toasterllc/MDCCode/Other/img-1600.jpg

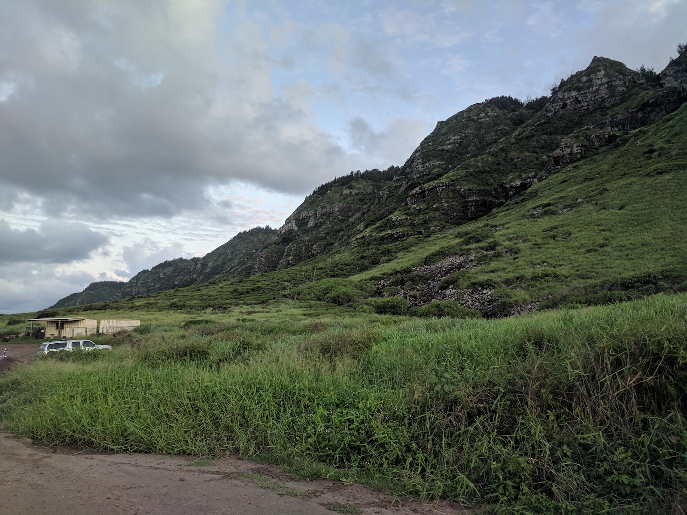
Other/img-1600.jpg
