toasterllc/MDCCode/Other/SDCardResearch/SDCard-LVSInitialization.png

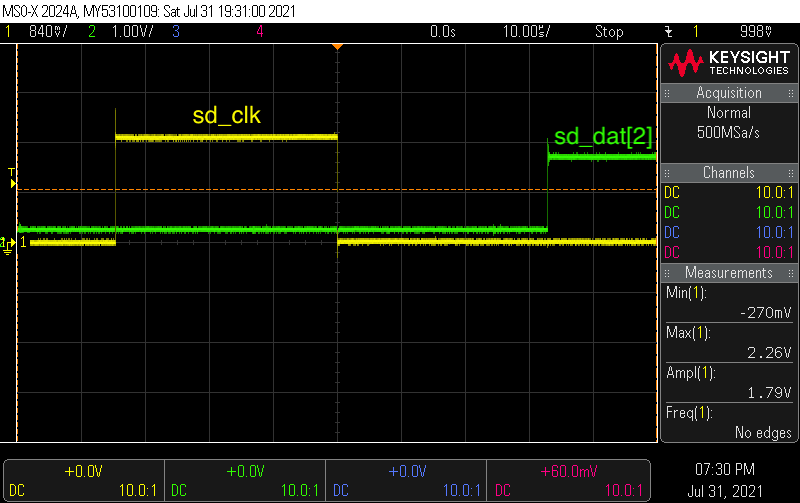
Other/SDCardResearch/SDCard-LVSInitialization.png
