toasterllc/MDCCode/Tools/MDCStudio/Resources/ImageGrid-ImagePlaceholder.png

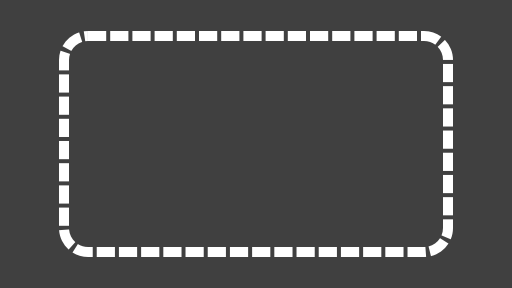
Tools/MDCStudio/Resources/ImageGrid-ImagePlaceholder.png
