toasterllc/MDCCode/Tools/MDCStudio/Resources/ShadowUnselected.png

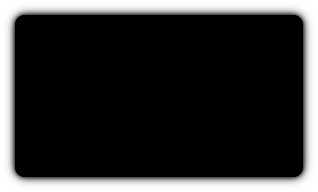
Tools/MDCStudio/Resources/ShadowUnselected.png
