toasterllc/MDCCode/(list of files, cad)

Other CAD files:
Enclosure/Enclosure.f3d
