toasterllc/MDCCode/Tools/Python/numpy/core/tests/data/umath-validation-set-arccos.csv

dtype | input | output | ulperrortol
np.float32 | 0xbddd7f50 | 0x3fd6eec2 | 3
np.float32 | 0xbe32a20c | 0x3fdf8182 | 3
np.float32 | 0xbf607c09 | 0x4028f84f | 3
np.float32 | 0x3f25d906 | 0x3f5db544 | 3
np.float32 | 0x3f01cec8 | 0x3f84febf | 3
np.float32 | 0x3f1d5c6e | 0x3f68a735 | 3
np.float32 | 0xbf0cab89 | 0x4009c36d | 3
np.float32 | 0xbf176b40 | 0x400d0941 | 3
np.float32 | 0x3f3248b2 | 0x3f4ce6d4 | 3
np.float32 | 0x3f390b48 | 0x3f434e0d | 3
np.float32 | 0xbe261698 | 0x3fddea43 | 3
np.float32 | 0x3f0e1154 | 0x3f7b848b | 3
np.float32 | 0xbf379a3c | 0x4017b764 | 3
np.float32 | 0xbeda6f2c | 0x4000bd62 | 3
np.float32 | 0xbf6a0c3f | 0x402e5d5a | 3
np.float32 | 0x3ef1d700 | 0x3f8a17b7 | 3
np.float32 | 0xbf6f4f65 | 0x4031d30d | 3
np.float32 | 0x3f2c9eee | 0x3f54adfd | 3
np.float32 | 0x3f3cfb18 | 0x3f3d8a1e | 3
np.float32 | 0x3ba80800 | 0x3fc867d2 | 3
np.float32 | 0x3e723b08 | 0x3faa7e4d | 3
np.float32 | 0xbf65820f | 0x402bb054 | 3
np.float32 | 0xbee64e7a | 0x40026410 | 3
np.float32 | 0x3cb15140 | 0x3fc64a87 | 3
np.float32 | 0x3f193660 | 0x3f6ddf2a | 3
np.float32 | 0xbf0e5b52 | 0x400a44f7 | 3
np.float32 | 0x3ed55f14 | 0x3f920a4b | 3
np.float32 | 0x3dd11a80 | 0x3fbbf85c | 3
np.float32 | 0xbf4f5c4b | 0x4020f4f9 | 3
np.float32 | 0x3f787532 | 0x3e792e87 | 3
np.float32 | 0x3f40e6ac | 0x3f37a74f | 3
np.float32 | 0x3f1c1318 | 0x3f6a47b6 | 3
np.float32 | 0xbe3c48d8 | 0x3fe0bb70 | 3
np.float32 | 0xbe94d4bc | 0x3feed08e | 3
np.float32 | 0xbe5c3688 | 0x3fe4ce26 | 3
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
np.float64 | 0x3fcea8a1b93d5140 | 0x3ff543456c0d28c7 | 2
np.float64 | 0xfff0000000000000 | 0x7ff8000000000000 | 2
np.float64 | 0xbfd9d5da72b3abb4 | 0x3fffc8013113f968 | 2
np.float64 | 0xbfe1fdfcea63fbfa | 0x400157def2e4808d | 2
np.float64 | 0xbfc0022e0720045c | 0x3ffb239963e7cbf2 | 2
