toasterllc/MDCCode/Tools/Python/numpy/core/tests/data/umath-validation-set-arccosh.csv

dtype | input | output | ulperrortol
np.float32 | 0x3f83203f | 0x3e61d9d6 | 2
np.float32 | 0x3f98dea1 | 0x3f1d1af6 | 2
np.float32 | 0x7fa00000 | 0x7fe00000 | 2
np.float32 | 0x7eba99af | 0x42b0d032 | 2
np.float32 | 0x3fc95a13 | 0x3f833650 | 2
np.float32 | 0x3fce9a45 | 0x3f8771e1 | 2
np.float32 | 0x3fc1bd96 | 0x3f797811 | 2
np.float32 | 0x7eba2391 | 0x42b0ceed | 2
np.float32 | 0x7d4e8f15 | 0x42acdb8c | 2
np.float32 | 0x3feca42e | 0x3f9cc88e | 2
np.float32 | 0x7e2b314e | 0x42af412e | 2
np.float32 | 0x7f7fffff | 0x42b2d4fc | 2
np.float32 | 0x3f803687 | 0x3d6c4380 | 2
np.float32 | 0x3fa0edbd | 0x3f33e706 | 2
np.float32 | 0x3faa8074 | 0x3f4b3d3c | 2
np.float32 | 0x3fa0c49e | 0x3f337af3 | 2
np.float32 | 0x3f8c9ec4 | 0x3ee18812 | 2
np.float32 | 0x7efef78e | 0x42b17006 | 2
np.float32 | 0x3fc75720 | 0x3f818aa4 | 2
np.float32 | 0x7f52d4c8 | 0x42b27198 | 2
np.float32 | 0x3f88f21e | 0x3ebe52b0 | 2
np.float32 | 0x3ff7a042 | 0x3fa3a07a | 2
np.float32 | 0x7f52115c | 0x42b26fbd | 2
np.float32 | 0x3fc6bf6f | 0x3f810b42 | 2
np.float32 | 0x3fd105d0 | 0x3f895649 | 2
np.float32 | 0x3fee7c2a | 0x3f9df66e | 2
np.float32 | 0x7f0ff9a5 | 0x42b1ae4f | 2
np.float32 | 0x7e81f075 | 0x42b016e7 | 2
np.float32 | 0x3fa57d65 | 0x3f3f70c6 | 2
np.float32 | 0x80800000 | 0xffc00000 | 2
np.float32 | 0x7da239f5 | 0x42adc2bf | 2
np.float32 | 0x3f9e432c | 0x3f2cbd80 | 2
np.float32 | 0x3ff2839b | 0x3fa07ee4 | 2
np.float32 | 0x3fec8aef | 0x3f9cb850 | 2
np.float32 | 0x7d325893 | 0x42ac905b | 2
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
np.float64 | 0x3ff2b1335c056267 | 0x3fe25000846b75a2 | 2
np.float64 | 0x7fe0cb8bd8e19717 | 0x40862ea65237d496 | 2
np.float64 | 0x3fff4b1b7b9e9637 | 0x3ff4a83fb08e7b24 | 2
np.float64 | 0x7fe7526140aea4c2 | 0x40863146ae86069c | 2
np.float64 | 0x7fbfcfb7c23f9f6f | 0x4086231fc246ede5 | 2
