toasterllc/MDCCode/Tools/Python/numpy/core/tests/data/umath-validation-set-arcsin.csv

dtype | input | output | ulperrortol
np.float32 | 0xbe7d3a7c | 0xbe7fe217 | 4
np.float32 | 0x3dc102f0 | 0x3dc14c60 | 4
np.float32 | 0xbe119c28 | 0xbe121aef | 4
np.float32 | 0xbe51cd68 | 0xbe534c75 | 4
np.float32 | 0x3c04a300 | 0x3c04a35f | 4
np.float32 | 0xbf4f0b62 | 0xbf712a69 | 4
np.float32 | 0x3ef61a5c | 0x3f005cf6 | 4
np.float32 | 0xbf13024c | 0xbf1c97df | 4
np.float32 | 0x3e93b580 | 0x3e95d6b5 | 4
np.float32 | 0x3e44e7b8 | 0x3e4623a5 | 4
np.float32 | 0xbe35df20 | 0xbe36d773 | 4
np.float32 | 0x3eecd2c0 | 0x3ef633cf | 4
np.float32 | 0x3f2772ba | 0x3f36862a | 4
np.float32 | 0x3e211ea8 | 0x3e21cac5 | 4
np.float32 | 0x3e3b3d90 | 0x3e3c4cc6 | 4
np.float32 | 0x3f37c962 | 0x3f4d018c | 4
np.float32 | 0x3e92ad88 | 0x3e94c31a | 4
np.float32 | 0x3f356ffc | 0x3f49a766 | 4
np.float32 | 0x3f487ba2 | 0x3f665254 | 4
np.float32 | 0x3f061c46 | 0x3f0d27ae | 4
np.float32 | 0xbee340a2 | 0xbeeb7722 | 4
np.float32 | 0xbe85aede | 0xbe874026 | 4
np.float32 | 0x3f34cf9a | 0x3f48c474 | 4
np.float32 | 0x3e29a690 | 0x3e2a6fbd | 4
np.float32 | 0xbeb29428 | 0xbeb669d1 | 4
np.float32 | 0xbe606d40 | 0xbe624370 | 4
np.float32 | 0x3dae6860 | 0x3dae9e85 | 4
np.float32 | 0xbf04872b | 0xbf0b4d25 | 4
np.float32 | 0x3f2080e2 | 0x3f2d7ab0 | 4
np.float32 | 0xbec77dcc | 0xbecceb27 | 4
np.float32 | 0x3e0dda10 | 0x3e0e4f38 | 4
np.float32 | 0xbefaf970 | 0xbf03262c | 4
np.float32 | 0x3f576a0c | 0x3f7ffee6 | 4
np.float32 | 0x3f222382 | 0x3f2f95d6 | 4
np.float32 | 0x7fc00000 | 0x7fc00000 | 4
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
np.float64 | 0x3fd0821b38a10438 | 0x3fd0b26e3e0b9185 | 3
np.float64 | 0x0 | 0x0 | 3
np.float64 | 0x3feb7f70edf6fee2 | 0x3ff08ae81854bf20 | 3
np.float64 | 0x3fe6e075716dc0ea | 0x3fe97cc5254be6ff | 3
np.float64 | 0x3fea13b682f4276e | 0x3fee7b6f18073b5b | 3
