toasterllc/MDCCode/Tools/Python/numpy/core/tests/data/umath-validation-set-arcsinh.csv

dtype | input | output | ulperrortol
np.float32 | 0xbf24142a | 0xbf1a85ef | 2
np.float32 | 0x3e71cf91 | 0x3e6f9e37 | 2
np.float32 | 0xe52a7 | 0xe52a7 | 2
np.float32 | 0x3ef1e074 | 0x3ee9add9 | 2
np.float32 | 0x806160ac | 0x806160ac | 2
np.float32 | 0x7e2d59a2 | 0x42af4798 | 2
np.float32 | 0xbf32cac9 | 0xbf26bf96 | 2
np.float32 | 0x3f081701 | 0x3f026142 | 2
np.float32 | 0x3f23cc88 | 0x3f1a499c | 2
np.float32 | 0xbf090d94 | 0xbf033ad0 | 2
np.float32 | 0x803af2fc | 0x803af2fc | 2
np.float32 | 0x807eb17e | 0x807eb17e | 2
np.float32 | 0x5c0d8e | 0x5c0d8e | 2
np.float32 | 0x3f7b79d2 | 0x3f5e6b1d | 2
np.float32 | 0x806feeae | 0x806feeae | 2
np.float32 | 0x3e4b423a | 0x3e49f274 | 2
np.float32 | 0x3f49e5ac | 0x3f394a41 | 2
np.float32 | 0x3f18cd4e | 0x3f10ef35 | 2
np.float32 | 0xbed75734 | 0xbed17322 | 2
np.float32 | 0x7f591151 | 0x42b28085 | 2
np.float32 | 0xfefe9da6 | 0xc2b16f51 | 2
np.float32 | 0xfeac90fc | 0xc2b0a82a | 2
np.float32 | 0x805c198e | 0x805c198e | 2
np.float32 | 0x7f66d6df | 0x42b2a004 | 2
np.float32 | 0x505438 | 0x505438 | 2
np.float32 | 0xbf39a209 | 0xbf2c5255 | 2
np.float32 | 0x7fa00000 | 0x7fe00000 | 2
np.float32 | 0xc84cb | 0xc84cb | 2
np.float32 | 0x7f07d6f5 | 0x42b19088 | 2
np.float32 | 0x79d7e4 | 0x79d7e4 | 2
np.float32 | 0xff32f6a0 | 0xc2b21db1 | 2
np.float32 | 0x7c005c05 | 0x42a9222e | 2
np.float32 | 0x3ec449aa | 0x3ebfc5ae | 2
np.float32 | 0x800ec323 | 0x800ec323 | 2
np.float32 | 0xff1c904c | 0xc2b1d93a | 2
np.float32 | 0x7f4eca52 | 0x42b267b0 | 2
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
np.float64 | 0x7fe13d2895e27a50 | 0x40862edbbc411899 | 2
np.float64 | 0x3fd54c4280aa9884 | 0x3fd4ec55a946c5d7 | 2
np.float64 | 0xffd75b8e01aeb71c | 0xc0862bbe42d76e5e | 2
np.float64 | 0x7f1d5376fe3ab | 0x7f1d5376fe3ab | 2
np.float64 | 0x3fe6ec6c902dd8d9 | 0x3fe55004f35192bd | 2
np.float64 | 0x5634504aac68b | 0x5634504aac68b | 2
np.float64 | 0x3feedb0d83bdb61b | 0x3feb633467467ce6 | 2
np.float64 | 0x3fddb1c0dcbb6380 | 0x3fdcb87a02daf1fa | 2
np.float64 | 0xbfa832da443065b0 | 0xbfa8308c70257209 | 2
np.float64 | 0x87a9836b0f531 | 0x87a9836b0f531 | 2
