toasterllc/MDCCode/Tools/Python/numpy/core/tests/data/umath-validation-set-arctan.csv

dtype | input | output | ulperrortol
np.float32 | 0x3f338252 | 0x3f1c8d9c | 3
np.float32 | 0x7e569df2 | 0x3fc90fdb | 3
np.float32 | 0xbf347e25 | 0xbf1d361f | 3
np.float32 | 0xbf0a654e | 0xbefdbfd2 | 3
np.float32 | 0x8070968e | 0x8070968e | 3
np.float32 | 0x803cfb27 | 0x803cfb27 | 3
np.float32 | 0x8024362e | 0x8024362e | 3
np.float32 | 0xfd55dca0 | 0xbfc90fdb | 3
np.float32 | 0x592b82 | 0x592b82 | 3
np.float32 | 0x802eb8e1 | 0x802eb8e1 | 3
np.float32 | 0xbc5fef40 | 0xbc5febae | 3
np.float32 | 0x3f1f6ce8 | 0x3f0e967c | 3
np.float32 | 0x20bedc | 0x20bedc | 3
np.float32 | 0xbf058860 | 0xbef629c7 | 3
np.float32 | 0x311504 | 0x311504 | 3
np.float32 | 0xbd23f560 | 0xbd23defa | 3
np.float32 | 0x800ff4e8 | 0x800ff4e8 | 3
np.float32 | 0x355009 | 0x355009 | 3
np.float32 | 0x3f7be42e | 0x3f46fdb3 | 3
np.float32 | 0xbf225f7c | 0xbf10b364 | 3
np.float32 | 0x8074fa9e | 0x8074fa9e | 3
np.float32 | 0xbea4b418 | 0xbe9f59ce | 3
np.float32 | 0xbe909c14 | 0xbe8cf045 | 3
np.float32 | 0x80026bee | 0x80026bee | 3
np.float32 | 0x3d789c20 | 0x3d784e25 | 3
np.float32 | 0x7f56a4ba | 0x3fc90fdb | 3
np.float32 | 0xbf70d141 | 0xbf413db7 | 3
np.float32 | 0xbf2c4886 | 0xbf17a505 | 3
np.float32 | 0x7e2993bf | 0x3fc90fdb | 3
np.float32 | 0xbe2c8a30 | 0xbe2aef28 | 3
np.float32 | 0x803f82d9 | 0x803f82d9 | 3
np.float32 | 0x3f062fbc | 0x3ef730a1 | 3
np.float32 | 0x3f349ee0 | 0x3f1d4bfa | 3
np.float32 | 0x3eccfb69 | 0x3ec2f9e8 | 3
np.float32 | 0x7e8a85dd | 0x3fc90fdb | 3
np.float32 | 0x25331 | 0x25331 | 3
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
np.float32 | 0xfee36132 | 0xbfc90fdb | 3
np.float32 | 0x619ae6 | 0x619ae6 | 3
np.float32 | 0xfde5d670 | 0xbfc90fdb | 3
np.float32 | 0xff079ac5 | 0xbfc90fdb | 3
np.float32 | 0x3e974fbd | 0x3e931fae | 3
np.float32 | 0x8020ae6b | 0x8020ae6b | 3
np.float32 | 0x6b5af1 | 0x6b5af1 | 3
np.float32 | 0xbeb57cd6 | 0xbeae69a3 | 3
np.float32 | 0x806e7eb2 | 0x806e7eb2 | 3
np.float32 | 0x7e666edb | 0x3fc90fdb | 3
np.float32 | 0xbf458c18 | 0xbf283ff0 | 3
np.float32 | 0x3e50518e | 0x3e4d8399 | 3
np.float32 | 0x3e9ce224 | 0x3e983b98 | 3
np.float32 | 0x3e6bc067 | 0x3e67b6c6 | 3
np.float32 | 0x13783d | 0x13783d | 3
np.float32 | 0xff3d518c | 0xbfc90fdb | 3
np.float32 | 0xfeba5968 | 0xbfc90fdb | 3
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
