toasterllc/MDCCode/Tools/ScrollViewTest/ScrollViewTest/ImageView-Shadow@2x.png

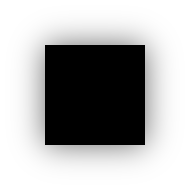
Tools/ScrollViewTest/ScrollViewTest/ImageView-Shadow@2x.png
