toasterllc/MDCCode/Sim/PowerMuxRails-LogicTest/Schematic.asc

C3: cap; 10µ
C4: cap; 10µ
C6: cap; 10µ
C8: cap; 10µ
R3: res; 1m
R4: res; 100
R10: res; 1m
R11: res; 1m
U1: SN74AHC1G32
U3: SN74LVC1G386
V_VDD_BAT: voltage; {VDD_BAT}; Cpar=1f
V_VDD_USB: voltage; PULSE(0 {VDD_USB} 100u 100u 100u 5000u)
V_VDDB_EN_: voltage; {VDDB_EN_}
Named nets: 0, VDD_USB, VDD_BAT, VDDB_EN_, NOBAT
.tran 0 10m
*.options plotwinsize=0 numdgt=15
.param VDD_BAT = 3
.param VDD_USB = 3
*.step param VDD_USB .1 5 .25
.param VDDB_EN_ = 0
