toasterllc/MDCCode/Sim/PowerMuxRails-New6/Schematic.asc

C1: cap; 10µ
C2: cap; 10µ
C3: cap; 10µ
C4: cap; 10µ
C5: cap; 10µ
C6: cap; 10µ
C7: cap; 10µ
D1: schottky; MBR0520L
Q1: pmos; FDS6375
Q2: pmos; FDS6375
Q3: pmos; FDS6375
Q10: pmos; FDS6375
R1: res; 100
R2: res; 1k
R3: res; 1m
R4: res; 10Meg
R5: res; 100k
R6: res; 1m
R7: res; 100k
R8: res; 1k
R10: res; 1m
R11: res; 1m
R19: res; 100
V_VDD_AUX: voltage; 2.5
V_VDD_BAT: voltage; 3; Cpar=1f
V_VDD_USB: voltage; 5
V_VDDB_EN_: voltage; 3
Named nets: 0, VDD_USB, VDD_1V8, VDD_BAT, VDD_SRC_USB, VDDB, VDDA, VDDB_EN_
.tran 0 10n 0 1p
*.param VDD_BAT = -3
*.param VDD_USB = 5
*.step param VDD_USB 2 3 .1
*.options plotwinsize=0 numdgt=15
Reverse polarity protection and
reverse current protection
VDD driver
VDD driver
TPS22916CN model is apparently incorrect when VIN < ~0.5
In this case, a large current can flow from VOUT -> VIN.
