toasterllc/MDCCode/PCB/MotionDetectorCamera.brd

## EAGLE design PCB/MotionDetectorCamera.brd (2022-09-28, last stored version)

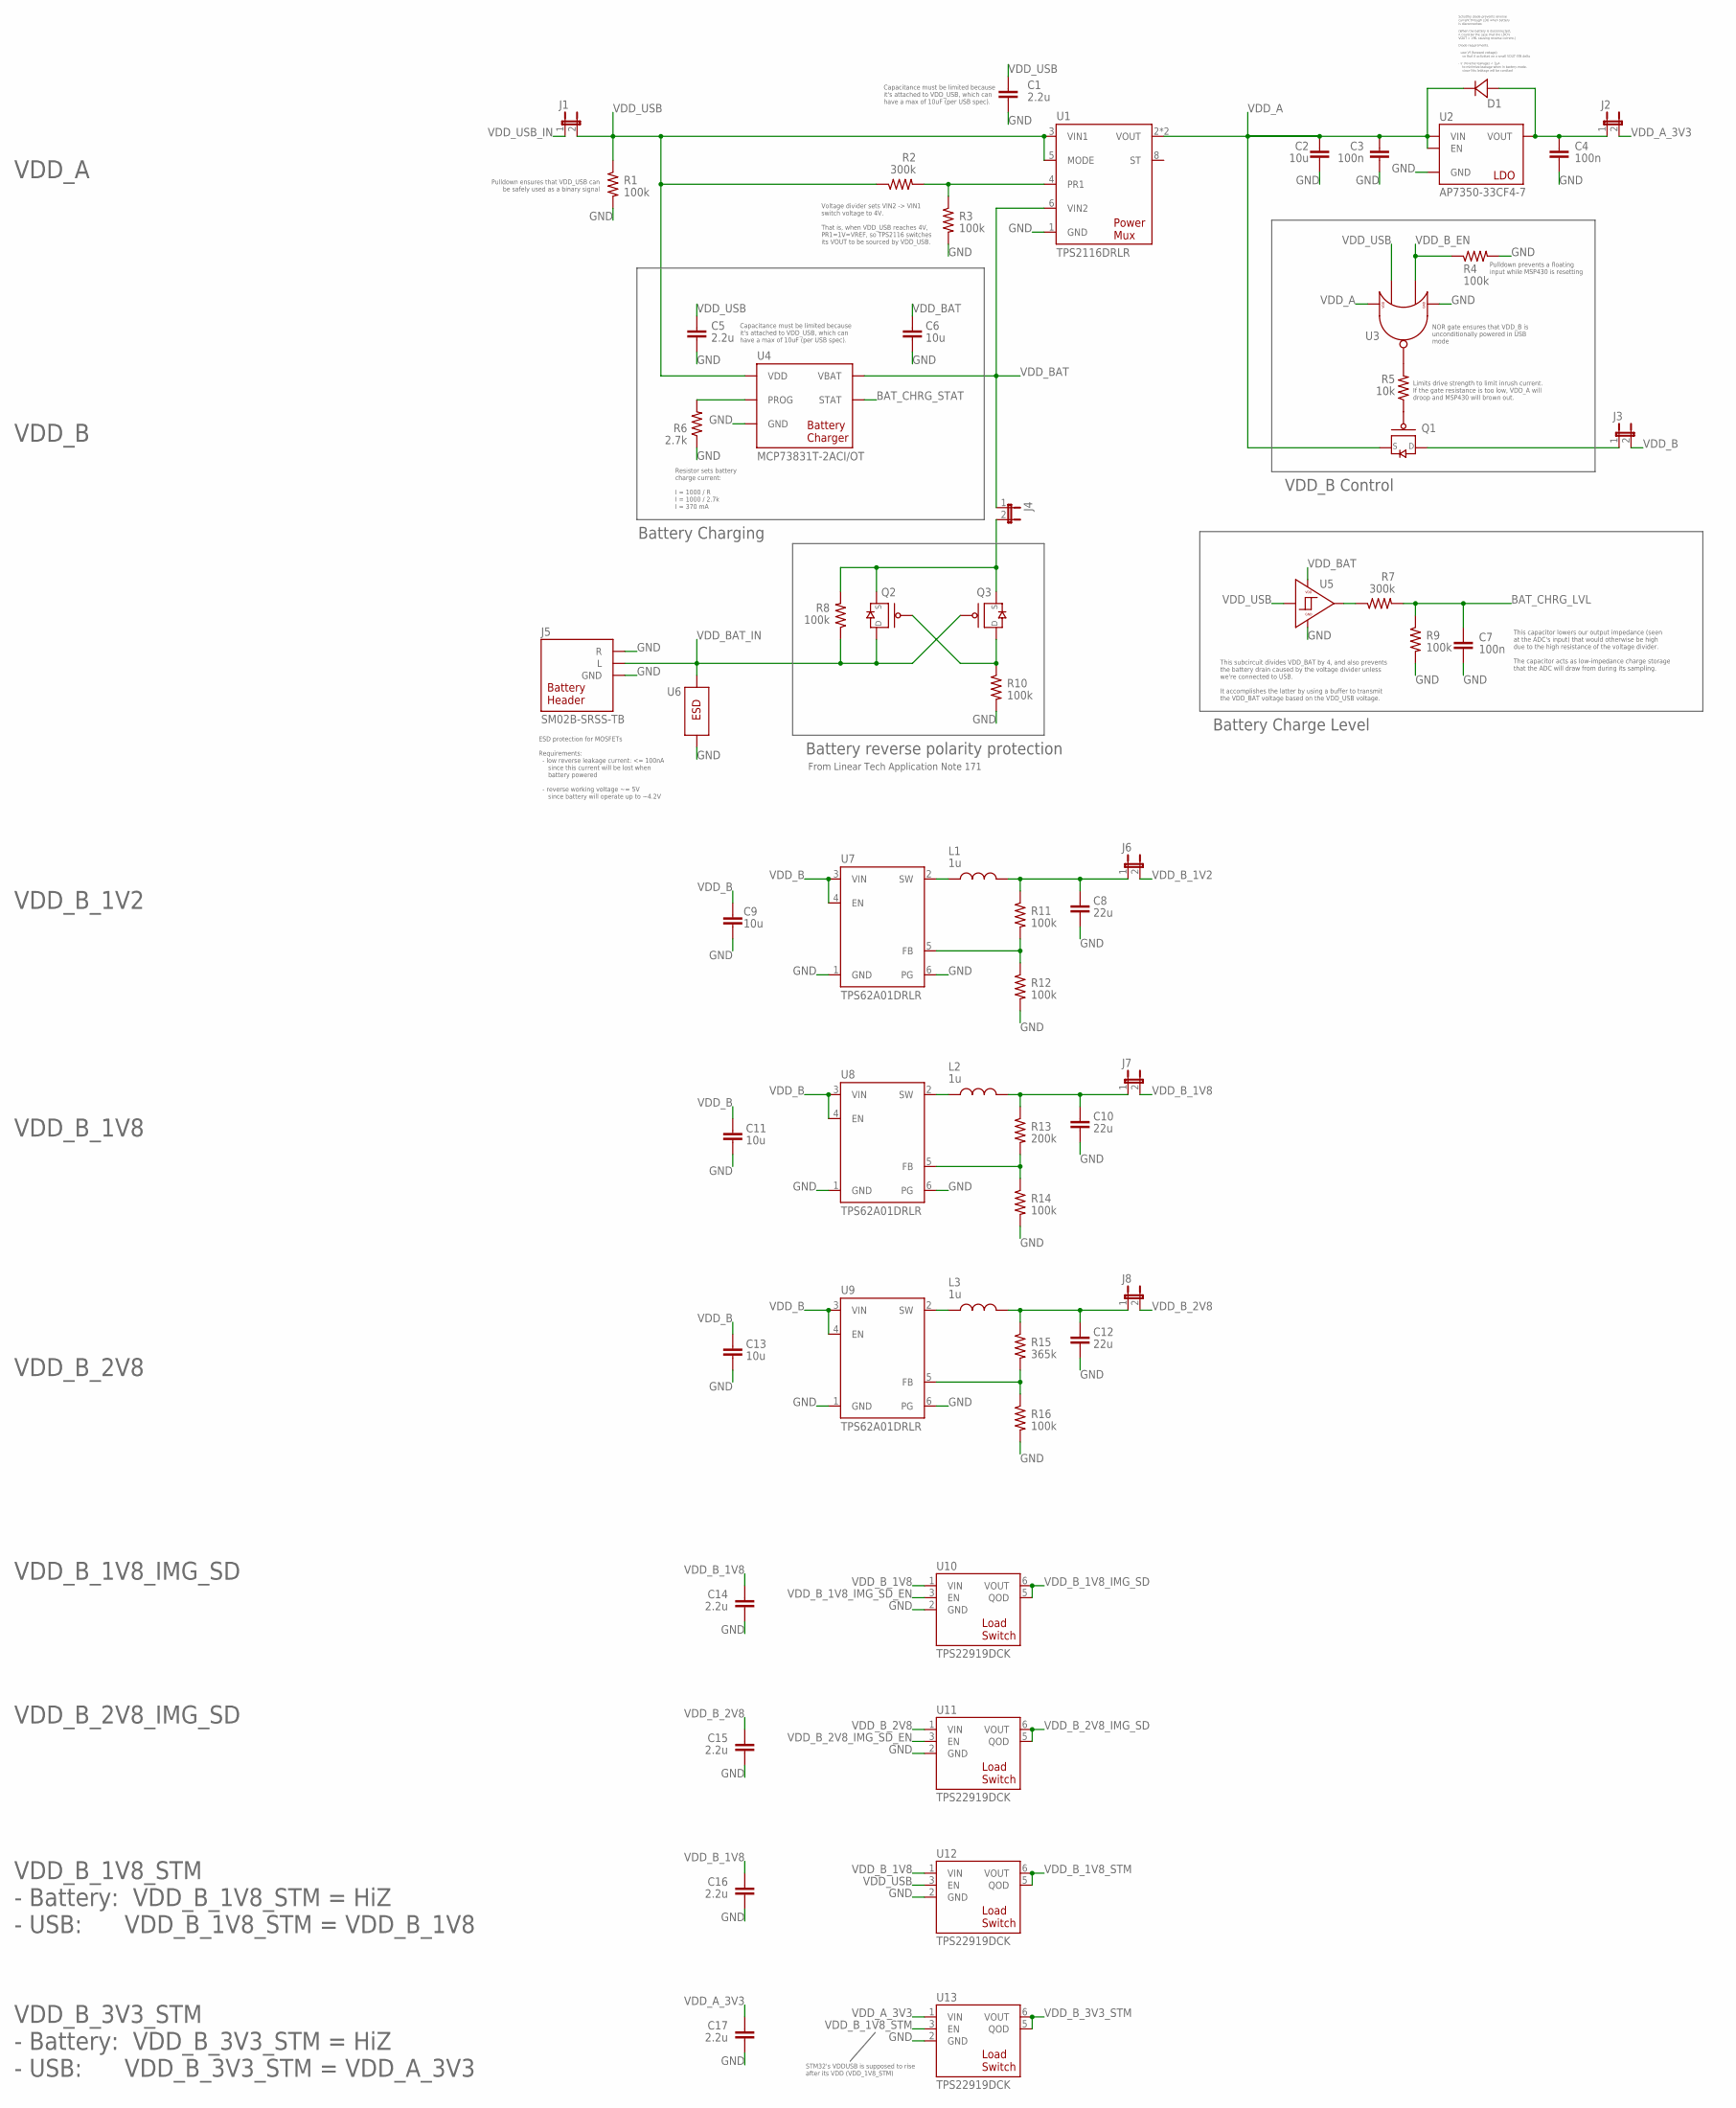
[picture p10: schematic MotionDetectorCamera.sch, sheet 1, VDD]

Parts:
C1, C5, C14, C15, C16, C17: 2.2u; 0402
C2, C6, C9, C11, C13: 10u; 0805
C3, C4, C7: 100n; 0402
C8, C10, C12: 22u; 0805
D1: ROHM-RB168MM-40; ROHM-SOD-123FL
J1, J2, J3, J4, J6, J7, J8: JUMPER-SOLDER
J5: JST-SM02B-SRSS-TB
L1, L2, L3: 1u; 0806
Q1, Q2, Q3: PMOS-NEXPERIA-SOT1220; NEXPERIA-SOT1220
R1, R3, R4, R8, R9, R10, R11, R12, R14, R16: 100k; 0402
R2, R7: 300k; 0402
R5: 10k; 0402
R6: 2.7k; 0402
R13: 200k; 0402
R15: 365k; 0402
U1: TI-TPS2116; TI-TPS2116DRLR
U2: DIODESINC-AP7350
U3: NEXPERIA-74LVC1G98-NOR; NEXPERIA-SOT363
U4: MICROCHIP-MCP7383X; MICROCHIP-MIC550X-SOT23-5
U5: NEXPERIA-74LVC1G98-BUFFER; NEXPERIA-SOT363
U6: EATON-STN101
U7, U8, U9: TI-TPS62A01; TI-TPS62A01DRLR
U10, U11, U12, U13: TI-TPS22919DCK

Connections:
BAT_CHRG_LVL: C7.1, R7.2, R9.1; also elsewhere on the board
BAT_CHRG_STAT: U4.1 (STAT); also elsewhere on the board
GND: C1.2, C2.2, C3.2, C4.2, C5.2, C6.2, C7.2, C8.2, C9.2, C10.2, C11.2, C12.2, C13.2, C14.2, C15.2, C16.2, C17.2, J5.GND1 (GND), J5.GND2 (GND), J5.R, R1.2, R3.2, R4.2, R6.1, R9.2, R10.2, R12.2, R14.2, R16.2, U1.1 (GND), U2.2 (GND), U3.2 (GND), U4.2 (GND), U5.2 (GND), U5.3 (GND), U6.2, U7.1 (GND), U7.6 (PG), U8.1 (GND), U8.6 (PG), U9.1 (GND), U9.6 (PG), U10.2 (GND), U11.2 (GND), U12.2 (GND), U13.2 (GND); also elsewhere on the board
unnamed: J4.2, Q2.4 (S), Q2.8 (S), Q3.4 (S), Q3.8 (S), R8.2
unnamed: C4.1, D1.1 (A), J2.1, U2.3 (VOUT)
unnamed: R7.1, U5.4 (OUT)
unnamed: Q1.3 (G), R5.1
unnamed: R5.2, U3.4 (OUT)
unnamed: C12.1, J8.1, L3.2, R15.1
unnamed: L2.1, U8.2 (SW)
unnamed: R13.2, R14.1, U8.5 (FB)
unnamed: C10.1, J7.1, L2.2, R13.1
unnamed: R6.2, U4.5 (PROG)
unnamed: L3.1, U9.2 (SW)
unnamed: L1.1, U7.2 (SW)
unnamed: Q2.3 (G), Q3.1 (D), Q3.2 (D), Q3.5 (D), Q3.6 (D), Q3.7 (D), R10.1
unnamed: R15.2, R16.1, U9.5 (FB)
unnamed: R11.2, R12.1, U7.5 (FB)
unnamed: C8.1, J6.1, L1.2, R11.1
unnamed: R2.2, R3.1, U1.4 (PR1)
unnamed: J3.1, Q1.1 (D), Q1.2 (D), Q1.5 (D), Q1.6 (D), Q1.7 (D)
VDD_A: C2.1, C3.1, D1.2 (C), Q1.4 (S), Q1.8 (S), U1.2 (VOUT), U1.7 (VOUT), U2.1 (EN), U2.4 (VIN), U3.3 (VDD), U3.5 (VDD)
VDD_A_3V3: C17.1, J2.2, U13.1 (VIN); also elsewhere on the board
VDD_B: C9.1, C11.1, C13.1, J3.2, U7.3 (VIN), U7.4 (EN), U8.3 (VIN), U8.4 (EN), U9.3 (VIN), U9.4 (EN)
VDD_BAT: C6.1, J4.1, U1.6 (VIN2), U4.3 (VBAT), U5.1 (VDD), U5.5 (VDD)
VDD_BAT_IN: J5.L, Q2.1 (D), Q2.2 (D), Q2.5 (D), Q2.6 (D), Q2.7 (D), Q3.3 (G), R8.1, U6.1
VDD_B_1V2: J6.2; also elsewhere on the board
VDD_B_1V8: C14.1, C16.1, J7.2, U10.1 (VIN), U12.1 (VIN); also elsewhere on the board
VDD_B_1V8_IMG_SD: U10.5 (QOD), U10.6 (VOUT); also elsewhere on the board
VDD_B_1V8_IMG_SD_EN: U10.3 (EN); also elsewhere on the board
VDD_B_1V8_STM: U12.5 (QOD), U12.6 (VOUT), U13.3 (EN); also elsewhere on the board
VDD_B_2V8: C15.1, J8.2, U11.1 (VIN); also elsewhere on the board
VDD_B_2V8_IMG_SD: U11.5 (QOD), U11.6 (VOUT); also elsewhere on the board
VDD_B_2V8_IMG_SD_EN: U11.3 (EN); also elsewhere on the board
VDD_B_3V3_STM: U13.5 (QOD), U13.6 (VOUT); also elsewhere on the board
VDD_B_EN: R4.1, U3.6 (IN2); also elsewhere on the board
VDD_USB: C1.1, C5.1, J1.2, R1.1, R2.1, U1.3 (VIN1), U1.5 (MODE), U3.1 (IN1), U4.4 (VDD), U5.6 (IN), U12.3 (EN)
VDD_USB_IN: J1.1; also elsewhere on the board

Notes on the sheet:
VDD_B_1V8_STM - Battery: VDD_B_1V8_STM = HiZ - USB: VDD_B_1V8_STM = VDD_B_1V8
VDD_A
VDD_B
VDD_B_1V2
VDD_B_1V8
VDD_B_2V8
VDD_B_1V8_IMG_SD
VDD_B_2V8_IMG_SD
VDD_B_3V3_STM - Battery: VDD_B_3V3_STM = HiZ - USB: VDD_B_3V3_STM = VDD_A_3V3
STM32's VDDUSB is supposed to rise after its VDD (VDD_1V8_STM)
NOR gate ensures that VDD_B is unconditionally powered in USB mode
VDD_B Control
Limits drive strength to limit inrush current. If the gate resistance is too low, VDD_A will droop and MSP430 will brown out.
From Linear Tech Application Note 171
Battery reverse polarity protection
Resistor sets battery charge current: I = 1000 / R I = 1000 / 2.7k I = 370 mA
Pulldown ensures that VDD_USB can be safely used as a binary signal
Schottky diode prevents reverse current through LDO when battery is disconnected. (When the battery is disconnected, it could be the case that the LDO's VOUT > VIN, causing reverse current.) Diode requirements: - Low Vf (forward voltage) so that it activates on a small VOUT-VIN delta - Ir (reverse 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
Voltage divider sets VIN2 -> VIN1 switch voltage to 4V. That is, when VDD_USB reaches 4V, PR1=1V=VREF, so TPS2116 switches its VOUT to be sourced by VDD_USB.
Capacitance must be limited because it's attached to VDD_USB, which can have a max of 10uF (per USB spec).
Battery Charge Level
Battery Charging
This subcircuit divides VDD_BAT by 4, and also prevents the battery drain caused by the voltage divider unless we're connected to USB. It accomplishes the latter by using a buffer to transmit the VDD_BAT voltage based on the VDD_USB voltage.
ESD protection for MOSFETs Requirements: - low reverse leakage current: <= 100nA since this current will be lost when battery powered - reverse working voltage ~= 5V since battery will operate up to ~4.2V
This capacitor lowers our output impedance (seen at the ADC's input) that would otherwise be high due to the high resistance of the voltage divider. The capacitor acts as low-impedance charge storage that the ADC will draw from during its sampling.
Pulldown prevents a floating input while MSP430 is resetting

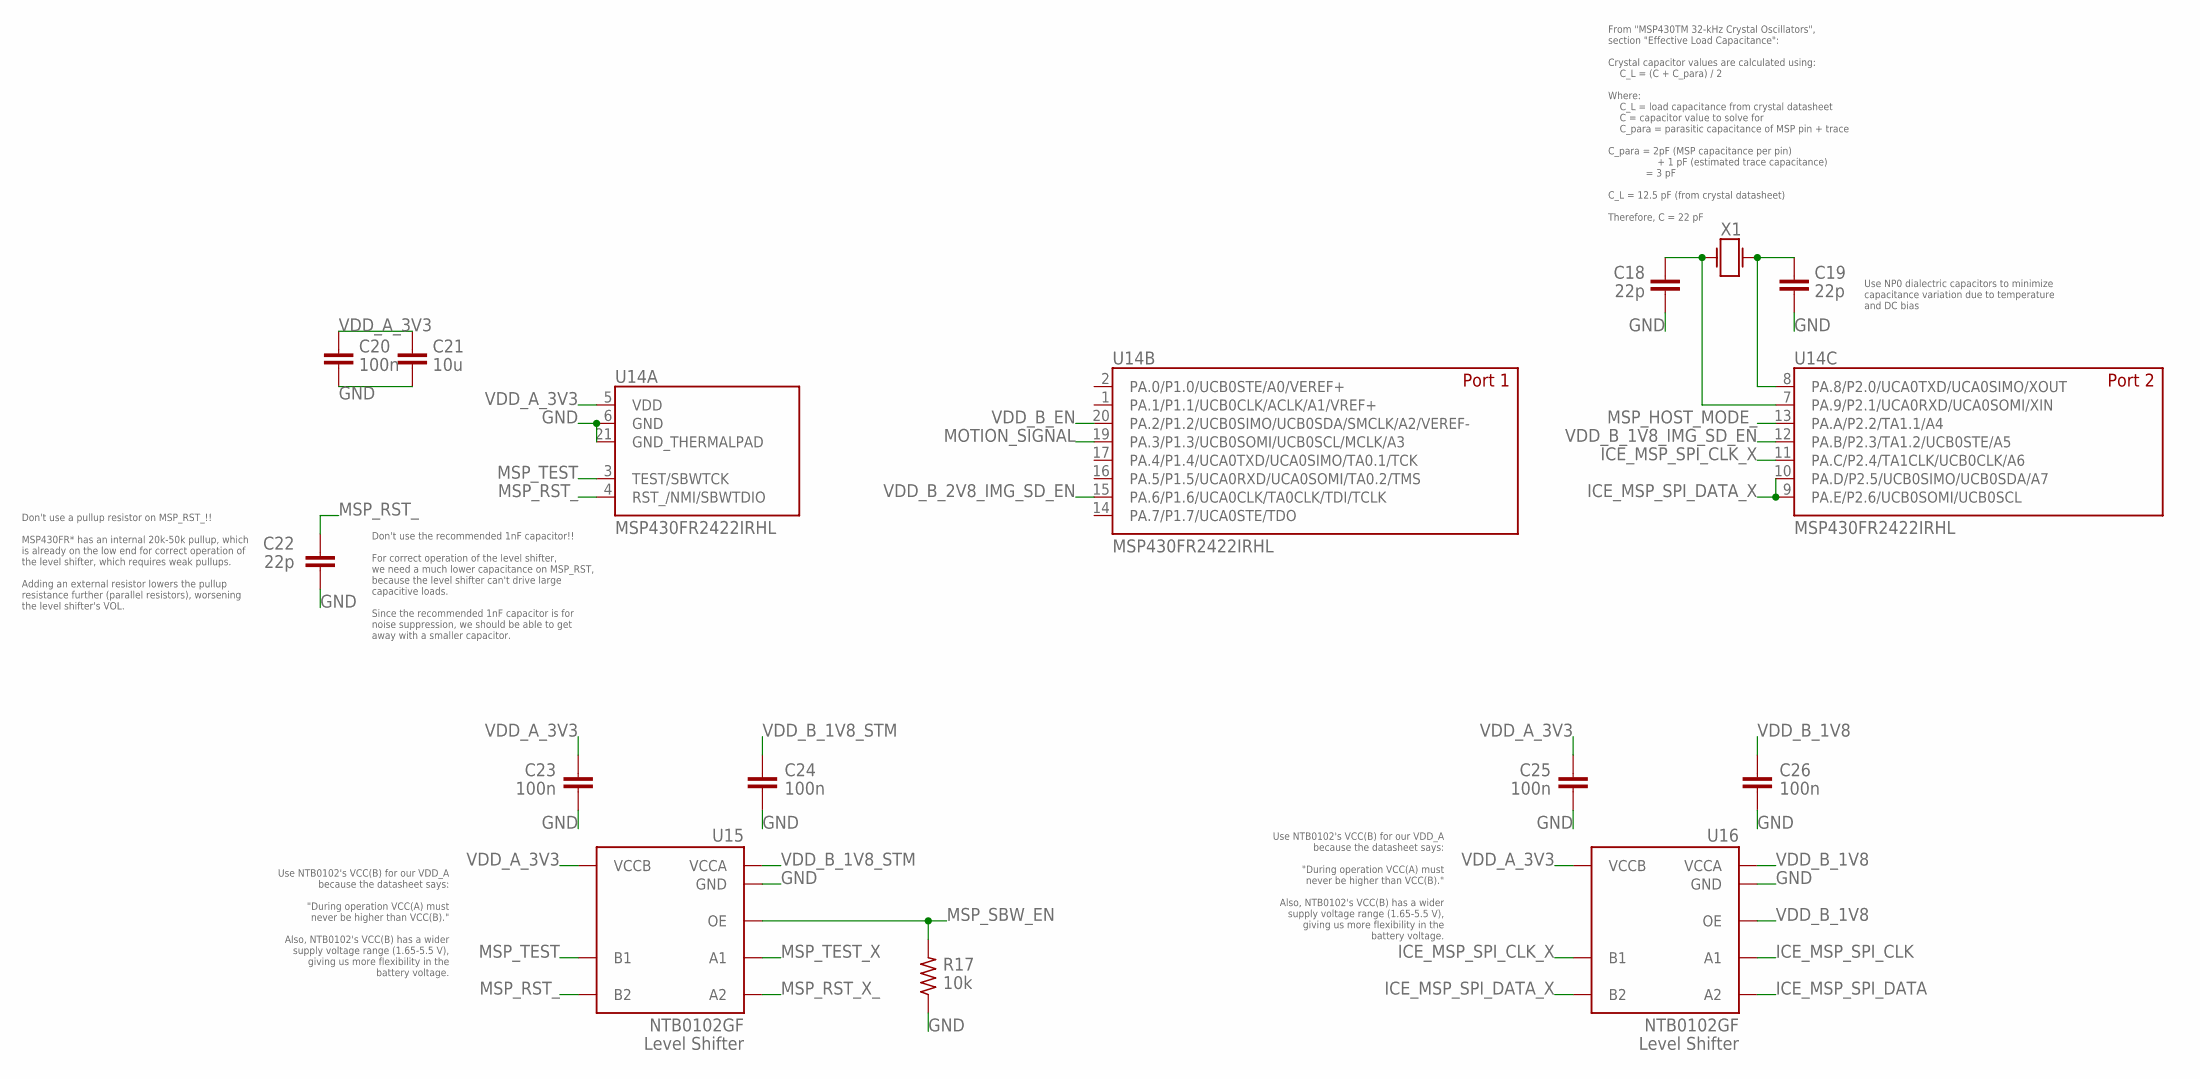
[picture p11: schematic MotionDetectorCamera.sch, sheet 2, MSP]

Parts:
C18, C19, C22: 22p; 0402
C20, C23, C24, C25, C26: 100n; 0402
C21: 10u; 0805
R17: 10k; 0402
U14: TI-MSP430FR2422IRHL
U15, U16: NXP-NTB0102; NXP-NTB0102GF
X1: EPSON-FC-135

Connections:
GND: C18.2, C19.2, C20.2, C21.2, C22.2, C23.2, C24.2, C25.2, C26.2, R17.1, U14.6 (GND), U14.21 (GND_THERMALPAD), U15.2 (GND), U16.2 (GND); also elsewhere on the board
ICE_MSP_SPI_CLK: U16.5 (A1); also elsewhere on the board
ICE_MSP_SPI_CLK_X: U14.11 (PA.C/P2.4/TA1CLK/UCB0CLK/A6), U16.8 (B1)
ICE_MSP_SPI_DATA: U16.4 (A2); also elsewhere on the board
ICE_MSP_SPI_DATA_X: U14.9 (PA.E/P2.6/UCB0SOMI/UCB0SCL), U14.10 (PA.D/P2.5/UCB0SIMO/UCB0SDA/A7), U16.1 (B2)
MOTION_SIGNAL: U14.19 (PA.3/P1.3/UCB0SOMI/UCB0SCL/MCLK/A3); also elsewhere on the board
MSP_HOST_MODE_: U14.13 (PA.A/P2.2/TA1.1/A4); also elsewhere on the board
MSP_RST_: C22.1, U14.4 (RST_/NMI/SBWTDIO), U15.1 (B2)
MSP_RST_X_: U15.4 (A2); also elsewhere on the board
MSP_SBW_EN: R17.2, U15.6 (OE); also elsewhere on the board
MSP_TEST: U14.3 (TEST/SBWTCK), U15.8 (B1)
MSP_TEST_X: U15.5 (A1); also elsewhere on the board
unnamed: C19.1, U14.8 (PA.8/P2.0/UCA0TXD/UCA0SIMO/XOUT), X1.2 (B)
unnamed: C18.1, U14.7 (PA.9/P2.1/UCA0RXD/UCA0SOMI/XIN), X1.1 (A)
VDD_A_3V3: C20.1, C21.1, C23.1, C25.1, U14.5 (VDD), U15.7 (VCCB), U16.7 (VCCB); also elsewhere on the board
VDD_B_1V8: C26.1, U16.3 (VCCA), U16.6 (OE); also elsewhere on the board
VDD_B_1V8_IMG_SD_EN: U14.12 (PA.B/P2.3/TA1.2/UCB0STE/A5); also elsewhere on the board
VDD_B_1V8_STM: C24.1, U15.3 (VCCA); also elsewhere on the board
VDD_B_2V8_IMG_SD_EN: U14.15 (PA.6/P1.6/UCA0CLK/TA0CLK/TDI/TCLK); also elsewhere on the board
VDD_B_EN: U14.20 (PA.2/P1.2/UCB0SIMO/UCB0SDA/SMCLK/A2/VER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); also elsewhere on the board

Notes on the sheet:
From "MSP430TM 32-kHz Crystal Oscillators", section "Effective Load Capacitance": Crystal capacitor values are calculated using: C_L = (C + C_para) / 2 Where: C_L = load capacitance from crystal datasheet C = capacitor value to solve for C_para = parasitic capacitance of MSP pin + trace C_para = 2p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
Use NP0 dialectric capacitors to minimize capacitance variation due to temperature and DC bias
Use NTB0102's VCC(B) for our VDD_A because the datasheet says: "During operation VCC(A) must never be higher than VCC(B)." Also, NTB0102's VCC(B) has a wider supply voltage range (1.65-5.5 V), giving us more flexibility in the battery voltage.
Don't use a pullup resistor on MSP_RST_!! MSP430FR* has an internal 20k-50k pullup, which is already on the low end for correct operation of the level shifter, which requires weak pullups. Adding an external resistor lowers the pullup resistance further (parallel resistors), worsening the level shi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
Don't use the recommended 1nF capacitor!! For correct operation of the level shifter, we need a much lower capacitance on MSP_RST, because the level shifter can't drive large capacitive loads. Since the recommended 1nF capacitor is for noise suppression, we should be able to get away with a smaller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

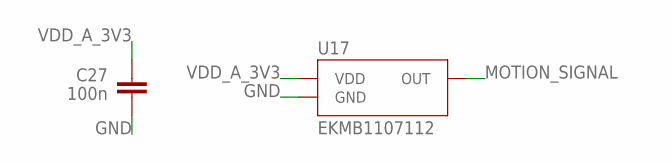
[picture p12: schematic MotionDetectorCamera.sch, sheet 3, MOTION]

Parts:
C27: 100n; 0402
U17: PANASONIC-EKMB110711X

Connections:
GND: C27.2, U17.3 (GND); also elsewhere on the board
MOTION_SIGNAL: U17.2 (OUT); also elsewhere on the board
VDD_A_3V3: C27.1, U17.1 (VDD); also elsewhere on the board

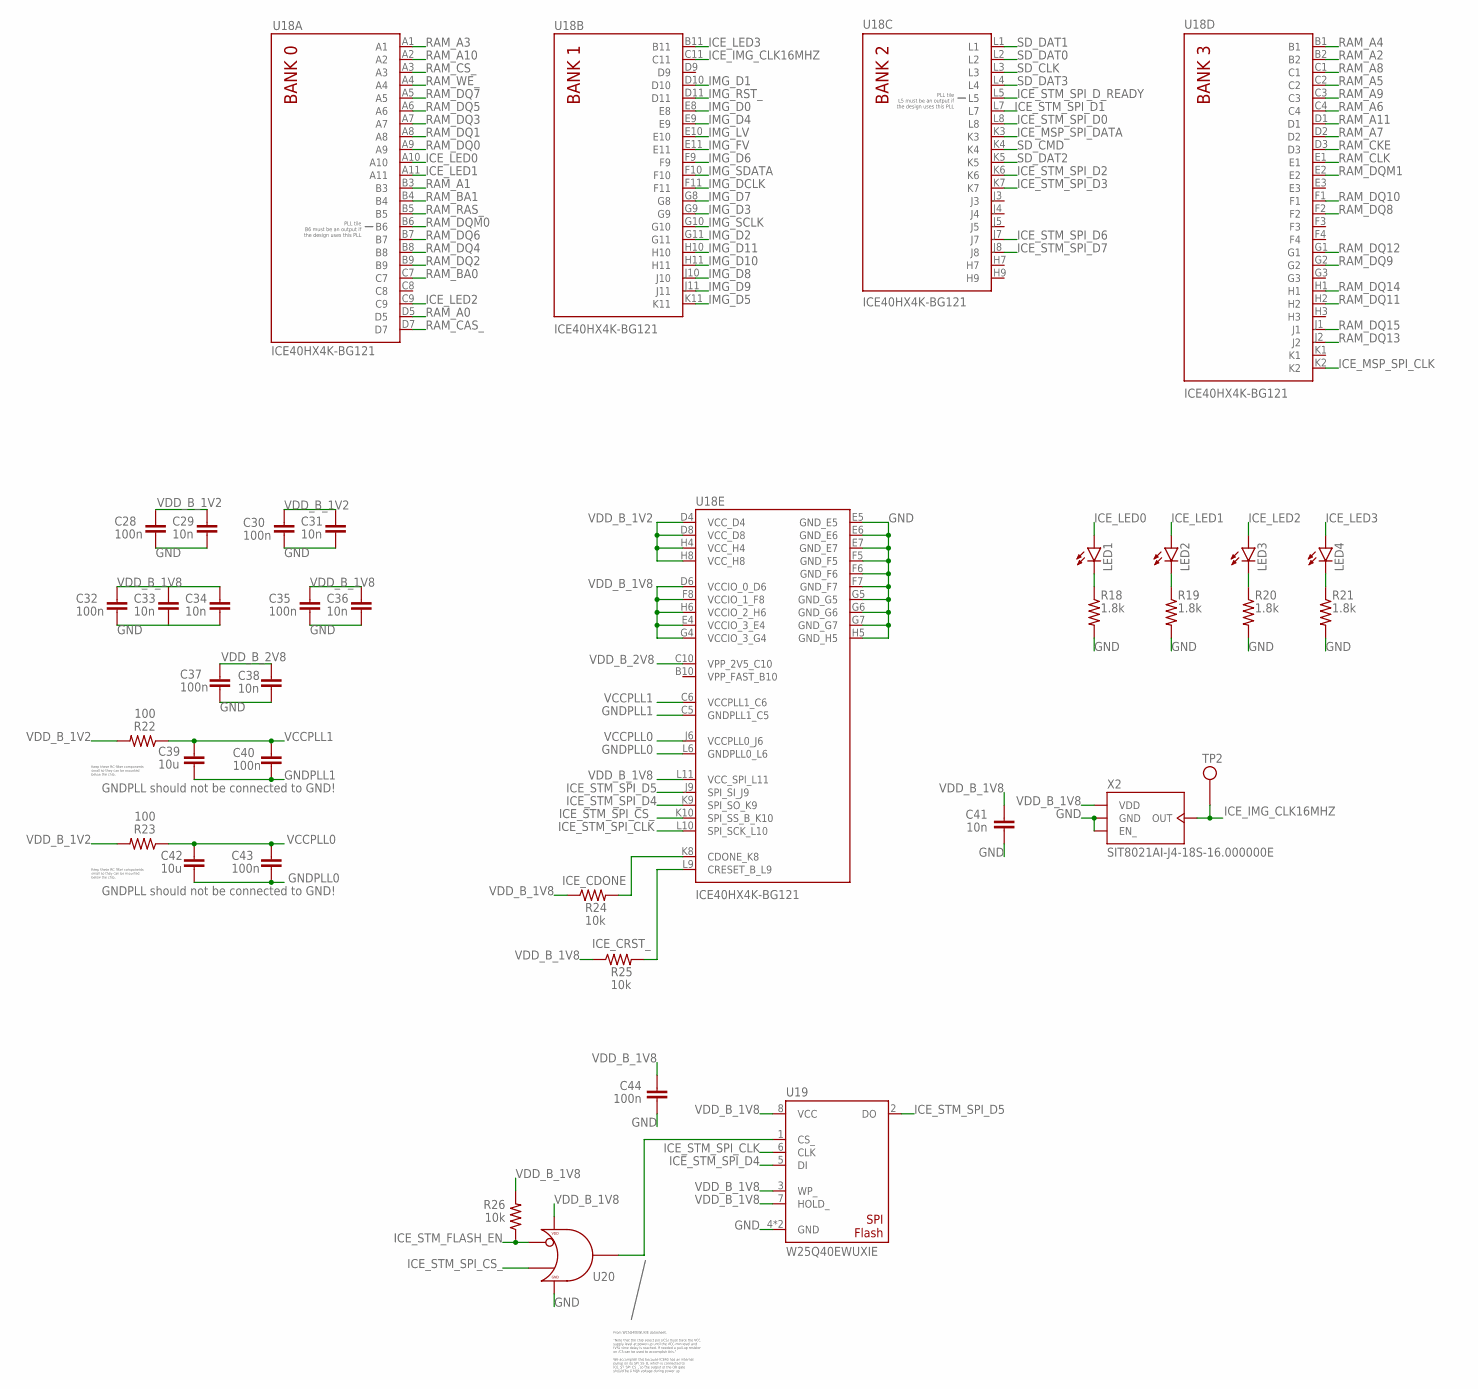
[picture p13: schematic MotionDetectorCamera.sch, sheet 4, ICE]

Parts:
C28, C30, C32, C35, C37, C40, C43, C44: 100n; 0402
C29, C31, C33, C34, C36, C38, C41: 10n; 0402
C39, C42: 10u; 0805
LED1, LED2, LED3, LED4: LED; LED-0603
R18, R19, R20, R21: 1.8k; 0402
R22, R23: 100; 0402
R24, R25, R26: 10k; 0402
TP2: TEST-POINT
U18: LATTICE-ICE40HX4K-BG121
U19: WINBOND-W25Q40EW; WINBOND-W25Q40EWUXIE
U20: NEXPERIA-74LVC1G98-OR-INV-INPUT; NEXPERIA-SOT363
X2: SITIME-SIT8021

Connections:
GND: C28.2, C29.2, C30.2, C31.2, C32.2, C33.2, C34.2, C35.2, C36.2, C37.2, C38.2, C41.2, C44.2, R18.2, R19.2, R20.2, R21.2, U18.E5 (GND_E5), U18.E6 (GND_E6), U18.E7 (GND_E7), U18.F5 (GND_F5), U18.F6 (GND_F6), U18.F7 (GND_F7), U18.G5 (GND_G5), U18.G6 (GND_G6), U18.G7 (GND_G7), U18.H5 (GND_H5), U19.4 (GND), U19.9 (GND), U20.2 (GND), U20.3 (GND), X2.1 (EN_), X2.4 (GND); also elsewhere on the board
GNDPLL0: C42.2, C43.2, U18.L6 (GNDPLL0_L6)
GNDPLL1: C39.2, C40.2, U18.C5 (GNDPLL1_C5)
ICE_CDONE: R24.2, U18.K8 (CDONE_K8); also elsewhere on the board
ICE_CRST_: R25.2, U18.L9 (CRESET_B_L9); also elsewhere on the board
ICE_IMG_CLK16MHZ: TP2.X, U18.C11, X2.2 (OUT); also elsewhere on the board
ICE_LED0: LED1.A, U18.A10
ICE_LED1: LED2.A, U18.A11
ICE_LED2: LED3.A, U18.C9
ICE_LED3: LED4.A, U18.B11
ICE_MSP_SPI_CLK: U18.K2; also elsewhere on the board
ICE_MSP_SPI_DATA: U18.K3; also elsewhere on the board
ICE_STM_FLASH_EN: R26.1, U20.1 (IN1); also elsewhere on the board
ICE_STM_SPI_CLK: U18.L10 (SPI_SCK_L10), U19.6 (CLK); also elsewhere on the board
ICE_STM_SPI_CS_: U18.K10 (SPI_SS_B_K10), U20.6 (IN2); also elsewhere on the board
ICE_STM_SPI_D0: U18.L8; also elsewhere on the board
ICE_STM_SPI_D1: U18.L7; also elsewhere on the board
ICE_STM_SPI_D2: U18.K6; also elsewhere on the board
ICE_STM_SPI_D3: U18.K7; also elsewhere on the board
ICE_STM_SPI_D4: U18.K9 (SPI_SO_K9), U19.5 (DI); also elsewhere on the board
ICE_STM_SPI_D5: U18.J9 (SPI_SI_J9), U19.2 (DO); also elsewhere on the board
ICE_STM_SPI_D6: U18.J7; also elsewhere on the board
ICE_STM_SPI_D7: U18.J8; also elsewhere on the board
ICE_STM_SPI_D_READY: U18.L5; also elsewhere on the board
IMG_D0: U18.E8; also elsewhere on the board
IMG_D1: U18.D10; also elsewhere on the board
IMG_D2: U18.G11; also elsewhere on the board
IMG_D3: U18.G9; also elsewhere on the board
IMG_D4: U18.E9; also elsewhere on the board
IMG_D5: U18.K11; also elsewhere on the board
IMG_D6: U18.F9; also elsewhere on the board
IMG_D7: U18.G8; also elsewhere on the board
IMG_D8: U18.J10; also elsewhere on the board
IMG_D9: U18.J11; also elsewhere on the board
IMG_D10: U18.H11; also elsewhere on the board
IMG_D11: U18.H10; also elsewhere on the board
IMG_DCLK: U18.F11; also elsewhere on the board
IMG_FV: U18.E11; also elsewhere on the board
IMG_LV: U18.E10; also elsewhere on the board
IMG_RST_: U18.D11; also elsewhere on the board
IMG_SCLK: U18.G10; also elsewhere on the board
IMG_SDATA: U18.F10; also elsewhere on the board
unnamed: LED1.C, R18.1
unnamed: LED3.C, R20.1
unnamed: LED2.C, R19.1
unnamed: LED4.C, R21.1
unnamed: U19.1 (CS_), U20.4 (OUT)
RAM_A0: U18.D5; also elsewhere on the board
RAM_A1: U18.B3; also elsewhere on the board
RAM_A2: U18.B2; also elsewhere on the board
RAM_A3: U18.A1; also elsewhere on the board
RAM_A4: U18.B1; also elsewhere on the board
RAM_A5: U18.C2; also elsewhere on the board
RAM_A6: U18.C4; also elsewhere on the board
RAM_A7: U18.D2; also elsewhere on the board
RAM_A8: U18.C1; also elsewhere on the board
RAM_A9: U18.C3; also elsewhere on the board
RAM_A10: U18.A2; also elsewhere on the board
RAM_A11: U18.D1; also elsewhere on the board
RAM_BA0: U18.C7; also elsewhere on the board
RAM_BA1: U18.B4; also elsewhere on the board
RAM_CAS_: U18.D7; also elsewhere on the board
RAM_CKE: U18.D3; also elsewhere on the board
RAM_CLK: U18.E1; also elsewhere on the board
RAM_CS_: U18.A3; also elsewhere on the board
RAM_DQ0: U18.A9; also elsewhere on the board
RAM_DQ1: U18.A8; also elsewhere on the board
RAM_DQ2: U18.B9; also elsewhere on the board
RAM_DQ3: U18.A7; also elsewhere on the board
RAM_DQ4: U18.B8; also elsewhere on the board
RAM_DQ5: U18.A6; also elsewhere on the board
RAM_DQ6: U18.B7; also elsewhere on the board
RAM_DQ7: U18.A5; also elsewhere on the board
RAM_DQ8: U18.F2; also elsewhere on the board
RAM_DQ9: U18.G2; also elsewhere on the board
RAM_DQ10: U18.F1; also elsewhere on the board
RAM_DQ11: U18.H2; also elsewhere on the board
RAM_DQ12: U18.G1; also elsewhere on the board
RAM_DQ13: U18.J2; also elsewhere on the board
RAM_DQ14: U18.H1; also elsewhere on the board
RAM_DQ15: U18.J1; also elsewhere on the board
RAM_DQM0: U18.B6; also elsewhere on the board
RAM_DQM1: U18.E2; also elsewhere on the board
RAM_RAS_: U18.B5; also elsewhere on the board
RAM_WE_: U18.A4; also elsewhere on the board
SD_CLK: U18.L3; also elsewhere on the board
SD_CMD: U18.K4; also elsewhere on the board
SD_DAT0: U18.L2; also elsewhere on the board
SD_DAT1: U18.L1; also elsewhere on the board
SD_DAT2: U18.K5; also elsewhere on the board
SD_DAT3: U18.L4; also elsewhere on the board
VCCPLL0: C42.1, C43.1, R23.1, U18.J6 (VCCPLL0_J6)
VCCPLL1: C39.1, C40.1, R22.1, U18.C6 (VCCPLL1_C6)
VDD_B_1V2: C28.1, C29.1, C30.1, C31.1, R22.2, R23.2, U18.D4 (VCC_D4), U18.D8 (VCC_D8), U18.H4 (VCC_H4), U18.H8 (VCC_H8); also elsewhere on the board
VDD_B_1V8: C32.1, C33.1, C34.1, C35.1, C36.1, C41.1, C44.1, R24.1, R25.1, R26.2, U18.D6 (VCCIO_0_D6), U18.E4 (VCCIO_3_E4), U18.F8 (VCCIO_1_F8), U18.G4 (VCCIO_3_G4), U18.H6 (VCCIO_2_H6), U18.L11 (VCC_SPI_L11), U19.3 (WP_), U19.7 (HOLD_), U19.8 (VCC), U20.5 (VDD), X2.3 (VDD); also elsewhere on the board
VDD_B_2V8: C37.1, C38.1, U18.C10 (VPP_2V5_C10); also elsewhere on the board

Notes on the sheet:
GNDPLL should not be connected to GND!
Keep these RC filter components small so they can be mounted below the chip.
From W25Q40EWUXIE datasheet: "Note that the chip select pin (/CS) must track the VCC supply level at power-up until the VCC-min level and tVSL time delay is reached. If needed a pull-up resister on /CS can be used to accomplish this." We accomplish this because ICE40 has an internal pullup on its S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

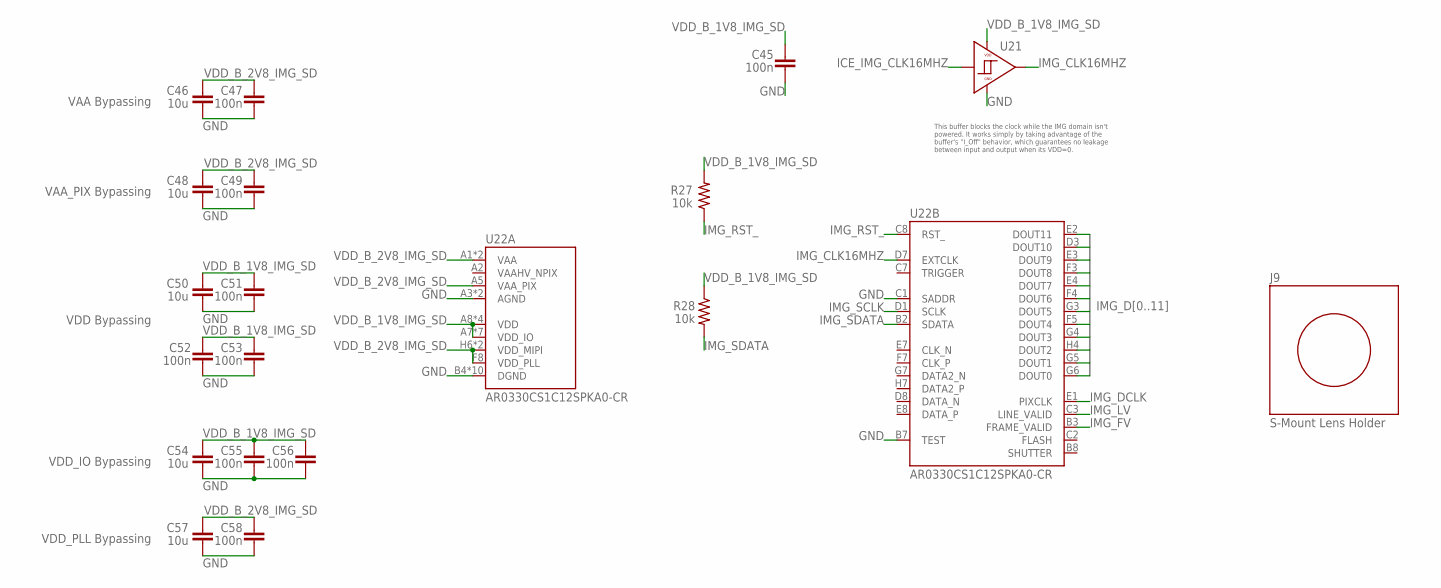
[picture p14: schematic MotionDetectorCamera.sch, sheet 5, IMG]

Parts:
C45, C47, C49, C51, C52, C53, C55, C56, C58: 100n; 0402
C46, C48, C50, C54, C57: 10u; 0805
J9: S-MOUNT-LENS-HOLDERM12LENSES-PT-LH008P; M12LENSES-PT-LH008P
R27, R28: 10k; 0402
U21: NEXPERIA-74LVC1G98-BUFFER; NEXPERIA-SOT363
U22: ON-AR0330CS1C12SPKA0

Connections:
GND: C45.2, C46.2, C47.2, C48.2, C49.2, C50.2, C51.2, C52.2, C53.2, C54.2, C55.2, C56.2, C57.2, C58.2, U21.2 (GND), U21.3 (GND), U22.A3 (AGND), U22.B4 (DGND), U22.B5 (AGND), U22.B6 (DGND), U22.B7 (TEST), U22.C1 (SADDR), U22.C4 (DGND), U22.C5 (DGND), U22.C6 (DGND), U22.D4 (DGND), U22.E6 (DGND), U22.G1 (DGND), U22.H2 (DGND), U22.H3 (DGND); also elsewhere on the board
ICE_IMG_CLK16MHZ: U21.6 (IN); also elsewhere on the board
IMG_CLK16MHZ: U21.4 (OUT), U22.D7 (EXTCLK)
IMG_D0: U22.G6 (DOUT0); also elsewhere on the board
IMG_D1: U22.G5 (DOUT1); also elsewhere on the board
IMG_D2: U22.H4 (DOUT2); also elsewhere on the board
IMG_D3: U22.G4 (DOUT3); also elsewhere on the board
IMG_D4: U22.F5 (DOUT4); also elsewhere on the board
IMG_D5: U22.G3 (DOUT5); also elsewhere on the board
IMG_D6: U22.F4 (DOUT6); also elsewhere on the board
IMG_D7: U22.E4 (DOUT7); also elsewhere on the board
IMG_D8: U22.F3 (DOUT8); also elsewhere on the board
IMG_D9: U22.E3 (DOUT9); also elsewhere on the board
IMG_D10: U22.D3 (DOUT10); also elsewhere on the board
IMG_D11: U22.E2 (DOUT11); also elsewhere on the board
IMG_DCLK: U22.E1 (PIXCLK); also elsewhere on the board
IMG_FV: U22.B3 (FRAME_VALID); also elsewhere on the board
IMG_LV: U22.C3 (LINE_VALID); also elsewhere on the board
IMG_RST_: R27.1, U22.C8 (RST_); also elsewhere on the board
IMG_SCLK: U22.D1 (SCLK); also elsewhere on the board
IMG_SDATA: R28.2, U22.B2 (SDATA); also elsewhere on the board
VDD_B_1V8_IMG_SD: C45.1, C50.1, C51.1, C52.1, C53.1, C54.1, C55.1, C56.1, R27.2, R28.1, U21.1 (VDD), U21.5 (VDD), U22.A7 (VDD_IO), U22.A8 (VDD), U22.B1 (VDD), U22.D2 (VDD_IO), U22.D5 (VDD_IO), U22.D6 (VDD_IO), U22.E5 (VDD_IO), U22.F6 (VDD_IO), U22.G2 (VDD), U22.G8 (VDD), U22.H5 (VDD_IO); also elsewhere on the board
VDD_B_2V8_IMG_SD: C46.1, C47.1, C48.1, C49.1, C57.1, C58.1, U22.A1 (VAA), U22.A5 (VAA_PIX), U22.A6 (VAA), U22.F8 (VDD_PLL), U22.H6 (VDD_MIPI), U22.H8 (VDD_MIPI); also elsewhere on the board

Notes on the sheet:
VAA Bypassing
VAA_PIX Bypassing
VDD Bypassing
VDD_IO Bypassing
VDD_PLL Bypassing
This buffer blocks the clock while the IMG domain isn't powered. It works simply by taking advantage of the buffer's "I_Off" behavior, which guarantees no leakage between input and output when its VDD=0.

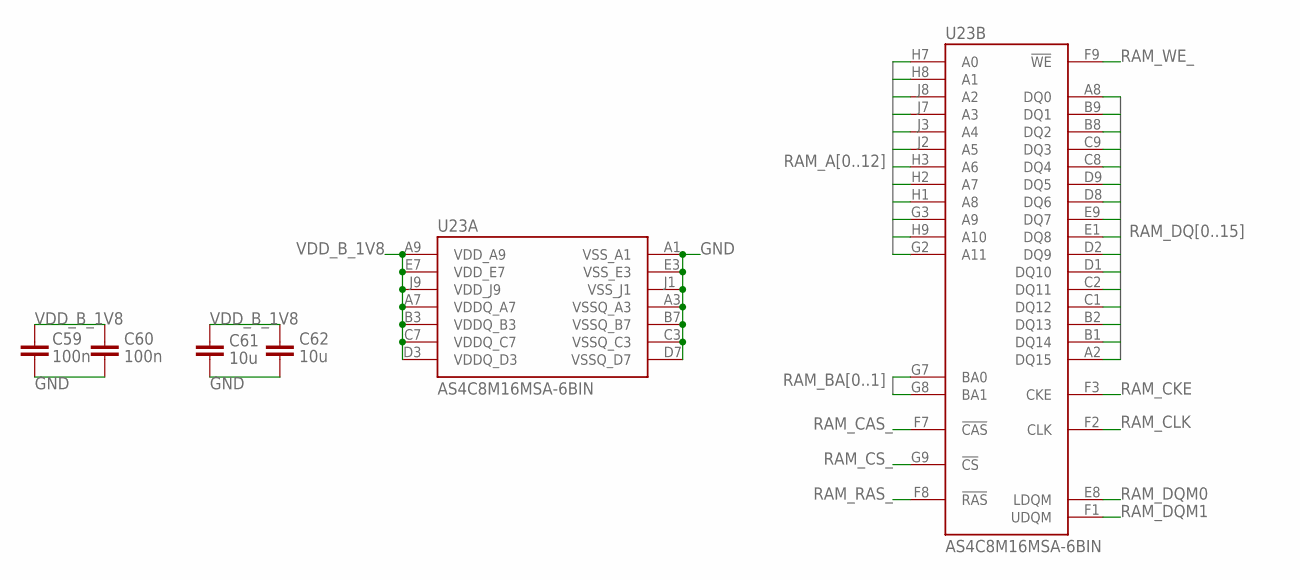
[picture p15: schematic MotionDetectorCamera.sch, sheet 6, RAM]

Parts:
C59, C60: 100n; 0402
C61, C62: 10u; 0805
U23: ALLIANCE-AS4C8M16MSA-6BIN

Connections:
GND: C59.2, C60.2, C61.2, C62.2, U23.A1 (VSS_A1), U23.A3 (VSSQ_A3), U23.B7 (VSSQ_B7), U23.C3 (VSSQ_C3), U23.D7 (VSSQ_D7), U23.E3 (VSS_E3), U23.J1 (VSS_J1); also elsewhere on the board
RAM_A0: U23.H7 (A0); also elsewhere on the board
RAM_A1: U23.H8 (A1); also elsewhere on the board
RAM_A2: U23.J8 (A2); also elsewhere on the board
RAM_A3: U23.J7 (A3); also elsewhere on the board
RAM_A4: U23.J3 (A4); also elsewhere on the board
RAM_A5: U23.J2 (A5); also elsewhere on the board
RAM_A6: U23.H3 (A6); also elsewhere on the board
RAM_A7: U23.H2 (A7); also elsewhere on the board
RAM_A8: U23.H1 (A8); also elsewhere on the board
RAM_A9: U23.G3 (A9); also elsewhere on the board
RAM_A10: U23.H9 (A10); also elsewhere on the board
RAM_A11: U23.G2 (A11); also elsewhere on the board
RAM_BA0: U23.G7 (BA0); also elsewhere on the board
RAM_BA1: U23.G8 (BA1); also elsewhere on the board
RAM_CAS_: U23.F7 (!CAS!); also elsewhere on the board
RAM_CKE: U23.F3 (CKE); also elsewhere on the board
RAM_CLK: U23.F2 (CLK); also elsewhere on the board
RAM_CS_: U23.G9 (!CS!); also elsewhere on the board
RAM_DQ0: U23.A8 (DQ0); also elsewhere on the board
RAM_DQ1: U23.B9 (DQ1); also elsewhere on the board
RAM_DQ2: U23.B8 (DQ2); also elsewhere on the board
RAM_DQ3: U23.C9 (DQ3); also elsewhere on the board
RAM_DQ4: U23.C8 (DQ4); also elsewhere on the board
RAM_DQ5: U23.D9 (DQ5); also elsewhere on the board
RAM_DQ6: U23.D8 (DQ6); also elsewhere on the board
RAM_DQ7: U23.E9 (DQ7); also elsewhere on the board
RAM_DQ8: U23.E1 (DQ8); also elsewhere on the board
RAM_DQ9: U23.D2 (DQ9); also elsewhere on the board
RAM_DQ10: U23.D1 (DQ10); also elsewhere on the board
RAM_DQ11: U23.C2 (DQ11); also elsewhere on the board
RAM_DQ12: U23.C1 (DQ12); also elsewhere on the board
RAM_DQ13: U23.B2 (DQ13); also elsewhere on the board
RAM_DQ14: U23.B1 (DQ14); also elsewhere on the board
RAM_DQ15: U23.A2 (DQ15); also elsewhere on the board
RAM_DQM0: U23.E8 (LDQM); also elsewhere on the board
RAM_DQM1: U23.F1 (UDQM); also elsewhere on the board
RAM_RAS_: U23.F8 (!RAS!); also elsewhere on the board
RAM_WE_: U23.F9 (!WE!); also elsewhere on the board
VDD_B_1V8: C59.1, C60.1, C61.1, C62.1, U23.A7 (VDDQ_A7), U23.A9 (VDD_A9), U23.B3 (VDDQ_B3), U23.C7 (VDDQ_C7), U23.D3 (VDDQ_D3), U23.E7 (VDD_E7), U23.J9 (VDD_J9); also elsewhere on the board

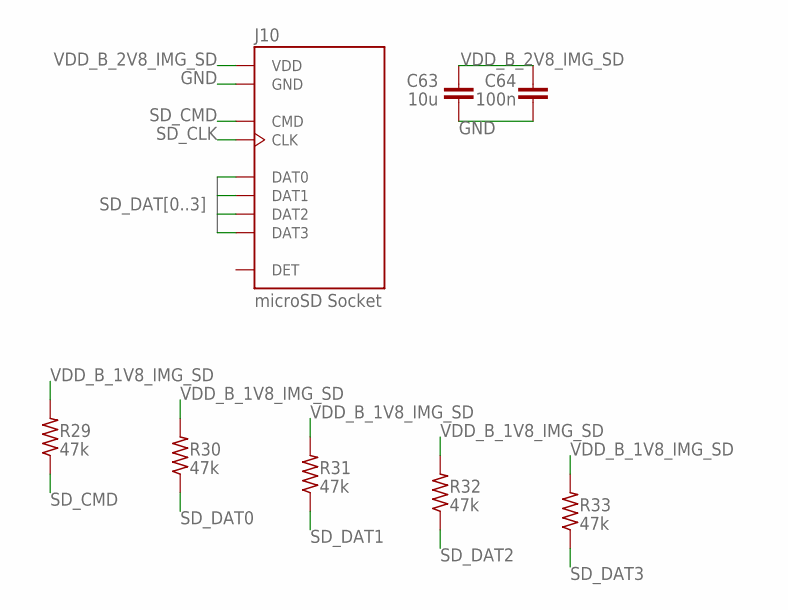
[picture p16: schematic MotionDetectorCamera.sch, sheet 7, SD]

Parts:
C63: 10u; 0805
C64: 100n; 0402
J10: MICROSD-SOCKET; MOLEX-1051620001
R29, R30, R31, R32, R33: 47k; 0402

Connections:
GND: C63.2, C64.2, J10.GND1 (GND), J10.GND2 (GND), J10.GND3 (GND), J10.GND4 (GND), J10.VSS (GND); also elsewhere on the board
SD_CLK: J10.CLK; also elsewhere on the board
SD_CMD: J10.CMD, R29.1; also elsewhere on the board
SD_DAT0: J10.DAT0, R30.1; also elsewhere on the board
SD_DAT1: J10.DAT1, R31.1; also elsewhere on the board
SD_DAT2: J10.DAT2, R32.1; also elsewhere on the board
SD_DAT3: J10.DAT3, R33.1; also elsewhere on the board
VDD_B_1V8_IMG_SD: R29.2, R30.2, R31.2, R32.2, R33.2; also elsewhere on the board
VDD_B_2V8_IMG_SD: C63.1, C64.1, J10.VDD; also elsewhere on the board
