toasterllc/MDCCode/PCB/MotionDetectorCamera.brd

## EAGLE design PCB/MotionDetectorCamera.brd (continued)

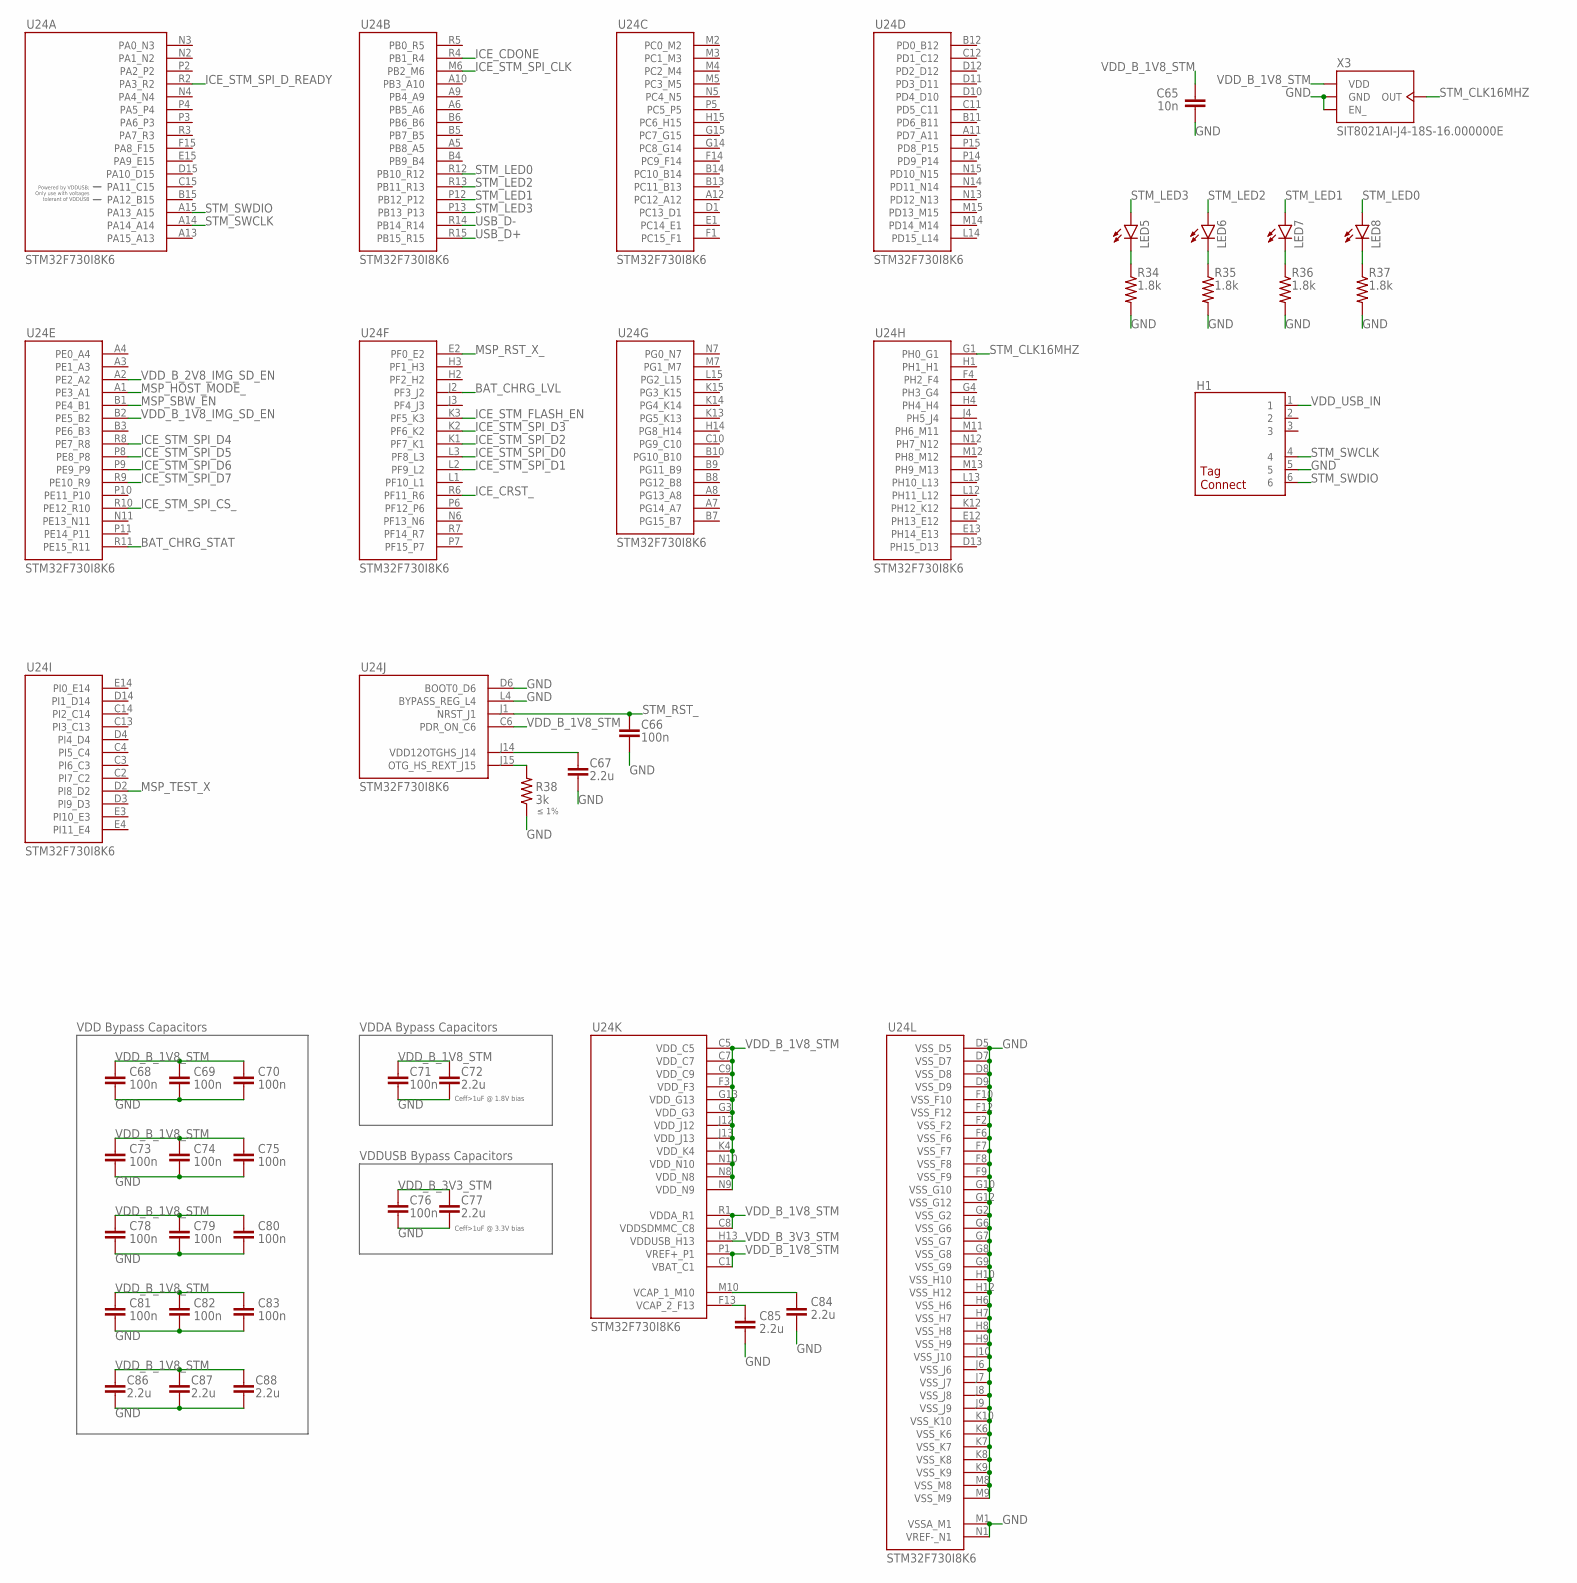
[picture p17: schematic MotionDetectorCamera.sch, sheet 8, STM]

Parts:
C65: 10n; 0402
C66, C68, C69, C70, C71, C73, C74, C75, C76, C78, C79, C80, C81, C82, C83: 100n; 0402
C67, C72, C77, C84, C85, C86, C87, C88: 2.2u; 0402
H1: TAGCONNECT-TC2030-NLEDGE; TAGCONNECT-TC2030-NL-EDGE
LED5, LED6, LED7, LED8: LED; LED-0603
R34, R35, R36, R37: 1.8k; 0402
R38: 3k; 0402
U24: STM-STM32F730; STM-STM32F730I8
X3: SITIME-SIT8021

Connections:
BAT_CHRG_LVL: U24.J2 (PF3_J2); also elsewhere on the board
BAT_CHRG_STAT: U24.R11 (PE15_R11); also elsewhere on the board
GND: C65.2, C66.2, C67.2, C68.2, C69.2, C70.2, C71.2, C72.2, C73.2, C74.2, C75.2, C76.2, C77.2, C78.2, C79.2, C80.2, C81.2, C82.2, C83.2, C84.2, C85.2, C86.2, C87.2, C88.2, H1.5, R34.2, R35.2, R36.2, R37.2, R38.1, U24.D5 (VSS_D5), U24.D6 (BOOT0_D6), U24.D7 (VSS_D7), U24.D8 (VSS_D8), U24.D9 (VSS_D9), U24.F2 (VSS_F2), U24.F6 (VSS_F6), U24.F7 (VSS_F7), U24.F8 (VSS_F8), U24.F9 (VSS_F9), U24.F10 (VSS_F10), U24.F12 (VSS_F12), U24.G2 (VSS_G2), U24.G6 (VSS_G6), U24.G7 (VSS_G7), U24.G8 (VSS_G8), U24.G9 (VSS_G9), U24.G10 (VSS_G10), U24.G12 (VSS_G12), U24.H6 (VSS_H6), U24.H7 (VSS_H7), U24.H8 (VSS_H8), U24.H9 (VSS_H9), U24.H10 (VSS_H10), U24.H12 (VSS_H12), U24.J6 (VSS_J6), U24.J7 (VSS_J7), U24.J8 (VSS_J8), U24.J9 (VSS_J9), U24.J10 (VSS_J10), U24.K6 (VSS_K6), U24.K7 (VSS_K7), U24.K8 (VSS_K8), U24.K9 (VSS_K9), U24.K10 (VSS_K10), U24.L4 (BYPASS_REG_L4), U24.M1 (VSSA_M1), U24.M8 (VSS_M8), U24.M9 (VSS_M9), U24.N1 (VREF-_N1), X3.1 (EN_), X3.4 (GND); also elsewhere on the board
ICE_CDONE: U24.R4 (PB1_R4); also elsewhere on the board
ICE_CRST_: U24.R6 (PF11_R6); also elsewhere on the board
ICE_STM_FLASH_EN: U24.K3 (PF5_K3); also elsewhere on the board
ICE_STM_SPI_CLK: U24.M6 (PB2_M6); also elsewhere on the board
ICE_STM_SPI_CS_: U24.R10 (PE12_R10); also elsewhere on the board
ICE_STM_SPI_D0: U24.L3 (PF8_L3); also elsewhere on the board
ICE_STM_SPI_D1: U24.L2 (PF9_L2); also elsewhere on the board
ICE_STM_SPI_D2: U24.K1 (PF7_K1); also elsewhere on the board
ICE_STM_SPI_D3: U24.K2 (PF6_K2); also elsewhere on the board
ICE_STM_SPI_D4: U24.R8 (PE7_R8); also elsewhere on the board
ICE_STM_SPI_D5: U24.P8 (PE8_P8); also elsewhere on the board
ICE_STM_SPI_D6: U24.P9 (PE9_P9); also elsewhere on the board
ICE_STM_SPI_D7: U24.R9 (PE10_R9); also elsewhere on the board
ICE_STM_SPI_D_READY: U24.R2 (PA3_R2); also elsewhere on the board
MSP_HOST_MODE_: U24.A1 (PE3_A1); also elsewhere on the board
MSP_RST_X_: U24.E2 (PF0_E2); also elsewhere on the board
MSP_SBW_EN: U24.B1 (PE4_B1); also elsewhere on the board
MSP_TEST_X: U24.D2 (PI8_D2); also elsewhere on the board
unnamed: C84.1, U24.M10 (VCAP_1_M10)
unnamed: C85.1, U24.F13 (VCAP_2_F13)
unnamed: R38.2, U24.J15 (OTG_HS_REXT_J15)
unnamed: C67.1, U24.J14 (VDD12OTGHS_J14)
unnamed: LED8.C, R37.1
unnamed: LED7.C, R36.1
unnamed: LED6.C, R35.1
unnamed: LED5.C, R34.1
STM_CLK16MHZ: U24.G1 (PH0_G1), X3.2 (OUT)
STM_LED0: LED8.A, U24.R12 (PB10_R12)
STM_LED1: LED7.A, U24.P12 (PB12_P12)
STM_LED2: LED6.A, U24.R13 (PB11_R13)
STM_LED3: LED5.A, U24.P13 (PB13_P13)
STM_RST_: C66.1, U24.J1 (NRST_J1)
STM_SWCLK: H1.4, U24.A14 (PA14_A14)
STM_SWDIO: H1.6, U24.A15 (PA13_A15)
USB_D+: U24.R15 (PB15_R15); also elsewhere on the board
USB_D-: U24.R14 (PB14_R14); also elsewhere on the board
VDD_B_1V8_IMG_SD_EN: U24.B2 (PE5_B2); also elsewhere on the board
VDD_B_1V8_STM: C65.1, C68.1, C69.1, C70.1, C71.1, C72.1, C73.1, C74.1, C75.1, C78.1, C79.1, C80.1, C81.1, C82.1, C83.1, C86.1, C87.1, C88.1, U24.C1 (VBAT_C1), U24.C5 (VDD_C5), U24.C6 (PDR_ON_C6), U24.C7 (VDD_C7), U24.C8 (VDDSDMMC_C8), U24.C9 (VDD_C9), U24.F3 (VDD_F3), U24.G3 (VDD_G3), U24.G13 (VDD_G13), U24.J12 (VDD_J12), U24.J13 (VDD_J13), U24.K4 (VDD_K4), U24.N8 (VDD_N8), U24.N9 (VDD_N9), U24.N10 (VDD_N10), U24.P1 (VREF+_P1), U24.R1 (VDDA_R1), X3.3 (VDD); also elsewhere on the board
VDD_B_2V8_IMG_SD_EN: U24.A2 (PE2_A2); also elsewhere on the board
VDD_B_3V3_STM: C76.1, C77.1, U24.H13 (VDDUSB_H13); also elsewhere on the board
VDD_USB_IN: H1.1; also elsewhere on the board

Notes on the sheet:
VDD Bypass Capacitors
VDDA Bypass Capacitors
VDDUSB Bypass Capacitors
≤ 1%
Ceff>1uF @ 3.3V bias
Ceff>1uF @ 1.8V bias

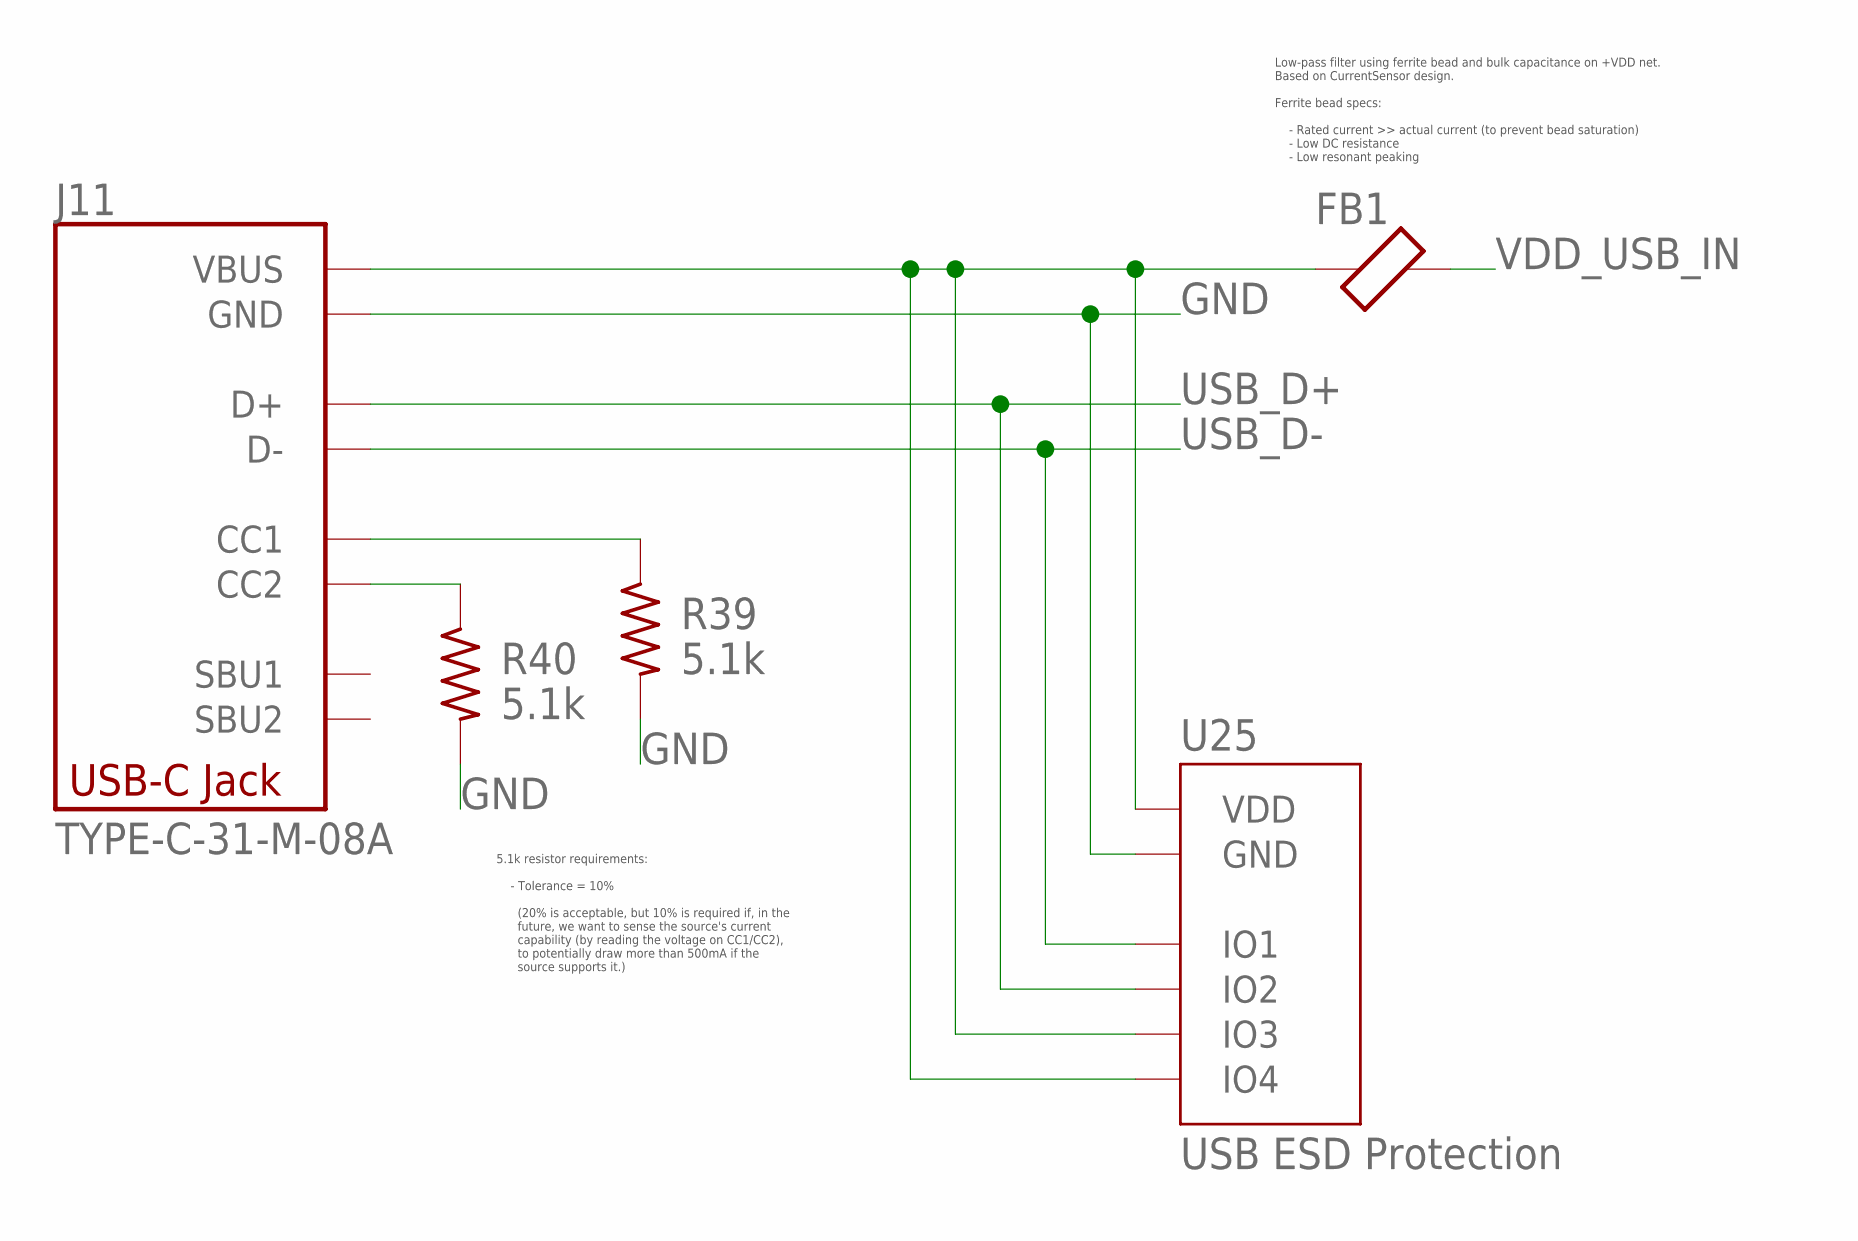
[picture p18: schematic MotionDetectorCamera.sch, sheet 9, USB]

Parts:
FB1: FERRITE-BEAD0402; 0402
J11: USB-C-RECEPTACLE-KOREANHRO; KOREANHRO-TYPE-C-31-M-08A
R39, R40: 5.1k; 0402
U25: DIODESINC-DT1446-04V-7

Connections:
GND: J11.A1 (GND), J11.A12 (GND), J11.B1 (GND), J11.B12 (GND), J11.GND1 (GND), J11.GND2 (GND), J11.GND3 (GND), J11.GND4 (GND), J11.GND5 (GND), J11.GND6 (GND), J11.GND7 (GND), J11.GND8 (GND), R39.2, R40.2, U25.2 (GND); also elsewhere on the board
unnamed: J11.A5 (CC1), R39.1
unnamed: J11.B5 (CC2), R40.1
unnamed: FB1.1, J11.A4 (VBUS), J11.A9 (VBUS), J11.B4 (VBUS), J11.B9 (VBUS), U25.4 (IO3), U25.5 (VDD), U25.6 (IO4)
USB_D+: J11.A6 (D+), J11.B6 (D+), U25.3 (IO2); also elsewhere on the board
USB_D-: J11.A7 (D-), J11.B7 (D-), U25.1 (IO1); also elsewhere on the board
VDD_USB_IN: FB1.2; also elsewhere on the board

Notes on the sheet:
Low-pass filter using ferrite bead and bulk capacitance on +VDD net. Based on CurrentSensor design. Ferrite bead specs: - Rated current >> actual current (to prevent bead saturation) - Low DC resistance - Low resonant peaking
5.1k resistor requirements: - Tolerance = 10% (20% is acceptable, but 10% is required if, in the future, we want to sense the source's current capability (by reading the voltage on CC1/CC2), to potentially draw more than 500mA if the source supports it.)

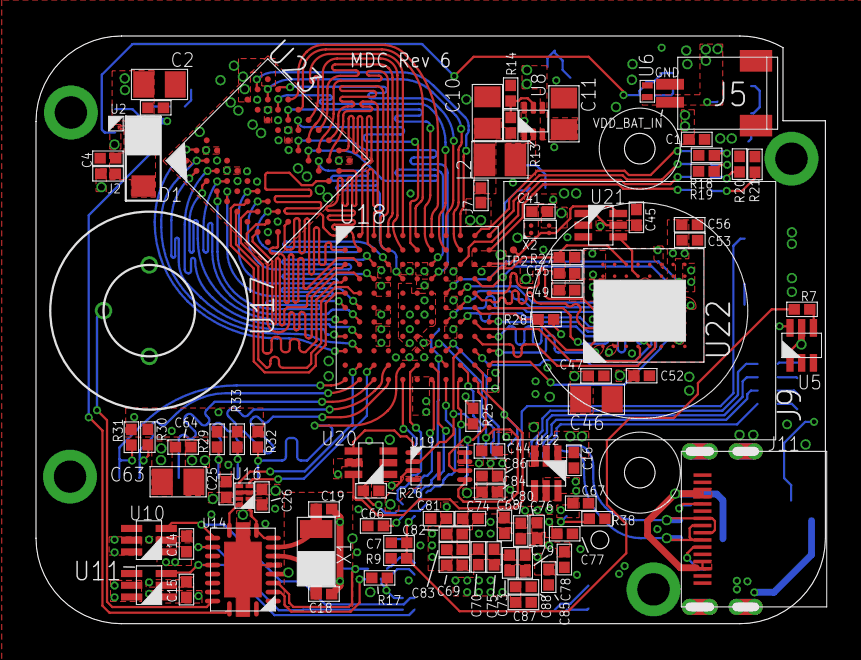
[picture p19: board PCB/MotionDetectorCamera.brd from above]

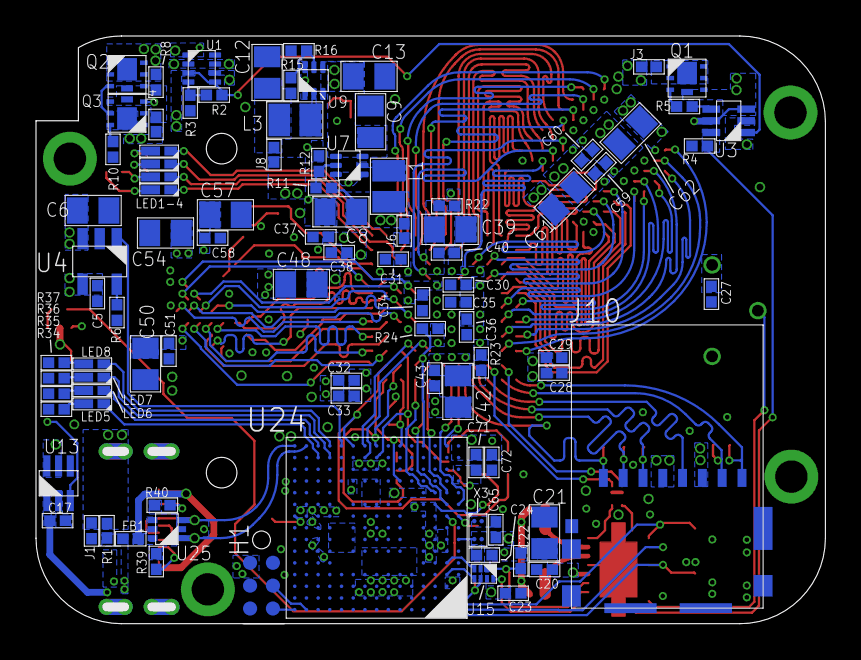
[picture p20: board PCB/MotionDetectorCamera.brd from below]

Board: 4 copper layers, 43.9 x 32.6 mm, 185 parts (93 on the bottom side), 163 nets.
