toasterllc/MDCCode/PCB/MotionDetectorCamera-Rev4.brd

## EAGLE design PCB/MotionDetectorCamera-Rev4.brd (2021-06-25, an earlier design)

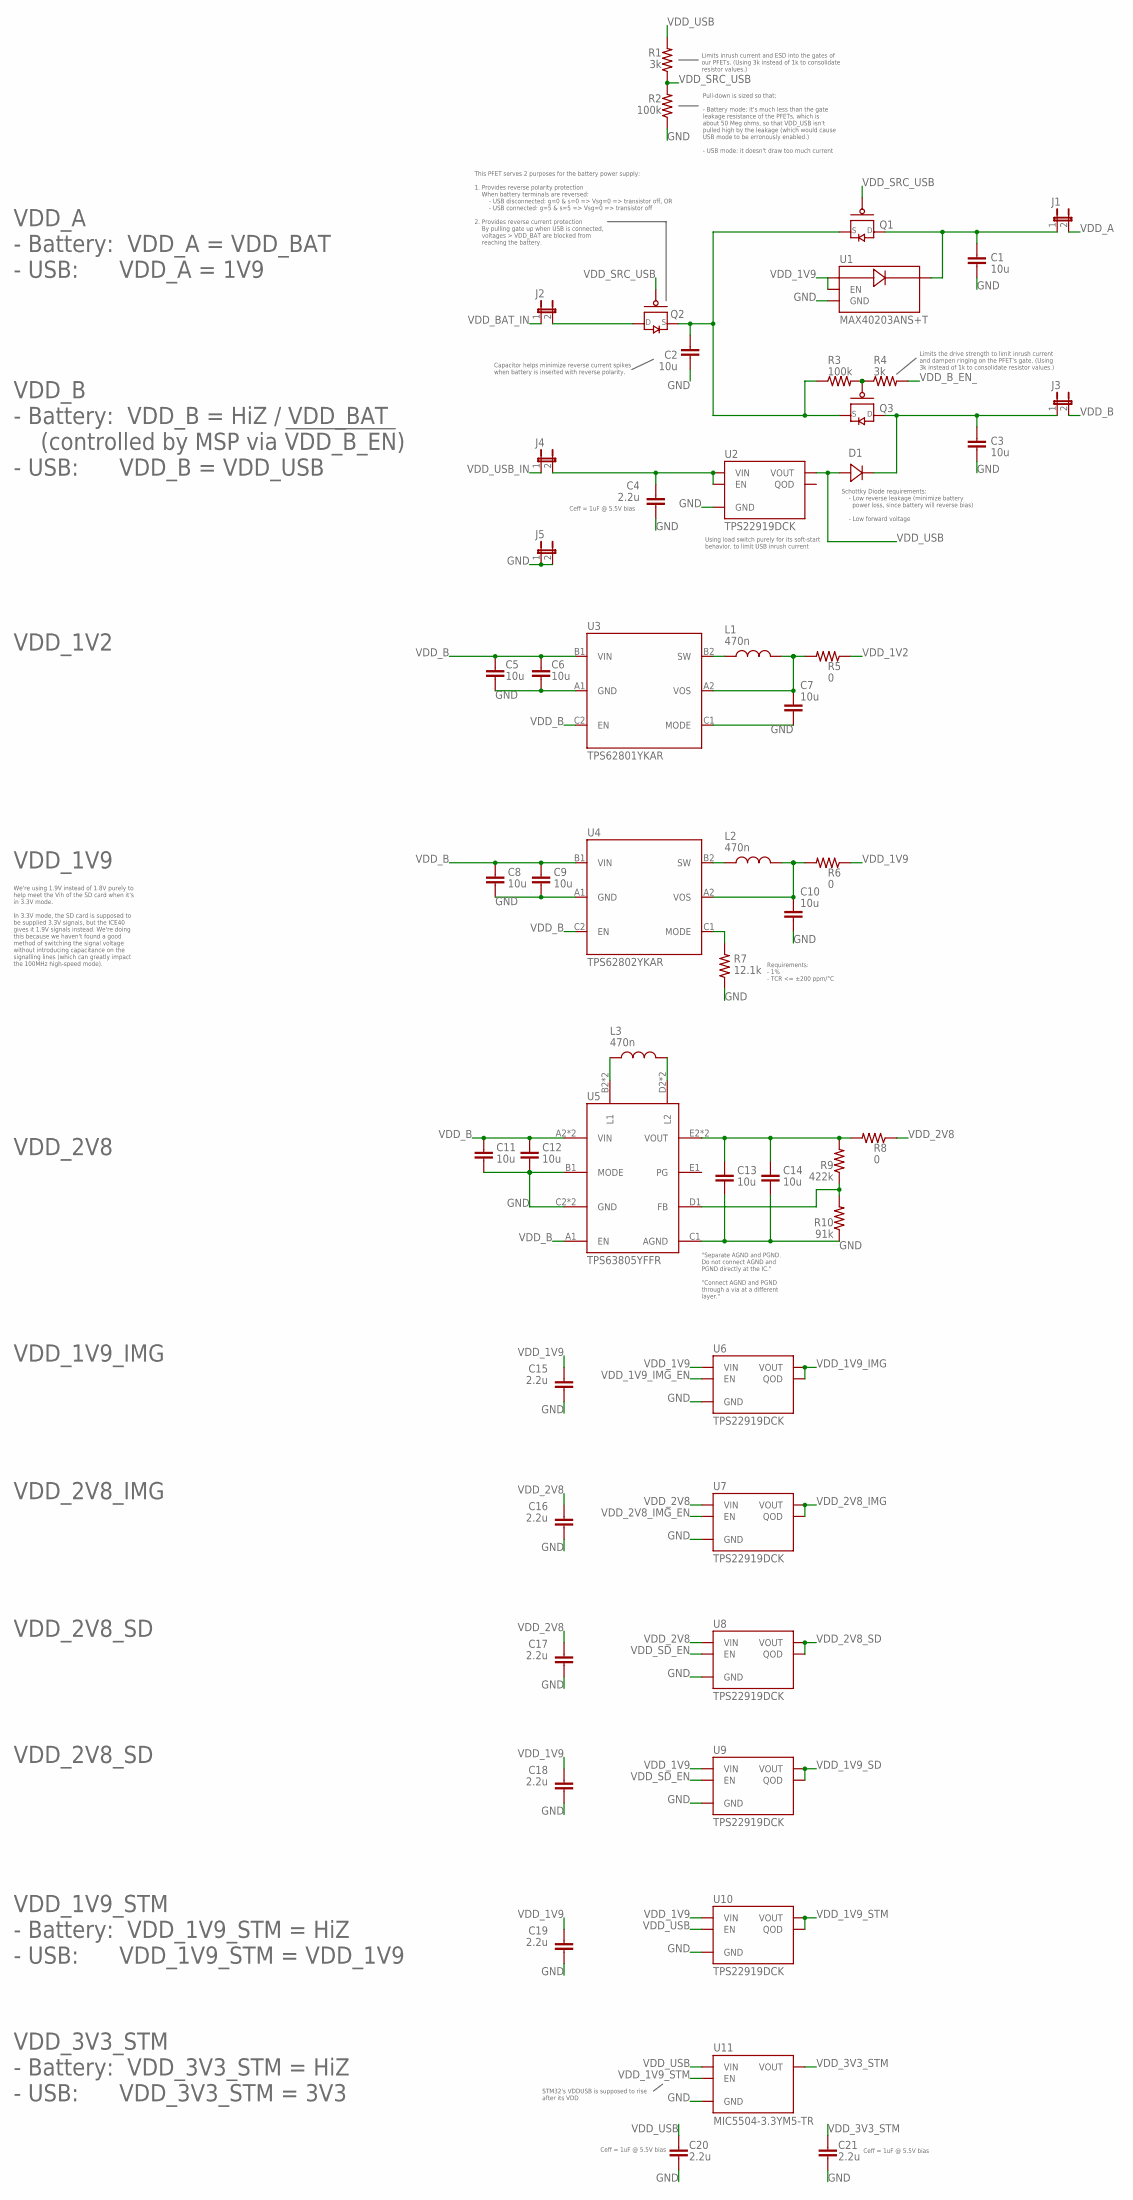
[picture p21: schematic MotionDetectorCamera-Rev4.sch, sheet 1, VDD]

Parts:
C1, C2, C3, C5, C6, C7, C8, C9, C10, C11, C12, C13, C14: 10u; 0805
C4, C15, C16, C17, C18, C19, C20, C21: 2.2u; 0402
D1: ROHM-RB168MM-40TFTR
J1, J2, J3, J4, J5: JUMPER; AMPHENOL-10129380-902002ALF
L1, L2, L3: 470n; 0806
Q1, Q2, Q3: PMOS-NEXPERIA-SOT1220; NEXPERIA-SOT1220
R1, R4: 3k; 0402
R2, R3: 100k; 0402
R5, R6, R8: 0; 0805
R7: 12.1k; 0402
R9: 422k; 0402
R10: 91k; 0402
U1: MAXIM-MAX40203ANS+T
U2, U6, U7, U8, U9, U10: TI-TPS22919DCK
U3, U4: TI-TPS6280XYKAR
U5: TI-TPS63805YFFR
U11: MICROCHIP-MIC550X; MICROCHIP-MIC550X-SOT23-5

Connections:
GND: C1.2, C2.2, C3.2, C4.2, C5.2, C6.2, C7.2, C8.2, C9.2, C10.2, C11.2, C12.2, C13.2, C14.2, C15.2, C16.2, C17.2, C18.2, C19.2, C20.2, C21.2, J5.1, J5.2, R2.1, R7.1, R10.1, U1.B2 (GND), U2.2 (GND), U3.A1 (GND), U3.C1 (MODE), U4.A1 (GND), U5.B1 (MODE), U5.C1 (AGND), U5.C2 (GND), U5.C3 (GND), U6.2 (GND), U7.2 (GND), U8.2 (GND), U9.2 (GND), U10.2 (GND), U11.2 (GND); also elsewhere on the board
unnamed: J2.2, Q2.1 (D), Q2.2 (D), Q2.5 (D), Q2.6 (D), Q2.7 (D)
unnamed: L2.1, U4.B2 (SW)
unnamed: L1.1, U3.B2 (SW)
unnamed: Q3.3 (G), R3.2, R4.1
unnamed: C10.1, L2.2, R6.2, U4.A2 (VOS)
unnamed: C1.1, J1.1, Q1.1 (D), Q1.2 (D), Q1.5 (D), Q1.6 (D), Q1.7 (D), U1.A2 (VOUT)
unnamed: R9.1, R10.2, U5.D1 (FB)
unnamed: L3.1, U5.B2 (L1), U5.B3 (L1)
unnamed: L3.2, U5.D2 (L2), U5.D3 (L2)
unnamed: C3.1, D1.2 (C), J3.1, Q3.1 (D), Q3.2 (D), Q3.5 (D), Q3.6 (D), Q3.7 (D)
unnamed: C7.1, L1.2, R5.2, U3.A2 (VOS)
unnamed: C13.1, C14.1, R8.2, R9.2, U5.E2 (VOUT), U5.E3 (VOUT)
unnamed: C2.1, Q1.4 (S), Q1.8 (S), Q2.4 (S), Q2.8 (S), Q3.4 (S), Q3.8 (S), R3.1
unnamed: R7.2, U4.C1 (MODE)
unnamed: C4.1, J4.2, U2.1 (VIN), U2.3 (EN)
VDD_1V2: R5.1; also elsewhere on the board
VDD_1V9: C15.1, C18.1, C19.1, R6.1, U1.A1 (VIN), U1.B1 (EN), U6.1 (VIN), U9.1 (VIN), U10.1 (VIN); also elsewhere on the board
VDD_1V9_IMG: U6.5 (QOD), U6.6 (VOUT); also elsewhere on the board
VDD_1V9_IMG_EN: U6.3 (EN); also elsewhere on the board
VDD_1V9_SD: U9.5 (QOD), U9.6 (VOUT); also elsewhere on the board
VDD_1V9_STM: U10.5 (QOD), U10.6 (VOUT), U11.3 (EN); also elsewhere on the board
VDD_2V8: C16.1, C17.1, R8.1, U7.1 (VIN), U8.1 (VIN); also elsewhere on the board
VDD_2V8_IMG: U7.5 (QOD), U7.6 (VOUT); also elsewhere on the board
VDD_2V8_IMG_EN: U7.3 (EN); also elsewhere on the board
VDD_2V8_SD: U8.5 (QOD), U8.6 (VOUT); also elsewhere on the board
VDD_3V3_STM: C21.1, U11.5 (VOUT); also elsewhere on the board
VDD_A: J1.2; also elsewhere on the board
VDD_B: C5.1, C6.1, C8.1, C9.1, C11.1, C12.1, J3.2, U3.B1 (VIN), U3.C2 (EN), U4.B1 (VIN), U4.C2 (EN), U5.A1 (EN), U5.A2 (VIN), U5.A3 (VIN)
VDD_BAT_IN: J2.1
VDD_B_EN_: R4.2; also elsewhere on the board
VDD_SD_EN: U8.3 (EN), U9.3 (EN); also elsewhere on the board
VDD_SRC_USB: Q1.3 (G), Q2.3 (G), R1.1, R2.2
VDD_USB: C20.1, D1.1 (A), R1.2, U2.6 (VOUT), U10.3 (EN), U11.1 (VIN)
VDD_USB_IN: J4.1; also elsewhere on the board

Notes on the sheet:
"Separate AGND and PGND. Do not connect AGND and PGND directly at the IC." "Connect AGND and PGND through a via at a different layer."
VDD_1V9_STM - Battery: VDD_1V9_STM = HiZ - USB: VDD_1V9_STM = VDD_1V9
VDD_A - Battery: VDD_A = VDD_BAT - USB: VDD_A = 1V9
VDD_B - Battery: VDD_B = HiZ / VDD_BAT (controlled by MSP via !VDD_B_EN!) - USB: VDD_B = VDD_USB
VDD_1V2
VDD_1V9
VDD_2V8
This PFET serves 2 purposes for the battery power supply: 1. Provides reverse polarity protection When battery terminals are reversed: - USB disconnected: g=0 & s=0 => Vsg=0 => transistor off, OR - USB connected: g=5 & s=5 => Vsg=0 => transistor off 2. Provides reverse current protection By pulling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
Capacitor helps minimize reverse current spikes when battery is inserted with reverse polarity.
VDD_1V9_IMG
VDD_2V8_IMG
VDD_2V8_SD
Pull-down is sized so that: - Battery mode: it's much less than the gate leakage resistance of the PFETs, which is about 50 Meg ohms, so that VDD_USB isn't pulled high by the leakage (which would cause USB mode to be erronously enabled.) - USB mode: it doesn't draw too much current
Limits inrush current and ESD into the gates of our PFETs. (Using 3k instead of 1k to consolidate resistor values.)
Limits the drive strength to limit inrush current and dampen ringing on the PFET's gate. (Using 3k instead of 1k to consolidate resistor values.)
VDD_3V3_STM - Battery: VDD_3V3_STM = HiZ - USB: VDD_3V3_STM = 3V3
STM32's VDDUSB is supposed to rise after its VDD
Ceff = 1uF @ 5.5V bias
Requirements: - 1% - TCR <= ±200 ppm/°C
We're using 1.9V instead of 1.8V purely to help meet the Vih of the SD card when it's in 3.3V mode. In 3.3V mode, the SD card is supposed to be supplied 3.3V signals, but the ICE40 gives it 1.9V signals instead. We're doing this because we haven't found a good method of switching the signal voltage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
Using load switch purely for its soft-start behavior, to limit USB inrush current
Schottky Diode requirements: - Low reverse leakage (minimize battery power loss, since battery will reverse bias) - Low forward voltage

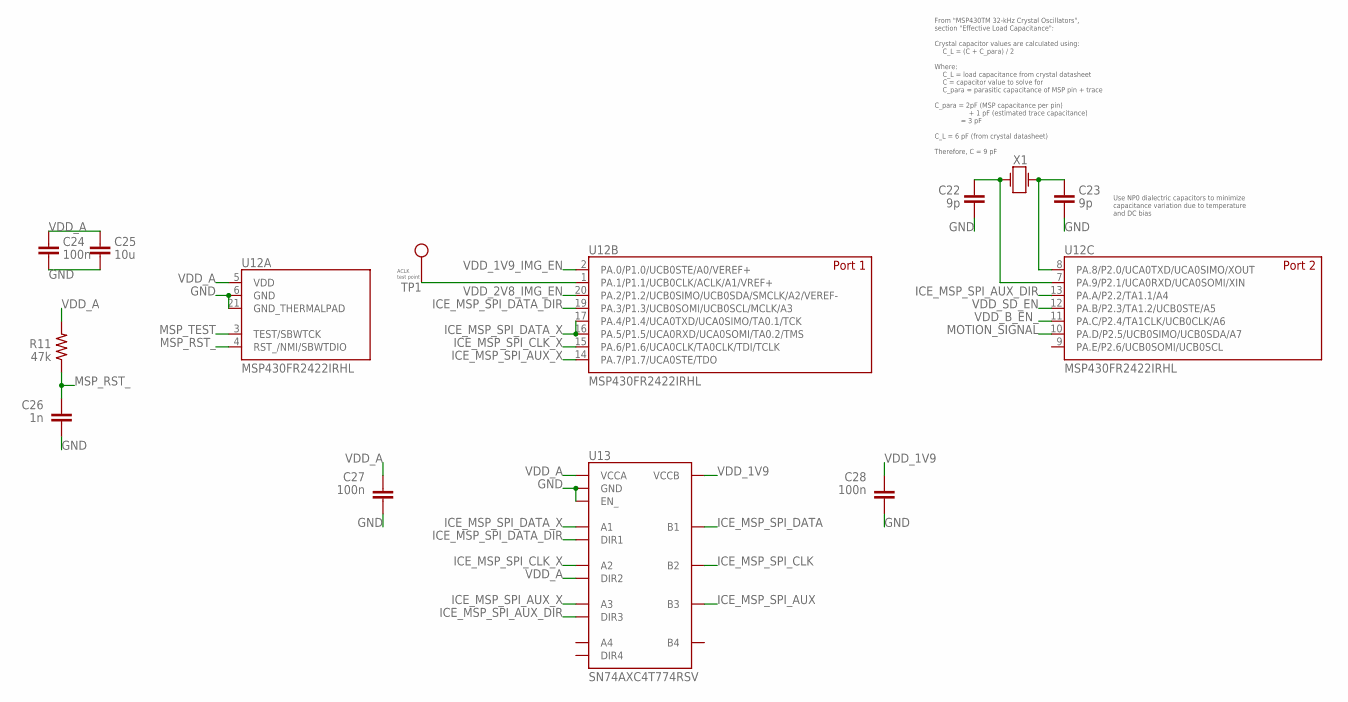
[picture p22: schematic MotionDetectorCamera-Rev4.sch, sheet 2, MSP]

Parts:
C22, C23: 9p; 0402
C24, C27, C28: 100n; 0402
C25: 10u; 0805
C26: 1n; 0402
R11: 47k; 0402
TP1: TEST-POINT
U12: TI-MSP430FR2422IRHL
U13: TI-SN74AXC4T774RSV
X1: EPSON-MC-306

Connections:
GND: C22.2, C23.2, C24.2, C25.2, C26.2, C27.2, C28.2, U12.6 (GND), U12.21 (GND_THERMALPAD), U13.7 (EN_), U13.8 (GND); also elsewhere on the board
ICE_MSP_SPI_AUX: U13.10 (B3); also elsewhere on the board
ICE_MSP_SPI_AUX_DIR: U12.13 (PA.A/P2.2/TA1.1/A4), U13.5 (DIR3)
ICE_MSP_SPI_AUX_X: U12.14 (PA.7/P1.7/UCA0STE/TDO), U13.3 (A3)
ICE_MSP_SPI_CLK: U13.11 (B2); also elsewhere on the board
ICE_MSP_SPI_CLK_X: U12.15 (PA.6/P1.6/UCA0CLK/TA0CLK/TDI/TCLK), U13.2 (A2)
ICE_MSP_SPI_DATA: U13.12 (B1); also elsewhere on the board
ICE_MSP_SPI_DATA_DIR: U12.19 (PA.3/P1.3/UCB0SOMI/UCB0SCL/MCLK/A3), U13.15 (DIR1)
ICE_MSP_SPI_DATA_X: U12.16 (PA.5/P1.5/UCA0RXD/UCA0SOMI/TA0.2/TMS), U12.17 (PA.4/P1.4/UCA0TXD/UCA0SIMO/TA0.1/TCK), U13.1 (A1)
MOTION_SIGNAL: U12.10 (PA.D/P2.5/UCB0SIMO/UCB0SDA/A7); also elsewhere on the board
MSP_RST_: C26.1, R11.1, U12.4 (RST_/NMI/SBWTDIO); also elsewhere on the board
MSP_TEST: U12.3 (TEST/SBWTCK); also elsewhere on the board
unnamed: C23.1, U12.8 (PA.8/P2.0/UCA0TXD/UCA0SIMO/XOUT), X1.4 (B)
unnamed: C22.1, U12.7 (PA.9/P2.1/UCA0RXD/UCA0SOMI/XIN), X1.1 (A)
unnamed: TP1.X, U12.1 (PA.1/P1.1/UCB0CLK/ACLK/A1/VREF+)
VDD_1V9: C28.1, U13.13 (VCCB); also elsewhere on the board
VDD_1V9_IMG_EN: U12.2 (PA.0/P1.0/UCB0STE/A0/VEREF+); also elsewhere on the board
VDD_2V8_IMG_EN: U12.20 (PA.2/P1.2/UCB0SIMO/UCB0SDA/SMCLK/A2/VER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); also elsewhere on the board
VDD_A: C24.1, C25.1, C27.1, R11.2, U12.5 (VDD), U13.14 (VCCA), U13.16 (DIR2); also elsewhere on the board
VDD_B_EN_: U12.11 (PA.C/P2.4/TA1CLK/UCB0CLK/A6); also elsewhere on the board
VDD_SD_EN: U12.12 (PA.B/P2.3/TA1.2/UCB0STE/A5); also elsewhere on the board

Notes on the sheet:
From "MSP430TM 32-kHz Crystal Oscillators", section "Effective Load Capacitance": Crystal capacitor values are calculated using: C_L = (C + C_para) / 2 Where: C_L = load capacitance from crystal datasheet C = capacitor value to solve for C_para = parasitic capacitance of MSP pin + trace C_para = 2p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
Use NP0 dialectric capacitors to minimize capacitance variation due to temperature and DC bias
ACLK test point

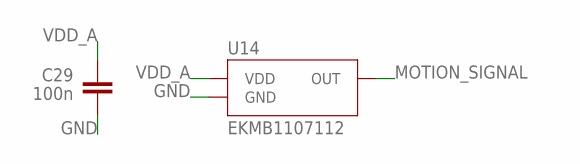
[picture p23: schematic MotionDetectorCamera-Rev4.sch, sheet 3, MOTION]

Parts:
C29: 100n; 0402
U14: PANASONIC-EKMB110711X

Connections:
GND: C29.2, U14.3 (GND); also elsewhere on the board
MOTION_SIGNAL: U14.2 (OUT); also elsewhere on the board
VDD_A: C29.1, U14.1 (VDD); also elsewhere on the board

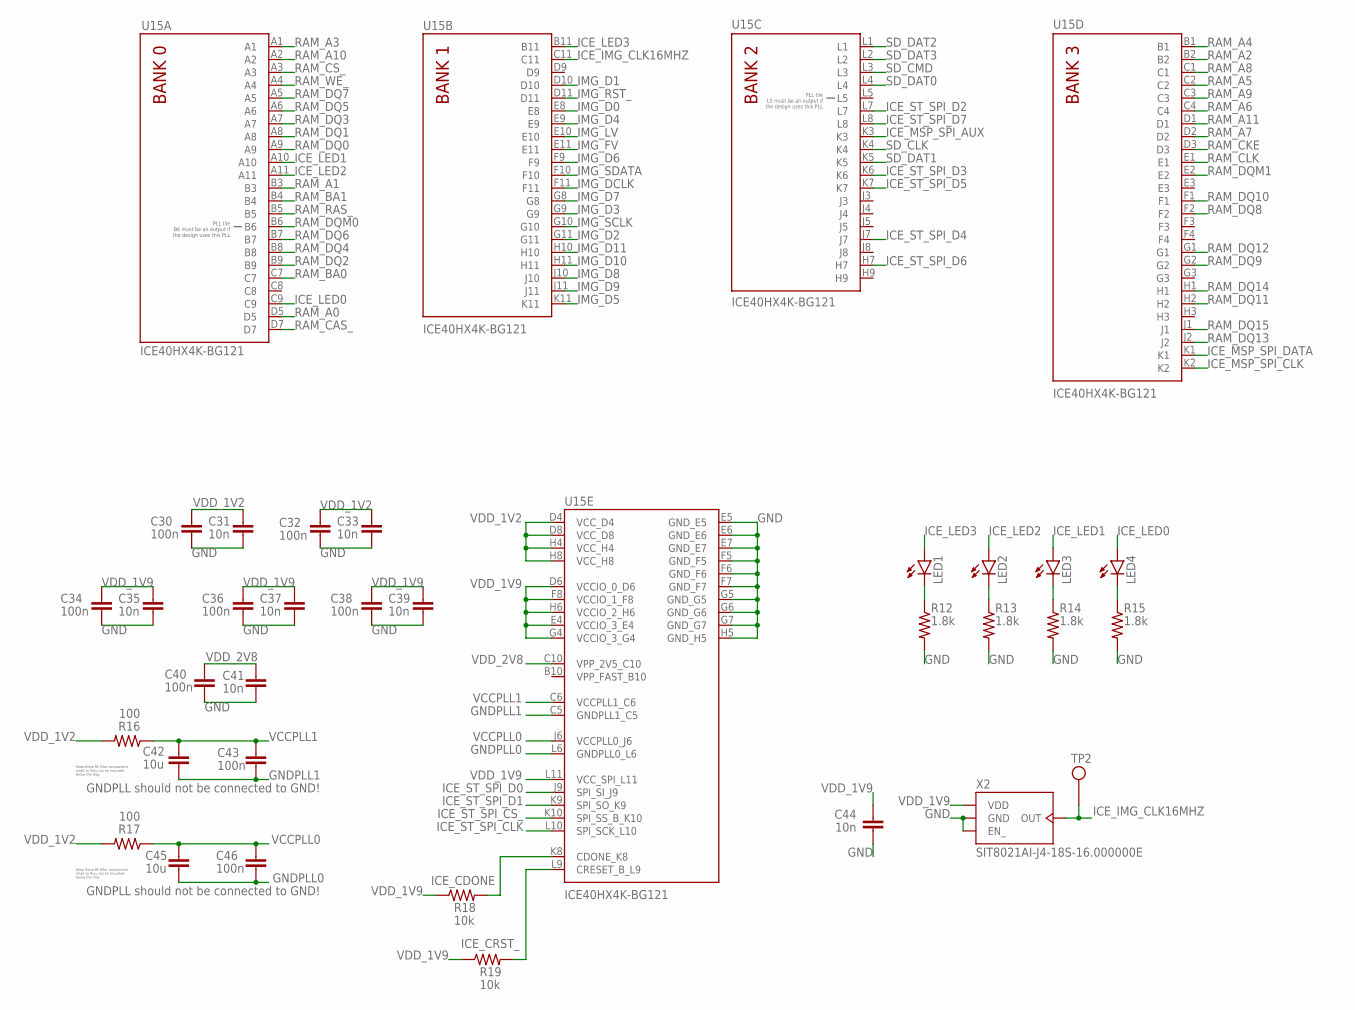
[picture p24: schematic MotionDetectorCamera-Rev4.sch, sheet 4, ICE]

Parts:
C30, C32, C34, C36, C38, C40, C43, C46: 100n; 0402
C31, C33, C35, C37, C39, C41, C44: 10n; 0402
C42, C45: 10u; 0805
LED1, LED2, LED3, LED4: LED; LED-0603
R12, R13, R14, R15: 1.8k; 0402
R16, R17: 100; 0402
R18, R19: 10k; 0402
TP2: TEST-POINT
U15: LATTICE-ICE40HX4K-BG121
X2: SITIME-SIT8021

Connections:
GND: C30.2, C31.2, C32.2, C33.2, C34.2, C35.2, C36.2, C37.2, C38.2, C39.2, C40.2, C41.2, C44.2, R12.2, R13.2, R14.2, R15.2, U15.E5 (GND_E5), U15.E6 (GND_E6), U15.E7 (GND_E7), U15.F5 (GND_F5), U15.F6 (GND_F6), U15.F7 (GND_F7), U15.G5 (GND_G5), U15.G6 (GND_G6), U15.G7 (GND_G7), U15.H5 (GND_H5), X2.1 (EN_), X2.4 (GND); also elsewhere on the board
GNDPLL0: C45.2, C46.2, U15.L6 (GNDPLL0_L6)
GNDPLL1: C42.2, C43.2, U15.C5 (GNDPLL1_C5)
ICE_CDONE: R18.2, U15.K8 (CDONE_K8); also elsewhere on the board
ICE_CRST_: R19.2, U15.L9 (CRESET_B_L9); also elsewhere on the board
ICE_IMG_CLK16MHZ: TP2.X, U15.C11, X2.2 (OUT); also elsewhere on the board
ICE_LED0: LED4.A, U15.C9
ICE_LED1: LED3.A, U15.A10
ICE_LED2: LED2.A, U15.A11
ICE_LED3: LED1.A, U15.B11
ICE_MSP_SPI_AUX: U15.K3; also elsewhere on the board
ICE_MSP_SPI_CLK: U15.K2; also elsewhere on the board
ICE_MSP_SPI_DATA: U15.K1; also elsewhere on the board
ICE_ST_SPI_CLK: U15.L10 (SPI_SCK_L10); also elsewhere on the board
ICE_ST_SPI_CS_: U15.K10 (SPI_SS_B_K10); also elsewhere on the board
ICE_ST_SPI_D0: U15.J9 (SPI_SI_J9); also elsewhere on the board
ICE_ST_SPI_D1: U15.K9 (SPI_SO_K9); also elsewhere on the board
ICE_ST_SPI_D2: U15.L7; also elsewhere on the board
ICE_ST_SPI_D3: U15.K6; also elsewhere on the board
ICE_ST_SPI_D4: U15.J7; also elsewhere on the board
ICE_ST_SPI_D5: U15.K7; also elsewhere on the board
ICE_ST_SPI_D6: U15.H7; also elsewhere on the board
ICE_ST_SPI_D7: U15.L8; also elsewhere on the board
IMG_D0: U15.E8; also elsewhere on the board
IMG_D1: U15.D10; also elsewhere on the board
IMG_D2: U15.G11; also elsewhere on the board
IMG_D3: U15.G9; also elsewhere on the board
IMG_D4: U15.E9; also elsewhere on the board
IMG_D5: U15.K11; also elsewhere on the board
IMG_D6: U15.F9; also elsewhere on the board
IMG_D7: U15.G8; also elsewhere on the board
IMG_D8: U15.J10; also elsewhere on the board
IMG_D9: U15.J11; also elsewhere on the board
IMG_D10: U15.H11; also elsewhere on the board
IMG_D11: U15.H10; also elsewhere on the board
IMG_DCLK: U15.F11; also elsewhere on the board
IMG_FV: U15.E11; also elsewhere on the board
IMG_LV: U15.E10; also elsewhere on the board
IMG_RST_: U15.D11; also elsewhere on the board
IMG_SCLK: U15.G10; also elsewhere on the board
IMG_SDATA: U15.F10; also elsewhere on the board
unnamed: LED3.C, R14.1
unnamed: LED4.C, R15.1
unnamed: LED2.C, R13.1
unnamed: LED1.C, R12.1
RAM_A0: U15.D5; also elsewhere on the board
RAM_A1: U15.B3; also elsewhere on the board
RAM_A2: U15.B2; also elsewhere on the board
RAM_A3: U15.A1; also elsewhere on the board
RAM_A4: U15.B1; also elsewhere on the board
RAM_A5: U15.C2; also elsewhere on the board
RAM_A6: U15.C4; also elsewhere on the board
RAM_A7: U15.D2; also elsewhere on the board
RAM_A8: U15.C1; also elsewhere on the board
RAM_A9: U15.C3; also elsewhere on the board
RAM_A10: U15.A2; also elsewhere on the board
RAM_A11: U15.D1; also elsewhere on the board
RAM_BA0: U15.C7; also elsewhere on the board
RAM_BA1: U15.B4; also elsewhere on the board
RAM_CAS_: U15.D7; also elsewhere on the board
RAM_CKE: U15.D3; also elsewhere on the board
RAM_CLK: U15.E1; also elsewhere on the board
RAM_CS_: U15.A3; also elsewhere on the board
RAM_DQ0: U15.A9; also elsewhere on the board
RAM_DQ1: U15.A8; also elsewhere on the board
RAM_DQ2: U15.B9; also elsewhere on the board
RAM_DQ3: U15.A7; also elsewhere on the board
RAM_DQ4: U15.B8; also elsewhere on the board
RAM_DQ5: U15.A6; also elsewhere on the board
RAM_DQ6: U15.B7; also elsewhere on the board
RAM_DQ7: U15.A5; also elsewhere on the board
RAM_DQ8: U15.F2; also elsewhere on the board
RAM_DQ9: U15.G2; also elsewhere on the board
RAM_DQ10: U15.F1; also elsewhere on the board
RAM_DQ11: U15.H2; also elsewhere on the board
RAM_DQ12: U15.G1; also elsewhere on the board
RAM_DQ13: U15.J2; also elsewhere on the board
RAM_DQ14: U15.H1; also elsewhere on the board
RAM_DQ15: U15.J1; also elsewhere on the board
RAM_DQM0: U15.B6; also elsewhere on the board
RAM_DQM1: U15.E2; also elsewhere on the board
RAM_RAS_: U15.B5; also elsewhere on the board
RAM_WE_: U15.A4; also elsewhere on the board
SD_CLK: U15.K4; also elsewhere on the board
SD_CMD: U15.L3; also elsewhere on the board
SD_DAT0: U15.L4; also elsewhere on the board
SD_DAT1: U15.K5; also elsewhere on the board
SD_DAT2: U15.L1; also elsewhere on the board
SD_DAT3: U15.L2; also elsewhere on the board
VCCPLL0: C45.1, C46.1, R17.1, U15.J6 (VCCPLL0_J6)
VCCPLL1: C42.1, C43.1, R16.1, U15.C6 (VCCPLL1_C6)
VDD_1V2: C30.1, C31.1, C32.1, C33.1, R16.2, R17.2, U15.D4 (VCC_D4), U15.D8 (VCC_D8), U15.H4 (VCC_H4), U15.H8 (VCC_H8); also elsewhere on the board
VDD_1V9: C34.1, C35.1, C36.1, C37.1, C38.1, C39.1, C44.1, R18.1, R19.1, U15.D6 (VCCIO_0_D6), U15.E4 (VCCIO_3_E4), U15.F8 (VCCIO_1_F8), U15.G4 (VCCIO_3_G4), U15.H6 (VCCIO_2_H6), U15.L11 (VCC_SPI_L11), X2.3 (VDD); also elsewhere on the board
VDD_2V8: C40.1, C41.1, U15.C10 (VPP_2V5_C10); also elsewhere on the board

Notes on the sheet:
GNDPLL should not be connected to GND!
Keep these RC filter components small so they can be mounted below the chip.
