toasterllc/MDCCode/PCB/MotionDetectorCamera-Rev4.brd

## EAGLE design PCB/MotionDetectorCamera-Rev4.brd (continued)

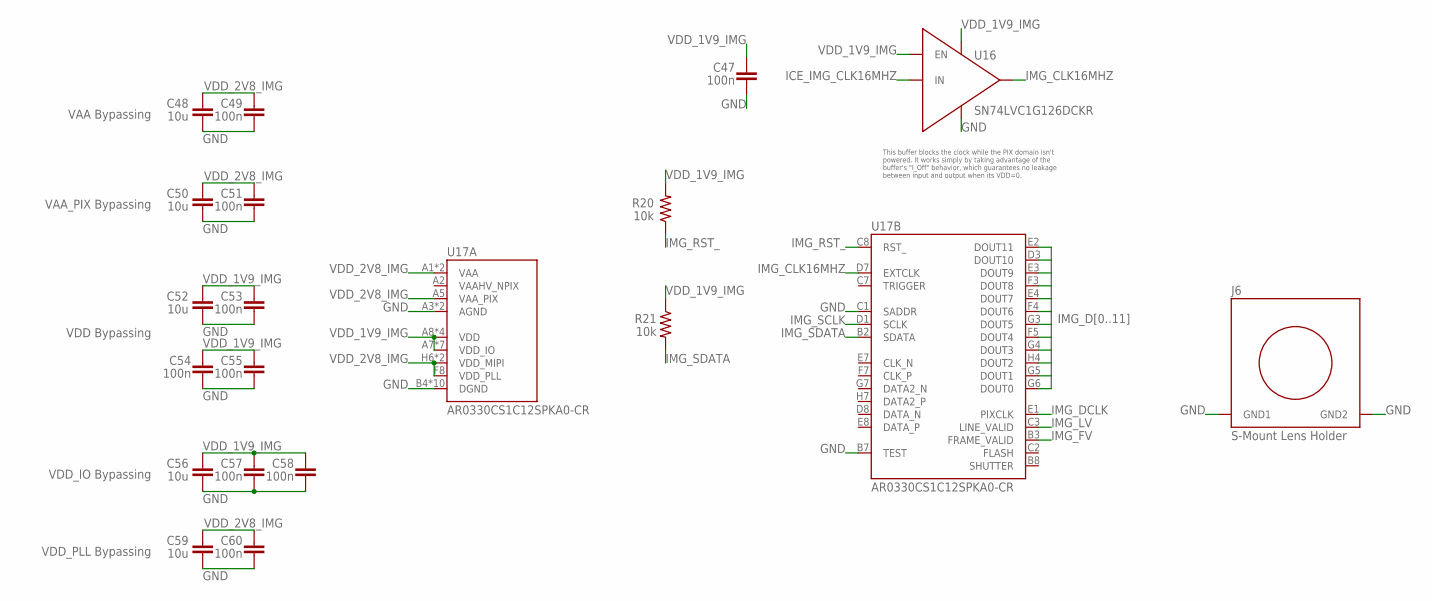
[picture p25: schematic MotionDetectorCamera-Rev4.sch, sheet 5, IMG]

Parts:
C47, C49, C51, C53, C54, C55, C57, C58, C60: 100n; 0402
C48, C50, C52, C56, C59: 10u; 0805
J6: S-MOUNT-LENS-HOLDER
R20, R21: 10k; 0402
U16: TI-SN74LVC1G126; TI-SN74LVC1G126DCK
U17: ON-AR0330CS1C12SPKA0

Connections:
GND: C47.2, C48.2, C49.2, C50.2, C51.2, C52.2, C53.2, C54.2, C55.2, C56.2, C57.2, C58.2, C59.2, C60.2, J6.1 (GND1), J6.2 (GND2), U16.3 (GND), U17.A3 (AGND), U17.B4 (DGND), U17.B5 (AGND), U17.B6 (DGND), U17.B7 (TEST), U17.C1 (SADDR), U17.C4 (DGND), U17.C5 (DGND), U17.C6 (DGND), U17.D4 (DGND), U17.E6 (DGND), U17.G1 (DGND), U17.H2 (DGND), U17.H3 (DGND); also elsewhere on the board
ICE_IMG_CLK16MHZ: U16.2 (IN); also elsewhere on the board
IMG_CLK16MHZ: U16.4 (OUT), U17.D7 (EXTCLK)
IMG_D0: U17.G6 (DOUT0); also elsewhere on the board
IMG_D1: U17.G5 (DOUT1); also elsewhere on the board
IMG_D2: U17.H4 (DOUT2); also elsewhere on the board
IMG_D3: U17.G4 (DOUT3); also elsewhere on the board
IMG_D4: U17.F5 (DOUT4); also elsewhere on the board
IMG_D5: U17.G3 (DOUT5); also elsewhere on the board
IMG_D6: U17.F4 (DOUT6); also elsewhere on the board
IMG_D7: U17.E4 (DOUT7); also elsewhere on the board
IMG_D8: U17.F3 (DOUT8); also elsewhere on the board
IMG_D9: U17.E3 (DOUT9); also elsewhere on the board
IMG_D10: U17.D3 (DOUT10); also elsewhere on the board
IMG_D11: U17.E2 (DOUT11); also elsewhere on the board
IMG_DCLK: U17.E1 (PIXCLK); also elsewhere on the board
IMG_FV: U17.B3 (FRAME_VALID); also elsewhere on the board
IMG_LV: U17.C3 (LINE_VALID); also elsewhere on the board
IMG_RST_: R20.1, U17.C8 (RST_); also elsewhere on the board
IMG_SCLK: U17.D1 (SCLK); also elsewhere on the board
IMG_SDATA: R21.2, U17.B2 (SDATA); also elsewhere on the board
VDD_1V9_IMG: C47.1, C52.1, C53.1, C54.1, C55.1, C56.1, C57.1, C58.1, R20.2, R21.1, U16.1 (EN), U16.5 (VDD), U17.A7 (VDD_IO), U17.A8 (VDD), U17.B1 (VDD), U17.D2 (VDD_IO), U17.D5 (VDD_IO), U17.D6 (VDD_IO), U17.E5 (VDD_IO), U17.F6 (VDD_IO), U17.G2 (VDD), U17.G8 (VDD), U17.H5 (VDD_IO); also elsewhere on the board
VDD_2V8_IMG: C48.1, C49.1, C50.1, C51.1, C59.1, C60.1, U17.A1 (VAA), U17.A5 (VAA_PIX), U17.A6 (VAA), U17.F8 (VDD_PLL), U17.H6 (VDD_MIPI), U17.H8 (VDD_MIPI); also elsewhere on the board

Notes on the sheet:
VAA Bypassing
VAA_PIX Bypassing
VDD Bypassing
VDD_IO Bypassing
VDD_PLL Bypassing
This buffer blocks the clock while the PIX domain isn't powered. It works simply by taking advantage of the buffer's "I_Off" behavior, which guarantees no leakage between input and output when its VDD=0.

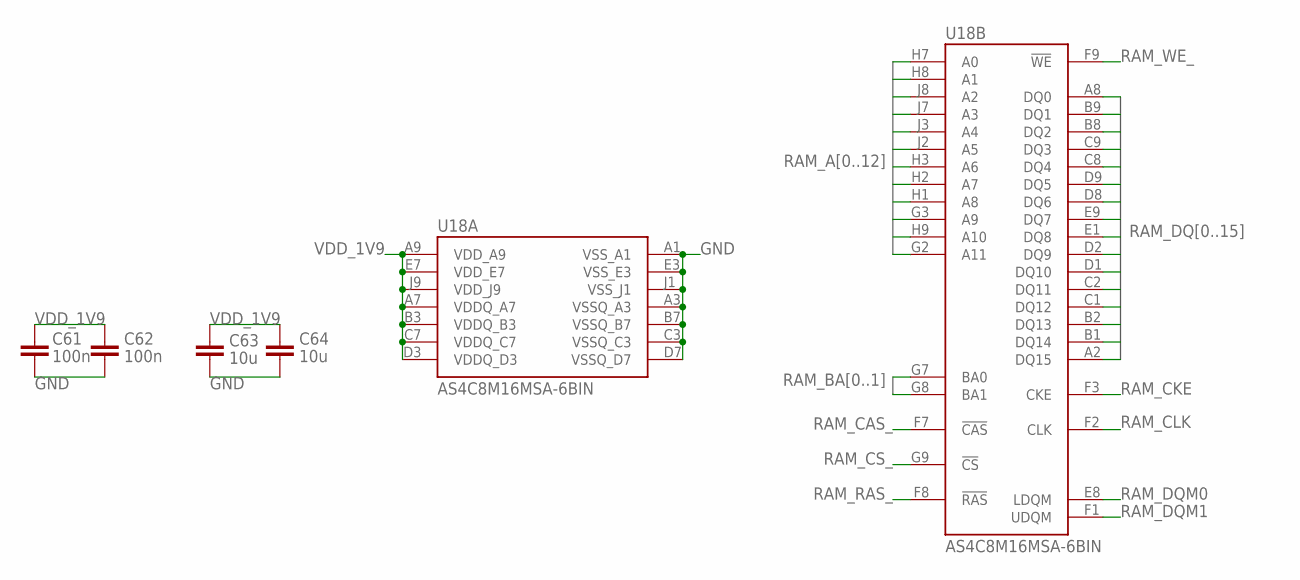
[picture p26: schematic MotionDetectorCamera-Rev4.sch, sheet 6, RAM]

Parts:
C61, C62: 100n; 0402
C63, C64: 10u; 0805
U18: ALLIANCE-AS4C8M16MSA-6BIN

Connections:
GND: C61.2, C62.2, C63.2, C64.2, U18.A1 (VSS_A1), U18.A3 (VSSQ_A3), U18.B7 (VSSQ_B7), U18.C3 (VSSQ_C3), U18.D7 (VSSQ_D7), U18.E3 (VSS_E3), U18.J1 (VSS_J1); also elsewhere on the board
RAM_A0: U18.H7 (A0); also elsewhere on the board
RAM_A1: U18.H8 (A1); also elsewhere on the board
RAM_A2: U18.J8 (A2); also elsewhere on the board
RAM_A3: U18.J7 (A3); also elsewhere on the board
RAM_A4: U18.J3 (A4); also elsewhere on the board
RAM_A5: U18.J2 (A5); also elsewhere on the board
RAM_A6: U18.H3 (A6); also elsewhere on the board
RAM_A7: U18.H2 (A7); also elsewhere on the board
RAM_A8: U18.H1 (A8); also elsewhere on the board
RAM_A9: U18.G3 (A9); also elsewhere on the board
RAM_A10: U18.H9 (A10); also elsewhere on the board
RAM_A11: U18.G2 (A11); also elsewhere on the board
RAM_BA0: U18.G7 (BA0); also elsewhere on the board
RAM_BA1: U18.G8 (BA1); also elsewhere on the board
RAM_CAS_: U18.F7 (!CAS!); also elsewhere on the board
RAM_CKE: U18.F3 (CKE); also elsewhere on the board
RAM_CLK: U18.F2 (CLK); also elsewhere on the board
RAM_CS_: U18.G9 (!CS!); also elsewhere on the board
RAM_DQ0: U18.A8 (DQ0); also elsewhere on the board
RAM_DQ1: U18.B9 (DQ1); also elsewhere on the board
RAM_DQ2: U18.B8 (DQ2); also elsewhere on the board
RAM_DQ3: U18.C9 (DQ3); also elsewhere on the board
RAM_DQ4: U18.C8 (DQ4); also elsewhere on the board
RAM_DQ5: U18.D9 (DQ5); also elsewhere on the board
RAM_DQ6: U18.D8 (DQ6); also elsewhere on the board
RAM_DQ7: U18.E9 (DQ7); also elsewhere on the board
RAM_DQ8: U18.E1 (DQ8); also elsewhere on the board
RAM_DQ9: U18.D2 (DQ9); also elsewhere on the board
RAM_DQ10: U18.D1 (DQ10); also elsewhere on the board
RAM_DQ11: U18.C2 (DQ11); also elsewhere on the board
RAM_DQ12: U18.C1 (DQ12); also elsewhere on the board
RAM_DQ13: U18.B2 (DQ13); also elsewhere on the board
RAM_DQ14: U18.B1 (DQ14); also elsewhere on the board
RAM_DQ15: U18.A2 (DQ15); also elsewhere on the board
RAM_DQM0: U18.E8 (LDQM); also elsewhere on the board
RAM_DQM1: U18.F1 (UDQM); also elsewhere on the board
RAM_RAS_: U18.F8 (!RAS!); also elsewhere on the board
RAM_WE_: U18.F9 (!WE!); also elsewhere on the board
VDD_1V9: C61.1, C62.1, C63.1, C64.1, U18.A7 (VDDQ_A7), U18.A9 (VDD_A9), U18.B3 (VDDQ_B3), U18.C7 (VDDQ_C7), U18.D3 (VDDQ_D3), U18.E7 (VDD_E7), U18.J9 (VDD_J9); also elsewhere on the board

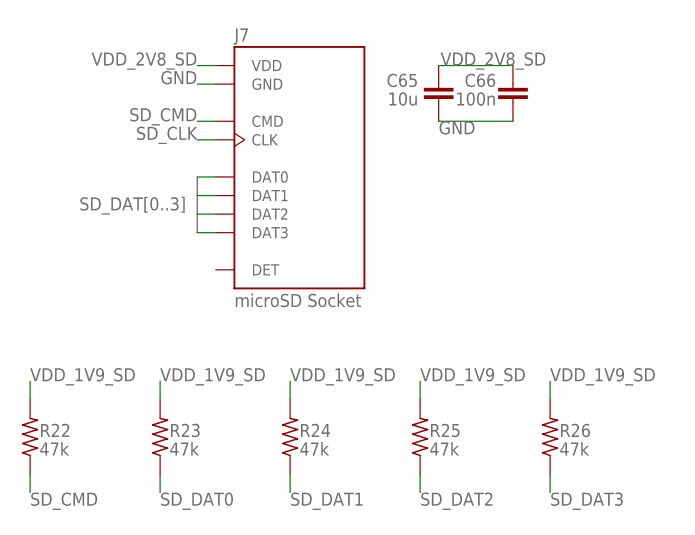
[picture p27: schematic MotionDetectorCamera-Rev4.sch, sheet 7, SD]

Parts:
C65: 10u; 0805
C66: 100n; 0402
J7: MICROSD-SOCKET; MOLEX-1051620001
R22, R23, R24, R25, R26: 47k; 0402

Connections:
GND: C65.2, C66.2, J7.GND1 (GND), J7.GND2 (GND), J7.GND3 (GND), J7.GND4 (GND), J7.VSS (GND); also elsewhere on the board
SD_CLK: J7.CLK; also elsewhere on the board
SD_CMD: J7.CMD, R22.1; also elsewhere on the board
SD_DAT0: J7.DAT0, R23.1; also elsewhere on the board
SD_DAT1: J7.DAT1, R24.1; also elsewhere on the board
SD_DAT2: J7.DAT2, R25.1; also elsewhere on the board
SD_DAT3: J7.DAT3, R26.1; also elsewhere on the board
VDD_1V9_SD: R22.2, R23.2, R24.2, R25.2, R26.2; also elsewhere on the board
VDD_2V8_SD: C65.1, C66.1, J7.VDD; also elsewhere on the board

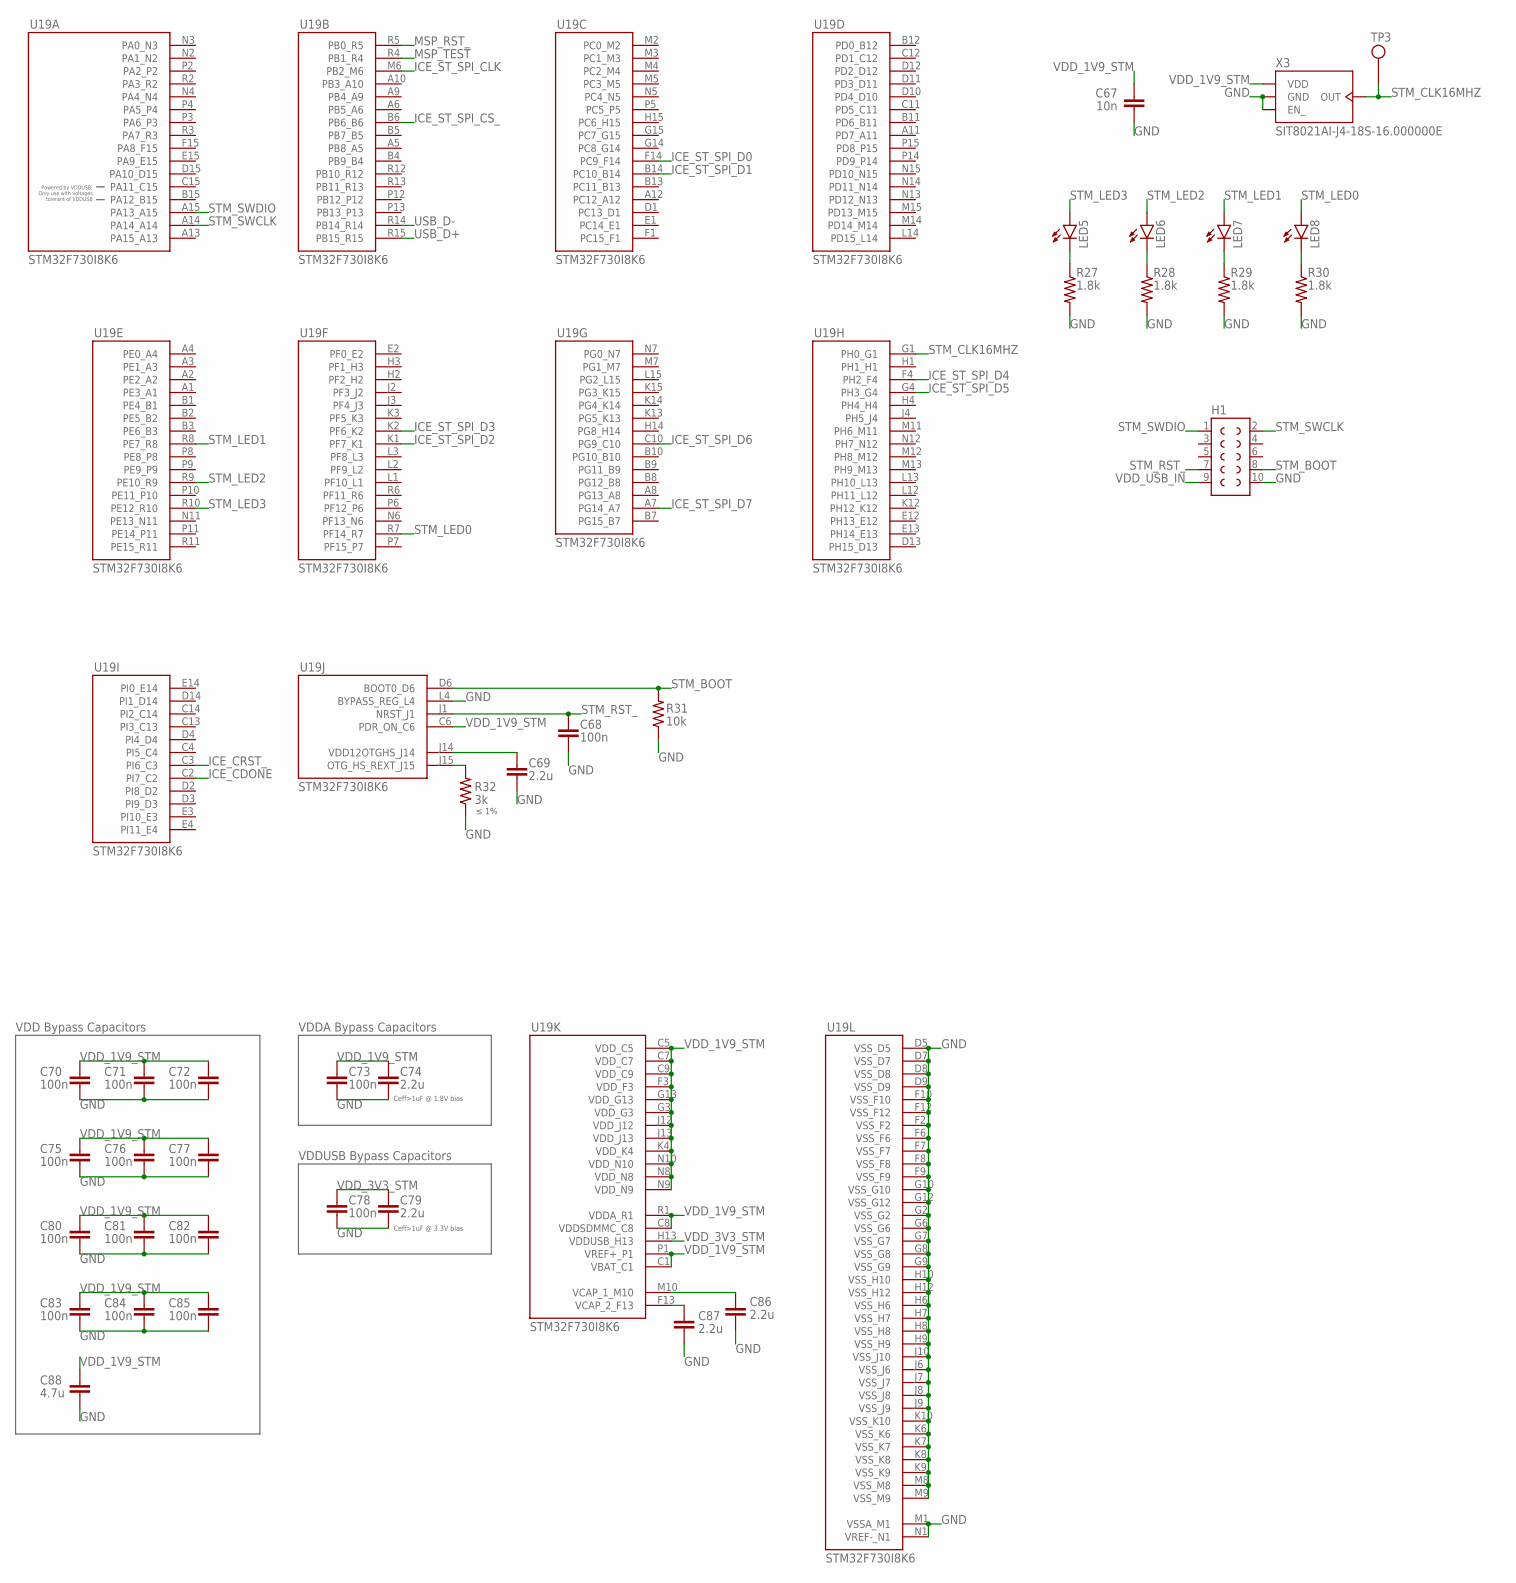
[picture p28: schematic MotionDetectorCamera-Rev4.sch, sheet 8, STM]

Parts:
C67: 10n; 0402
C68, C70, C71, C72, C73, C75, C76, C77, C78, C80, C81, C82, C83, C84, C85: 100n; 0402
C69, C74, C79, C86, C87: 2.2u; 0402
C88: 4.7u; 0603
H1: HEADER-2X5; TEC-1-2314844-0
LED5, LED6, LED7, LED8: LED; LED-0603
R27, R28, R29, R30: 1.8k; 0402
R31: 10k; 0402
R32: 3k; 0402
TP3: TEST-POINT
U19: STM-STM32F730; STM-STM32F730I8
X3: SITIME-SIT8021

Connections:
GND: C67.2, C68.2, C69.2, C70.2, C71.2, C72.2, C73.2, C74.2, C75.2, C76.2, C77.2, C78.2, C79.2, C80.2, C81.2, C82.2, C83.2, C84.2, C85.2, C86.2, C87.2, C88.2, H1.10, R27.2, R28.2, R29.2, R30.2, R31.1, R32.1, U19.D5 (VSS_D5), U19.D7 (VSS_D7), U19.D8 (VSS_D8), U19.D9 (VSS_D9), U19.F2 (VSS_F2), U19.F6 (VSS_F6), U19.F7 (VSS_F7), U19.F8 (VSS_F8), U19.F9 (VSS_F9), U19.F10 (VSS_F10), U19.F12 (VSS_F12), U19.G2 (VSS_G2), U19.G6 (VSS_G6), U19.G7 (VSS_G7), U19.G8 (VSS_G8), U19.G9 (VSS_G9), U19.G10 (VSS_G10), U19.G12 (VSS_G12), U19.H6 (VSS_H6), U19.H7 (VSS_H7), U19.H8 (VSS_H8), U19.H9 (VSS_H9), U19.H10 (VSS_H10), U19.H12 (VSS_H12), U19.J6 (VSS_J6), U19.J7 (VSS_J7), U19.J8 (VSS_J8), U19.J9 (VSS_J9), U19.J10 (VSS_J10), U19.K6 (VSS_K6), U19.K7 (VSS_K7), U19.K8 (VSS_K8), U19.K9 (VSS_K9), U19.K10 (VSS_K10), U19.L4 (BYPASS_REG_L4), U19.M1 (VSSA_M1), U19.M8 (VSS_M8), U19.M9 (VSS_M9), U19.N1 (VREF-_N1), X3.1 (EN_), X3.4 (GND); also elsewhere on the board
ICE_CDONE: U19.C2 (PI7_C2); also elsewhere on the board
ICE_CRST_: U19.C3 (PI6_C3); also elsewhere on the board
ICE_ST_SPI_CLK: U19.M6 (PB2_M6); also elsewhere on the board
ICE_ST_SPI_CS_: U19.B6 (PB6_B6); also elsewhere on the board
ICE_ST_SPI_D0: U19.F14 (PC9_F14); also elsewhere on the board
ICE_ST_SPI_D1: U19.B14 (PC10_B14); also elsewhere on the board
ICE_ST_SPI_D2: U19.K1 (PF7_K1); also elsewhere on the board
ICE_ST_SPI_D3: U19.K2 (PF6_K2); also elsewhere on the board
ICE_ST_SPI_D4: U19.F4 (PH2_F4); also elsewhere on the board
ICE_ST_SPI_D5: U19.G4 (PH3_G4); also elsewhere on the board
ICE_ST_SPI_D6: U19.C10 (PG9_C10); also elsewhere on the board
ICE_ST_SPI_D7: U19.A7 (PG14_A7); also elsewhere on the board
MSP_RST_: U19.R5 (PB0_R5); also elsewhere on the board
MSP_TEST: U19.R4 (PB1_R4); also elsewhere on the board
unnamed: C86.1, U19.M10 (VCAP_1_M10)
unnamed: C87.1, U19.F13 (VCAP_2_F13)
unnamed: R32.2, U19.J15 (OTG_HS_REXT_J15)
unnamed: C69.1, U19.J14 (VDD12OTGHS_J14)
unnamed: LED8.C, R30.1
unnamed: LED7.C, R29.1
unnamed: LED6.C, R28.1
unnamed: LED5.C, R27.1
STM_BOOT: H1.8, R31.2, U19.D6 (BOOT0_D6)
STM_CLK16MHZ: TP3.X, U19.G1 (PH0_G1), X3.2 (OUT)
STM_LED0: LED8.A, U19.R7 (PF14_R7)
STM_LED1: LED7.A, U19.R8 (PE7_R8)
STM_LED2: LED6.A, U19.R9 (PE10_R9)
STM_LED3: LED5.A, U19.R10 (PE12_R10)
STM_RST_: C68.1, H1.7, U19.J1 (NRST_J1)
STM_SWCLK: H1.2, U19.A14 (PA14_A14)
STM_SWDIO: H1.1, U19.A15 (PA13_A15)
USB_D+: U19.R15 (PB15_R15); also elsewhere on the board
USB_D-: U19.R14 (PB14_R14); also elsewhere on the board
VDD_1V9_STM: C67.1, C70.1, C71.1, C72.1, C73.1, C74.1, C75.1, C76.1, C77.1, C80.1, C81.1, C82.1, C83.1, C84.1, C85.1, C88.1, U19.C1 (VBAT_C1), U19.C5 (VDD_C5), U19.C6 (PDR_ON_C6), U19.C7 (VDD_C7), U19.C8 (VDDSDMMC_C8), U19.C9 (VDD_C9), U19.F3 (VDD_F3), U19.G3 (VDD_G3), U19.G13 (VDD_G13), U19.J12 (VDD_J12), U19.J13 (VDD_J13), U19.K4 (VDD_K4), U19.N8 (VDD_N8), U19.N9 (VDD_N9), U19.N10 (VDD_N10), U19.P1 (VREF+_P1), U19.R1 (VDDA_R1), X3.3 (VDD); also elsewhere on the board
VDD_3V3_STM: C78.1, C79.1, U19.H13 (VDDUSB_H13); also elsewhere on the board
VDD_USB_IN: H1.9; also elsewhere on the board

Notes on the sheet:
VDD Bypass Capacitors
VDDA Bypass Capacitors
VDDUSB Bypass Capacitors
≤ 1%
Ceff>1uF @ 3.3V bias
Ceff>1uF @ 1.8V bias

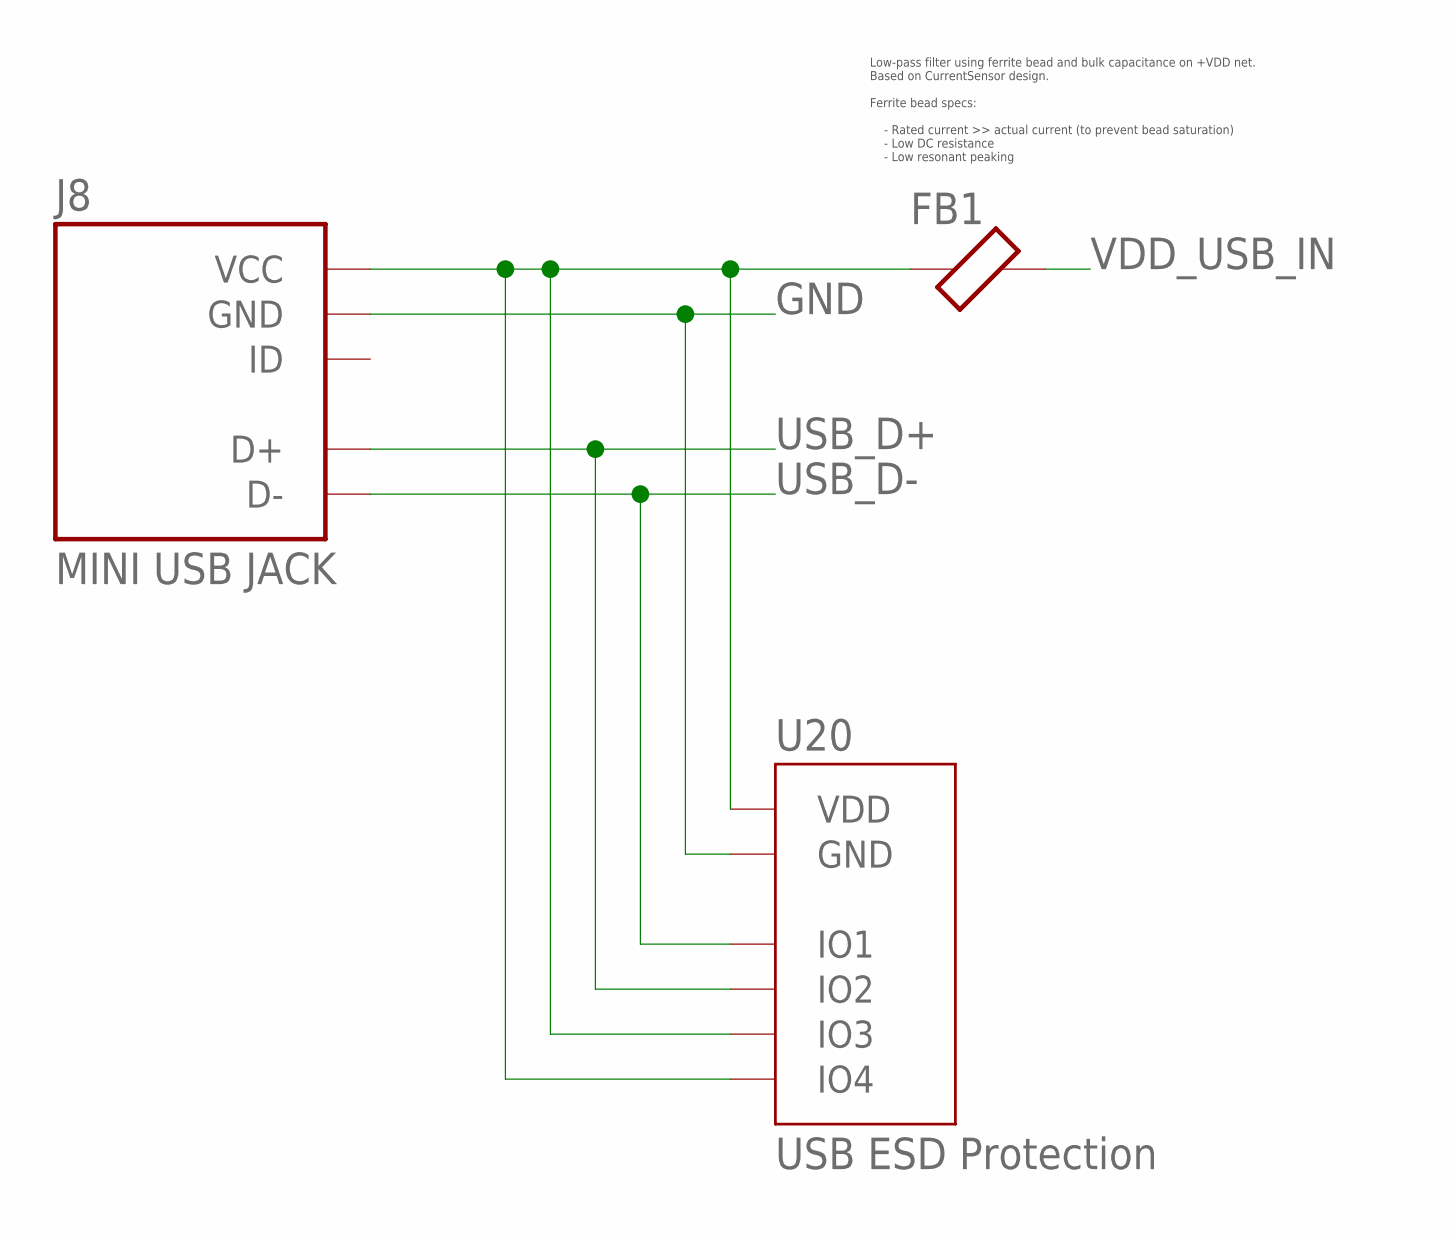
[picture p29: schematic MotionDetectorCamera-Rev4.sch, sheet 9, USB]

Parts:
FB1: FERRITE-BEAD0402; 0402
J8: MINI-USB-JACK; AMPHENOL-10033526-N3222MLF
U20: DIODESINC-DT1446-04V-7

Connections:
GND: J8.GND, J8.GND2 (GND), J8.GND3 (GND), J8.GND4 (GND), J8.GND5 (GND), U20.2 (GND); also elsewhere on the board
unnamed: FB1.1, J8.VCC, U20.4 (IO3), U20.5 (VDD), U20.6 (IO4)
USB_D+: J8.D+, U20.3 (IO2); also elsewhere on the board
USB_D-: J8.D-, U20.1 (IO1); also elsewhere on the board
VDD_USB_IN: FB1.2; also elsewhere on the board

Notes on the sheet:
Low-pass filter using ferrite bead and bulk capacitance on +VDD net. Based on CurrentSensor design. Ferrite bead specs: - Rated current >> actual current (to prevent bead saturation) - Low DC resistance - Low resonant peaking

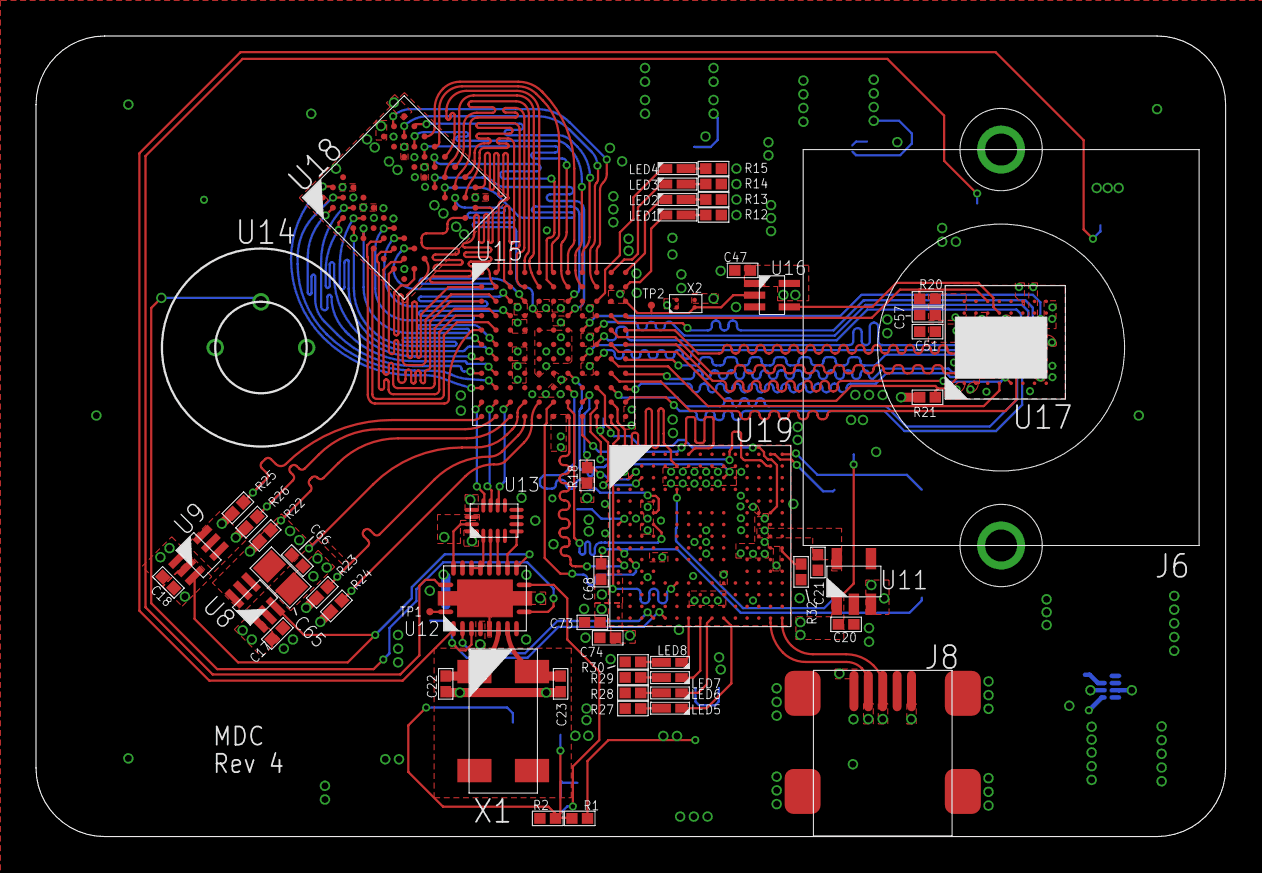
[picture p30: board MotionDetectorCamera-Rev4.brd from above]

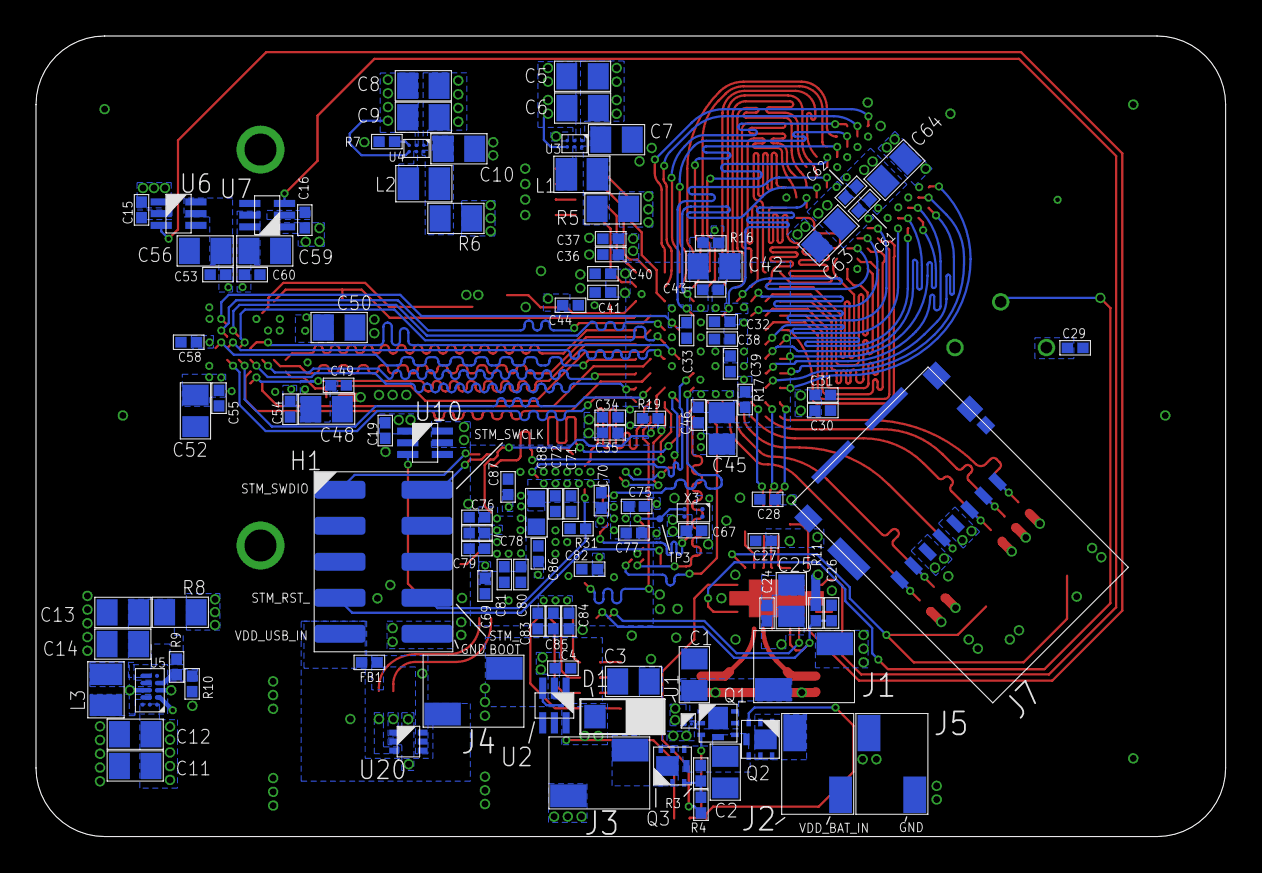
[picture p31: board MotionDetectorCamera-Rev4.brd from below]

Board: 4 copper layers, 66.1 x 44.5 mm, 171 parts (113 on the bottom side), 156 nets.
