toasterllc/MDCCode/PCB/Programmer.brd

## EAGLE design PCB/Programmer.brd (2020-08-07, last stored version)

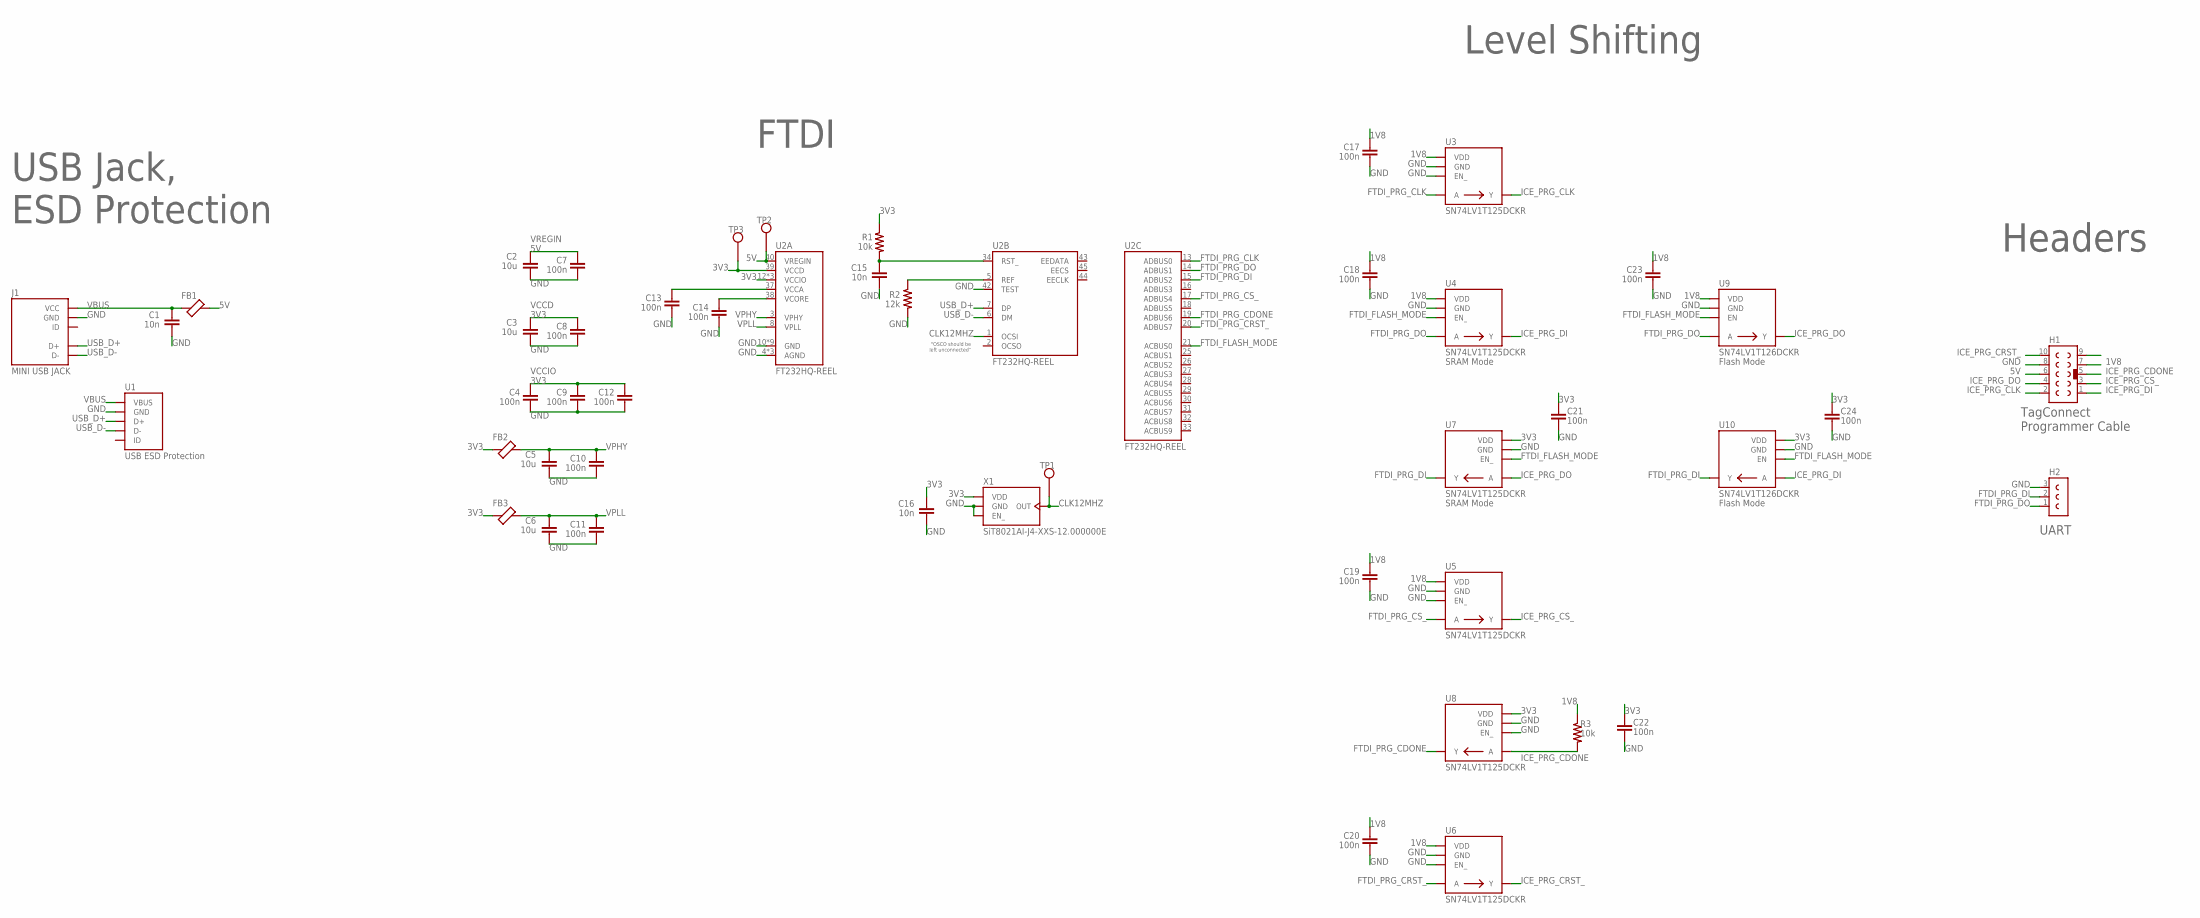
[picture p32: schematic Programmer.sch]

Parts:
C1, C15, C16: 10n; 0402
C2, C3, C5, C6: 10u; 1206
C4, C7, C8, C9, C10, C11, C12, C13, C14, C17, C18, C19, C20, C21, C22, C23, C24: 100n; 0402
FB1, FB2, FB3: FERRITE-BEAD1206; 1206
H1: WURTH-61201021621
H2: HEADER-1X3
J1: MINI-USB-JACK; AMPHENOLFCI-10033526-N3222MLF
R1, R3: 10k; 0402
R2: 12k; 0402
TP1, TP2, TP3: TEST-POINT
U1: TPD4S012DRYR
U2: FT232HQ
U3, U4, U5, U6, U7, U8: SN74LV1T125DCKR; SN74LV1T12XDCKR
U9, U10: SN74LV1T126DCKR; SN74LV1T12XDCKR
X1: SITIME-SIT8021

Connections:
1V8: C17.1, C18.1, C19.1, C20.1, C23.1, H1.7, R3.1, U3.5 (VDD), U4.5 (VDD), U5.5 (VDD), U6.5 (VDD), U9.5 (VDD)
3V3: C3.1, C4.1, C8.1, C9.1, C12.1, C16.1, C21.1, C22.1, C24.1, FB2.1, FB3.1, R1.1, TP3.X, U2.12 (VCCIO), U2.24 (VCCIO), U2.39 (VCCD), U2.46 (VCCIO), U7.5 (VDD), U8.5 (VDD), U10.5 (VDD), X1.3 (VDD)
5V: C2.1, C7.1, FB1.2, H1.6, TP2.X, U2.40 (VREGIN)
CLK12MHZ: TP1.X, U2.1 (OCSI), X1.2 (OUT)
FTDI_FLASH_MODE: U2.21 (ACBUS0), U4.1 (EN_), U7.1 (EN_), U9.1 (EN), U10.1 (EN)
FTDI_PRG_CDONE: U2.19 (ADBUS6), U8.4 (Y)
FTDI_PRG_CLK: U2.13 (ADBUS0), U3.2 (A)
FTDI_PRG_CRST_: U2.20 (ADBUS7), U6.2 (A)
FTDI_PRG_CS_: U2.17 (ADBUS4), U5.2 (A)
FTDI_PRG_DI: H2.2, U2.15 (ADBUS2), U7.4 (Y), U10.4 (Y)
FTDI_PRG_DO: H2.1, U2.14 (ADBUS1), U4.2 (A), U9.2 (A)
GND: C1.2, C2.2, C3.2, C4.2, C5.2, C6.2, C7.2, C8.2, C9.2, C10.2, C11.2, C12.2, C13.2, C14.2, C15.2, C16.2, C17.2, C18.2, C19.2, C20.2, C21.2, C22.2, C23.2, C24.2, H1.8, H2.3, J1.GND, J1.GND2 (GND), J1.GND3 (GND), J1.GND4 (GND), J1.GND5 (GND), R2.2, U1.4 (GND), U2.4 (AGND), U2.9 (AGND), U2.10 (GND), U2.11 (GND), U2.22 (GND), U2.23 (GND), U2.35 (GND), U2.36 (GND), U2.41 (AGND), U2.42 (TEST), U2.47 (GND), U2.48 (GND), U2.49 (GND), U3.1 (EN_), U3.3 (GND), U4.3 (GND), U5.1 (EN_), U5.3 (GND), U6.1 (EN_), U6.3 (GND), U7.3 (GND), U8.1 (EN_), U8.3 (GND), U9.3 (GND), U10.3 (GND), X1.1 (EN_), X1.4 (GND)
ICE_PRG_CDONE: H1.5, R3.2, U8.2 (A)
ICE_PRG_CLK: H1.2, U3.4 (Y)
ICE_PRG_CRST_: H1.10, U6.4 (Y)
ICE_PRG_CS_: H1.3, U5.4 (Y)
ICE_PRG_DI: H1.1, U4.4 (Y), U10.2 (A)
ICE_PRG_DO: H1.4, U7.2 (A), U9.4 (Y)
unnamed: C15.1, R1.2, U2.34 (RST_)
unnamed: C13.1, U2.37 (VCCA)
unnamed: R2.1, U2.5 (REF)
unnamed: C14.1, U2.38 (VCORE)
USB_D+: J1.D+, U1.1 (D+), U2.7 (DP)
USB_D-: J1.D-, U1.2 (D-), U2.6 (DM)
VBUS: C1.1, FB1.1, J1.VCC, U1.6 (VBUS)
VPHY: C5.1, C10.1, FB2.2, U2.3 (VPHY)
VPLL: C6.1, C11.1, FB3.2, U2.8 (VPLL)

Notes on the sheet:
SRAM Mode
Flash Mode
"OSCO should be left unconnected"
VREGIN
VCCD
VCCIO
FTDI
USB Jack, ESD Protection
Level Shifting
Headers
UART
TagConnect Programmer Cable

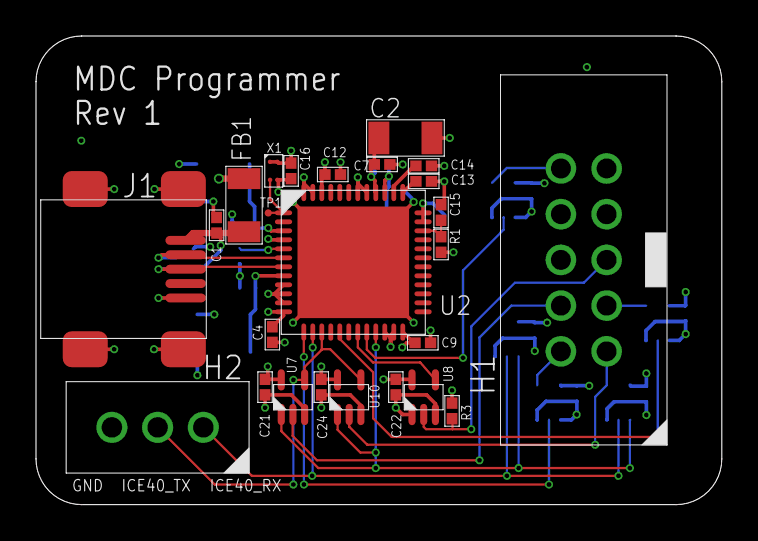
[picture p33: board Programmer.brd from above]

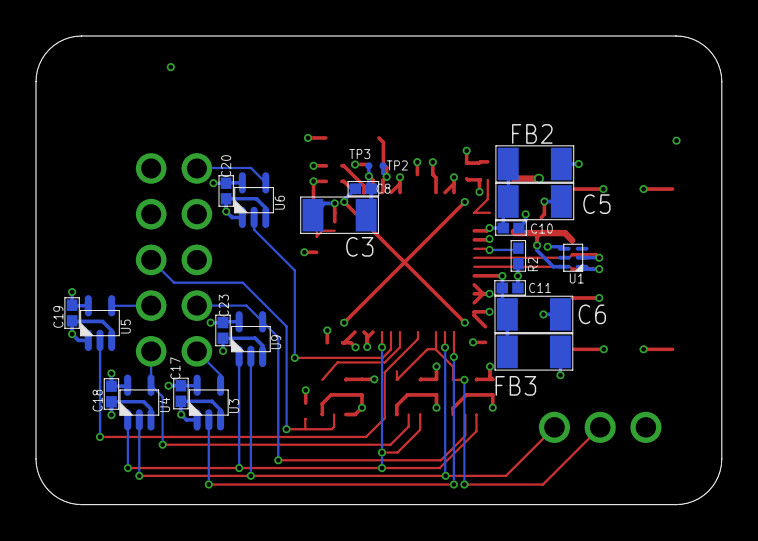
[picture p34: board Programmer.brd from below]

Board: 4 copper layers, 38.1 x 26.0 mm, 47 parts (22 on the bottom side), 27 nets.
