toasterllc/MDCCode/pcb/MotionDetectorCamera.brd

## EAGLE design pcb_/MotionDetectorCamera.brd (2020-08-12, an earlier design)

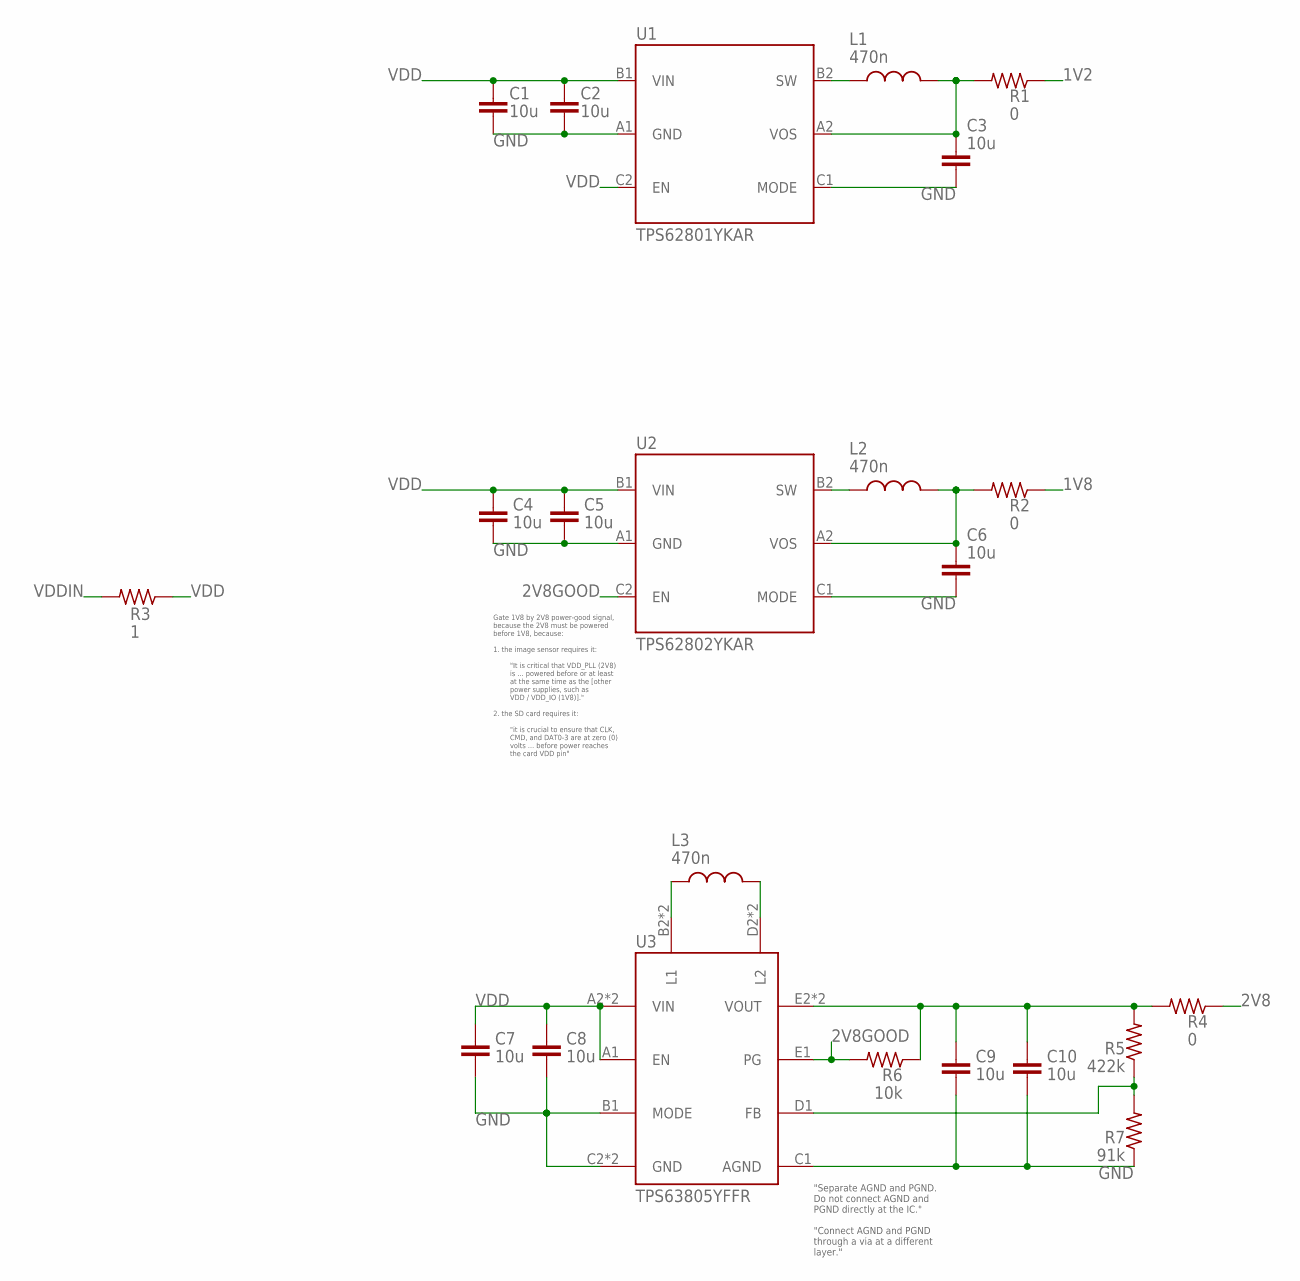
[picture p35: schematic MotionDetectorCamera.sch, sheet 1, Power]

Parts:
C1, C2, C3, C4, C5, C6, C7, C8, C9, C10: 10u; 0805
L1, L2, L3: 470n; 0806
R1, R2, R4: 0; 0805
R3: 1; 1206
R5: 422k; 0402
R6: 10k; 0402
R7: 91k; 0402
U1, U2: TI-TPS6280XYKAR
U3: TI-TPS63805YFFR

Connections:
1V2: R1.1; also elsewhere on the board
1V8: R2.1; also elsewhere on the board
2V8: R4.1; also elsewhere on the board
2V8GOOD: R6.2, U2.C2 (EN), U3.E1 (PG)
GND: C1.2, C2.2, C3.2, C4.2, C5.2, C6.2, C7.2, C8.2, C9.2, C10.2, R7.1, U1.A1 (GND), U1.C1 (MODE), U2.A1 (GND), U2.C1 (MODE), U3.B1 (MODE), U3.C1 (AGND), U3.C2 (GND), U3.C3 (GND); also elsewhere on the board
unnamed: L2.1, U2.B2 (SW)
unnamed: L1.1, U1.B2 (SW)
unnamed: C6.1, L2.2, R2.2, U2.A2 (VOS)
unnamed: R5.1, R7.2, U3.D1 (FB)
unnamed: L3.1, U3.B2 (L1), U3.B3 (L1)
unnamed: L3.2, U3.D2 (L2), U3.D3 (L2)
unnamed: C3.1, L1.2, R1.2, U1.A2 (VOS)
unnamed: C9.1, C10.1, R4.2, R5.2, R6.1, U3.E2 (VOUT), U3.E3 (VOUT)
VDD: C1.1, C2.1, C4.1, C5.1, C7.1, C8.1, R3.1, U1.B1 (VIN), U1.C2 (EN), U2.B1 (VIN), U3.A1 (EN), U3.A2 (VIN), U3.A3 (VIN)
VDDIN: R3.2; also elsewhere on the board

Notes on the sheet:
Gate 1V8 by 2V8 power-good signal, because the 2V8 must be powered before 1V8, because: 1. the image sensor requires it: "It is critical that VDD_PLL (2V8) is ... powered before or at least at the same time as the [other power supplies, such as VDD / VDD_IO (1V8)]." 2. the SD card requires it: "it 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
"Separate AGND and PGND. Do not connect AGND and PGND directly at the IC." "Connect AGND and PGND through a via at a different layer."
