toasterllc/MDCCode/pcb/MotionDetectorCamera.brd

## EAGLE design pcb_/MotionDetectorCamera.brd (continued)

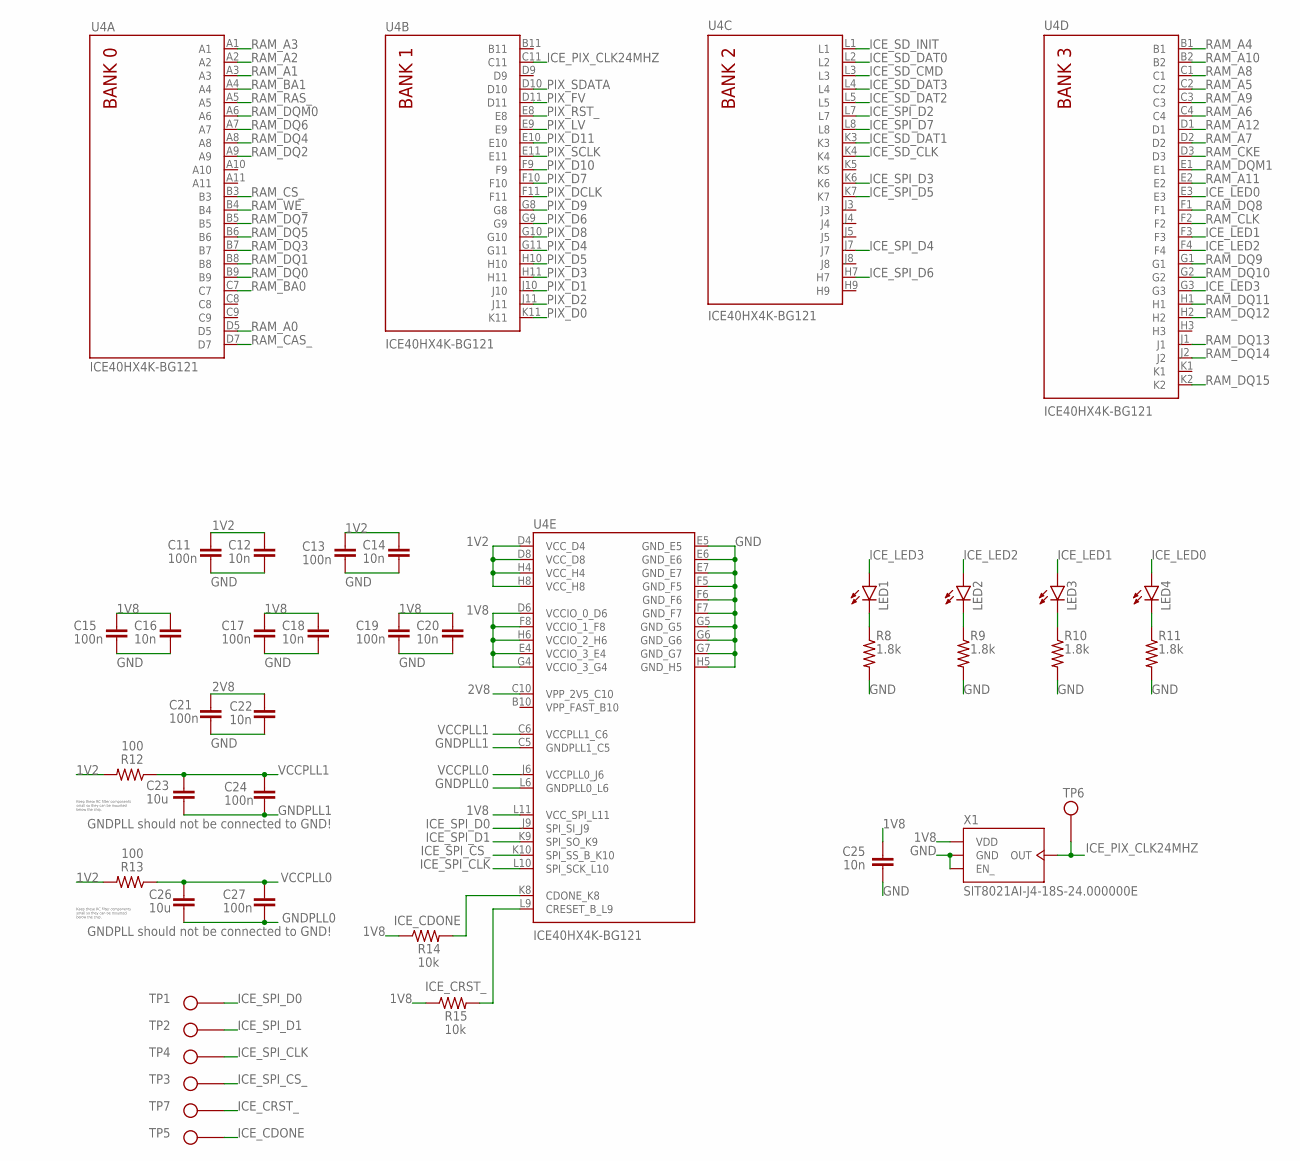
[picture p36: schematic MotionDetectorCamera.sch, sheet 2, ICE40]

Parts:
C11, C13, C15, C17, C19, C21, C24, C27: 100n; 0402
C12, C14, C16, C18, C20, C22, C25: 10n; 0402
C23, C26: 10u; 0805
LED1, LED2, LED3, LED4: LED; LED-0603
R8, R9, R10, R11: 1.8k; 0402
R12, R13: 100; 0402
R14, R15: 10k; 0402
TP1, TP2, TP3, TP4, TP5, TP6, TP7: TEST-POINT
U4: LATTICE-ICE40HX4K-BG121
X1: SITIME-SIT8021

Connections:
1V2: C11.1, C12.1, C13.1, C14.1, R12.2, R13.2, U4.D4 (VCC_D4), U4.D8 (VCC_D8), U4.H4 (VCC_H4), U4.H8 (VCC_H8); also elsewhere on the board
1V8: C15.1, C16.1, C17.1, C18.1, C19.1, C20.1, C25.1, R14.1, R15.1, U4.D6 (VCCIO_0_D6), U4.E4 (VCCIO_3_E4), U4.F8 (VCCIO_1_F8), U4.G4 (VCCIO_3_G4), U4.H6 (VCCIO_2_H6), U4.L11 (VCC_SPI_L11), X1.3 (VDD); also elsewhere on the board
2V8: C21.1, C22.1, U4.C10 (VPP_2V5_C10); also elsewhere on the board
GND: C11.2, C12.2, C13.2, C14.2, C15.2, C16.2, C17.2, C18.2, C19.2, C20.2, C21.2, C22.2, C25.2, R8.2, R9.2, R10.2, R11.2, U4.E5 (GND_E5), U4.E6 (GND_E6), U4.E7 (GND_E7), U4.F5 (GND_F5), U4.F6 (GND_F6), U4.F7 (GND_F7), U4.G5 (GND_G5), U4.G6 (GND_G6), U4.G7 (GND_G7), U4.H5 (GND_H5), X1.1 (EN_), X1.4 (GND); also elsewhere on the board
GNDPLL0: C26.2, C27.2, U4.L6 (GNDPLL0_L6)
GNDPLL1: C23.2, C24.2, U4.C5 (GNDPLL1_C5)
ICE_CDONE: R14.2, TP5.X, U4.K8 (CDONE_K8); also elsewhere on the board
ICE_CRST_: R15.2, TP7.X, U4.L9 (CRESET_B_L9); also elsewhere on the board
ICE_LED0: LED4.A, U4.E3
ICE_LED1: LED3.A, U4.F3
ICE_LED2: LED2.A, U4.F4
ICE_LED3: LED1.A, U4.G3
ICE_PIX_CLK24MHZ: TP6.X, U4.C11, X1.2 (OUT); also elsewhere on the board
ICE_SD_CLK: U4.K4; also elsewhere on the board
ICE_SD_CMD: U4.L3; also elsewhere on the board
ICE_SD_DAT0: U4.L2; also elsewhere on the board
ICE_SD_DAT1: U4.K3; also elsewhere on the board
ICE_SD_DAT2: U4.L5; also elsewhere on the board
ICE_SD_DAT3: U4.L4; also elsewhere on the board
ICE_SD_INIT: U4.L1; also elsewhere on the board
ICE_SPI_CLK: TP4.X, U4.L10 (SPI_SCK_L10); also elsewhere on the board
ICE_SPI_CS_: TP3.X, U4.K10 (SPI_SS_B_K10); also elsewhere on the board
ICE_SPI_D0: TP1.X, U4.J9 (SPI_SI_J9); also elsewhere on the board
ICE_SPI_D1: TP2.X, U4.K9 (SPI_SO_K9); also elsewhere on the board
ICE_SPI_D2: U4.L7; also elsewhere on the board
ICE_SPI_D3: U4.K6; also elsewhere on the board
ICE_SPI_D4: U4.J7; also elsewhere on the board
ICE_SPI_D5: U4.K7; also elsewhere on the board
ICE_SPI_D6: U4.H7; also elsewhere on the board
ICE_SPI_D7: U4.L8; also elsewhere on the board
unnamed: LED4.C, R11.1
unnamed: LED3.C, R10.1
unnamed: LED2.C, R9.1
unnamed: LED1.C, R8.1
PIX_D0: U4.K11; also elsewhere on the board
PIX_D1: U4.J10; also elsewhere on the board
PIX_D2: U4.J11; also elsewhere on the board
PIX_D3: U4.H11; also elsewhere on the board
PIX_D4: U4.G11; also elsewhere on the board
PIX_D5: U4.H10; also elsewhere on the board
PIX_D6: U4.G9; also elsewhere on the board
PIX_D7: U4.F10; also elsewhere on the board
PIX_D8: U4.G10; also elsewhere on the board
PIX_D9: U4.G8; also elsewhere on the board
PIX_D10: U4.F9; also elsewhere on the board
PIX_D11: U4.E10; also elsewhere on the board
PIX_DCLK: U4.F11; also elsewhere on the board
PIX_FV: U4.D11; also elsewhere on the board
PIX_LV: U4.E9; also elsewhere on the board
PIX_RST_: U4.E8; also elsewhere on the board
PIX_SCLK: U4.E11; also elsewhere on the board
PIX_SDATA: U4.D10; also elsewhere on the board
RAM_A0: U4.D5; also elsewhere on the board
RAM_A1: U4.A3; also elsewhere on the board
RAM_A2: U4.A2; also elsewhere on the board
RAM_A3: U4.A1; also elsewhere on the board
RAM_A4: U4.B1; also elsewhere on the board
RAM_A5: U4.C2; also elsewhere on the board
RAM_A6: U4.C4; also elsewhere on the board
RAM_A7: U4.D2; also elsewhere on the board
RAM_A8: U4.C1; also elsewhere on the board
RAM_A9: U4.C3; also elsewhere on the board
RAM_A10: U4.B2; also elsewhere on the board
RAM_A11: U4.E2; also elsewhere on the board
RAM_A12: U4.D1; also elsewhere on the board
RAM_BA0: U4.C7; also elsewhere on the board
RAM_BA1: U4.A4; also elsewhere on the board
RAM_CAS_: U4.D7; also elsewhere on the board
RAM_CKE: U4.D3; also elsewhere on the board
RAM_CLK: U4.F2; also elsewhere on the board
RAM_CS_: U4.B3; also elsewhere on the board
RAM_DQ0: U4.B9; also elsewhere on the board
RAM_DQ1: U4.B8; also elsewhere on the board
RAM_DQ2: U4.A9; also elsewhere on the board
RAM_DQ3: U4.B7; also elsewhere on the board
RAM_DQ4: U4.A8; also elsewhere on the board
RAM_DQ5: U4.B6; also elsewhere on the board
RAM_DQ6: U4.A7; also elsewhere on the board
RAM_DQ7: U4.B5; also elsewhere on the board
RAM_DQ8: U4.F1; also elsewhere on the board
RAM_DQ9: U4.G1; also elsewhere on the board
RAM_DQ10: U4.G2; also elsewhere on the board
RAM_DQ11: U4.H1; also elsewhere on the board
RAM_DQ12: U4.H2; also elsewhere on the board
RAM_DQ13: U4.J1; also elsewhere on the board
RAM_DQ14: U4.J2; also elsewhere on the board
RAM_DQ15: U4.K2; also elsewhere on the board
RAM_DQM0: U4.A6; also elsewhere on the board
RAM_DQM1: U4.E1; also elsewhere on the board
RAM_RAS_: U4.A5; also elsewhere on the board
RAM_WE_: U4.B4; also elsewhere on the board
VCCPLL0: C26.1, C27.1, R13.1, U4.J6 (VCCPLL0_J6)
VCCPLL1: C23.1, C24.1, R12.1, U4.C6 (VCCPLL1_C6)

Notes on the sheet:
GNDPLL should not be connected to GND!
Keep these RC filter components small so they can be mounted below the chip.

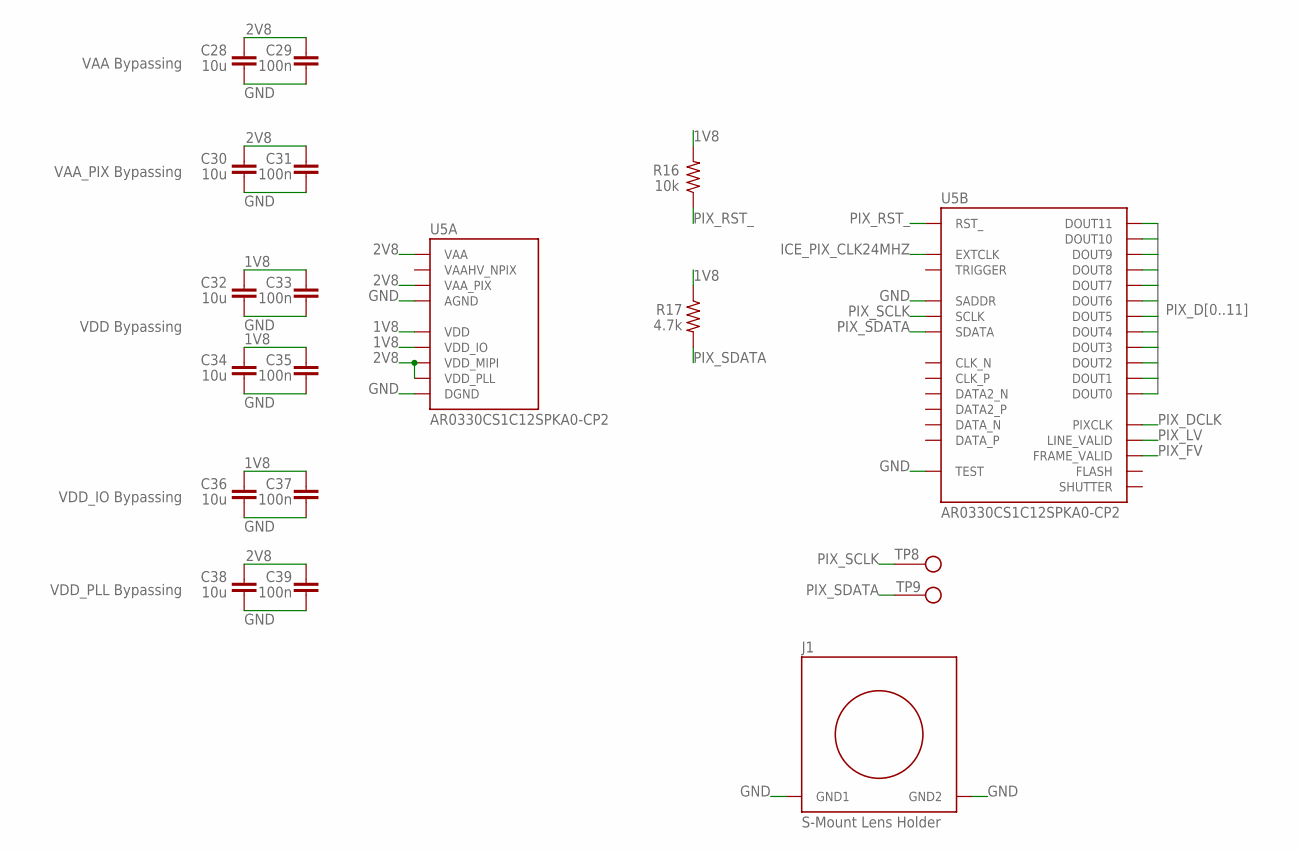
[picture p37: schematic MotionDetectorCamera.sch, sheet 3, Image Sensor]

Parts:
C28, C30, C32, C34, C36, C38: 10u; 0805
C29, C31, C33, C35, C37, C39: 100n; 0402
J1: S-MOUNT-LENS-HOLDER
R16: 10k; 0402
R17: 4.7k; 0402
TP8, TP9: TEST-POINT
U5: ON-AR0330CS1C12SPKA0

Connections:
1V8: C32.1, C33.1, C34.1, C35.1, C36.1, C37.1, R16.2, R17.1, U5.A7 (VDD_IO), U5.A8 (VDD), U5.B1 (VDD), U5.D2 (VDD_IO), U5.D5 (VDD_IO), U5.D6 (VDD_IO), U5.E5 (VDD_IO), U5.F6 (VDD_IO), U5.G2 (VDD), U5.G8 (VDD), U5.H5 (VDD_IO); also elsewhere on the board
2V8: C28.1, C29.1, C30.1, C31.1, C38.1, C39.1, U5.A1 (VAA), U5.A5 (VAA_PIX), U5.A6 (VAA), U5.F8 (VDD_PLL), U5.H6 (VDD_MIPI), U5.H8 (VDD_MIPI); also elsewhere on the board
GND: C28.2, C29.2, C30.2, C31.2, C32.2, C33.2, C34.2, C35.2, C36.2, C37.2, C38.2, C39.2, J1.1 (GND1), J1.2 (GND2), U5.A3 (AGND), U5.B4 (DGND), U5.B5 (AGND), U5.B6 (DGND), U5.B7 (TEST), U5.C1 (SADDR), U5.C4 (DGND), U5.C5 (DGND), U5.C6 (DGND), U5.D4 (DGND), U5.E6 (DGND), U5.G1 (DGND), U5.H2 (DGND), U5.H3 (DGND); also elsewhere on the board
ICE_PIX_CLK24MHZ: U5.D7 (EXTCLK); also elsewhere on the board
PIX_D0: U5.G6 (DOUT0); also elsewhere on the board
PIX_D1: U5.G5 (DOUT1); also elsewhere on the board
PIX_D2: U5.H4 (DOUT2); also elsewhere on the board
PIX_D3: U5.G4 (DOUT3); also elsewhere on the board
PIX_D4: U5.F5 (DOUT4); also elsewhere on the board
PIX_D5: U5.G3 (DOUT5); also elsewhere on the board
PIX_D6: U5.F4 (DOUT6); also elsewhere on the board
PIX_D7: U5.E4 (DOUT7); also elsewhere on the board
PIX_D8: U5.F3 (DOUT8); also elsewhere on the board
PIX_D9: U5.E3 (DOUT9); also elsewhere on the board
PIX_D10: U5.D3 (DOUT10); also elsewhere on the board
PIX_D11: U5.E2 (DOUT11); also elsewhere on the board
PIX_DCLK: U5.E1 (PIXCLK); also elsewhere on the board
PIX_FV: U5.B3 (FRAME_VALID); also elsewhere on the board
PIX_LV: U5.C3 (LINE_VALID); also elsewhere on the board
PIX_RST_: R16.1, U5.C8 (RST_); also elsewhere on the board
PIX_SCLK: TP8.X, U5.D1 (SCLK); also elsewhere on the board
PIX_SDATA: R17.2, TP9.X, U5.B2 (SDATA); also elsewhere on the board

Notes on the sheet:
VAA Bypassing
VAA_PIX Bypassing
VDD Bypassing
VDD_IO Bypassing
VDD_PLL Bypassing

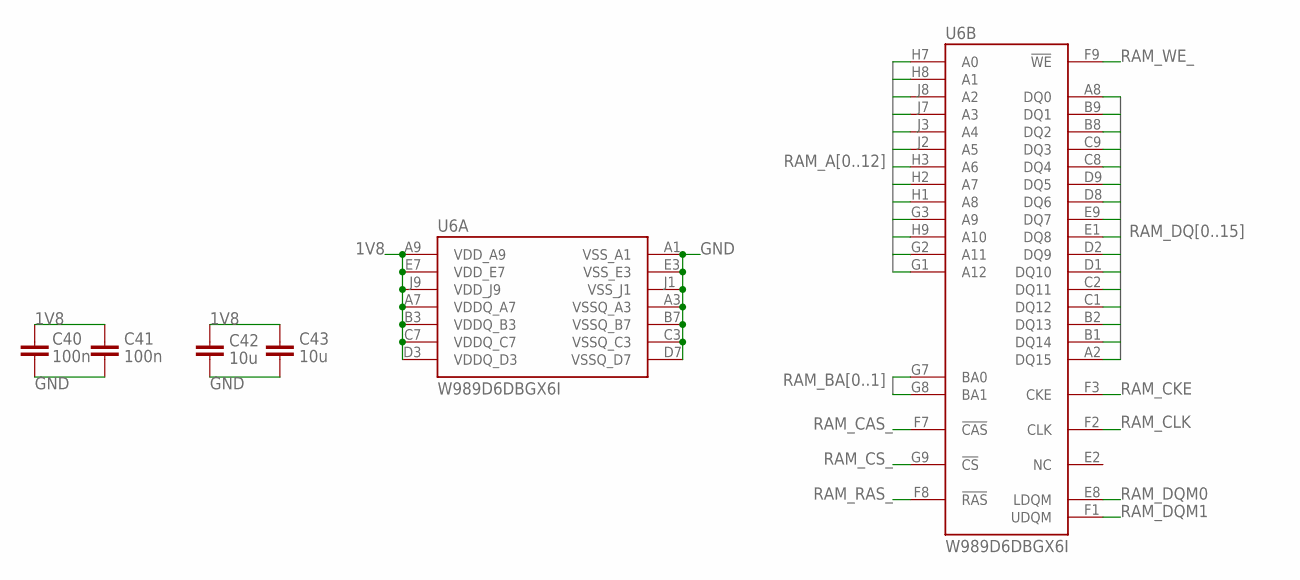
[picture p38: schematic MotionDetectorCamera.sch, sheet 4, RAM]

Parts:
C40, C41: 100n; 0402
C42, C43: 10u; 0805
U6: W989D6DBGX6I

Connections:
1V8: C40.1, C41.1, C42.1, C43.1, U6.A7 (VDDQ_A7), U6.A9 (VDD_A9), U6.B3 (VDDQ_B3), U6.C7 (VDDQ_C7), U6.D3 (VDDQ_D3), U6.E7 (VDD_E7), U6.J9 (VDD_J9); also elsewhere on the board
GND: C40.2, C41.2, C42.2, C43.2, U6.A1 (VSS_A1), U6.A3 (VSSQ_A3), U6.B7 (VSSQ_B7), U6.C3 (VSSQ_C3), U6.D7 (VSSQ_D7), U6.E3 (VSS_E3), U6.J1 (VSS_J1); also elsewhere on the board
RAM_A0: U6.H7 (A0); also elsewhere on the board
RAM_A1: U6.H8 (A1); also elsewhere on the board
RAM_A2: U6.J8 (A2); also elsewhere on the board
RAM_A3: U6.J7 (A3); also elsewhere on the board
RAM_A4: U6.J3 (A4); also elsewhere on the board
RAM_A5: U6.J2 (A5); also elsewhere on the board
RAM_A6: U6.H3 (A6); also elsewhere on the board
RAM_A7: U6.H2 (A7); also elsewhere on the board
RAM_A8: U6.H1 (A8); also elsewhere on the board
RAM_A9: U6.G3 (A9); also elsewhere on the board
RAM_A10: U6.H9 (A10); also elsewhere on the board
RAM_A11: U6.G2 (A11); also elsewhere on the board
RAM_A12: U6.G1 (A12); also elsewhere on the board
RAM_BA0: U6.G7 (BA0); also elsewhere on the board
RAM_BA1: U6.G8 (BA1); also elsewhere on the board
RAM_CAS_: U6.F7 (!CAS!); also elsewhere on the board
RAM_CKE: U6.F3 (CKE); also elsewhere on the board
RAM_CLK: U6.F2 (CLK); also elsewhere on the board
RAM_CS_: U6.G9 (!CS!); also elsewhere on the board
RAM_DQ0: U6.A8 (DQ0); also elsewhere on the board
RAM_DQ1: U6.B9 (DQ1); also elsewhere on the board
RAM_DQ2: U6.B8 (DQ2); also elsewhere on the board
RAM_DQ3: U6.C9 (DQ3); also elsewhere on the board
RAM_DQ4: U6.C8 (DQ4); also elsewhere on the board
RAM_DQ5: U6.D9 (DQ5); also elsewhere on the board
RAM_DQ6: U6.D8 (DQ6); also elsewhere on the board
RAM_DQ7: U6.E9 (DQ7); also elsewhere on the board
RAM_DQ8: U6.E1 (DQ8); also elsewhere on the board
RAM_DQ9: U6.D2 (DQ9); also elsewhere on the board
RAM_DQ10: U6.D1 (DQ10); also elsewhere on the board
RAM_DQ11: U6.C2 (DQ11); also elsewhere on the board
RAM_DQ12: U6.C1 (DQ12); also elsewhere on the board
RAM_DQ13: U6.B2 (DQ13); also elsewhere on the board
RAM_DQ14: U6.B1 (DQ14); also elsewhere on the board
RAM_DQ15: U6.A2 (DQ15); also elsewhere on the board
RAM_DQM0: U6.E8 (LDQM); also elsewhere on the board
RAM_DQM1: U6.F1 (UDQM); also elsewhere on the board
RAM_RAS_: U6.F8 (!RAS!); also elsewhere on the board
RAM_WE_: U6.F9 (!WE!); also elsewhere on the board

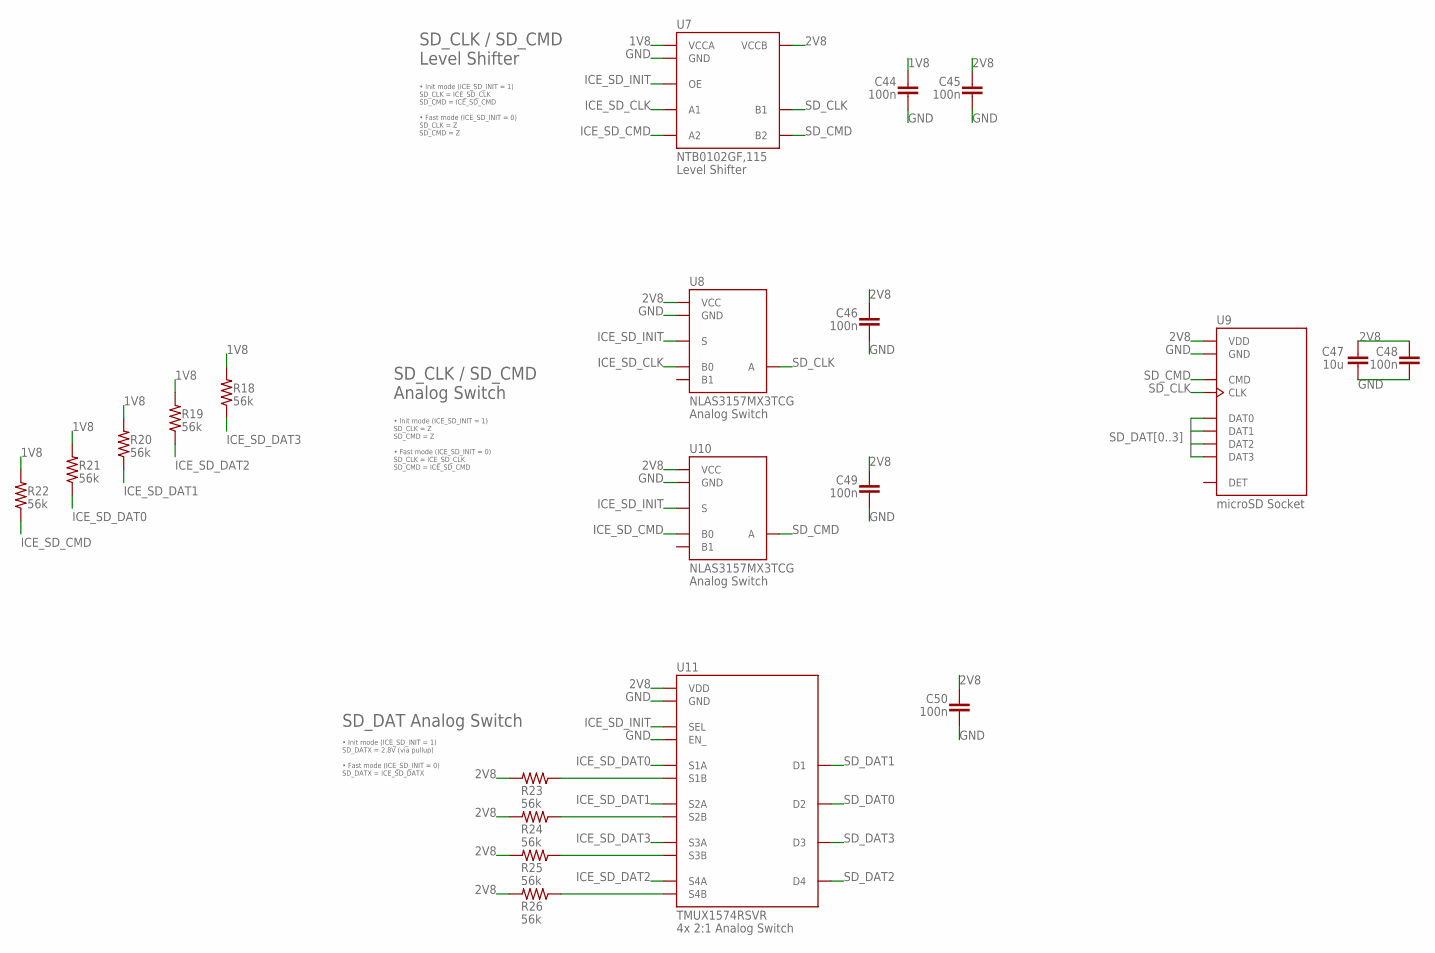
[picture p39: schematic MotionDetectorCamera.sch, sheet 5, SD Card]

Parts:
C44, C45, C46, C48, C49, C50: 100n; 0402
C47: 10u; 0805
R18, R19, R20, R21, R22, R23, R24, R25, R26: 56k; 0402
U7: NXP-NTB0102; NXP-NTB0102GF
U8, U10: ON-NLAS3157; ON-NLAS3157MX3TCG
U9: MICROSD-SOCKET; MOLEX-1051620001
U11: TI-TMUX1574; TI-TMUX1574RSVR

Connections:
1V8: C44.1, R18.2, R19.2, R20.2, R21.2, R22.2, U7.3 (VCCA); also elsewhere on the board
2V8: C45.1, C46.1, C47.1, C48.1, C49.1, C50.1, R23.2, R24.2, R25.2, R26.2, U7.7 (VCCB), U8.1 (VCC), U9.VDD, U10.1 (VCC), U11.14 (VDD); also elsewhere on the board
GND: C44.2, C45.2, C46.2, C47.2, C48.2, C49.2, C50.2, U7.2 (GND), U8.5 (GND), U9.GND1 (GND), U9.GND2 (GND), U9.GND3 (GND), U9.GND4 (GND), U9.VSS (GND), U10.5 (GND), U11.6 (GND), U11.13 (EN_); also elsewhere on the board
ICE_SD_CLK: U7.5 (A1), U8.4 (B0); also elsewhere on the board
ICE_SD_CMD: R22.1, U7.4 (A2), U10.4 (B0); also elsewhere on the board
ICE_SD_DAT0: R21.1, U11.16 (S1A); also elsewhere on the board
ICE_SD_DAT1: R20.1, U11.3 (S2A); also elsewhere on the board
ICE_SD_DAT2: R19.1, U11.12 (S4A); also elsewhere on the board
ICE_SD_DAT3: R18.1, U11.9 (S3A); also elsewhere on the board
ICE_SD_INIT: U7.6 (OE), U8.6 (S), U10.6 (S), U11.15 (SEL); also elsewhere on the board
unnamed: R23.1, U11.1 (S1B)
unnamed: R24.1, U11.4 (S2B)
unnamed: R26.1, U11.11 (S4B)
unnamed: R25.1, U11.8 (S3B)
SD_CLK: U7.8 (B1), U8.3 (A), U9.CLK
SD_CMD: U7.1 (B2), U9.CMD, U10.3 (A)
SD_DAT0: U9.DAT0, U11.5 (D2)
SD_DAT1: U9.DAT1, U11.2 (D1)
SD_DAT2: U9.DAT2, U11.10 (D4)
SD_DAT3: U9.DAT3, U11.7 (D3)

Notes on the sheet:
• Init mode (ICE_SD_INIT = 1) SD_DATX = 2.8V (via pullup) • Fast mode (ICE_SD_INIT = 0) SD_DATX = ICE_SD_DATX
SD_DAT Analog Switch
SD_CLK / SD_CMD Analog Switch
• Init mode (ICE_SD_INIT = 1) SD_CLK = Z SD_CMD = Z • Fast mode (ICE_SD_INIT = 0) SD_CLK = ICE_SD_CLK SD_CMD = ICE_SD_CMD
SD_CLK / SD_CMD Level Shifter
• Init mode (ICE_SD_INIT = 1) SD_CLK = ICE_SD_CLK SD_CMD = ICE_SD_CMD • Fast mode (ICE_SD_INIT = 0) SD_CLK = Z SD_CMD = Z

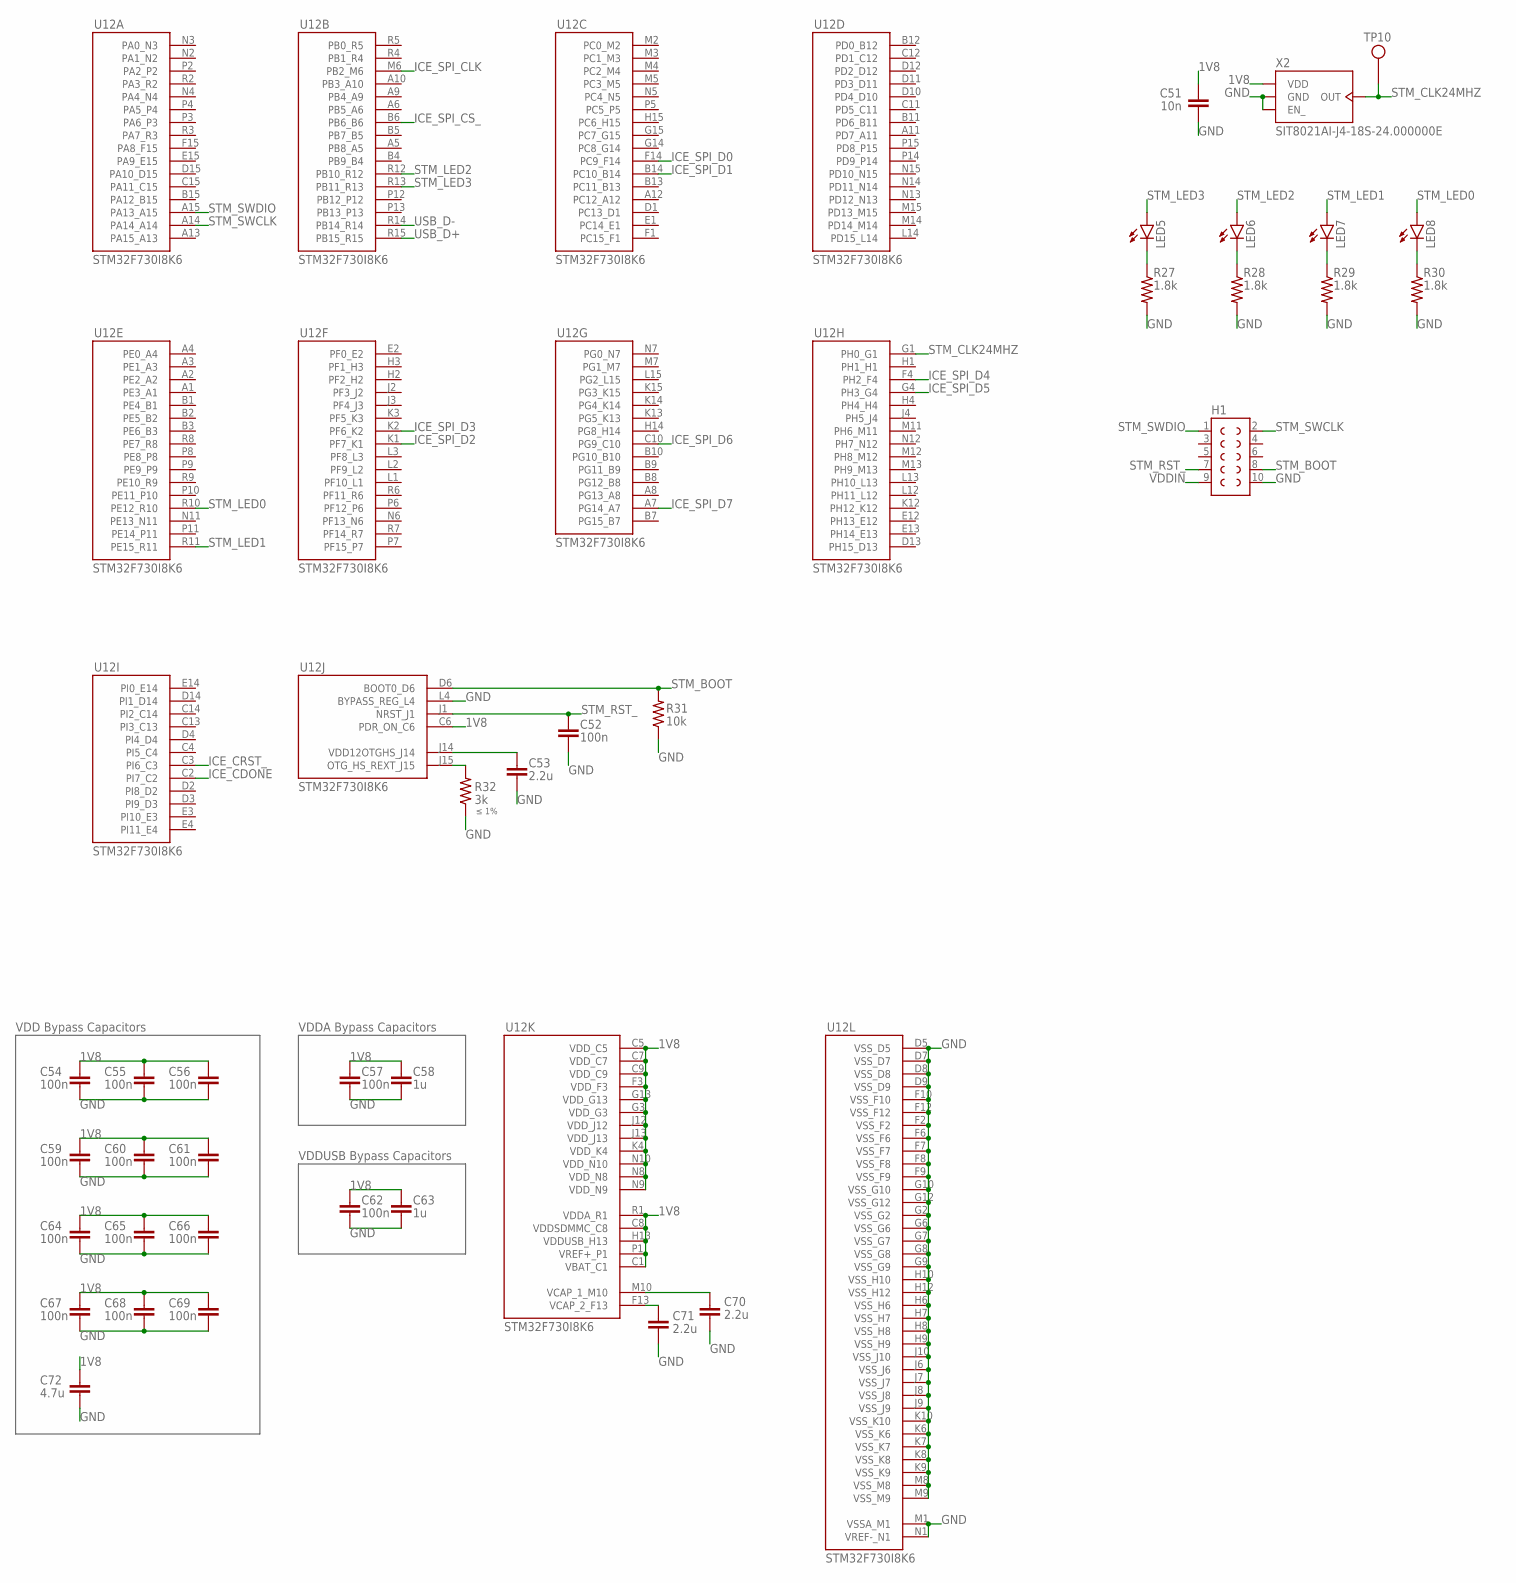
[picture p40: schematic MotionDetectorCamera.sch, sheet 6, STM32]

Parts:
C51: 10n; 0402
C52, C54, C55, C56, C57, C59, C60, C61, C62, C64, C65, C66, C67, C68, C69: 100n; 0402
C53, C70, C71: 2.2u; 0402
C58, C63: 1u; 0402
C72: 4.7u; 0603
H1: HEADER-2X5; TEC-1-2314844-0
LED5, LED6, LED7, LED8: LED; LED-0603
R27, R28, R29, R30: 1.8k; 0402
R31: 10k; 0402
R32: 3k; 0402
TP10: TEST-POINT
U12: STM-STM32F730; STM-STM32F730I8
X2: SITIME-SIT8021

Connections:
1V8: C51.1, C54.1, C55.1, C56.1, C57.1, C58.1, C59.1, C60.1, C61.1, C62.1, C63.1, C64.1, C65.1, C66.1, C67.1, C68.1, C69.1, C72.1, U12.C1 (VBAT_C1), U12.C5 (VDD_C5), U12.C6 (PDR_ON_C6), U12.C7 (VDD_C7), U12.C8 (VDDSDMMC_C8), U12.C9 (VDD_C9), U12.F3 (VDD_F3), U12.G3 (VDD_G3), U12.G13 (VDD_G13), U12.H13 (VDDUSB_H13), U12.J12 (VDD_J12), U12.J13 (VDD_J13), U12.K4 (VDD_K4), U12.N8 (VDD_N8), U12.N9 (VDD_N9), U12.N10 (VDD_N10), U12.P1 (VREF+_P1), U12.R1 (VDDA_R1), X2.3 (VDD); also elsewhere on the board
GND: C51.2, C52.2, C53.2, C54.2, C55.2, C56.2, C57.2, C58.2, C59.2, C60.2, C61.2, C62.2, C63.2, C64.2, C65.2, C66.2, C67.2, C68.2, C69.2, C70.2, C71.2, C72.2, H1.10, R27.2, R28.2, R29.2, R30.2, R31.1, R32.1, U12.D5 (VSS_D5), U12.D7 (VSS_D7), U12.D8 (VSS_D8), U12.D9 (VSS_D9), U12.F2 (VSS_F2), U12.F6 (VSS_F6), U12.F7 (VSS_F7), U12.F8 (VSS_F8), U12.F9 (VSS_F9), U12.F10 (VSS_F10), U12.F12 (VSS_F12), U12.G2 (VSS_G2), U12.G6 (VSS_G6), U12.G7 (VSS_G7), U12.G8 (VSS_G8), U12.G9 (VSS_G9), U12.G10 (VSS_G10), U12.G12 (VSS_G12), U12.H6 (VSS_H6), U12.H7 (VSS_H7), U12.H8 (VSS_H8), U12.H9 (VSS_H9), U12.H10 (VSS_H10), U12.H12 (VSS_H12), U12.J6 (VSS_J6), U12.J7 (VSS_J7), U12.J8 (VSS_J8), U12.J9 (VSS_J9), U12.J10 (VSS_J10), U12.K6 (VSS_K6), U12.K7 (VSS_K7), U12.K8 (VSS_K8), U12.K9 (VSS_K9), U12.K10 (VSS_K10), U12.L4 (BYPASS_REG_L4), U12.M1 (VSSA_M1), U12.M8 (VSS_M8), U12.M9 (VSS_M9), U12.N1 (VREF-_N1), X2.1 (EN_), X2.4 (GND); also elsewhere on the board
ICE_CDONE: U12.C2 (PI7_C2); also elsewhere on the board
ICE_CRST_: U12.C3 (PI6_C3); also elsewhere on the board
ICE_SPI_CLK: U12.M6 (PB2_M6); also elsewhere on the board
ICE_SPI_CS_: U12.B6 (PB6_B6); also elsewhere on the board
ICE_SPI_D0: U12.F14 (PC9_F14); also elsewhere on the board
ICE_SPI_D1: U12.B14 (PC10_B14); also elsewhere on the board
ICE_SPI_D2: U12.K1 (PF7_K1); also elsewhere on the board
ICE_SPI_D3: U12.K2 (PF6_K2); also elsewhere on the board
ICE_SPI_D4: U12.F4 (PH2_F4); also elsewhere on the board
ICE_SPI_D5: U12.G4 (PH3_G4); also elsewhere on the board
ICE_SPI_D6: U12.C10 (PG9_C10); also elsewhere on the board
ICE_SPI_D7: U12.A7 (PG14_A7); also elsewhere on the board
unnamed: LED5.C, R27.1
unnamed: C70.1, U12.M10 (VCAP_1_M10)
unnamed: LED6.C, R28.1
unnamed: C71.1, U12.F13 (VCAP_2_F13)
unnamed: R32.2, U12.J15 (OTG_HS_REXT_J15)
unnamed: LED7.C, R29.1
unnamed: C53.1, U12.J14 (VDD12OTGHS_J14)
unnamed: LED8.C, R30.1
STM_BOOT: H1.8, R31.2, U12.D6 (BOOT0_D6)
STM_CLK24MHZ: TP10.X, U12.G1 (PH0_G1), X2.2 (OUT)
STM_LED0: LED8.A, U12.R10 (PE12_R10)
STM_LED1: LED7.A, U12.R11 (PE15_R11)
STM_LED2: LED6.A, U12.R12 (PB10_R12)
STM_LED3: LED5.A, U12.R13 (PB11_R13)
STM_RST_: C52.1, H1.7, U12.J1 (NRST_J1)
STM_SWCLK: H1.2, U12.A14 (PA14_A14)
STM_SWDIO: H1.1, U12.A15 (PA13_A15)
USB_D+: U12.R15 (PB15_R15); also elsewhere on the board
USB_D-: U12.R14 (PB14_R14); also elsewhere on the board
VDDIN: H1.9; also elsewhere on the board

Notes on the sheet:
VDD Bypass Capacitors
VDDA Bypass Capacitors
VDDUSB Bypass Capacitors
≤ 1%

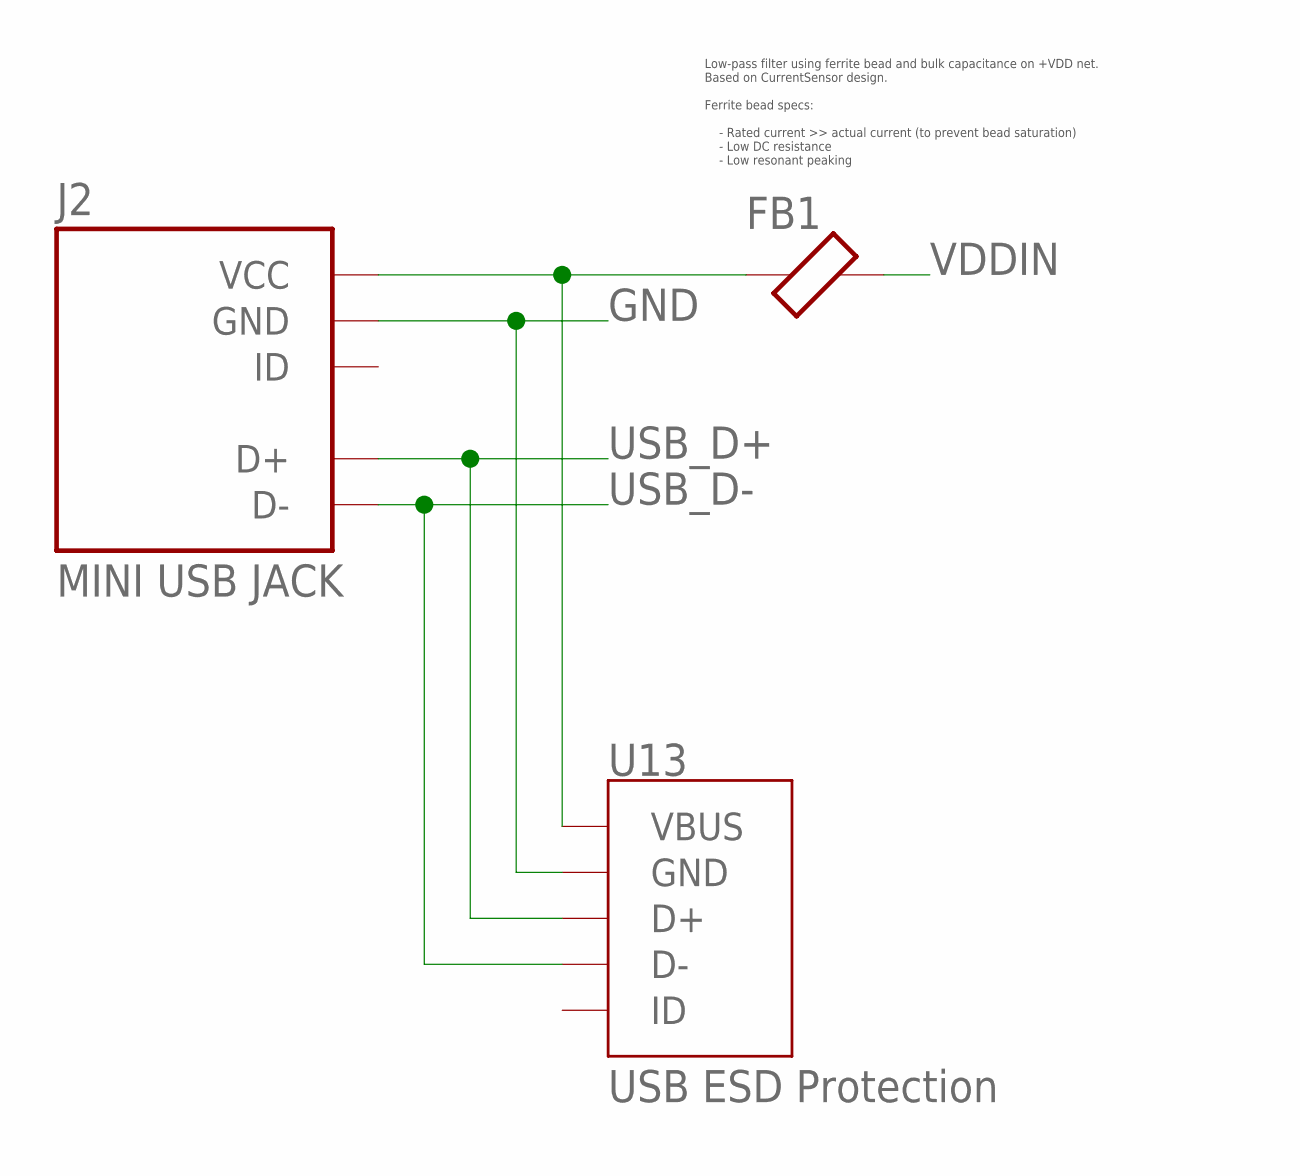
[picture p41: schematic MotionDetectorCamera.sch, sheet 7, USB]

Parts:
FB1: FERRITE-BEAD0402; 0402
J2: MINI-USB-JACK; AMPHENOLFCI-10033526-N3222MLF
U13: TI-TPD4S012DRYR

Connections:
GND: J2.GND, J2.GND2 (GND), J2.GND3 (GND), J2.GND4 (GND), J2.GND5 (GND), U13.4 (GND); also elsewhere on the board
unnamed: FB1.1, J2.VCC, U13.6 (VBUS)
USB_D+: J2.D+, U13.1 (D+); also elsewhere on the board
USB_D-: J2.D-, U13.2 (D-); also elsewhere on the board
VDDIN: FB1.2; also elsewhere on the board

Notes on the sheet:
Low-pass filter using ferrite bead and bulk capacitance on +VDD net. Based on CurrentSensor design. Ferrite bead specs: - Rated current >> actual current (to prevent bead saturation) - Low DC resistance - Low resonant peaking

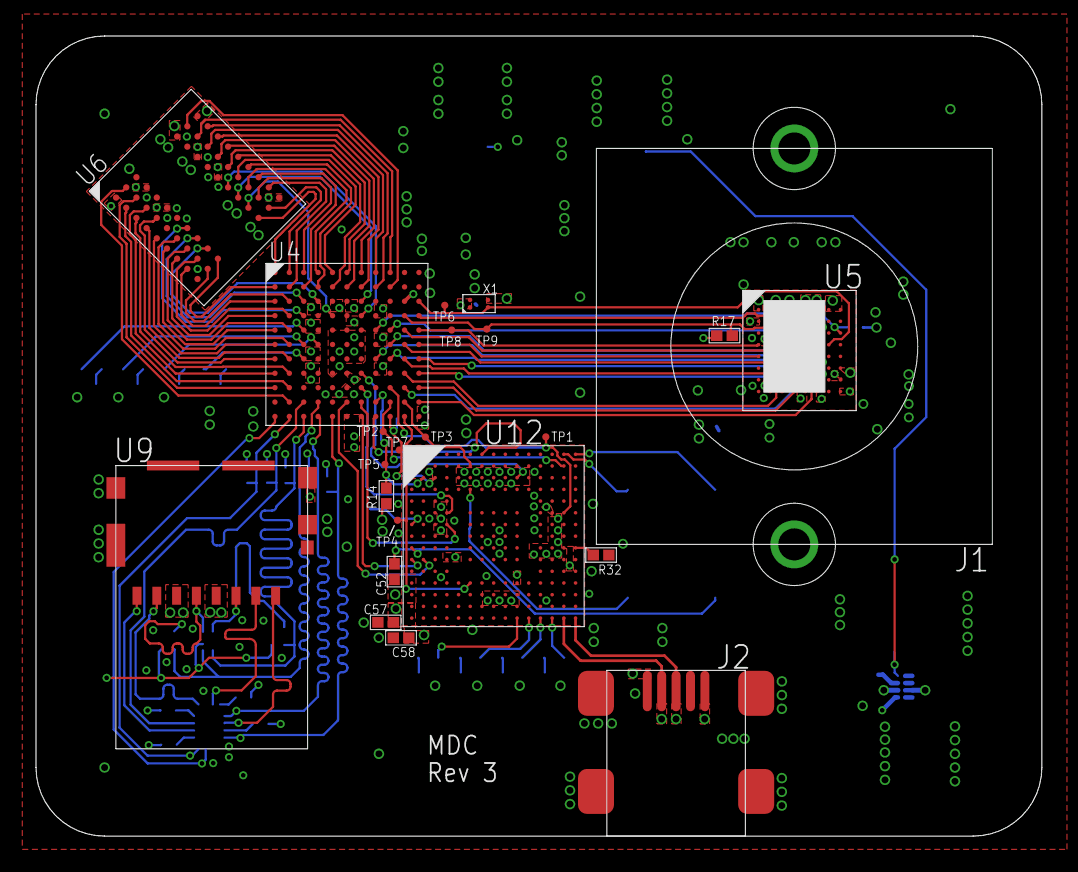
[picture p42: board pcb_/MotionDetectorCamera.brd from above]

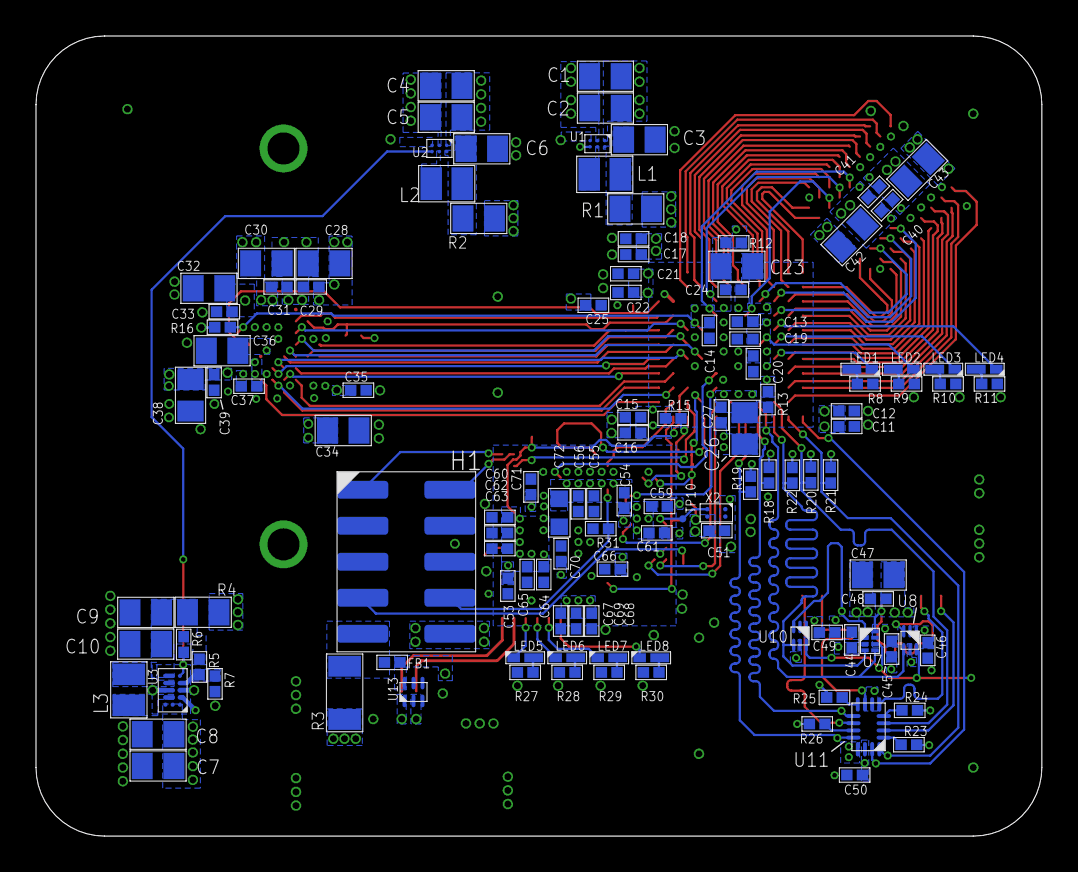
[picture p43: board pcb_/MotionDetectorCamera.brd from below]

Board: 4 copper layers, 55.9 x 44.5 mm, 144 parts (121 on the bottom side), 134 nets.
