toasterllc/MDCCode/Code/STM32/STMApp/STMApp.ioc

Mcu.UserName=STM32F730I8Kx
PB10.GPIO_Label=STM_LED2
PB10.Signal=GPIO_Output
PB11.GPIO_Label=STM_LED3
PB11.Signal=GPIO_Output
PB14.Signal=USB_OTG_HS_DM
PB15.Signal=USB_OTG_HS_DP
PB2.Signal=QUADSPI_CLK
PB6.Signal=QUADSPI_BK1_NCS
PC10.Signal=QUADSPI_BK1_IO1
PC9.Signal=QUADSPI_BK1_IO0
PE12.GPIO_Label=STM_LED0
PE12.Signal=GPIO_Output
PE15.GPIO_Label=STM_LED1
PE15.Signal=GPIO_Output
PF6.Signal=QUADSPI_BK1_IO3
PF7.Signal=QUADSPI_BK1_IO2
PG14.Signal=QUADSPI_BK2_IO3
PG9.Signal=QUADSPI_BK2_IO2
PH0-OSC_IN.Signal=RCC_OSC_IN
PH1-OSC_OUT.Signal=RCC_OSC_OUT
PH2.Signal=QUADSPI_BK2_IO0
PH3.Signal=QUADSPI_BK2_IO1
