toasterllc/MDCCode/Code/ICE40/Shared/ImgController.v

`ifndef ImgController_v
`define ImgController_v

`include "RAMController.v"
`include "TogglePulse.v"
`include "AFIFO.v"
`include "FletcherChecksum.v"
`include "Sync.v"

module ImgController #(
    parameter ClkFreq                   = 24_000_000,
    parameter HeaderWordCount           = 8,
    parameter ImgWidth                  = 4096,
    parameter ImgHeight                 = 4096,
    parameter PaddingWordCount          = 42,
    
    localparam HeaderWidth              = HeaderWordCount*16,
    localparam ImgPixelCount            = ImgWidth*ImgHeight,
    localparam ChecksumWordCount        = 2,
    localparam ChecksumWidth            = ChecksumWordCount*16,
    localparam ChecksumPaddingWordCount = PaddingWordCount+ChecksumWordCount
)(
    input wire          clk,
    
    // Command port (clock domain: `clk`)
    input wire          cmd_capture,    // Toggle signal
    input wire          cmd_readout,    // Toggle signal
    input wire[0:0]     cmd_ramBlock,   // Destination RAM block
    input wire[0:0]     cmd_skipCount,  // Number of image frames to skip
    input wire[HeaderWidth-1:0]
                        cmd_header,
    input wire          cmd_thumb,      // Thumbnail readout mode
    
    // Readout port (clock domain: `clk`)
    output reg          readout_rst = 0,
    output reg          readout_start = 0, // Toggle signal
    output reg          readout_ready = 0,
    input wire          readout_trigger,
    output reg[15:0]    readout_data = 0,
    output reg          readout_done = 0,
    
    // Status port (clock domain: `clk`)
    output reg          status_captureDone = 0, // Toggle signal
    output wire[`RegWidth(ImgPixelCount)-1:0]
                        status_capturePixelCount,
    output wire[17:0]   status_captureHighlightCount,
    output wire[17:0]   status_captureShadowCount,
    
    // Img port (clock domain: `img_dclk`)
    input wire          img_dclk,
    input wire[11:0]    img_d,
    input wire          img_fv,
    input wire          img_lv,
    
    // RAM port (clock domain: `ram_clk`)
    output wire         ram_clk,
    output wire         ram_cke,
    output wire[1:0]    ram_ba,
    output wire[11:0]   ram_a,
    output wire         ram_cs_,
    output wire         ram_ras_,
    output wire         ram_cas_,
    output wire         ram_we_,
    output wire[1:0]    ram_dqm,
    inout wire[15:0]    ram_dq
);
    // ====================
    // RAMController
    // ====================
    reg         ramctrl_cmd_block = 0;
    reg[1:0]    ramctrl_cmd = 0;
    wire        ramctrl_write_ready;
    wire        ramctrl_write_trigger;
    wire[15:0]  ramctrl_write_data;
    wire        ramctrl_read_ready;
    wire        ramctrl_read_trigger;
    wire[15:0]  ramctrl_read_data;
    
    RAMController #(
        .ClkFreq(ClkFreq),
        .BlockCount(2)
    ) RAMController (
        .clk(clk),
        
        .cmd(ramctrl_cmd),
        .cmd_block(ramctrl_cmd_block),
        
        .write_ready(ramctrl_write_ready),
        .write_trigger(ramctrl_write_trigger),
        .write_data(ramctrl_write_data),
        
        .read_ready(ramctrl_read_ready),
        .read_trigger(ramctrl_read_trigger),
        .read_data(ramctrl_read_data),
        
        .ram_clk(ram_clk),
        .ram_cke(ram_cke),
        .ram_ba(ram_ba),
        .ram_a(ram_a),
        .ram_cs_(ram_cs_),
        .ram_ras_(ram_ras_),
        .ram_cas_(ram_cas_),
        .ram_we_(ram_we_),
        .ram_dqm(ram_dqm),
        .ram_dq(ram_dq)
    );
    
    // ====================
    // Input FIFO (Pixels->RAM)
    // ====================
    reg fifoIn_rst = 0;
    wire fifoIn_w_clk;
    wire fifoIn_w_ready;
    reg fifoIn_w_trigger = 0;
    reg[15:0] fifoIn_w_data = 0;
    wire fifoIn_r_clk;
    wire fifoIn_r_ready;
    wire fifoIn_r_trigger;
    wire[15:0] fifoIn_r_data;
    
    AFIFO AFIFO_fifoIn(
        .rst_(!fifoIn_rst),
        
        .w_clk(fifoIn_w_clk),
        .w_ready(fifoIn_w_ready),
        .w_trigger(fifoIn_w_trigger),
        .w_data(fifoIn_w_data),
        
        .r_clk(clk),
        .r_ready(fifoIn_r_ready),
        .r_trigger(fifoIn_r_trigger),
        .r_data(fifoIn_r_data)
    );
    
    assign fifoIn_w_clk = img_dclk;
    assign fifoIn_r_clk = clk;
    
    // ====================
    // Pin: img_d
    // ====================
    genvar i;
    wire[11:0] img_d_reg;
    for (i=0; i<12; i=i+1) begin
        SB_IO #(
            .PIN_TYPE(6'b0000_00)
        ) SB_IO_img_d (
            .INPUT_CLK(img_dclk),
            .PACKAGE_PIN(img_d[i]),
            .D_IN_0(img_d_reg[i])
        );
    end
    
    // ====================
    // Pin: img_fv
    // ====================
    wire img_fv_reg;
    SB_IO #(
        .PIN_TYPE(6'b0000_00)
    ) SB_IO_img_fv (
        .INPUT_CLK(img_dclk),
        .PACKAGE_PIN(img_fv),
        .D_IN_0(img_fv_reg)
    );
    
    // ====================
    // Pin: img_lv
    // ====================
    wire img_lv_reg;
    SB_IO #(
        .PIN_TYPE(6'b0000_00)
    ) SB_IO_img_lv (
        .INPUT_CLK(img_dclk),
        .PACKAGE_PIN(img_lv),
        .D_IN_0(img_lv_reg)
    );
    
    // ====================
    // Pixel input state machine
    // ====================
    reg ctrl_fifoInCaptureTrigger = 0;
    `TogglePulse(fifoIn_captureTrigger, ctrl_fifoInCaptureTrigger, posedge, img_dclk);
    
    reg fifoIn_started = 0;
    `TogglePulse(ctrl_fifoInStarted, fifoIn_started, posedge, clk);
    
    reg[`RegWidth(ImgPixelCount)-1:0] fifoIn_pixelCount = 0;
    reg[17:0] fifoIn_highlightCount = 0;
    reg[17:0] fifoIn_shadowCount = 0;
    assign status_capturePixelCount = fifoIn_pixelCount;
    assign status_captureHighlightCount = fifoIn_highlightCount;
    assign status_captureShadowCount = fifoIn_shadowCount;
    
    wire fifoIn_lv = img_lv_reg;
    wire fifoIn_fv = img_fv_reg;
    reg fifoIn_lvPrev = 0;
    reg fifoIn_fvPrev = 0;
    reg[1:0] fifoIn_x = 0;
    reg[1:0] fifoIn_y = 0;
    reg fifoIn_countStat = 0;
    reg[11:0] fifoIn_countStatPx = 0;
    reg fifoIn_frameStart = 0;
    reg[$size(cmd_skipCount)-1:0] fifoIn_skipCount = 0;
    
    reg fifoIn_done = 0;
    `Sync(ctrl_fifoInDone, fifoIn_done, posedge, clk);
    
    reg[1:0] fifoIn_state = 0;
    always @(posedge img_dclk) begin
        fifoIn_rst <= 0; // Pulse
        fifoIn_lvPrev <= fifoIn_lv;
        fifoIn_fvPrev <= fifoIn_fv;
        fifoIn_w_trigger <= 0; // Pulse
        fifoIn_countStat <= 0; // Pulse
        
        fifoIn_w_data <= {{img_d_reg[7:0]}, {4'b0, img_d_reg[11:8]}}; // Little endian
        
        if (fifoIn_w_trigger) begin
            // Count the words in an image
            fifoIn_pixelCount <= fifoIn_pixelCount+1;
        end
        
        if (!fifoIn_lv) fifoIn_x <= 0;
        else            fifoIn_x <= fifoIn_x+1;
        
        if (!fifoIn_fv)                         fifoIn_y <= 0;
        else if (fifoIn_lvPrev && !fifoIn_lv)   fifoIn_y <= fifoIn_y+1;
        
        fifoIn_frameStart <= (!fifoIn_fvPrev && fifoIn_fv);
        
        if (fifoIn_w_trigger) begin
            $display("[ImgController:fifoIn] Wrote word into FIFO: %x", fifoIn_w_data);
        end
        
        // Count pixel stats (number of highlights/shadows)
        // We're pipelining `fifoIn_countStat` and `fifoIn_countStatPx` here for performance
        fifoIn_countStatPx <= img_d_reg;
        if (fifoIn_countStat) begin
            // Look at the high bits to determine if it's a highlight or shadow
            case (`LeftBits(fifoIn_countStatPx, 0, 7))
            // Highlight
            7'b111_1111:   fifoIn_highlightCount <= fifoIn_highlightCount+1;
            // Shadow
            7'b000_0000:   fifoIn_shadowCount <= fifoIn_shadowCount+1;
            endcase
        end
        
        case (fifoIn_state)
        // Idle: wait to be triggered
        0: begin
        end
        
        // Reset FIFO / ourself
        1: begin
            fifoIn_rst <= 1;
            fifoIn_done <= 0;
            fifoIn_pixelCount <= 0;
            fifoIn_highlightCount <= 0;
            fifoIn_shadowCount <= 0;
            fifoIn_started <= !fifoIn_started;
            fifoIn_skipCount <= cmd_skipCount;
            fifoIn_state <= 2;
        end
        
        // Wait for the frame to start
        2: begin
            if (fifoIn_frameStart) begin
                $display("[ImgController:fifoIn] Frame start");
                fifoIn_skipCount <= fifoIn_skipCount-1;
                if (!fifoIn_skipCount) begin
                    fifoIn_state <= 3;
                end
            end
        end
        
        // Wait until the end of the frame
        3: begin
            fifoIn_countStat <= (fifoIn_lv && !fifoIn_x && !fifoIn_y);
            fifoIn_w_trigger <= fifoIn_lv;
            if (!fifoIn_fv) begin
                $display("[ImgController:fifoIn] Frame end");
                fifoIn_done <= 1;
                fifoIn_state <= 0;
            end
        end
        endcase
        
        if (fifoIn_captureTrigger) begin
            fifoIn_state <= 1;
        end
    end
    
    // ====================
    // Readout Checksum
    // ====================
    wire        readout_checksum_clk;
    reg         readout_checksum_rst = 0;
    reg         readout_checksum_en = 0;
    reg         readout_checksum_trigger = 0;
    reg[15:0]   readout_checksum_din = 0;
    wire[31:0]  readout_checksum_dout;
    FletcherChecksum #(
        .Width(32)
    ) FletcherChecksum_readout(
        .clk    (readout_checksum_clk ),
        .rst    (readout_checksum_rst ),
        .en     (readout_checksum_en  ),
        .din    (readout_checksum_din ),
        .dout   (readout_checksum_dout)
    );
    
    assign readout_checksum_clk  = clk;
    // assign readout_checksum_din = {readout_data[7:0], readout_data[15:8]};
    // assign readout_checksum_doutLE = {
    //     // Little endian
    //     readout_checksum_dout[ 7-:8],
    //     readout_checksum_dout[15-:8],
    //     readout_checksum_dout[23-:8],
    //     readout_checksum_dout[31-:8]
    // };
    // // readout_checksum_din: treat `readout_data` values as little-endian when
    // // calculating the checksum, to match host behavior
    // assign readout_checksum_din  = {readout_data[7:0], readout_data[15:8]};
    
    // ====================
    // Control State Machine
    // ====================
    `TogglePulse(ctrl_cmdCapture, cmd_capture, posedge, clk);
    `TogglePulse(ctrl_cmdReadout, cmd_readout, posedge, clk);
    reg[`RegWidth(ImgWidth)-1:0] ctrl_readout_pixelX = 0;
    reg[`RegWidth(ImgHeight)-1:0] ctrl_readout_pixelY = 0;
    reg ctrl_readout_pixelFilterEn = 0;
    // ctrl_readout_pixelKeep: keep the pixel if filtering is disabled (ie non-thumbnail mode),
    // or if filtering is enabled and the pixel is in the upper-left 2x2 corner of any 8x8 group
    wire ctrl_readout_pixelKeep = (
        ((ctrl_readout_pixelX[2:0]===0 || ctrl_readout_pixelX[2:0]===1) &&
         (ctrl_readout_pixelY[2:0]===0 || ctrl_readout_pixelY[2:0]===1)) &&
         (ctrl_readout_pixelY !== ImgHeight)
    );
    
    reg[`RegWidth(ImgPixelCount-2)-1:0] ctrl_readout_pixelCount = 0;
    reg ctrl_readout_pixelDone = 0;
    wire ctrl_readout_dataLoad = (!readout_ready || readout_trigger);
    
    reg[31:0] ctrl_readout_checksum = 0;
    
    reg[HeaderWidth-1:0] ctrl_shiftout_data = 0;
    reg[`RegWidth2(HeaderWordCount-1,ChecksumPaddingWordCount-1)-1:0] ctrl_shiftout_count = 0;
    reg[`RegWidth(Ctrl_State_Count-1)-1:0] ctrl_shiftout_nextState = 0;
    
    reg[1:0] ctrl_delay_count = 0;
    reg[`RegWidth(Ctrl_State_Count-1)-1:0] ctrl_delay_nextState = 0;
    
    localparam Ctrl_State_Idle          = 0;  // +0
    localparam Ctrl_State_Capture       = 1;  // +3
    localparam Ctrl_State_Readout       = 5;  // +4
    localparam Ctrl_State_Shiftout      = 10; // +0
    localparam Ctrl_State_Delay         = 11; // +0
    localparam Ctrl_State_Count         = 12;
    reg[`RegWidth(Ctrl_State_Count-1)-1:0] ctrl_state = 0;
    always @(posedge clk) begin
        ramctrl_cmd <= `RAMController_Cmd_None;
        readout_rst <= 0; // Pulse
        readout_checksum_rst <= 0; // Pulse
        ctrl_delay_count <= ctrl_delay_count-1;
        
        if (ctrl_readout_dataLoad) begin
            ctrl_shiftout_data <= ctrl_shiftout_data<<16;
            ctrl_shiftout_count <= ctrl_shiftout_count-1;
        end
        
        if (readout_ready && readout_trigger) begin
            $display("[ImgController:Readout] readout_data: %x", readout_data);
        end
        
        // readout_checksum_din <= {readout_data[7:0], readout_data[15:8]};
        
        if (ctrl_readout_pixelFilterEn && ramctrl_read_ready && ramctrl_read_trigger) begin
            if (ctrl_readout_pixelX !== ImgWidth-1) begin
                ctrl_readout_pixelX <= ctrl_readout_pixelX+1;
            end else begin
                ctrl_readout_pixelX <= 0;
                ctrl_readout_pixelY <= ctrl_readout_pixelY+1;
            end
        end
        
        if (ramctrl_read_ready && ramctrl_read_trigger) begin
            ctrl_readout_pixelCount <= ctrl_readout_pixelCount-1;
            if (!ctrl_readout_pixelCount) begin
                ctrl_readout_pixelDone <= 1;
            end
        end
        
        // Reset readout_ready if the client consumes a value
        if (readout_trigger) begin
            readout_ready <= 0;
        end
        
        ctrl_readout_checksum <= readout_checksum_dout;
        readout_checksum_din <= {readout_data[7:0], readout_data[15:8]};
        readout_checksum_en <= readout_checksum_trigger; // Pulse
        readout_checksum_trigger <= 0; // Pulse
        
        
        case (ctrl_state)
        Ctrl_State_Idle: begin
            if (!readout_ready) begin
                readout_done <= 1;
            end
        end
        
        Ctrl_State_Capture: begin
            $display("[ImgController:Capture] Triggered");
            // Supply 'Write' RAM command
            ramctrl_cmd_block <= cmd_ramBlock;
            ramctrl_cmd <= `RAMController_Cmd_Write;
            $display("[ImgController:Capture] Waiting for RAMController to be ready to write...");
            ctrl_state <= Ctrl_State_Capture+1;
        end
        
        Ctrl_State_Capture+1: begin
            // Wait for the write command to be consumed, and for the RAMController
            // to be ready to write.
            // This is necessary because the RAMController/SDRAM takes some time to
            // initialize upon power on. If we attempted a capture during this time,
            // we'd drop most/all of the pixels because RAMController/SDRAM wouldn't
            // be ready to write yet.
            if (ramctrl_cmd===`RAMController_Cmd_None && ramctrl_write_ready) begin
                $display("[ImgController:Capture] Waiting for FIFO to reset...");
                // Start the FIFO data flow now that RAMController is ready to write
                ctrl_fifoInCaptureTrigger <= !ctrl_fifoInCaptureTrigger;
                ctrl_state <= Ctrl_State_Capture+2;
            end
        end
        
        Ctrl_State_Capture+2: begin
            // Wait for the fifoIn state machine to start
            if (ctrl_fifoInStarted) begin
                ctrl_state <= Ctrl_State_Capture+3;
            end
        end
        
        Ctrl_State_Capture+3: begin
            if (ctrl_fifoInDone) begin
                $display("[ImgController:Capture] Finished");
                status_captureDone <= !status_captureDone;
                ctrl_state <= Ctrl_State_Idle;
            end
        end
        
        Ctrl_State_Readout: begin // 5
            $display("[ImgController:Readout] Started");
            // Reset output FIFO
            readout_rst <= 1;
            // Reset done signal
            readout_done <= 0;
            // Reset RAMController because it could be in the middle of reading or writing if the client
            // interrupts us with a new command while one was underway.
            // If we don't do this, ramctrl_ signals leftover from the previous ImgController command
            // (eg ramctrl_read_ready) will interfere with the new command.
            ramctrl_cmd <= `RAMController_Cmd_Stop;
            // Delay one cycle before outputting the header, to ensure the FIFO is finished
            // resetting before we feed it data
            ctrl_delay_count <= 0;
            ctrl_delay_nextState <= Ctrl_State_Readout+1;
            ctrl_state <= Ctrl_State_Delay;
        end
        
        Ctrl_State_Readout+1: begin // 6
            // Reset checksum
            readout_checksum_rst <= 1;
            // Signal that readout is starting
            readout_start <= !readout_start;
            // Enable pixel filter if we're in thumbnail mode
            ctrl_readout_pixelFilterEn <= cmd_thumb;
            // Output the header
            ctrl_shiftout_data <= cmd_header;
            ctrl_shiftout_count <= HeaderWordCount-1;
            ctrl_shiftout_nextState <= Ctrl_State_Readout+2;
            ctrl_state <= Ctrl_State_Shiftout;
        end
        
        // Prepare to output pixels
        Ctrl_State_Readout+2: begin // 7
            // Reset pixel counters used for thumbnailing
            ctrl_readout_pixelX <= 0;
            ctrl_readout_pixelY <= 0;
            ctrl_readout_pixelDone <= 0;
            ctrl_readout_pixelCount <= ImgPixelCount-2;
            // Supply 'Read' RAM command
            ramctrl_cmd_block <= cmd_ramBlock;
            ramctrl_cmd <= `RAMController_Cmd_Read;
            ctrl_state <= Ctrl_State_Readout+3;
        end
        
        // Output pixels
        Ctrl_State_Readout+3: begin // 8
            if (ramctrl_read_ready && ctrl_readout_dataLoad) begin
                readout_data <= ramctrl_read_data;
                readout_ready <= ctrl_readout_pixelKeep;
                readout_checksum_trigger <= ctrl_readout_pixelKeep;
                
                if (ctrl_readout_pixelDone) begin
                    // We need 3 wait states before we sample the checksum
                    ctrl_delay_count <= 3;
                    ctrl_delay_nextState <= Ctrl_State_Readout+4;
                    ctrl_state <= Ctrl_State_Delay;
                end
            end
        end
        
        // Output checksum+padding
        Ctrl_State_Readout+4: begin // 9
            ramctrl_cmd <= `RAMController_Cmd_Stop;
            
            ctrl_shiftout_data[(HeaderWidth-1)-:32] <= {
                // Little endian
                ctrl_readout_checksum[ 7-:8],
                ctrl_readout_checksum[15-:8],
                ctrl_readout_checksum[23-:8],
                ctrl_readout_checksum[31-:8]
            };
            ctrl_shiftout_count <= ChecksumPaddingWordCount-1;
            ctrl_shiftout_nextState <= Ctrl_State_Idle;
            ctrl_state <= Ctrl_State_Shiftout;
        end
        
        // Output `ctrl_shiftout_count` words from `ctrl_shiftout_data`
        Ctrl_State_Shiftout: begin // 11
            if (ctrl_readout_dataLoad) begin
                readout_data <= `LeftBits(ctrl_shiftout_data, 0, 16);
                readout_ready <= 1;
                readout_checksum_trigger <= 1;
                
                if (!ctrl_shiftout_count) begin
                    ctrl_state <= ctrl_shiftout_nextState;
                end
            end
        end
        
        // Delay `ctrl_delay_count` cycles
        Ctrl_State_Delay: begin // 12
            if (!ctrl_delay_count) begin
                ctrl_state <= ctrl_delay_nextState;
            end
        end
        endcase
        
        if (ctrl_cmdCapture) ctrl_state <= Ctrl_State_Capture;
        if (ctrl_cmdReadout) ctrl_state <= Ctrl_State_Readout;
    end
    
    // ====================
    // Connections
    // ====================
    // Connect input FIFO write -> pixel data
    // assign fifoIn_w_trigger = (fifoIn_headerWriteEn || fifoIn_pixelWrite);
    // assign fifoIn_w_data = (fifoIn_headerWriteEn ? `LeftBits(fifoIn_header, 0, 16) : {4'b0, img_d_reg});
    
    // Connect fifoIn -> RAM write
    assign fifoIn_r_trigger = ramctrl_write_ready;
    assign ramctrl_write_trigger = fifoIn_r_ready;
    assign ramctrl_write_data = fifoIn_r_data;
    
    // ramctrl_read_trigger: trigger another read from RAM if our flop is currently empty (!readout_ready),
    // or it's not empty and the client drained the word on this cycle
    assign ramctrl_read_trigger = ctrl_readout_dataLoad;
    
endmodule

`endif
