toasterllc/MDCCode/Code/STM32/STMLoader/Source/main.cpp

#include <cstring>
#include <algorithm>
#include "Lib/Toastbox/Math.h"
#include "Lib/Toastbox/Assert.h"
#include "Shared/STM.h"
#include "USB.h"
#include "System.h"
using namespace STM;

static void _CmdHandle(const STM::Cmd& cmd);
static void _Reset();

using _System = System<
    STM::Status::Mode::STMLoader,   // T_Mode
    false,                          // T_USBDMAEn
    _CmdHandle,                     // T_CmdHandle
    _Reset,                         // T_Reset
    std::tuple<>,                   // T_Pins
    std::tuple<>                    // T_Tasks
>;

using _Scheduler = _System::Scheduler;
using _USB = _System::USB;

// The Startup class needs to exist in the `uninit` section,
// so that its _appEntryPointAddr member doesn't get clobbered
// on startup.
using _VoidFn = void(*)();
static volatile _VoidFn _AppEntryPoint [[noreturn, gnu::section(".uninit")]] = 0;

// MARK: - Commands

static size_t _STMRegionCapacity(void* addr) {
    // Verify that `addr` is in one of the allowed RAM regions
    extern uint8_t _sitcm_ram[], _eitcm_ram[];
    extern uint8_t _sdtcm_ram[], _edtcm_ram[];
    extern uint8_t _ssram1[], _esram1[];
    size_t cap = 0;
    if (addr>=_sitcm_ram && addr<_eitcm_ram) {
        cap = (uintptr_t)_eitcm_ram-(uintptr_t)addr;
    } else if (addr>=_sdtcm_ram && addr<_edtcm_ram) {
        cap = (uintptr_t)_edtcm_ram-(uintptr_t)addr;
    } else if (addr>=_ssram1 && addr<_esram1) {
        cap = (uintptr_t)_esram1-(uintptr_t)addr;
    } else {
        Assert(false);
    }
    return cap;
}

static void _STMRAMWrite(const STM::Cmd& cmd) {
    const auto& arg = cmd.arg.STMRAMWrite;
    
    // Bail if the region capacity is too small to hold the
    // incoming data length (ceiled to the packet length)
    const size_t len = Toastbox::Ceil(_USB::Config::MaxPacketSizeBulk(), (size_t)arg.len);
    if (len > _STMRegionCapacity((void*)arg.addr)) {
        // Reject command
        _System::USBAcceptCommand(false);
        return;
    }
    
    // Accept command
    _System::USBAcceptCommand(true);
    
    // Receive USB data
    _USB::Recv(Endpoint::DataOut, (void*)arg.addr, len);
    
    // Send success
    _System::USBSendStatus(true);
}

static void _STMReset(const STM::Cmd& cmd) {
    // Accept command
    _System::USBAcceptCommand(true);
    
    _AppEntryPoint = (_VoidFn)cmd.arg.STMReset.entryPointAddr;
    
    // Perform software reset
    _System::Reset();
    // Unreachable
    Assert(false);
}

static void _CmdHandle(const STM::Cmd& cmd) {
    switch (cmd.op) {
    // STM32 Bootloader
    case Op::STMRAMWrite:   _STMRAMWrite(cmd);                  break;
    case Op::STMReset:      _STMReset(cmd);                     break;
    // Bad command
    default:                _System::USBAcceptCommand(false);   break;
    }
}

static void _Reset() {}

// MARK: - ISRs

extern "C" [[gnu::section(".isr")]] void ISR_SysTick() {
    _Scheduler::Tick();
    HAL_IncTick();
}

extern "C" [[gnu::section(".isr")]] void ISR_OTG_HS() {
    _USB::ISR();
}

extern "C" [[gnu::section(".isr")]] void ISR_I2C1_EV() {
    _System::ISR_I2CEvent();
}

extern "C" [[gnu::section(".isr")]] void ISR_I2C1_ER() {
    _System::ISR_I2CError();
}

// MARK: - Main

// Called via Startup.cpp
extern "C" [[gnu::always_inline, gnu::used]]
inline void _StackInit() {
    _Scheduler::StackInit();
}

static void _JumpToAppIfNeeded() {
    // Stash and reset `_AppEntryPoint` so that we only attempt to start the app once
    // after each software reset.
	const _VoidFn appEntryPoint = _AppEntryPoint;
    _AppEntryPoint = nullptr;
    
    // Cache RCC_CSR since we're about to clear it
    auto csr = READ_REG(RCC->CSR);
    // Clear RCC_CSR by setting the RMVF bit
    SET_BIT(RCC->CSR, RCC_CSR_RMVF);
    // Check if we reset due to a software reset (SFTRSTF), and
    // we have the app's vector table.
    if (READ_BIT(csr, RCC_CSR_SFTRSTF) && appEntryPoint) {
//        volatile bool a = false;
//        while (!a);
        
        // Start the application
        appEntryPoint();
        for (;;); // Loop forever if the app returns
    }
}

// MARK: - Abort
extern "C" [[noreturn]]
void Abort(uintptr_t addr) {
    _System::Abort();
}

// MARK: - Main
int main() {
    _JumpToAppIfNeeded();
    _Scheduler::Run();
    return 0;
}
