toasterllc/MDCCode/code/STLoader/src/main.h

#define STM_LED0_Pin GPIO_PIN_12
#define STM_LED0_GPIO_Port GPIOE
#define STM_LED1_Pin GPIO_PIN_15
#define STM_LED1_GPIO_Port GPIOE
#define STM_LED2_Pin GPIO_PIN_10
#define STM_LED2_GPIO_Port GPIOB
#define STM_LED3_Pin GPIO_PIN_11
#define STM_LED3_GPIO_Port GPIOB
