toasterllc/MDCCode/Code/ICE40/Shared/ICEAppSTMSim.v

wire[7:0]   spi_dataOut;
reg         spi_dataOutEn = 0;
wire[7:0]   spi_dataIn;
assign ice_stm_spi_d = (spi_dataOutEn ? spi_dataOut : {8{1'bz}});
assign spi_dataIn = ice_stm_spi_d;

reg[`Msg_Len-1:0] spi_dataOutReg = 0;
reg[`Resp_Len-1:0] spi_resp = 0;
reg[511:0] spi_datIn = 0;

reg[15:0] spi_dinReg = 0;
assign spi_dataOut[7:4] = `LeftBits(spi_dataOutReg,0,4);
assign spi_dataOut[3:0] = `LeftBits(spi_dataOutReg,0,4);

localparam ice_stm_spi_clk_HALF_PERIOD = 8; // 64 MHz

PixelValidator PixelValidator();

task _SendMsg(input[`Msg_Type_Len-1:0] typ, input[`Msg_Arg_Len-1:0] arg); begin
    reg[15:0] i;
    
    spi_dataOutReg = {typ, arg};
    spi_dataOutEn = 1;
    
        // 2 initial dummy cycles
        for (i=0; i<2; i++) begin
            #(ice_stm_spi_clk_HALF_PERIOD);
            ice_stm_spi_clk = 1;
            #(ice_stm_spi_clk_HALF_PERIOD);
            ice_stm_spi_clk = 0;
        end
        
        // Clock out message
        for (i=0; i<`Msg_Len/4; i++) begin
            #(ice_stm_spi_clk_HALF_PERIOD);
            ice_stm_spi_clk = 1;
            #(ice_stm_spi_clk_HALF_PERIOD);
            ice_stm_spi_clk = 0;

            spi_dataOutReg = spi_dataOutReg<<4|{4{1'b1}};
        end
        
        spi_dataOutEn = 0;
        
        // Turnaround delay cycles
        // Only do this if typ!=0. For nop's (typ==0), we don't want to perform these
        // turnaround cycles because we're no longer driving the SPI data line,
        // so the SPI state machine will (correctly) give an error when a SPI clock
        // is supplied but the SPI data line is invalid.
        if (typ !== 0) begin
            for (i=0; i<4; i++) begin
                #(ice_stm_spi_clk_HALF_PERIOD);
                ice_stm_spi_clk = 1;
                #(ice_stm_spi_clk_HALF_PERIOD);
                ice_stm_spi_clk = 0;
            end
        end
        
end endtask

task _ReadResp(input[31:0] len); begin
    reg[15:0] i;
    // Clock in response (if one is sent for this type of message)
    for (i=0; i<len/8; i++) begin
            if (!i[0]) spi_dinReg = 0;
            spi_dinReg = spi_dinReg<<4|{4'b0000, spi_dataIn[3:0], 4'b0000, spi_dataIn[7:4]};
            
            spi_resp = spi_resp<<8;
            if (i[0]) spi_resp = spi_resp|spi_dinReg;
        
        #(ice_stm_spi_clk_HALF_PERIOD);
        ice_stm_spi_clk = 1;
        
        #(ice_stm_spi_clk_HALF_PERIOD);
        ice_stm_spi_clk = 0;
    end
end endtask

task SendMsg(input[`Msg_Type_Len-1:0] typ, input[`Msg_Arg_Len-1:0] arg); begin
    reg[15:0] i;
    
    ice_stm_spi_cs_ = 0;
    
        _SendMsg(typ, arg);
        
        // Clock in response (if one is sent for this type of message)
        if (typ[`Msg_Type_Resp_Bits]) begin
            _ReadResp(`Resp_Len);
        end
    
    ice_stm_spi_cs_ = 1;
    #1; // Allow ice_stm_spi_cs_ to take effect
end endtask

task TestRst; begin
    $display("\n[ICEAppSim] ========== TestRst ==========");
    
    $display("[ICEAppSim] ice_stm_spi_cs_ = 0");
    ice_stm_spi_cs_ = 0;
    #1;
    
    if (sim_spiRst_ === 1'b1) begin
        $display("[ICEAppSim] sim_spiRst_ === 1'b1 ✅");
    end else begin
        $display("[ICEAppSim] sim_spiRst_ !== 1'b1 ❌ (%b)", sim_spiRst_);
        `Finish;
    end
    
    $display("\n[ICEAppSim] ice_stm_spi_cs_ = 1");
    ice_stm_spi_cs_ = 1;
    #1;
    
    if (sim_spiRst_ === 1'b0) begin
        $display("[ICEAppSim] sim_spiRst_ === 1'b0 ✅");
    end else begin
        $display("[ICEAppSim] sim_spiRst_ !== 1'b0 ❌ (%b)", sim_spiRst_);
        `Finish;
    end
    
    $display("\n[ICEAppSim] ice_stm_spi_cs_ = 0");
    ice_stm_spi_cs_ = 0;
    #1;
    
    if (sim_spiRst_ === 1'b1) begin
        $display("[ICEAppSim] sim_spiRst_ === 1'b1 ✅");
    end else begin
        $display("[ICEAppSim] sim_spiRst_ !== 1'b1 ❌ (%b)", sim_spiRst_);
        `Finish;
    end
    
    spi_dataOutEn = 0;
end endtask
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
