toasterllc/MDCCode/(commit log)

2019-01-10 Got stick working, successfully flashing LEDs with a flip flop
2019-01-18 Almost done implementing power up logic
2019-01-23 Fix compilation. In the process of implementing reads.
    [blink.v]
2019-01-24 Fixed cmdReadDataValidShiftReg / cmdReadDataValid
    [TopSim.v]
2019-01-27 Fix lots of bugs
    [TopSim.v]
2019-02-01 Added clock divider to slow us down a bit, since we have long wires on a breadboard
2019-02-02 Added uart, working (`picocom /dev/ttyUSB1`)
2019-02-02 Got reading/writing uart commands working. RAM doesn't work though...
2019-02-02 Reading/writing memory is working on breadboard with UART commands! SDRAM refresh is disabled though...
2019-02-06 Sticky errors -- light up red LED. Disable resetting at regular periods.
2019-02-24 Add notes
    [MotionDetectorCamera.sch]
2019-02-24 - Add IcestickTest_SDRAMReadWriteViaUART test (from Breadboard-UARTReadWrite branch) - Rename IcestickSDRAMTest -> IcestickTest_SDRAMReadWriteRandomly
2019-02-24 - HandleWrite state: wait T_WR before transitioning to Read state - StateWriteAbort: remove substate where we perform the write-recovery delay, since that delay can happen at the StateWrite->StateWri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
2019-02-25 SDRAMController: HandleRefresh: implement conservative delay for all possible scenarios at the beginning of the refresh interrupt
2020-01-13 Commit old changes to AdjustableVoltageRegulatorResistorValues.txt / VoltageRegulators.txt
2020-01-13 Make errors sticky (ie red LED can only go from 0->1). Scramble addresses instead of using random address so that we're guaranteed to read and write from every address. (Before, there were gaps in th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
2020-01-15 SDRAMController: fix bug where de-asserting cmdTrigger didn't abort the current read/write operation.
2020-01-15 IceboardTest_SDRAMReadWriteRandomly: remove ledGreen
2020-01-16 IceboardTest_SDRAMReadWriteRandomly: not working on actual board. Tried slowing down clock to .75MHz but that didn't work. The issue may be that we're using pins that are used by peripherals. Now try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
2020-01-16 IceboardTest_SDRAMReadWriteRandomly: Fix pin assignment so that we only used unused pins
2020-01-16 IceboardTest_SDRAMReadWriteRandomly: remove randomness, improve LED debug data dumping
2020-01-16 IceboardTest_SDRAMReadWriteViaUART: make order of bytes in uartDataOut make sense
2020-01-16 IceboardTest_SDRAMReadWriteRandomly: drop into a UART debugger when something goes wrong
2020-01-17 Print additional data over UART upon failure
2020-01-17 Problem repros within a few seconds on the board
2020-01-17 Light up 7 LEDs on failure
2020-01-17 Seems to be working with magic CLK pin in place
2020-01-17 Back to .75MHz since we had a failure at 12MHz. (Errors are probably unavoidable given the length of the wires and the breadboard situation though.) Switch back to random-ish data instead of using ad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
2020-01-18 Add other/ice40hx8k-breakout-board.pdf
2020-01-24 Finished cleaning up -- don't need to modify source anymore to switch between flashing and simulating
2020-01-26 IceboardTest_SimpleReadWrite: Fix assert macro
    [top.sv]
2020-01-26 Switch back to direction-based empty/full detection
    Revert "Alternative aempty/afull generation"
    This reverts commit 11490e1ef57e3ab1310eb83e35fda85162f235cc.
    [top.sv]
2020-01-27 Undo adding resets to AFIFO
    [top.sv]
2020-01-27 AFIFOTest: almost ready to test on device
2020-01-27 BuildAndFlash.sh: switch from arachne-pnr -> nextpnr
2020-01-27 AFIFOTest: working on a single board
2020-01-27 Created Icestick_AFIFOProducer / Iceboard_AFIFOConsumer to test AFIFO with separate boards producing/consuming
2020-01-27 Iceboard_AFIFOConsumer / Icestick_AFIFOProducer: commit before testing on actual boards
2020-01-28 AFIFO producer/consumer: working well (capacitor needed on wclk pin to filter noise, and wclk needs to be run fairly slowly -- 23 kHz)
    [top.v]
2020-01-28 AFIFO: switch to rok/wok signals instead of empty/full signals
2020-01-28 SDRAMController: convert logic to wire/reg
2020-01-29 AFIFO.v: switch from memory syntax to just a wide register so Lattice tools don't infer a memory
2020-01-29 Revert "AFIFO.v: switch from memory syntax to just a wide register so Lattice tools don't infer a memory"
    This reverts commit 5c4a75e13f272b2d9005afb322e56aa12839e43d.
    [AFIFO.v]
2020-01-29 Iceboard_AFIFOConsumer/Icestick_AFIFOProducer: explicit reset working with icestorm toolchain. Need to try Lattice toolchain...
    [AFIFO.v, ClockGen.v, top.v]
2020-01-29 Iceboard_AFIFOConsumer: seems to be working now with both IceStorm and Lattice tools. The problem was that our `rval` register wasn't initialized, so Synplify presumably optimized and broke things be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
    [top.v]
2020-01-30 Iceboard_AFIFOConsumer: make LED output a single bit again
2020-01-30 AFIFO / Iceboard_AFIFOConsumer: removed reset to test design size/performance with and without an explicit reset. Results:
    === Iceboard_AFIFOConsumer ===
    W/O RESET W/ RESET
    Number of wires: 110 130
    Number of wire bits: 223 258
    Number of public wires: 33 38
    Number of public wire bits: 112 132
    Number of memories: 0 0
    Number of memory bits: 0 0
    Number of processes: 0 0
    Number of cells: 143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
    [AFIFO.v, top.v]
2020-01-30 Revert "Icestick_AFIFOProducer: add register init values / syn_preserve directive"
    This reverts commit 6ff93d8413116f4a1d352d50586a11c4fe4d9d09.
    [top.v]
2020-01-30 Revert "AFIFO.v: back to old implementation which infers a memory..."
    This reverts commit 90c4264069a498ac6580ca34c9ed98bfbe48cd1a.
    [AFIFO.v]
2020-01-30 AFIFO.v: fix Icestorm toolchain inferring a memory
    [AFIFO.v]
2020-02-02 Almost done with dev board schematic
    [MotionDetectorCamera.sch]
2020-02-03 Trying to figure out the right soldermask sizes...
    [MotionDetectorCamera.sch, test.sch]
2020-02-04 About to start laying out dev board
    [test.sch]
2020-02-04 Commit before removing some decoupling caps
    [MotionDetectorCamera.sch]
2020-02-04 - Updated library resistor/capacitor footprints match IPC spec - Started laying out board
    [MotionDetectorCamera.brd, MotionDetectorCamera.sch]
2020-02-05 Board layout in progress
    [MotionDetectorCamera.brd, MotionDetectorCamera.sch]
2020-02-05 Commit before editing TagConnect footprint so we can actually route all the pins...
    [MotionDetectorCamera.brd]
2020-02-06 Commit before replacing CB132 -> BG121
    [MotionDetectorCamera.brd, MotionDetectorCamera.sch]
2020-02-06 Progress routing RAM
    [MotionDetectorCamera.brd, MotionDetectorCamera.sch]
2020-02-06 More routing...
    [MotionDetectorCamera.brd, MotionDetectorCamera.sch]
2020-02-06 Routing progress...
    [MotionDetectorCamera.brd, MotionDetectorCamera.sch]
2020-02-07 Commit before restarting routing RAM
    [MotionDetectorCamera.brd, MotionDetectorCamera.sch]
2020-02-07 Progress routing ice40
    [MotionDetectorCamera.brd, MotionDetectorCamera.sch]
2020-02-07 Finished breaking out pins of ice40?
    [MotionDetectorCamera.brd]
2020-02-07 Commit before trying to create a power pour for 1v2
    [MotionDetectorCamera.brd]
2020-02-07 Remove Route3-Route14 layers that mysteriously appeared
    [MotionDetectorCamera.brd]
2020-02-07 Laid power pours
    [MotionDetectorCamera.brd]
2020-02-07 Moved 1V8 connection to bottom of ice40 so our power supply won't be in the way of our routing
    [MotionDetectorCamera.brd]
2020-02-07 Routed 2V5 pour
    [MotionDetectorCamera.brd]
2020-02-07 Broke out RAM pins
    [MotionDetectorCamera.brd]
2020-02-07 Commit before attempting to rotate RAM 45 degrees
    [MotionDetectorCamera.brd]
2020-02-07 Connected VCC_SPI to 1V8
    [MotionDetectorCamera.brd]
2020-02-07 Cleaned up some RAM wiring
    [MotionDetectorCamera.brd]
2020-02-07 Successfully rotated RAM
    [MotionDetectorCamera.brd]
2020-02-07 Routing RAM in progress..
    [MotionDetectorCamera.brd, MotionDetectorCamera.sch]
2020-02-07 Finished routing RAM
    [MotionDetectorCamera.brd, MotionDetectorCamera.sch]
2020-02-07 Commit before integrating PLL filtering
    [MotionDetectorCamera.brd, MotionDetectorCamera.sch]
2020-02-07 Almost done adding VCCPLL1 filtering
    [MotionDetectorCamera.brd]
2020-02-07 Almost done routing VCCPLL1 (again)...
    [MotionDetectorCamera.brd]
2020-02-07 Finished adding filtering for VCCPLL1
    [MotionDetectorCamera.brd]
2020-02-07 Moved 2V5 filtering to back of board
    [MotionDetectorCamera.brd]
2020-02-07 Added VCCPLL0 filtering
    [MotionDetectorCamera.brd]
2020-02-07 Add RAM power filtering
    [MotionDetectorCamera.brd]
2020-02-07 Commit before cleaning up schematic
    [MotionDetectorCamera.brd, MotionDetectorCamera.sch]
2020-02-07 Still trying to clean up schematic
    [MotionDetectorCamera.brd, MotionDetectorCamera.sch]
2020-02-07 Progress cleaning up schematic
    [MotionDetectorCamera.brd, MotionDetectorCamera.sch]
2020-02-07 Commit before deleting old ICE40 from schematic
    [MotionDetectorCamera.brd, MotionDetectorCamera.sch]
2020-02-07 Cleaned up schematic (removed old ICE40)
    [MotionDetectorCamera.brd, MotionDetectorCamera.sch]
2020-02-07 Routing LEDs in progress
    [MotionDetectorCamera.brd, MotionDetectorCamera.sch]
2020-02-07 Finished LED routing
    [MotionDetectorCamera.brd, MotionDetectorCamera.sch]
2020-02-07 Routing progress
    [MotionDetectorCamera.brd]
2020-02-07 Finished routing LEDs. Needs some cleanup though.
    [MotionDetectorCamera.brd]
2020-02-07 Started cleaning up LED routing
    [MotionDetectorCamera.brd]
2020-02-07 Finished cleaning up LED routing
    [MotionDetectorCamera.brd]
2020-02-08 Commit before deleting old NOR flash chip in favor of a smaller one
    [MotionDetectorCamera.brd, MotionDetectorCamera.sch]
2020-02-08 Finished routing TagConnect connector. About to upgrade all power wires to be 10 mils.
    [MotionDetectorCamera.brd, MotionDetectorCamera.sch]
2020-02-08 Updated powr wires to be 8mil
    [MotionDetectorCamera.brd]
2020-02-08 In progress updating wire widths from 6mil -> 5mil
    [MotionDetectorCamera.brd]
2020-02-08 Fixed all traces that were 6 mil to be 5 mil
    [MotionDetectorCamera.brd]
2020-02-08 Finished switching to TagConnect without legs
    [MotionDetectorCamera.brd, MotionDetectorCamera.sch]
2020-02-08 Delted old TagConnect
    [MotionDetectorCamera.brd, MotionDetectorCamera.sch]
2020-02-08 Finished routing 2V5 rail
    [MotionDetectorCamera.brd, MotionDetectorCamera.sch]
2020-02-08 Almost done routing PIX
    [MotionDetectorCamera.brd, MotionDetectorCamera.sch]
2020-02-08 Cleaned up PIX routing
    [MotionDetectorCamera.brd]
2020-02-08 Finished routing and placing probe points
    [MotionDetectorCamera.brd]
2020-02-08 Ratsnest to get rid of airwires
    [MotionDetectorCamera.brd]
2020-02-08 Finished fixing DRC issues. We we want to remove wire stubs though?
    [MotionDetectorCamera.brd, MotionDetectorCamera.sch]
2020-02-08 Created cleaned up resistor/capacitor footprints
2020-02-08 Underway replacing old resistors/capacitors with new versions
    [MotionDetectorCamera.brd, MotionDetectorCamera.sch]
2020-02-08 Finished switching to new resistor/capacitor layouts
    [MotionDetectorCamera.brd, MotionDetectorCamera.sch]
2020-02-08 More progress cleaning up library
    [MotionDetectorCamera.brd, MotionDetectorCamera.sch]
2020-02-08 More library cleanup
    [MotionDetectorCamera.brd, MotionDetectorCamera.sch]
2020-02-08 Schematic: fixed label for RAM
    [MotionDetectorCamera.sch]
2020-02-08 Iceboard_CopyImage: fix simulation
    We met timing on ICE40HX4K-BG121 -- we can run at 132.51 MHz!
    [top.v]
2020-02-08 Cropped board
    [MotionDetectorCamera.brd]
2020-02-08 Added more grounding vias
    [MotionDetectorCamera.brd]
2020-02-08 Added decoupling caps to the center of the ice40
    [MotionDetectorCamera.brd, MotionDetectorCamera.sch]
2020-02-08 Made all library component pins' direction=io, so we don't get warnings about power pins being connected to nets called something different
    [MotionDetectorCamera.sch]
2020-02-08 Clean up schematic a bit
    [MotionDetectorCamera.sch]
2020-02-08 Updated prefixes of components in library
    [MotionDetectorCamera.sch]
2020-02-08 More cleanup
    [MotionDetectorCamera.sch]
2020-02-08 Cleaned up silkscreen text on board
    [MotionDetectorCamera.brd]
2020-02-09 Split up inductor pads for easier soldering
    [MotionDetectorCamera.brd, MotionDetectorCamera.sch]
2020-02-09 Cleaned up silkscreen
    [MotionDetectorCamera.brd, MotionDetectorCamera.sch]
2020-02-09 Added component sizes to DevBoardComponents.txt
    [MotionDetectorCamera.sch]
2020-02-09 Updated library so all parts have a keepout polygon instead of merely a keepout outline
    [MotionDetectorCamera.brd, MotionDetectorCamera.sch]
2020-02-09 Fix placement of pullup resistor since it was inside the inductor footprint
    [MotionDetectorCamera.brd]
2020-02-09 Added version text to board
    [MotionDetectorCamera.brd]
2020-02-09 Cleaned up text in library and on board
    [MotionDetectorCamera.brd, MotionDetectorCamera.sch]
2020-02-09 Final touchups
    [MotionDetectorCamera.brd, MotionDetectorCamera.sch]
2020-02-09 Improve board silkscreen text some more
    [MotionDetectorCamera.brd, MotionDetectorCamera.sch]
2020-02-09 Remove cream from INDUCTOR_LARGE so it's not included in stencils, since we'll solder those manually
    [MotionDetectorCamera.brd, MotionDetectorCamera.sch]
2020-02-09 Update flash part name
    [MotionDetectorCamera.brd, MotionDetectorCamera.sch]
2020-03-20 - SDRAMController: remove rst signal - Update test projects for Rev1 board / Winbond SDRAM
2020-03-21 Updated tests for Rev1 board
    [MotionDetectorCamera.brd, MotionDetectorCamera.sch]
2020-03-21 Update PCB capacitor part numbers
    [MotionDetectorCamera.brd, MotionDetectorCamera.sch]
2020-03-26 Add patched iceprog to work with Rev1 board, and update BuildAndFlash.sh to use it
2020-03-26 Add Rev1Board_ReadWriteViaUART project, working well but there's an intermittent problem reading from RAM, where we read invalid values occasionally
    [top.v]
2020-03-26 Rev1Board_ReadWriteViaUART: commit before switching back to testing with Rev1Board_ReadWriteTest
2020-03-27 mobile_sdr.v: fix initialization model to allow the AutoRefresh command to be issued immediately after the Precharge command, without interveneing clock cycles.
    [mobile_sdr.v]
2020-03-27 SDRAMController.v: fix DelayCounterWidth/RefreshCounterWidth math (off by one)
    [top.v]
2020-03-27 Rev1Board_ReadWriteTest: commit before digging into another invalid data failure
    [mobile_sdr.v, top.v]
2020-03-27 Rev1Board_ReadWriteTest: add uart support
2020-03-27 Rev1Board_ReadWriteTest: commit working/broken test case
    [top.v]
2020-03-29 Rev1Board_ReadWriteTest: working, Rev1Board_ReadWriteRandomly: broken
    [top.v]
2020-03-29 - Rev1Board_ReadWriteRandomly: working. - Rev1Board_ReadWriteRandomly: Random9 -> Random6, to speed up the whole-RAM iteration time - SDRAMController.v: needs cleanup related to preventing writes whe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
    [top.v]
2020-03-30 Rev1Board_CopyImage: appears to be working.
    - For use with the Iceboard_ImageProducer project, running on an Iceboard.
    - Didn't rigorously test because connecting the Iceboard/Icestick to the Rev1Board is haphazard (it requires voltage dividers for every pin and long wires that introduce noise and therefore strange issues), but a quick prototype seems to work.
    [top.v]
2020-03-31 EagleLibrary migration: commit before removing MotionDetectorCamera.lbr
    [MotionDetectorCamera.brd, MotionDetectorCamera.sch]
2020-03-31 EagleLibrary migration: safety commit before renumbering components
    [MotionDetectorCamera.brd, MotionDetectorCamera.sch]
2020-03-31 EagleLibrary migration: safety commit after renumbering components
    [MotionDetectorCamera.brd, MotionDetectorCamera.sch]
2020-03-31 Update MFG/PN for all components on schematic
    [MotionDetectorCamera.brd, MotionDetectorCamera.sch]
2020-04-01 Fix TPS6280X layouts now that the pinout is fixed
    [MotionDetectorCamera.brd]
2020-04-01 Switch to W25Q80EWUXIE
    [MotionDetectorCamera.brd, MotionDetectorCamera.sch]
2020-04-01 Safety commit
    [MotionDetectorCamera.brd, MotionDetectorCamera.sch]
2020-04-01 Rename 2V5 -> 2V8
    [MotionDetectorCamera.brd, MotionDetectorCamera.sch]
2020-04-02 Laying out AR0330
    [MotionDetectorCamera.brd, MotionDetectorCamera.sch]
2020-04-02 More progress laying out AR0300
    [MotionDetectorCamera.brd, MotionDetectorCamera.sch]
2020-04-02 Updated pins.pcf using the new routing for the laid-out image sensor
2020-04-02 Add decoupling capacitors to image sensor
    [MotionDetectorCamera.brd, MotionDetectorCamera.sch]
2020-04-08 Preparing to add SD card socket
    [MotionDetectorCamera.brd]
2020-04-08 microSD progress
    [MotionDetectorCamera.brd]
2020-04-11 Finished laying out SD card
    [MotionDetectorCamera.brd, MotionDetectorCamera.sch]
2020-04-11 Re-integrated 4 LEDs
    [MotionDetectorCamera.brd, MotionDetectorCamera.sch]
2020-04-11 Fixed all DRC errors
    [MotionDetectorCamera.brd, MotionDetectorCamera.sch]
2020-04-11 TPS63805: Separate AGND and PGND; connect AGND and PGND through a via at a different layer.
    [MotionDetectorCamera.brd, MotionDetectorCamera.sch]
2020-04-11 Started creating MDC programming board
    [MotionDetectorCamera.brd, MotionDetectorCamera.sch]
2020-04-12 Progress creating programmer board
    [Programmer.brd, Programmer.sch]
2020-04-12 Finished with programmer schematic
    [Programmer.brd, Programmer.sch]
2020-04-13 Programmer board progress. Trying to decide whether we can reliably support UART...
    [Programmer.brd, Programmer.sch]
2020-04-13 Commit before switching to 74LV1T126
    [MotionDetectorCamera.brd, MotionDetectorCamera.sch, Programmer.brd, Programmer.sch]
2020-04-13 Finished laying out programmer board
    [Programmer.brd, Programmer.sch]
2020-04-13 Programmer: Place silkscreen labels
    [Programmer.brd]
2020-04-13 Programmer: Add UART labels
    [Programmer.brd]
2020-04-13 Programmer: renumber components
    [Programmer.brd, Programmer.sch]
2020-04-13 Programmer: Update part numbers
    [Programmer.brd, Programmer.sch]
2020-04-13 Programmer: cleanup
    [Programmer.brd]
2020-04-13 MDC: Renumber parts, clean up silkscreen
    [MotionDetectorCamera.brd, MotionDetectorCamera.sch]
2020-04-14 Update part numbers
    [MotionDetectorCamera.brd, MotionDetectorCamera.sch, Programmer.brd, Programmer.sch]
2020-04-14 Remove CREAM from BGAs and TEST-POINT
    [MotionDetectorCamera.brd, MotionDetectorCamera.sch, Programmer.brd, Programmer.sch]
2020-06-26 Updates Notes.txt. Add pcb/MotionDetectorCamera.cam.
2020-06-28 Got Rev2Board_Blinky working on the Rev2 board. Added icestorm as a submodule.
2020-07-03 MDCDebugger/Rev2Board_RAMDebug: progress debugging intermittent corrupt message issue
    [top.v]
2020-07-03 Rev2Board_RAMDebug/MDCDebugger: fixed an intermittent bug where the length of a message wasn't sent
    [top.v]
2020-07-04 Add Rev2Board_PIXController. Rename pix_clk -> pix_dclk
    [MotionDetectorCamera.brd, MotionDetectorCamera.sch]
2020-07-06 Rev2Board_PIXI2CMaster: replace SB_IO_OD -> SB_IO
    [top.v]
2020-07-07 MDCDebugger: updated messaging scheme so that messages sent/received from device have the same format (type, len, payload).
2020-07-08 MDCDebugger/Rev2Board_PixController: setting LED working with new messaging protocol
2020-07-08 Rev2Board_PixController: fix msgout sometimes not writing length
    [top.v]
2020-07-08 Rev2Board_PixController/MDCDebugger: still working on getting RAM-reading working again. Design is getting stuck during routing...
    [top.v]
2020-07-08 Rev2Board_PixController: adding support for reading/writing i2c registers
2020-07-08 Rev2Board_PixController/MDCDebugger: i2c register reading/writing implemented
2020-07-14 Import good changes from FixIcecubeSynthesisMemoryReadout3
    [ClockGen.v, PixI2CMaster.v, mobile_sdr.v]
2020-07-14 Design working with both icestorm and icecube. Need to figure out the best way to get the clock arriving at the RAM at the right time though -- right now we're just using an inverter chain to add del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
2020-07-15 Successfully talking to AR0330CS over i2c!
2020-07-16 Rev2Board_PixController: almost finished implementing data slurping from image sensor
2020-07-20 Rev2Board_PixController: debugging 0 pixels. Seems that we never actually get a 0 pixel from the image sensor?
2020-07-21 Rev2Board_AFIFODebug: have test case that flips between working and broken fifo (working:AFIFO_cliff.v, broken:AFIFO.v)
    [AFIFO_cliff.v, top.v]
2020-07-21 code/AFIFO_cliff2.v: rename 'direction' register -> 'dir', to fix Icecube compilation error
    [AFIFO_cliff2.v]
2020-07-22 AFIFO.v: think we fixed our issue -- it was possible to read from a cell while we were still writing
    [AFIFO.v]
2020-07-22 AFIFO: commit before tearing stuff up. 2 test cases in this commit: working test case, and broken test case. Difference depends on AFIFO dirclr/dirset signals.
    [AFIFO.v, top.v]
2020-07-22 AFIFO/Rev2Board_AFIFODebug: previously working test case now failing (where dirset/dirclr both use rgaddrDelayed/wgaddrDelayed). Likely that that test case was always bad, but appeared working due to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
    [AFIFO.v, top.v]
2020-07-23 Rev2Board_PixController: revert debug changes -- taking snapshots sorta working
    [top.v]
2020-07-23 Revert "Rev2Board_PixController: add memReadDone register to minimize comparisons to ram_cmdAddr"
    This reverts commit b8ac04dd9c4f052e3015f8b4136bc66a268022a3. (Profiling shows it was a slower design.)
    [top.v]
2020-07-29 Add LensNotes.txt
2020-07-29 Pull from pcb/EagleLibrary and update MDC schematic/layout
    [MotionDetectorCamera.brd, MotionDetectorCamera.sch]
2020-07-29 Fix inductors after pulling from EagleLibrary, since inductor schematic changed
    [MotionDetectorCamera.brd, MotionDetectorCamera.sch]
2020-07-29 Preparing to add lens mount
    [MotionDetectorCamera.brd, MotionDetectorCamera.sch]
2020-07-29 Remove unused wires
    [MotionDetectorCamera.brd, MotionDetectorCamera.sch]
2020-07-30 Started integrating lens holder
    [MotionDetectorCamera.brd, MotionDetectorCamera.sch]
2020-08-04 Add notes/SDCardInterfaceParts.txt and notes/USBChipNotes.txt
    [MotionDetectorCamera.brd]
2020-08-04 Add parts for interfacing with non-LVS/A2 SD cards
    [MotionDetectorCamera.brd, MotionDetectorCamera.sch]
2020-08-04 Cleanup schematic labels
    [MotionDetectorCamera.sch]
2020-08-04 Add other/STM32F730
2020-08-04 In the process of creating STM32F730I8 device
2020-08-05 Finished creating STM32F730I8 device
2020-08-05 Added STM32. Broke design into sheets.
    [MotionDetectorCamera.brd, MotionDetectorCamera.sch]
2020-08-06 Swap 12 MHz clocks for 24 MHz, since the latter is more readily available
    [MotionDetectorCamera.brd, MotionDetectorCamera.sch]
2020-08-06 Removed flash chip since we haven't been using it
    [MotionDetectorCamera.brd, MotionDetectorCamera.sch]
2020-08-06 Remove TagConnect debug connector
    [MotionDetectorCamera.brd, MotionDetectorCamera.sch]
2020-08-06 Board progress
    [MotionDetectorCamera.brd]
2020-08-07 Clean up power supplies
    [MotionDetectorCamera.brd, MotionDetectorCamera.sch]
2020-08-07 Clean up LED component names/net names
    [MotionDetectorCamera.brd, MotionDetectorCamera.sch]
2020-08-07 Commit before renaming ICE_PRG lines
    [MotionDetectorCamera.brd, MotionDetectorCamera.sch]
2020-08-08 Layout progress
    [MotionDetectorCamera.brd, MotionDetectorCamera.sch]
2020-08-08 Wired up STM32 LEDs
    [MotionDetectorCamera.brd, MotionDetectorCamera.sch]
2020-08-08 pcb/eagle.epf changes
2020-08-08 Layout STM clock
    [MotionDetectorCamera.brd]
2020-08-08 Laying out SD card in progress
    [MotionDetectorCamera.brd, MotionDetectorCamera.sch]
2020-08-09 Use wires instead of polygons on power signals on pullups
    [MotionDetectorCamera.brd, MotionDetectorCamera.sch]
2020-08-09 Switch back to 56k pullups on SD card lines
    [MotionDetectorCamera.brd, MotionDetectorCamera.sch]
2020-08-09 Add pullup for PIX_SDATA
    [MotionDetectorCamera.brd, MotionDetectorCamera.sch]
2020-08-10 Remove 3d packages to fix ERC errors
    [MotionDetectorCamera.brd, MotionDetectorCamera.sch]
2020-08-10 Update TI parts with TI- prefix
    [MotionDetectorCamera.brd, MotionDetectorCamera.sch]
2020-08-10 Added USB port, USB ESD chip, and ferrite bead
    [MotionDetectorCamera.brd, MotionDetectorCamera.sch]
2020-08-10 Move revision text
    [MotionDetectorCamera.brd]
2020-08-10 Add vias around ground pads
    [MotionDetectorCamera.brd, MotionDetectorCamera.sch]
2020-08-10 Cleaning up layout
    [MotionDetectorCamera.brd]
2020-08-10 Layout cleanup
    [MotionDetectorCamera.brd]
2020-08-10 In process of length-matching SDIO lines
    [MotionDetectorCamera.brd]
2020-08-10 Finished length-matching SDIO lines
    [MotionDetectorCamera.brd]
2020-08-10 Commit before re-routing QUADSPI lines to help length-match
    [MotionDetectorCamera.brd]
2020-08-10 Finished length matching QUADSPI lines
    [MotionDetectorCamera.brd, MotionDetectorCamera.sch]
2020-08-10 Added part numbers. Committing before swapping out poor capacitors for better ones.
    [MotionDetectorCamera.brd, MotionDetectorCamera.sch]
2020-08-10 In the process of upgrading capacitors
    [MotionDetectorCamera.brd, MotionDetectorCamera.sch]
2020-08-10 Commit before attempting to upgrade ice40 pll capactiors
    [MotionDetectorCamera.brd, MotionDetectorCamera.sch]
2020-08-11 Replaced ice40 pll capacitors with the same 10uF we're using everywhere else
    [MotionDetectorCamera.brd, MotionDetectorCamera.sch]
2020-08-11 Adjust vias
    [MotionDetectorCamera.brd, MotionDetectorCamera.sch]
2020-08-11 Working on finalizing board
    [MotionDetectorCamera.brd]
2020-08-11 Move resistor outside of lens holder keepout region
    [MotionDetectorCamera.brd, MotionDetectorCamera.sch]
2020-08-11 Renumber parts
    [MotionDetectorCamera.brd, MotionDetectorCamera.sch]
2020-08-11 Clean up board labels
    [MotionDetectorCamera.brd]
2020-08-11 Add GND vias throughout board
    [MotionDetectorCamera.brd]
2020-08-11 Update notes
    [MotionDetectorCamera.brd]
2020-08-11 Disable cream on STM32 BGA pins
    [MotionDetectorCamera.brd, MotionDetectorCamera.sch]
2020-08-12 Length-match USB traces
    [MotionDetectorCamera.brd]
2020-08-12 Adjust text position on schematic
    [MotionDetectorCamera.sch]
2020-08-13 Adjust part label
    [MotionDetectorCamera.sch]
2020-09-30 Add initial STLoader project for STM32 Update notes Update EagleLibrary
2020-10-01 STLoader: Got USB enumeration working
    To fix USB enumeration, we had to add `__HAL_RCC_OTGPHYC_CLK_ENABLE()` to HAL_PCD_MspInit() to enable the USB PHY clock. Otherwise, USB_HS_PHYCInit() fails because this loop returns HAL_TIMEOUT:
    while ((USB_HS_PHYC->USB_HS_PHYC_LDO & USB_HS_PHYC_LDO_STATUS) == 0U)
    {
    if (++count > 200000U)
    {
    return HAL_TIMEOUT;
    }
    }
    See:
    https://community.st.com/s/question/0D53W0000080ETISA2/stm32f730z8-usb-hs-interface-not-working
    https://community.st.com/s/question/0D50X0000ARQuCr/stm32f730z8-usb-failure-with-generated-code
    [main.c]
2020-10-16 Initial attempt at making bootloader device descriptor
2020-10-18 Setting LED via USB working
2020-10-20 Stop using __WFI() in main() loop because the sleeping core prevents the ST-LINK flasher from working. (The workaround is to manually reset the chip using the reset pin at the start of flashing.)
    [main.c]
2020-10-21 Switch to -Os for g++ calls
2020-10-21 Migrate code from ResetHandler (assembly) to SystemInit (C)
2020-10-21 About to switch from vector table address model to entry point address model
    [STApp.cfg, STLoader.cfg]
2020-10-21 Bootloader working!
    Switched to entry point scheme (instead of vector table scheme)
2020-10-23 Fix bootloader race by adding a GetStatus command
    [STLoaderTypes.h, main.cpp]
2020-10-23 STLoader: lots of cleanup, but USB broke
    [STLoader.cfg]
2020-10-24 Move stm32f7xx_hal_conf.h
2020-10-24 STLoader: generate code to reset needs-generation flag
    [STLoader.ioc]
2020-10-25 Add STM32F730-Errata.pdf
2020-10-25 Fix USB IN endpoint issue
    [USB.h]
2020-10-25 STLoader: to improve ICE40 configuration performance, switch to 2-buffer scheme so we can do USB->memory and memory->QSPI in parallel. This actually regressed our performance from the previous commit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
2020-10-25 Enable USB DMA
2020-10-26 STScratch: enable USB DMA
2020-10-26 STLoader: Enable DMA for QSPI
2020-10-26 STLoader: remove queue 2-buffer implementation in favor of a simple ring buffer
    It looks like USB is broken again for some reason, after increasing the buffer size from 512->1024 bytes.
    [QSPI.h, System.h]
2020-10-26 STLoader: Fix bug in PCD_EP_OutXfrComplete_int() that causes USBD_LL_GetRxDataSize()/HAL_PCD_EP_GetRxCount() to return the wrong number of bytes when USB DMA mode is enabled.
    Also, apparently the USB hardware only restricts writing to packet boundaries. So if you give USBD_LL_PrepareReceive()/HAL_PCD_EP_Receive() a length that isn't a multiple of the max packet size, it can write beyond the supplied buffer, up to the max packet size. So added an assertion to verify that the supplied length to HAL_PCD_EP_Receive() is a multiple of the max packet size.
    [USB.h]
2020-10-26 Update Blinky PCF for Rev3 board
2020-10-26 Organize code directory with ice40/ and stm32/ subdirs
    [STApp.cfg]
2020-10-26 Temporarily renamed root dirs
    [MotionDetectorCamera.brd, MotionDetectorCamera.sch, Programmer.brd, Programmer.sch, STApp.cfg]
2020-10-26 Temporarily renamed dirs inside code/
    [STApp.cfg]
2020-10-26 Renamed directories
    [MotionDetectorCamera.brd, MotionDetectorCamera.sch, Programmer.brd, Programmer.sch, STApp.cfg]
2020-10-26 Move EagleLibrary back to PCB/EagleLibrary
2020-10-28 SDTest: Remove second PLL due to our pin placement issue (see Notes.txt)
    Min frequency: 172.86
    Max frequency: 242.31
    Average frequency: 216.06
    Median frequency: 214.96
    [top.v]
2020-10-28 STLoader: commit before switching to static polymorphism for base classes
    [STApp.cfg]
2020-10-28 STM32: preparing to create new STApp by making Util code subclass-able
2020-10-29 SDTest: Switch from 66->64 bit commands to make it easier for STM32's QSPI interface
2020-10-29 Commit before attempting to to remove the need for lshift/rshift on STM32 side of SPI comms
2020-10-30 SDTest: working on improving comms to prevent STM32 from having to shift bits. Slowed down the design though.
    Min frequency: 196.66
    Max frequency: 227.84
    Average frequency: 219.80
    Median frequency: 223.36
    [top.v]
2020-10-30 Update ICE40.h to use new SPI comms that don't require lshift/rshift
2020-10-30 STLoader: fix compilation errors
    [System.h]
2020-10-30 SDTest: fix bug where we need to cache `ctrl_msgArg`, since `ctrl_dinReg` contains the SD command to send, but it changes every cycle.
    Min frequency: 198.29
    Max frequency: 250.63
    Average frequency: 225.28
    Median frequency: 225.12
    [top.v]
2020-10-30 SDTest: fix bug where we weren't sending the SD card response
    Min frequency: 179.60
    Max frequency: 247.83
    Average frequency: 221.85
    Median frequency: 221.63
    [top.v]
2020-11-01 SDTest: Remove sd_init after removing SD init parts from Rev3 board
2020-11-02 Revert "SDTest: for DatIn state machine, perf-test binary encoded states (instead of one-hot)"
    This reverts commit 9785f523b8db9cd3c24f0f886fa1abc8367152b9.
    [top.v]
2020-11-02 Revert "SDTest: updates to support 2-port CRC7/CRC16 (so each port can support a different delay)"
    This reverts commit 841adf9bf90e721bcbcb0b8a27c68c7a0e96f0e8.
    [top.v]
2020-11-02 Revert "CRC16/CRC7: add second port so we can reuse the logic, but tap off different points"
    This reverts commit 611d6efe31b859bcbdf8de73ee15b185733127b8.
    [CRC16.v, CRC7.v]
2020-11-02 Revert "SDTest: reuse the same CRC16 instances for both DatIn and DatOut"
    This reverts commit 6f7b2a0ae82773ecc2bd0600e6f22e659568ac0e.
    [top.v]
2020-11-02 Reverted back to separate CRC16 instances since it's faster (but also bigger by about ~60 luts)
    Min frequency: 193.69
    Max frequency: 241.72
    Average frequency: 221.42
    Median frequency: 221.14
    [top.v]
2020-11-02 Reset sd_respGo/sd_datInGo at start of their respective state machines
    Haven't been able to find a way to do this without slowing us down significantly, but we're still pretty fast, and this is necessary for robustness.
    Min frequency: 170.97
    Max frequency: 223.36
    Average frequency: 200.73
    Median frequency: 199.32
    [top.v]
2020-11-03 SDTest: debugging DatOut CRC errors
    [SDCardSim.v, top.v]
2020-11-03 SDTest/SDCardSim: switch from tri1 to wire to easily tell when the line is being driven
2020-11-05 SDTest/STApp: writing to SD card seems to be working reliably after fixing 3 bugs:
    - we were always waiting 2 cycles for the CRC status from the card, but NCRC can vary between 2-8 cycles
    - fix `sd_datOutIdle` generation: before we were synchronizing `&sd_datOutIdleReg` directly into the ctrl_ domain, but `&sd_datOutIdleReg` can have momentary glitches during sd_ clock transitions. Instead, we store `sd_datOutIdle <= &sd_datOutIdleReg` in the sd_ domain, and synchronize `sd_datOutIdle` into the ctrl_ domain.
    - adjusted SDClkFastDelay=2 to reliably receive CRC status from the card (this seems to be tricky due to the transition from writing to reading on the sd_cmd line)
    [ICE40.h, top.v]
2020-11-05 Switch from MsgCmd -> MsgType
2020-11-05 SDTest: Reset sd_datInCRCErr every time the DatIn state machine restarts SDCardSim.v: handle access mode changing via CMD6
    [SDCardSim.v, top.v]
2020-11-05 SDTest: Switch to dat0Idle model instead of supplying the dat lines directly
2020-11-06 Fix sd_respCRCErr resetting. (We were resetting it right after setting it.)
    [top.v]
2020-11-06 Reset `sd_datOutCRCErr` when a new write session begins
    [top.v]
2020-11-06 Reset sd_datOutCRCErr upon a new write session
    [top.v]
2020-11-06 SDTest/SDCardSim: fix number of response timeout cycles
    [SDCardSim.v, top.v]
2020-11-07 STApp/STLoader: fix linker scripts so that static constructors get called STApp: fix sdRespGetBool()/sdRespGetBits() to use _RespIdx
    [ICE40.h]
2020-11-07 STLoader: fix bug where we had extra USB/QSPI instances
    [System.h]
2020-11-07 SDTest: Improve abort so it only requires a single abort message and DatOut is guaranteed to terminate, even in the pathological SD card case that responds very slowly
2020-11-07 SDTest: DatOut: switch back to having an extra state to handle aborting
    Min frequency: 159.16
    Max frequency: 200.36
    Average frequency: 179.25
    Median frequency: 179.47
2020-11-07 Add SDRAMReadWriteTest. Add mt48h32m16lf simulation model.
    SDRAMReadWriteTest is working on Rev3 board. We needed to add a delay to the clock to get it to work though.
    We need to overhaul SDRAMController:
    - Register IO pins to get constant delays across all the pins
    - Simplify the design: we don't need complex address comparisons and such, we just need to be able to read/write a contiguous block of memory
    - Cleanup port names
2020-11-08 STApp: Add STApp.cfg
    [STApp.cfg]
2020-11-08 RAMController: round block sizes up to the nearest power of 2
    Min frequency: 126.29
    Max frequency: 150.83
    Average frequency: 141.77
    Median frequency: 142.84
2020-11-09 RAMController.v: fix bugs
    Min frequency: 124.98
    Max frequency: 141.58
    Average frequency: 133.60
    Median frequency: 134.39
    [RAMController.v, top.v]
2020-11-10 RAMController: fix bug where we were determining end-of-row by looking at the row bits instead of column bits
    [RAMController.v, top.v]
2020-11-11 Revert "RAMController: experimenting with one-hot state encoding"
    This reverts commit c04b1805542ffb1c71771945ccef14d1ee330e78.
    [RAMController.v]
2020-11-11 RAMReadWriteRandomlyTest: switch to BlockSize=2304*1296
2020-11-12 SDTest: separated SD card controller into its own module: SDController.v. Passes all our simulation SDTest test cases (in SDTest/top.v).
    Before:
    Info: Device utilisation:
    Info: ICESTORM_LC: 984/ 7680 12%
    Info: ICESTORM_RAM: 1/ 32 3%
    Info: SB_IO: 11/ 256 4%
    Info: SB_GB: 8/ 8 100%
    Info: ICESTORM_PLL: 1/ 2 50%
    Info: SB_WARMBOOT: 0/ 1 0%
    Min frequency: 154.34
    Max frequency: 193.95
    Average frequency: 180.59
    Median frequency: 181.29
    After:
    Info: Device utilisation:
    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
2020-11-12 PixI2CMaster.v: use SB_IO for both i2c_clk and i2c_data to equalize propagation delays
2020-11-13 Address yosys issue where unused modules can affect size/performance of final design, by creating Synth.ys script and adding 'opt_clean' pass after the initial read_verilog pass.
    Min frequency: 156.52
    Max frequency: 193.69
    Average frequency: 178.59
    Median frequency: 182.55
    [top.v]
2020-11-13 PixI2CMasterTest: Move I2C slave simulation into its own file (PixI2CSlaveSim.v)
2020-11-13 ICEApp/PixI2CSlaveSim: fixes to get PixI2C single-byte writing working
    [PixI2CSlaveSim.v, Top.v]
2020-11-13 ICEApp: updates to fix synthesis. Need to test on the board.
    [Top.v]
2020-11-13 STApp: initial pix i2c comms implementation
2020-11-15 PixController.v: fix state indicies
    [PixController.v, Top.v]
2020-11-15 ICEApp: add PixSim to simulate pixel stream from image sensor
2020-11-15 Make ImageWidth/ImageHeight parameters supplied to PixController/PixSim. Debugging BankFIFO bug.
    [PixController.v, PixSim.v, Top.v]
2020-11-15 Add BankFIFOTest, BankFIFOTest2, BankFIFOTest3 to debug BankFIFO bug.
    BankFIFOTest3 repro's bug that's affecting ICEApp.
    [Pins.pcf, Top.v]
2020-11-15 BankFIFO.v: fix emptyish/fullish logic
    [BankFIFO.v]
2020-11-15 ICEApp: Bug fixes. PixCapture working in simulation, PixReadout to SD card working in simulation.
    [PixController.v, RAMController.v, Top.v]
2020-11-17 BankFIFO: experimenting with resets
    [BankFIFO.v, PixController.v, SDController.v, Top.v]
2020-11-18 BankFIFO: cleanup reset logic
    [BankFIFO.v]
2020-11-18 Experimenting with reset strategies
    [BankFIFO.v, PixController.v, SDController.v, Top.v]
2020-11-19 RAMController: fix bugs with abort mechanism
    [RAMController.v, Util.v]
2020-11-19 PixController: add abort mechanism BankFIFO: add reset-done signal
    [BankFIFO.v, PixController.v]
2020-11-19 PixController: use toggle for resetting BankFIFO
    [PixController.v]
2020-11-19 PixController: reset FIFO every time we start a capture, to remove the need for aborting
    [PixController.v]
2020-11-20 RAMReadWriteTest/RAMReadWriteRandomlyTest: fixes for new RAMController that doesn't need an abort mechanism
    [RAMController.v, Top.v]
2020-11-20 RAMController: cleanup. Switch back to old scheme where we had an additional Write state, so that we don't have to check write_ready.
2020-11-22 SDController: reset XXX_crcOutEn by default
    [SDController.v]
2020-11-22 SDController: reset XXX_crcRst/XXX_crcEn registers by default
    [SDController.v]
2020-11-23 PixController: wait for RAMController to be ready to write before enabling data flow
2020-11-23 ICEApp: pix capture working. Migrated lots of test cases from SDTest into ICEApp. I2C comms breaking at high frequencies in simulation -- need to investigate.
2020-11-24 ICEApp: commit before switching to macros instead of localparams for RAMController/PixController constants, since yosys doesn't support dot notation to access localparams
    [ICE40.h, Pins.pcf, Top.v]
2020-11-24 ICEApp/PixController/RAMController/SDController: switch from localparam -> macros for constants, since yosys doesn't support module dot notation
    [PixController.v, RAMController.v, SDController.v, Top.v]
2020-11-25 Switch BankFIFO -> AFIFO so that we can run pix_clk near the same frequency as pix_dclk. With BankFIFO, we can only dequeue data once it's half full, so while the remaining half is filling, the deque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
    With this commit, sd_clk/pix_clk/ram_clk are limited to ~108 MHz because they have to share a PLL.
    Once we can use 2 PLLs, we can run sd_clk at 120 MHz and ram_clk at 108 MHz.
2020-11-25 STApp: switch back to Pix testing
2020-11-25 RAMReadWriteTest/RAMReadWriteRandomlyTest: updates for running on board
2020-11-25 AFIFOTest: updates to run on board
2020-11-26 Add Code/ICE40/AFIFOPixTest. Updated AFIFOTest for running on board.
2020-11-26 AFIFOPixRAMTest: remove error state -- just continue upon error
    [Top.v]
2020-11-27 ICEApp/PixController/SDController: updates for maybe-fixed AFIFO
    [PixController.v, SDController.v, Top.v]
2020-11-27 STApp/ICEApp: SD writing still working. Need to remember to update Pins.pcf to switch between RAM working/SD working, since both PLLs lie on occupied input pins, which requires either RAM or SD to be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
    [Pins.pcf]
2020-11-29 Util.v: fix RegWidth macro -- it was totally broken
    [Util.v]
2020-11-29 STM32 QSPI: correct GPIO alternate config constants
2020-11-29 stm32f7xx_hal_qspi.h: reorder QSPI_CommandTypeDef fields
2020-11-29 STLoader: fixes for QSPI changes
    [System.h]
2020-11-29 STM32:
    - QSPI: make mode (single vs dual flash) configurable
    - SystemBase: move QSPI out of SystemBase and into System, so that the System subclass can configure the QSPI mode
    - Cleanup
2020-11-30 STLoader/STLoaderUtil: minimize the number of SPI clock cycles after configuration is complete, so that the app that we load doesn't receive a spruious command at the beginning.
    [STLoaderTypes.h, System.h]
2020-11-30 STApp/QSPITest: QSPI: debugging ice40 receiving the first message nibble as 0xF, instead of the correct data
    [ICE40.h, Top.v]
2020-11-30 STApp/QSPITest: fix comms by adding a dummy byte to the beginning of SPI transactions, to workaround apparent STM32 bug where the first nibble sent is incorrectly set to 0xF
    [ICE40.h, System.h, Top.v]
2020-12-02 QSPI working at 60 MB/sec by enabling DMA FIFO
2020-12-02 STLoader: fix iceload by adding an alignment parameter to QSPI
    [QSPI.h]
2020-12-03 STApp/QSPITest: debugging STM32 supplying extra cycle at the end of reading data that's causing us to drop a value
2020-12-04 Revert "STApp: progress towards implementing streaming image data"
    This reverts commit ec02f8431b15568170b47adbe021e7b7e9e5fb31.
    [System.h, USB.h]
2020-12-04 STApp: investigating stalling pipe
    [USB.h]
2020-12-05 Add STM32F730 PDFs
2020-12-06 STApp/STAppUtil: progress investigating technique to reset all endpoints
    [QSPI.h, System.h, USB.h]
2020-12-06 STApp/STAppUtil: more endpoint-reset progress
    [USB.h]
2020-12-06 STApp: progress migrating endpoint-resetting code to ST framework
2020-12-06 STApp: move endpoint resetting into USB_ResetEndpoints(), in stm32f7xx_ll_usb.cpp
2020-12-07 STAppUtil: add TestResetStreamInc mode to validate numbers received from ICE40/STM32 are incrementing numbers
2020-12-07 STApp/ICEStreamApp: finish adding streaming support. Debugging QSPI issue where data-less transfers hang forever.
    [ICE40.h, ICEAppTypes.v, System.h, Top.v]
2020-12-07 STApp: implement workaround for QSPI hanging on data-less transactions
    [QSPI.h, System.h]
2020-12-08 MDCUtil/STApp: add support for I2C transactions over USB
2020-12-08 Image streaming working with i2c configuration in MDCViewer
2020-12-08 STApp: publish i2c errors for MDCDevice to check STApp: timeout when starting streaming, if an image isn't received in 500ms MDCViewer: check for errors when streaming, if an image isn't received aft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
    [MDCDevice.h, System.h]
2020-12-09 MDCViewer: streaming and interactive terminal prompt (for issuing pix i2c commands) working
2020-12-16 CFAViewer: apply natural log to histogram Y axis
2020-12-23 MDCViewer: set image sensor pedestal = 0
2020-12-25 CFAViewer: use XYZ as our working color space, so that the color matrix converts between camera raw -> XYZ color space
2020-12-29 CFAViewer: lots of progress
    - add eye dropper feature to measure the average color within a rect
    - save positions of color checkers
    - add types for different color spaces
    - shader: fix translation from camera raw space -- switch to D65 everywhere
    - shader: fix highlight handling by saturating output channels if the respective input channel was saturated
2021-01-01 Switch to XYZ.D50 working space, so that the color matrix can be used directly with the ICC profile (ICC profiles require D50 whitepoints)
2021-01-03 CFAViewer: add shift functionality to make sampler rect a square
2021-01-08 CFAViewer: add live switch to toggle between image streaming and saved images
2021-01-08 CFAViewer: ImageLayer: bring back thread-safety
2021-01-08 CFAViewer: fix threading issue
2021-01-08 CFAViewer: apply SRGB gamma before LMMSE, and then de-gamma after LMMSE, which improves output
2021-01-09 CFAViewer: add IOServiceWatcher to watch for new USB devices
2021-01-20 STApp: replace Abort() with abort(), which causes the LEDs to flash
    [System.h]
2021-01-21 ICE40: remove pixel-dropped status bit -- we'll just rely on a timeout to determine whether an error occurred
    ./Synth.sh 8k bg121:4k ICEStreamApp ; ./AverageFreq.sh 8k bg121:4k ICEStreamApp 'ram_clk$SB_IO_OUT_$glb_clk' 51
    Min frequency: 110.14
    Max frequency: 128.35
    Average frequency: 120.04
    Median frequency: 119.95
    [ICEAppTypes.v, PixController.v, Top.v]
2021-01-21 RAMController.v: preparing to receive length of read/write command, but what if we just tell RAMController to stop when frame-valid is de-asserted, instead of counting down?
2021-01-21 RAMReadWriteTest: fix to work with new RAMController changes, which don't count the number of words being written
    [RAMController.v, Top.v, mobile_sdr.v]
2021-01-22 STApp/CFAViewer: variable image sizes working, so now ICE40 reports the image size, and STM32 and CFAViewer adjust accordingly, so we don't have to hard-code the image size anywhere
2021-01-22 ICEStreamApp/STApp: separate pix status messages into i2c and capture status, to make space for capture histogram, to be used for auto exposure
2021-01-31 CFAViewer: ImageLayerShader.metal: cleanup sampling to use sampleR()
2021-02-15 Commit before switching Mat values to be stored in column-major order, so they can be supplied directly to LAPACK routines
2021-02-15 Mat.h: switch to storing values in column-major order
2021-03-01 Interp.h: fix quadratic interpolation
    [Interp.h]
2021-03-08 ImageLayer: move fix highlights stage earlier
2021-03-10 Chromatic aberration correction progress
    [Poly2D.h]
2021-03-12 CFAViewer: ImageLayerShader.metal: improve uses of sampleR/sampleRGB
2021-03-13 CFAViewer: switch ImageLayerShader.metal to use CFAColor
2021-03-15 CFAViewer: progress modularizing Defringe filter
2021-03-15 CFAViewer: modularized Defringe filter working
2021-03-18 CFAViewer: in process of switching to using Renderer for all rendering
2021-03-19 CFAViewer: modularize LMMSE filter
2021-03-19 CFAViewer: fix Renderer::Txt move assignment
    [Renderer.h]
2021-03-19 CFAViewer: add Saturation filter
2021-03-19 CFAViewer: saturation filter updates
2021-03-19 Switch id<MTLBuffer> -> Renderer::Buf
2021-03-19 CFAViewer: make filters stateless so they don't have to be instantiated
2021-03-19 CFAViewer: move LocalContrast to its own filter
2021-03-31 CFAViewer: - Switch color matrix to convert from CamRaw.D65 -> LSRGB.D65 (instead of CamRaw.D50 -> XYZ.D50) - This is so that the white balance matrix and the color correction matrix are in the same 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
2021-04-02 CFAViewer: switch all intermediate processing to use ProPhotoRGB colorspace
2021-04-11 Mat: switch to implementation where storage is either inline or on the heap, depending on the collective size of the matrix.
2021-04-12 - C5CalcErrorStats: add support for FFCC/FFCCMatlab - Add Tools/FFCCPrintModel to print the Matlab model file - Tools/FFCCEvaluateModel: print illums in format that can be pasted into C5CalcErrorStats
2021-04-19 FFCCEvaluateModel/Debug.h: Fix load() implementation
    [Debug.h]
2021-04-21 Bring back color correction
    [PixelSampler.h]
2021-04-21 Defringe: switch BufSampler -> PixelSampler
2021-04-30 Update Notes/Notes.txt and PCB/EagleLibrary
2021-04-30 Added MSP430 to schematic
    [MotionDetectorCamera.brd, MotionDetectorCamera.sch]
2021-04-30 Rev4 progress
    [MotionDetectorCamera.brd, MotionDetectorCamera.sch]
2021-05-05 Rev4: - Added ideal diodes to switch between VDD_USB and VDD_BAT - Added OR gate to generate PWR_EN = PWR_EN_MSP + VDD_USB
    [MotionDetectorCamera.brd, MotionDetectorCamera.sch]
2021-05-06 Rev4: progress implementing power system
    [MotionDetectorCamera.brd, MotionDetectorCamera.sch]
2021-05-09 Update Notes.txt. Add Sim directory.
    [MotionDetectorCamera.brd, MotionDetectorCamera.sch]
2021-05-09 Debugging Sim/PowerMuxRails
2021-05-09 Sim/PowerMuxRails appears to be working
2021-05-10 Commit before re-implementing power supplies without LM66100
    [MotionDetectorCamera.brd, MotionDetectorCamera.sch]
2021-05-10 Progress implementing VDD/VDD_MSP rails
    [MotionDetectorCamera.brd, MotionDetectorCamera.sch]
2021-05-10 Power supply rail progress
    [MotionDetectorCamera.brd, MotionDetectorCamera.sch]
2021-05-10 Fix schematic warning
    [MotionDetectorCamera.brd, MotionDetectorCamera.sch]
2021-05-11 Progress work on power supplies. We need to re-implement VDD/VDD_MSP rails because of a case where current can flow into 1V8 when VDD_USB < VDD_BAT.
    [MotionDetectorCamera.brd, MotionDetectorCamera.sch]
2021-05-11 Re-implemented VDD/VDD_MSP rails using LM66100. This solution should offer reverse polarity protection for VDD_BAT, reverse current protection for VDD_USB / 1V8, and low voltage drops (~50mV).
    [MotionDetectorCamera.brd, MotionDetectorCamera.sch]
2021-05-11 Replaced STM power-gating with TI-TPS22916
    [MotionDetectorCamera.brd, MotionDetectorCamera.sch]
2021-05-12 Power rail simulation progress
2021-05-13 Commit before switching from LM66100 -> TPS22916
    [MotionDetectorCamera.brd, MotionDetectorCamera.sch]
2021-05-13 Switched from LM66100 -> TPS22916
    [MotionDetectorCamera.brd, MotionDetectorCamera.sch]
2021-05-13 Power supply progress
    [MotionDetectorCamera.brd, MotionDetectorCamera.sch]
2021-05-13 Switch PIX power supplies over to VDD_PIX_1V8
    [MotionDetectorCamera.brd, MotionDetectorCamera.sch]
2021-05-13 Added buffer to block PIX clock while PIX domain isn't powered
    [MotionDetectorCamera.brd, MotionDetectorCamera.sch]
2021-05-13 Migrate STM from VDD_1V8 -> VDD_1V8_STM rail
    [MotionDetectorCamera.brd, MotionDetectorCamera.sch]
2021-05-13 Cleanup schematic a bit
    [MotionDetectorCamera.sch]
2021-05-13 Remove analog switches between SD card and ICE40
    [MotionDetectorCamera.brd, MotionDetectorCamera.sch]
2021-05-14 Re-implement power rails again. (In the previous design, in battery mode, there may be reverse leakage from VOUT->VIN in the TPS22916 for the VDDB rail, causing VDD_USB to rise, thereby incorrectly e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
    [MotionDetectorCamera.brd, MotionDetectorCamera.sch]
2021-05-14 Connected ICE_MSP_* nets to ICE40
    [MotionDetectorCamera.brd, MotionDetectorCamera.sch]
2021-05-15 Updated notes after ordering lots of parts for mass production. Still wrestling with power supply.
    [MotionDetectorCamera.brd, MotionDetectorCamera.sch]
2021-05-16 Power rails seem to be simulating well (Sim/PowerMuxRails-New7)
2021-05-16 Hopefully done re-doing power rails
    [MotionDetectorCamera.brd, MotionDetectorCamera.sch]
2021-05-16 Replace load switches with TI-TPS22919DCK
    [MotionDetectorCamera.brd, MotionDetectorCamera.sch]
2021-05-16 Replaced ESD chip with DT1446-04V-7
    [MotionDetectorCamera.brd, MotionDetectorCamera.sch]
2021-05-16 Commit before cleaning up ALLIANCE-AS4C8M16MSA-6BIN device
    [MotionDetectorCamera.brd, MotionDetectorCamera.sch]
2021-05-16 Cleanup ALLIANCE-AS4C8M16MSA-6BIN / WINBOND-W989D6DBGX6I devices
    [MotionDetectorCamera.sch]
2021-05-16 Renamed VDD_B_EN_ -> !VDD_B_EN!
    [MotionDetectorCamera.brd, MotionDetectorCamera.sch]
2021-05-16 Add 3.3V LDO for STM's VDDUSB
    [MotionDetectorCamera.brd, MotionDetectorCamera.sch]
2021-05-17 MSP: make ACLK pin unpopulated so we can use it to debug the clock (source from a crystal)
    [MotionDetectorCamera.brd, MotionDetectorCamera.sch]
2021-05-17 Add 32kHz crystal so MSP430 can keep track of time
    [MotionDetectorCamera.brd, MotionDetectorCamera.sch]
2021-05-17 Rename CLK24MHZ nets -> CLK16MHZ, since we switched to using 16MHz clock modules
    [MotionDetectorCamera.brd, MotionDetectorCamera.sch]
2021-05-17 Add 'MOTION' sheet, rename Power sheet 'VDD'
    [MotionDetectorCamera.sch]
2021-05-17 Rename PIX nets to IMG
    [MotionDetectorCamera.brd, MotionDetectorCamera.sch]
2021-05-17 Add motion sensor and wire output to MSP430
    [MotionDetectorCamera.brd, MotionDetectorCamera.sch]
2021-05-17 Add bypass capacitors to MSP430 and motion sensor
    [MotionDetectorCamera.brd, MotionDetectorCamera.sch]
2021-05-17 Update library
    [MotionDetectorCamera.sch]
2021-05-17 Bump 1.8V rail up to 1.9V, so that it's easier to meet the SD card Vih in 3.3V mode
    Vih(2.8V) = 0.625*VDD = .625*2.8 = 1.75 V =>
    50mV away from 1.8V rail
    150mV away from 1.9V rail
    [MotionDetectorCamera.brd, MotionDetectorCamera.sch]
2021-05-17 Rename nets 1V8 -> 1V9
    [MotionDetectorCamera.brd, MotionDetectorCamera.sch]
2021-05-17 Fixed ICE40 PLL tile pins so that they're either unused, or output-only
    [MotionDetectorCamera.brd, MotionDetectorCamera.sch]
2021-05-17 Compact wires going to RAM now that we no longer have an A12 net (ball G1)
    [MotionDetectorCamera.brd, MotionDetectorCamera.sch]
2021-05-18 Add load switch to VDD_USB to limit inrush current
    [MotionDetectorCamera.brd, MotionDetectorCamera.sch]
2021-05-18 Add jumpers to VDD_BAT, VDD_USB, VDD_A, VDD_B, so we can measure current consumption
    [MotionDetectorCamera.brd, MotionDetectorCamera.sch]
2021-05-18 Update STM symbol
    [MotionDetectorCamera.sch]
2021-05-18 Started laying out!
    [MotionDetectorCamera.brd, MotionDetectorCamera.sch]
2021-05-18 Layout progress. Committing before removing most debug LEDs
    [MotionDetectorCamera.brd, MotionDetectorCamera.sch]
2021-05-19 Replace power supply diode with a version that has a lot less leakage (250uA -> 50nA)
    [MotionDetectorCamera.brd, MotionDetectorCamera.sch]
2021-05-19 Layout progress, 75 airwires
    [MotionDetectorCamera.brd]
2021-05-19 Cleanup wire
    [MotionDetectorCamera.brd]
2021-05-19 Layout progress, 69 airwires
    [MotionDetectorCamera.brd]
2021-05-19 Layout progress, 67 airwires
    [MotionDetectorCamera.brd, MotionDetectorCamera.sch]
2021-05-20 Layout progress, 60 airwires
    [MotionDetectorCamera.brd, MotionDetectorCamera.sch]
2021-05-20 Layout progress, 57 airwires
    [MotionDetectorCamera.brd]
2021-05-20 Layout progress, 51 airwires
    [MotionDetectorCamera.brd]
2021-05-20 Layout progress, 49 airwires
    [MotionDetectorCamera.brd, MotionDetectorCamera.sch]
2021-05-20 Layout progress, 47 airwires
    [MotionDetectorCamera.brd]
2021-05-20 Layout progress, 46 airwires
    [MotionDetectorCamera.brd]
2021-05-20 Add Notes/BatteryInternalLeakageMath.txt
2021-05-20 Layout progress, 44 airwires
    [MotionDetectorCamera.brd]
2021-05-20 Layout progress, 42 airwires
    [MotionDetectorCamera.brd]
2021-05-20 Layout progress, 37 airwires
    [MotionDetectorCamera.brd]
2021-05-20 Adding back LEDs
    [MotionDetectorCamera.brd]
2021-05-20 Add LEDs back to schematic. About to move image sensor since its underside comes into contact with RAM traces.
    [MotionDetectorCamera.brd, MotionDetectorCamera.sch]
2021-05-20 Move RAM routing to bottom layer so motion sensor doesn't overlap it (potentially shorting the traces to ground, since the bottom of the image sensor is metal and grounded)
    [MotionDetectorCamera.brd, MotionDetectorCamera.sch]
2021-05-20 Layout 4x ICE40 LEDs
    [MotionDetectorCamera.brd, MotionDetectorCamera.sch]
2021-05-20 Layout 4x STM32 LEDs
    [MotionDetectorCamera.brd, MotionDetectorCamera.sch]
2021-05-20 Fix LED layout DRC errors
    [MotionDetectorCamera.brd, MotionDetectorCamera.sch]
2021-05-20 Layout progress, 36 airwires
    [MotionDetectorCamera.brd]
2021-05-20 Layout progress, 32 airwires
    [MotionDetectorCamera.brd]
2021-05-20 Layout progress, 30 airwires
    [MotionDetectorCamera.brd]
2021-05-20 Layout progress, 29 airwires
    [MotionDetectorCamera.brd]
2021-05-20 Layout progress, 21 airwires
    [MotionDetectorCamera.brd, MotionDetectorCamera.sch]
2021-05-20 Layout progress, 10 airwires
    [MotionDetectorCamera.brd]
2021-05-20 Layout progress, 7 airwires
    [MotionDetectorCamera.brd, MotionDetectorCamera.sch]
2021-05-20 Layout progress, 6 airwires
    [MotionDetectorCamera.brd]
2021-05-20 Layout progress, 4 airwires
    [MotionDetectorCamera.brd]
2021-05-20 Commit before attempting to move component to make routing VDD_B easier
    [MotionDetectorCamera.brd]
2021-05-20 Moved component to make routing VDD_B easier
    [MotionDetectorCamera.brd]
2021-05-20 Layout progress, 2 airwires
    [MotionDetectorCamera.brd]
2021-05-20 Layout progress, 1 airwire
    [MotionDetectorCamera.brd]
2021-05-20 Layout progress, 0 airwires!
    [MotionDetectorCamera.brd]
2021-05-21 Progress laying out rotated image sensor
    [MotionDetectorCamera.brd, MotionDetectorCamera.sch]
2021-05-21 Connected all IMG I/O pins after rotating sensor. Still need to connect power pins and bypass capacitors.
    [MotionDetectorCamera.brd, MotionDetectorCamera.sch]
2021-05-21 Revert "ICEStreamApp-Debug: progress"
    This reverts commit 4ee9696f6bfc2c6133cdec30775432d17f50371c.
    [Pins.pcf, Top.v]
2021-05-21 ICEStreamApp-Debug: finished whittling. The problem is that a PIO pair (ie 2 pads that share a PIO tile) must have the same INPUT_CLK / OUTPUT_CLK / CLOCK_ENABLE. See diagram of a ICE40 'PIO pair' in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
    [Pins.pcf, Top.v]
2021-05-22 Layout: moved img_dclk to ICE40's F11 pin, since there's a global buffer there
    pix_dclk:
    Min frequency: 111.54
    Max frequency: 139.68
    Average frequency: 125.58
    Median frequency: 126.15
    [MotionDetectorCamera.brd, MotionDetectorCamera.sch]
2021-05-22 Getting ready to layout IMG bypass capacitors
    [MotionDetectorCamera.brd]
2021-05-22 Layout progress, 45 airwires
    [MotionDetectorCamera.brd]
2021-05-22 Layout progress, 43 airwires
    [MotionDetectorCamera.brd]
2021-05-22 Layout progress, 41 airwires
    [MotionDetectorCamera.brd]
2021-05-22 Layout progress, 27 airwires
    [MotionDetectorCamera.brd, MotionDetectorCamera.sch]
2021-05-22 Layout progress, 15 airwires
    [MotionDetectorCamera.brd]
2021-05-22 Layout progress, 14 airwires
    [MotionDetectorCamera.brd]
2021-05-22 Layout progress, 0 airwires! Finished rotating image sensor.
    [MotionDetectorCamera.brd]
2021-05-22 ICEStreamApp-Rotated: updated PCF
    Min frequency: 100.25
    Max frequency: 134.83
    Average frequency: 119.65
    Median frequency: 119.18
    [MotionDetectorCamera.brd]
2021-05-24 RAM: trace length-matching progress
    [MotionDetectorCamera.brd]
2021-05-25 RAM: done length matching traces
    [MotionDetectorCamera.brd]
2021-05-25 SD: trace length-matching progress
    [MotionDetectorCamera.brd]
2021-05-25 SD: done length matching traces
    [MotionDetectorCamera.brd]
2021-05-25 Cleanup board
    [MotionDetectorCamera.brd]
2021-05-25 SD: layout progress after rotating SD card
    [MotionDetectorCamera.brd, MotionDetectorCamera.sch]
2021-05-25 SD: finished rotating SD card
    [MotionDetectorCamera.brd]
2021-05-25 IMG: finished length-matching traces
    [MotionDetectorCamera.brd]
2021-05-26 STM/ICE: progress length-matching traces
    [MotionDetectorCamera.brd]
2021-05-26 STM/ICE: done length-matching traces
    [MotionDetectorCamera.brd]
2021-05-26 Updates to STM32CubeIDE files after upgrading
2021-05-26 Add ground header
    [MotionDetectorCamera.brd, MotionDetectorCamera.sch]
2021-05-26 Move wire away from motion sensor
    [MotionDetectorCamera.brd]
2021-05-26 Fill holes in power layer
    [MotionDetectorCamera.brd]
2021-05-26 Rename !VDD_B_EN_! -> VDD_B_EN_ so the net name matches code/Verilog
    [MotionDetectorCamera.brd, MotionDetectorCamera.sch]
2021-05-26 Cleaning up board
    [MotionDetectorCamera.brd, MotionDetectorCamera.sch]
2021-05-26 Add missing part numbers
    [MotionDetectorCamera.brd, MotionDetectorCamera.sch]
2021-05-26 Small fix to power layer
    [MotionDetectorCamera.brd]
2021-05-27 Replace resistor 1k -> 3k (consolidating resistor values)
    [MotionDetectorCamera.brd, MotionDetectorCamera.sch]
2021-05-27 Add Code/MSP430/TestMotionSensorWithMSP430Launchpad
    View UART output with `screen /dev/ttyACM0 9600`
2021-05-27 LaunchpadMotionSensorTest working well with actual motion sensor
2021-06-23 Move entire board so that the board origin is at 0,0. (This is needed for VisualPlace.exe to work properly.)
    [MotionDetectorCamera.brd]
2021-06-24 STScratch: migrate generated code to new STM32CubeIDE version
2021-06-24 Update LED GPIO port assignments
2021-06-24 Update STM32CubeIDE files
2021-06-24 Blinky: update for Rev4 board
2021-06-25 Blinky: blink at 1Hz
2021-06-25 Correct ICE_MSP_SPI_CLK / ICE_MSP_SPI_DATA nets on schematic and in Pins.pcf
    [MotionDetectorCamera.brd, MotionDetectorCamera.sch]
2021-06-25 Update RAMReadWriteTest / mt48h32m16lf for Alliance AS4C8M16MSA-6BIN
    RAMReadWriteTest appears to work on Rev4 board!
2021-06-25 Update RAMReadWriteRandomlyTest for Rev4 board
    RAMReadWriteRandomlyTest seems to be working on Rev4 board!
2021-06-25 Fix path to mt48h32m16lf/mobile_sdr.v
    [Top.v]
2021-06-25 ICEStreamApp: updates for Rev4 board
2021-06-25 STM32: MSP430 comms progress
2021-06-26 STM32: writing to MSP430 memory via JTAG working! We have to use open-drain signalling since STM32 can't drive the MSP430 inputs high enough. To get OD-signalling working, We bodged 10k resistors to 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
    [MSP430.h]
2021-06-26 STM32: trying to get writing to peripheral addresses working...
2021-06-26 STM32: toggling MSP430 GPIOs from STM32 now working
2021-06-26 STM32: update MSP430.h with regRead/regWrite/memRead/memWrite functions to allow different techniques to read/write memory (since writing registers doesn't seem to always work using the 'quick' writi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
    [MSP430.h]
2021-06-26 STM32: verify that MSP430 mass-memory-writing still works
2021-06-26 STM32: progress getting writing working for all types of MSP430 memory (peripherals, RAM, FRAM)
2021-06-27 STM32: more MSP430 write testing
2021-06-27 STM32: writing to MSP430 memory seems to be working
2021-06-27 STApp: turn on IMG rails via MSP430
2021-06-27 MDCDevice.h: update image sensor configuration for 16MHz EXTCLK
2021-06-28 STLoader: started adding MSP430 interfaces
    Before continuing though, let's experiment with not having separate interfaces+endpoints for each chip (STM32/ICE40/MSP430), and instead have only one interface/set of endpoint (CmdOut/DataOut/StatusIn). This may be better because:
    - adding additional chips wouldn't require using more USB resources (which are finite: there are only 8 IN/OUT endpoints)
    - adding additional chips will only require updating the command protocol, without needing to update USB resources and descriptors
    - to conserve RAM, we don't want to have separate data buffers for each interface (eg _iceBuf0/_iceBuf1 and _mspBuf0/_mspBuf1), when only one set would work
2021-06-29 STLoader: overhaul progress. ICE40 loading working, still need to: (1) test STM32 loading, (2) implement MSP430 loading.
2021-06-30 STM32: progress implementing MSP430 bootloading
2021-06-30 STM32: MSP430 programming mostly working, but failing spuriously
    [MSP430.h, System.h, main.cpp]
2021-06-30 STM32: debugging
2021-06-30 STM32: fix MSP430 SBW comms (and by extension, CRC verification) by disabling interrupts when performing IO, since it has strict timing requirements.
    [MSP430.h]
2021-06-30 STM32: cleanup
2021-06-30 STM32: MSP430.g: when writing memory, determine whether the entire region is FRAM. If so, use _framWrite() instead of _write(), for performance.
2021-07-01 STM32: writing MSP430 firmware working well (verified that it runs properly)
    MSP430.h: fix _jtagEnd() to disable JTAG properly
    [MSP430.h, main.cpp]
2021-07-01 PCB: rename MSP430 pins
    [MotionDetectorCamera.sch]
2021-07-01 MSP430: TogglePin: got 32768 Hz crystal working, and sourcing MCLK/SCLK/ACLK
2021-07-02 ICEApp: implement basic command set (nop, echo, led set) to get MSP430 comms started
2021-07-02 ICE40.h: updates to support LEDSet message
2021-07-02 MSPApp/ICEApp: comms working (incrementing LEDs)
2021-07-02 ICEApp: reset state machine when spi_clk is high for 10us
    [Top.v]
2021-07-02 MSPApp: reset ICE40 SPI state machine when starting
    [main.cpp]
2021-07-03 STM32: progress implementing MSP430 debug commands
2021-07-03 STM32: overhaul
2021-07-04 STM32: STFinish -> STReset
2021-07-04 STM32: MSP430: regsGet/regsSet seems to work
2021-07-21 STLoader: replace MSP430 debug protocol with primitive bit-banging commands
    [MSP430.h, STLoaderTypes.h, System.h]
2021-07-21 Revert "STLoader: replace MSP430 debug protocol with primitive bit-banging commands"
    This reverts commit b63be76bf2fb237dc231f3b5c0019f893bd21524.
    [MSP430.h, STLoaderTypes.h, System.h]
2021-07-22 MSP430.h: Fix compilation errors. Cleanup.
    [MSP430.h]
2021-07-28 MSPApp: fix clocking out data to ICE40 (we were changing data on the positive edge instead of the negative edge)
    [ICE40.h, main.cpp]
2021-07-30 Remove SDLVSTest for the time being, since it doesn't currently work with Rev4
    [Pins.pcf, Top.v]
2021-08-01 ICE40.h: SDGetStatusResp: fix _RespIdx
    [ICE40.h]
2021-08-02 LVS initialization looks like it's working (sd_cmd response has 1.8V amplitude)
2021-08-03 ImgI2CMaster.v: fix I2CQuarterCycleDelay calculation. (It was incorrect when I2CClkFreq=ClkFreq/4.)
    [ImgI2CMaster.v]
2021-08-04 - Switch to having both ice_msp_spi_clk / ice_msp_spi_data idle at 0V without pullups, and make the first bit of messages 1 instead of 0. (This is so the SPI lines will be 0V when ICE40 is off.)
    - Make `ice_msp_spi_data` (pin K1) use unregistered inputs, because it's a PIO pair with `ram_dq[15]` (pin J1), and they can't use the same clock.
    - This required updating TurnaroundInherentDelay=2, since we're no longer registering.
    [ICE40.h, ICEAppTypes.v, Top.v]
2021-08-09 NextpnrAverageFreq.py: print clocks sorted by name
2021-08-11 RAMController.v: fix Clocks() implementation
    Clk Min Max Avg Med
    --------------------------------------------------------------------------------------
    SDController.clk_slow 376.93 626.57 617.98 626.57
    ice_img_clk16mhz$SB_IO_IN_$glb_clk 99.30 130.87 115.07 114.97
    img_dclk$SB_IO_IN_$glb_clk 124.13 161.03 139.87 140.59
    imgctrl_readout_clk_$glb_clk 102.88 148.72 127.61 129.57
    ram_clk$SB_IO_OUT_$glb_clk 99.83 133.01 117.94 118.40
    sd_clk_int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
    [RAMController.v, Util.v]
2021-08-11 ICEApp: fix command response cycle timing (it was possible for the finals response bit output to be considered input and therefore the start of the next command)
    [Top.v]
2021-08-11 ICEApp/ImgController.v: progress implementing writing image header. Currently we're writing the header, but the image data is truncated by the header length. Need to implement writing the full image 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
    SDController.clk_slow 626.57 626.57 626.57 626.57
    ice_img_clk16mhz$SB_IO_IN 106.41 125.49 115.47 115.43
    img_dclk$SB_IO_IN_$glb_clk 116.14 135.03 128.14 128.60
    imgctrl_r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
2021-08-11 MSPApp/ICEApp: progress implementing image capturing. Not working yet, need to debug.
    [ICE40.h, ICEAppTypes.v, ImgController.v, RAMController.v, Top.v, main.cpp]
2021-08-11 ImgController/ICEApp: prevent reading from RAM beyond the last image pixel
    ice_img_clk16mhz$SB_IO_IN_$glb_clk 101.85 126.49 114.00 114.48
    img_dclk$SB_IO_IN_$glb_clk 108.79 142.29 131.34 131.30
    imgctrl_readout_clk_$glb_clk 105.98 144.89 130.90 131.79
    ram_clk$SB_IO_OUT_$glb_clk 100.40 135.98 121.87 121.52
    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
    [ImgController.v, Top.v]
2021-08-11 ICEApp/ImgController.v: fix writing of image header + full image (previously we were truncating the image data by the length of the header)
    ice_img_clk16mhz$SB_IO_IN 103.11 126.58 116.28 116.96
    img_dclk$SB_IO_IN_$glb_clk 116.13 135.03 126.33 125.25
    imgctrl_readout_clk_$glb_clk 108.26 144.89 132.51 133.90
    ram_clk$SB_IO_OUT_$glb_clk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
    [ImgController.v]
2021-08-12 ICEApp: remove simulation workarounds after fixing yosys' cells_sim.v
    [Top.v]
2021-08-13 ICEApp: fix SPI state machine: - response-less commands were off by one cycle - in simulation, detect when a SPI clock is given but the SPI data is undriven (z) or invalid (x)
    [Top.v]
2021-08-13 ImgSim.v: update clock timing to reflect actual device
2021-08-13 ImgController.v: fix for writing header, needed because the frame-valid signal doesn't lead line-valid by enough clock cycles (causing dropped pixels)
    ice_img_clk16mhz$SB_IO_IN_$glb_clk 110.27 130.87 121.96 122.34
    img_dclk$SB_IO_IN_$glb_clk 108.75 151.22 132.33 133.56
    imgctrl_readout_clk_$glb_clk 108.01 141.76 129.68 131.48
    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
    [ImgController.v]
2021-08-23 - ICEAppSim -> ICEAppMSPSim - Add SPI state machine to ICEAppSTM - Update Notes
2021-08-23 AFIFOTest: updates to work around RAM data-invalid issue (see ICE40-RAMInvalidDataNotes.txt)
    [Top.v]
2021-08-24 AFIFOSeriesTest: measured perf for 16-bit vs 8-bit AFIFO in series configuration:
    * 16-bit
    Info: ICESTORM_LC: 279/ 7680 3%
    Info: ICESTORM_RAM: 2/ 32 6%
    Info: SB_IO: 39/ 256 15%
    Info: SB_GB: 3/ 8 37%
    Info: ICESTORM_PLL: 0/ 2 0%
    r_clk$SB_IO_IN_$glb_clk 133.39 143.58 142.05 1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
2021-08-27 QSPI: Add option to leave chip-select pin uncontrolled.
2021-08-27 STM32: SystemBase.h: disable LED0 since we're going sacrifice it for a bodge
2021-08-27 AFIFO: fix 'no driver' warnings
    [AFIFO.v]
2021-08-28 ICEAppSTM: Add LEDSet command. Fix SD data producing so that we only trigger it once.
    [Top.v]
2021-08-29 MDCThroughputTest seems to be working with STApp. Still need to bodge the ICE_ST_SPI_D_READY line on the physical board though.
    Throughput: 353 Mbits/sec
    [main.cpp]
2021-08-29 Revert "ICEAppSTM: add delay to AFIFOChain data producer to verify that ICE_ST_SPI_D_READY line is working as expected (it does)"
    (We don't want to keep this delay, since it was just for testing.)
    This reverts commit d0f0b4c0bfeacdd6910cd812b69199aabb34f08b.
    [Top.v]
2021-08-31 Update Notes/Notes.txt
    ICEAppMSP perf:
    Info: ICESTORM_LC: 2248/ 7680 29%
    Info: SB_IO: 69/ 256 26%
    Info: ICESTORM_PLL: 2/ 2 100%
    ice_img_clk16mhz$SB_IO_IN_$glb_clk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
2021-08-31 ICEAppMSP/SDController.v: added manual control of sd_clk to SDController, via man_en_, man_sdClk, etc
    Info: ICESTORM_LC: 2253/ 7680 29%
    SDController.clk_slow 6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
2021-08-31 ICEAppMSP/SDController.v: for the SD LVS logic, remove the 'finish' signal in favor of waiting 5ms in the init state machine
    Info: ICESTORM_LC: 2273/ 7680 29%
    SDController.clk_slow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
2021-08-31 SDController: Optimize init state machine
    Info: ICESTORM_LC: 2263/ 7680 29%
    ice_img_clk16mhz$SB_IO_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
2021-09-02 SDController.v: optimize DatIn state machine
    Info: ICESTORM_LC: 2017/ 7680 26%
    Info: ICESTORM_RAM: 8/ 32 25%
    Info: SB_IO: 23/ 256 8%
    fifo_prop_clk_$glb_clk 114.32 134.77 125.65 1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
2021-09-02 SDController: register 'datIn_repeat'
    Info: ICESTORM_LC: 2010/ 7680 26%
    fifo_prop_clk_$glb_clk 111.73 135.92 125.53 125.53
    i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
2021-09-02 SDController: register datIn_blockLen
    Info: ICESTORM_LC: 2049/ 7680 26%
    SDController.clk_slow 449.24 626.57 619.99 626.57
    fifo_prop_clk_$glb_clk 109.25 133.69 124.10 125.09
    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
2021-09-02 SDController: trying to optimize
    Info: ICESTORM_LC: 1993/ 7680 25%
    SDController.clk_slow 427.72 626.57 620.35 626.57
    fifo_prop_clk_$glb_clk 108.62 135.92 125.31 126.41
    ice_st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
2021-09-02 SDController: trying to optimize
    Info: ICESTORM_LC: 2009/ 7680 26%
    fifo_prop_clk_$glb_clk 105.45 137.42 126.59 126.68
    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
2021-09-02 SDController: separate param bits. While some aspects are simpler, it's a bit gross and doesn't increase perf, so we should revert.
    [ICE40.h, ICEAppTypes.v, SDController.v, Top.v]
2021-09-02 Revert "SDController: separate param bits. While some aspects are simpler, it's a bit gross and doesn't increase perf, so we should revert."
    This reverts commit b2bb03569702663de7e9f822f1747244f78cc706.
    [ICE40.h, ICEAppTypes.v, SDController.v, Top.v]
2021-09-02 ICEAppSTM: replace usages of Msg_Arg_SDSendCmd_* with SDController_*
    [ICE40.h, ICEAppTypes.v, System.h, Top.v]
2021-09-02 ICEAppSTM/ICEAppSTMSim: fix SD readout -- we were dropping the first 2 bytes
    [SDCardSim.v, Top.v]
2021-09-03 STApp: Initial prototype of SD card mass read working @ 354e6 bits/sec!
2021-09-09 STApp/STLoader: add assertion to HAL_PCD_EP_Receive for the EP0 case, to verify that the length is exactly the MPS, since the underlying APIs require that
2021-09-11 Allow additional interrupts for debugging
2021-09-11 Revert "Allow additional interrupts for debugging"
    This reverts commit e10959141e4591a4e95f5bea9d843d025b47ce42.
2021-09-11 Unmask more interrupts
2021-09-12 Try detecting situation where both host and device are trying to send, or both host and device are trying to receive
2021-09-12 Revert "Try detecting situation where both host and device are trying to send, or both host and device are trying to receive"
    This reverts commit c1e893b4ff9d4f4c42d2fb4f720992816c00ba9e.
2021-09-12 PCD_EP_OutXfrComplete_int: when DMA=1, arrange to receive more OUT data immediately after receiving OUT data, instead of waiting for the status stage to complete
2021-09-12 EP0 control transfers and reset command seem to be working robustly
    [MDCDevice.h]
2021-09-12 System::_handleEvent(): Switch back to ChannelSelect mechanism
2021-09-13 STApp: working on DataIn reset scheme
    [USB.h]
2021-09-14 Progress implementing resetting of DataIn endpoint
    [System.h, USB.h]
2021-09-15 STApp: SDRead command working with EP0 commands + DataIn (EP1) endpoint resetting/flushing
    [MDCDevice.h, USB.h, main.cpp]
2021-09-16 In process of moving endpoint-resetting into USBBase.h
    [STLoaderTypes.h, System.h, USB.h, USBBase.h]
2021-09-16 STApp: working after moving endpoint-resetting to USBBase.h
    [USBBase.h, main.cpp]
2021-09-16 USBBase.h: adding OUT endpoint resetting
    [USBBase.h]
2021-09-19 STApp: progress switching to coroutines
2021-09-22 ICEAppSTM: switch prod_clk from 102MHz -> 51MHz (816e6 bits/sec -> 408e6 bits/sec) to match throughput of SD card
2021-09-24 ICEAppMSP: exploring ways to reset SD DatOut state machine robustly
    ice_img_clk16mhz$SB_IO_IN_$glb_clk 110.78 128.63 121.44 122.37
    img_dclk$SB_IO_IN_$glb_clk 121.58 145.62 134.64 134.57
    imgctrl_readout_clk_$glb_clk 115.43 149.45 133.02 131.82
    ram_clk$SB_IO_OUT_$glb_clk 104.95 143.29 128.11 130.62
    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
    [ICEAppSimTest.v, Top.v]
2021-09-24 Revert "ImgController.v: remove unnecessary Ctrl_State_Readout state"
    This reverts commit 20c05bb53a3a49b9ebe6d6d28562fe8e56657ca8.
    [ImgController.v]
2021-09-24 ICEAppMSP: have ImgController output a readout_start signal, which triggers SDController's sd_datOut_start.
    This fixes a race where SDController could observe datOutRead_ready=1 from a previous ImgController readout, which causes the SDController DatOut state machine to start too early.
    ice_img_clk16mhz$SB_IO_IN_$glb_clk 109.00 135.08 120.18 119.29
    img_dclk$SB_IO_IN_$glb_clk 120.96 146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
    [ImgController.v, Top.v]
2021-09-26 FletcherChecksum: replace modulo with ones-complement adder
    [FletcherChecksum.v, Top.v]
2021-09-27 Got FletcherChecksumCorrect to be exactly cycle correct, so that the first cycle after the en 1->0 transition has the correct checksum
    [FletcherChecksum.v, Top.v]
2021-09-27 FletcherChecksumTest: fix bug when generating longer hashes
    [FletcherChecksum.v]
2021-09-27 Replace >= with bitwise operations
    [FletcherChecksum.v]
2021-10-01 ImgController.v: swap endianness of checksum
    [ImgController.v]
2021-10-01 Revert "ImgController.v: add additional state to write checksum (to test perf)"
    This reverts commit 0d90f5ac0d93635f3ff5296c8eb101a30332728d.
    [ImgController.v]
2021-10-01 ImgController.v: try to optimize by removing states -- failed
    ice_img_clk16mhz$SB_IO_IN_$glb_clk 112.08 135.98 121.52 121.73
    img_dclk$SB_IO_IN_$glb_clk 109.72 131.30 119.66 119.56
    imgctrl_readout_clk_$glb_clk 106.55 143.27 131.92 133.19
    ram_clk$SB_IO_OUT_$glb_clk 100.24 141.20 129.08 130.50
    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
    [ImgController.v]
2021-10-01 Revert "ImgController.v: try to optimize by removing states -- failed"
    This reverts commit 07eccfae5dbae849b9c73cb6e61bae8252f54d52.
    [ImgController.v]
2021-10-02 Revert "ImgController.v: another perf attempt"
    This reverts commit 5663c2713d92d5f09fd4658e53b1c85224215334.
    [ImgController.v]
2021-10-02 SDController.v: fix debug logging
    [SDController.v]
2021-10-02 ICEAppSTMSim/ICEAppSim.v: fix TestSDDatIn() by sending CMD12 (STOP_TRANSMISSION) SD command when completing DatIn transfer
    [ICEAppSim.v, Top.v]
2021-10-02 ICEAppMSP/ICEAppMSPSim: replace ImgSetHeaderX variants with single ImgSetHeader with an index argument
    fifo_prop_clk_$glb_clk 116.85 134.64 126.53 127.42
    ice_st_spi_clk$SB_IO_IN_$glb_clk 100.42 127.78 114.12 115.43
    sd_clk_int 250.13 365.23 348.07 365.23
    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
    [ICE40.h, ICEAppSim.v, ICEAppTypes.v, Top.v]
2021-10-02 MSPApp: writing image sort of working (it's not writing the checksum for some reason though...) MDCUtil: revamp with ImgRead + LEDSet commands
2021-10-03 ImgController.v/SDCardSim.v: fix checksum endianness issues
    ice_img_clk16mhz$SB_IO_IN_$glb_clk 106.58 130.74 120.89 121.42
    img_dclk$SB_IO_IN_$glb_clk 112.56 142.43 129.15 129.52
    imgctrl_readout_clk_$glb_clk 113.05 146.89 128.92 128.87
    ram_clk$SB_IO_OUT_$glb_clk 113.51 136.31 127.63 128.07
    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
    [ImgController.v, SDCardSim.v, Top.v, main.cpp]
2021-10-03 Revert "ImgController.v: trying to optimize"
    This reverts commit b704ff103a122d03a2e8feba9bb65024d9f1d763.
    [ImgController.v]
2021-10-03 Revert "ImgController.v: trying to optimize"
    This reverts commit d71146a5b21e978101f41b70b1bcecf3295a0b1b.
    [ImgController.v]
2021-10-03 Revert "ImgController.v: trying to optimize"
    This reverts commit 04d5edc183b135fb4825f52c1247220b1fc203f3.
    [ImgController.v]
2021-10-03 Partially revert last commit since perf took a hit. Also, ideally we don't output data on the SD DAT lines unless the CMD25 response is OK, but the last commit will start outputting data regardless. 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
    ice_img_clk16mhz$SB_IO_IN_$glb_clk 112.08 135.98 1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
    [ICEAppSim.v, ICEAppTypes.v, ImgController.v, SDController.v, System.h, Top.v]
2021-10-04 Debugging
    Need to revert this commit
    [Top.v]
2021-10-04 Revert "FletcherChecksum.v: try alternative implementation for perf"
    This reverts commit d2e9e8e91a2253d958c223328d421fb48e52078c.
    [FletcherChecksum.v]
2021-10-04 Revert "FletcherChecksum.v: try another implementation for perf"
    This reverts commit 88a772146fc36e70192c34f0a2a8af3395c94475.
    [FletcherChecksum.v]
2021-10-04 Revert "Trying to optimize FletcherChecksum"
    This reverts commit 13273d38de35acf2c83bf0b137f86da6aeb9b2dc.
    [FletcherChecksum.v, Top.v]
2021-10-04 Revert "FletcherChecksum: Trying to optimize"
    This reverts commit 820e77a6896dacc510409165396b97b1b33158f8.
    [FletcherChecksum.v, Top.v]
2021-10-04 Revert "FletcherChecksum: Trying to optimize"
    This reverts commit 9fa6d318b6f2d61aa785f64e3d540fcb94e049cf.
    [FletcherChecksum.v, Top.v]
2021-10-04 Revert "Debugging"
    This reverts commit ccb83fe59d1610842ba128b22135819185f333e5.
    [Top.v]
2021-10-05 ICEAppSTM/ICEAppMSPSim: revert img integration into ICEAppSTM -- we should create a separate project to avoid perf regression. Cleanup.
    [Top.v]
2021-10-06 Switch back: SystemVerilog -> Verilog
2021-10-06 ICEApp.v: cleanup: always enter SPI_State_RespOut state after a command, even for STM. Not confident that this won't break anything for STM -- needs further testing.
    [ICEApp.v]
2021-10-07 ICEAppSTMSim.v: fix SPIReadout word count by taking the header+checksum into account
    [ICEAppSTMSim.v]
2021-10-09 Add ICEAppImgCaptureSTM
    Info: ICESTORM_LC: 2735/ 7680 35%
    ICEApp.SDController.clk_slow 626.57 626.57 626.57 626.57
    ICEApp.imgctrl_readout_clk_$glb_clk 115.90 137.29 128.09 125.4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
2021-10-09 ICEApp.v: wire up readoutfifo_rst_ in the ImgReadoutToSD case
    Info: ICESTORM_LC: 3661/ 7680 47%
    Info: ICESTORM_RAM: 9/ 32 28%
    ICEApp.readoutfifo_r_clk_$glb_clk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
2021-10-09 ICEApp.v: fix sd_datOut_trigger toggling
    [ICEApp.v, ICEAppSim.v]
2021-10-09 ICEApp.v: attempting to remove 'SD DatOut Trigger State Machine' in favor of an ImgController 'readout_start' signal, and having SDController check 'datOutRead_ready' at the beginning of the DatOut s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
    The problem with this approach is that the trailing bytes that ImgController writes to the FIFO won't be written, unless they're a multiple of the FIFO size (which they're not). So next we'll try to fix that by having ImgController guarantee that it writes a multiple of a parameterized block size.
    [ICEApp.v, ICEAppSim.v, ImgController.v, SDController.v]
2021-10-09 ICEApp.v/ImgController.v: try hard-coding image size to ensure that ImgController readout supplies a multiple of the SD block length
    Info: ICESTORM_LC: 3579/ 7680 46%
    ICEApp.SDController.clk_slow 626.57 626.57 626.57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
2021-10-09 WordValidator.v: add check to make sure that we receive the checksum, to make sure we don't receive short transfers
    [WordValidator.v]
2021-10-09 STApp: add initial SDCard.h implementation. Need to fix compilation errors.
    [ICEApp.v, MDCTypes.h, SDCard.h, System.h]
2021-10-09 ICEApp.v: wire up for AFIFOChain threshold changes
2021-10-09 ImgController.v: add UnlimitedReadout functionality to fix ImgReadoutToSPI case
    ICEApp.readoutfifo_r_clk_$glb_clk 124.33 154.34 142.95 145.92
    ICEApp.sd_clk_int 267.45 365.23 363.31 365.23
    ICEApp.spi_clk_$glb_clk 106.48 121.18 115.97 116.52
    ice_img_clk16mhz$SB_IO_IN_$glb_clk 111.11 129.68 121.75 120.09
    img_dclk$SB_I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
    [ICEApp.v, ImgController.v]
2021-10-09 Revert "ImgController: trying to get readout to read a multiple of the block size"
    This reverts commit af1003e495e0b3b58fc14213ec45d5eb8856ca8f.
    This returns ImgController to the implementation where it has registers between RAMController output and AFIFOChain input, instead of connecting them directly. We're doing this to test how perf changes by using those registers.
    Info: ICESTORM_LC: 3647/ 7680 47%
    Info: SB_WARMBOOT: 0/ 1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
    [ImgController.v]
2021-10-09 Revert "Revert "ImgController: trying to get readout to read a multiple of the block size""
    This reverts commit 37dd51061837a10ef0f6e4562038123bc34665fd.
    [ImgController.v]
2021-10-09 WordValidator.v: fix bug where we gave an error if no checksum was received, even when checksum validation was disabled. Cleanup.
    [WordValidator.v]
2021-10-10 RAMController.v: make block count an explicit parameter, to allow us to fix simulation warning ("warning: Port 3 (cmd_block) of RAMController expects 11 bits, got 1.")
    * ICEAppMSP:
    Info: ICESTORM_LC: 3573/ 7680 46%
    ----------------------------------------------------------------------------------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
    [ICEApp.v, ICEAppSim.v, ImgController.v, RAMController.v]
2021-10-10 STApp: fix compiler errors. SDCard.h integrated.
    [SDCard.h, System.h]
2021-10-12 STApp/MSPApp: switching ImgSensor.h to only be used by MSPApp/STApp, and add a SetExposure command to STApp
2021-10-12 STLoader/STApp: rename command: Reset -> ResetEndpoints
    [MDCDevice.h, STLoaderTypes.h, System.h, main.cpp]
2021-10-12 ICE40.h: fix ImgI2C() / ImgI2CWrite() functions
    [ICE40.h]
2021-10-13 ICEApp: fix ImgWordCount global shadowing ImgController ImgWordCount
    [ICEApp.v, ICEAppSTMSim.v, ICEAppSim.v, ICEAppTypes.v]
2021-10-13 STApp/STLoader: Merge STAppTypes.h and STLoaderTypes.h into ST.h, so that they can share a basic command set. This is mainly so we can always issue the 'InvokeBootloader' command to return to STLoader
    [MDCDevice.h, ST.h, System.h, USB.h, main.cpp]
2021-10-13 Move Code/STM32/Shared/ST.h -> Code/Shared/STM.h
2021-10-13 STApp/STLoader: rename ResetEndpoints -> FlushEndpoints
    [STM.h, System.h]
2021-10-14 STApp/STLoader/MDCUtil: cleaning up image readout. About to wrap Toastbox classes in Toastbox namespace to avoid conflicts
    [Img.h, MDCDevice.h, SD.h, SDCard.h, STM.h, USBBase.h, main.cpp]
2021-11-03 Fix USB re-enumeration when STLink is connected
    This is a combined commit from scratch/STMApp-FixUSBEnumerationWhileSTLinkConnected
    [MDCDevice.h, QSPI.h, USBBase.h]
2021-11-04 STMApp/STMLoader: fix setting img exposure by enabling interrupts before handling USB commands
    [ICE.h, Img.h, ImgSensor.h, MDCDevice.h, STM.h]
2021-11-04 ImgController.v: allow skipping images so that the first image readout after changing the exposure has the exposure changes applied
    ICEApp.readoutfifo_r_clk_$glb_clk 123.84 144.89 136.41 135.72
    ICEApp.sd_clk_int 365.23 365.23 365.23 365.23
    ICEApp.spi_clk_$glb_clk 108.59 123.72 116.55 116.47
    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
    [ICEApp.v, ICEAppSim.v, ICEAppTypes.v, ImgController.v, ImgSim.v]
2021-11-04 ImgController.v: skip perf experiment
    ICEApp.readoutfifo_r_clk_$glb_clk 124.16 140.06 131.89 132.45
    ICEApp.sd_clk_int 271.52 365.23 346.65 365.23
    ICEApp.spi_clk_$glb_clk 106.48 124.27 114.41 114.51
    ice_img_clk16mhz$SB_IO_IN_$glb_clk 115.63 132.45 128.02 128.62
    img_dclk$SB_IO_IN_$glb_clk 12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
    [ImgController.v]
2021-11-04 Revert "ImgController.v: skip perf experiment"
    This reverts commit 69601359f474d40dad04970d9488bd1e0efa1c1d.
    [ImgController.v]
2021-11-04 STApp/CFAViewer: implement image capture skipCount functionality, so that the first image captured after setting the exposure has the new exposure applied
    ICEApp.readoutfifo_r_clk_$glb_clk 122.46 143.64 132.18 131.79
    ICEApp.sd_clk_int 250.13 365.23 359.61 365.23
    ICEApp.spi_clk_$glb_clk 105.39 125.31 113.63 113.87
    ice_img_clk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
    [ICE.h, MDCDevice.h, STM.h]
2021-11-04 ImgController.v: skip perf experiment
    ICEApp.readoutfifo_r_clk_$glb_clk 130.16 143.91 138.84 140.11
    ICEApp.spi_clk_$glb_clk 107.81 126.20 117.11 116.84
    ice_img_clk16mhz$SB_IO_IN_$glb_clk 110.10 133.19 119.69 118.11
    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
    [ImgController.v]
2021-11-04 ImgController.v: skip perf experiment
    ICEApp.readoutfifo_r_clk_$glb_clk 125.14 137.95 132.73 133.94
    ICEApp.spi_clk_$glb_clk 96.34 115.97 107.54 106.09
    ice_img_clk16mhz$SB_IO_IN_$glb_clk 117.81 135.21 126.24 127.03
    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
    [ImgController.v]
2021-11-04 ImgController.v: skip perf experiment
    ICEApp.readoutfifo_r_clk_$glb_clk 111.71 133.82 125.17 128.52
    ICEApp.sd_clk_int 327.55 365.23 364.49 365.23
    ICEApp.spi_clk_$glb_clk 110.01 121.01 115.13 113.96
    ice_img_clk16mhz$SB_IO_IN_$glb_clk 116.58 129.43 124.30 125.27
    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
    [ImgController.v]
2021-11-05 ImgController.v: skip perf experiment
    [ICEAppSim.v, ImgController.v]
2021-11-05 Revert "ImgController.v: skip perf experiment"
    This reverts commit 0d56ed0b4664ec839ecaae5ddd7770d4673ef452.
    [ICEAppSim.v, ImgController.v]
2021-11-05 ImgController.v: fix skipping
    ICEApp.readoutfifo_r_clk_$glb_clk 126.92 143.58 138.24 139.16
    ICEApp.spi_clk_$glb_clk 105.30 122.04 115.25 114.74
    ice_img_clk16mhz$SB_IO_IN_$glb_clk 118.19 136.89 127.60 126.90
    img_dclk$SB_IO_IN_$glb_clk 116.18 1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
    [ImgController.v]
2021-11-05 ImgSensor.h: disable masking bad frames -- not sure if it had an effect
2021-11-05 MSPApp: fix compilation errors
    [ImgSensor.h, SDCard.h, main.cpp]
2021-11-09 MSPApp: getting motion sensor working again (with interrupts)
2021-11-10 MSPApp: factor out Clock/RTC/SPI peripherals into their own classes
2021-11-11 Integrate changes from scratch/MSPAppIntDebug, which fixes MSPApp interrupt handling when exiting from LPM3.5.
    The problem was that MSP430's TEST pin was pulled high by a Rev4 bodge pullup resistor (needed for STM<->MSP comms), and when TEST=1, apparently (from bench testing) an interrupt can't wake MSP430 from LPM3.5. The solution is to just have STMLoader configure the MSP430 TEST/RST_ pins to be de-asserted, rather than floating, when STMLoader starts.
    [Clock.h, Img.h, MSP430.h]
2021-11-12 MSPApp: debugging interrupts + waking from LPM3.5, appear to work as expected
2021-11-13 Switch #pragma mark -> // MARK: to suppress GCC warnings
2021-12-02 ICEApp: VariableDelay: use inverters instead of buffers, so that clients can optionally invert the clock MSPApp/STApp: update SD::Card::ClkDelaySlow to invert the slow SD clock
    Before this change, sometimes we'd have comms failures when initializing the SD card (eg bad response CRCs from the SD card). After viewing SD_CLK/SD_CMD on the scope, it's clear that the slow SD clock should be inverted so that the setup/hold times are met.
    [VariableDelay.v, main.cpp]
2021-12-07 Add Code/MSP430/InterruptTest-LaunchpadFR
2021-12-08 MSPApp:
    - Implement proper handling of .bakmem section, so that data
    placed in BAKMEM is correctly copied from FRAM->BAKMEM during startup
    - Handle adopting the time that's set by STM32
    [RTC.h, Startup.h, main.cpp]
2021-12-08 MSP430/InterruptTest-LaunchpadFR: updates
2021-12-09 MSPApp: don't enable interrupts unnecessarily
2021-12-09 MDCUtil/ELF32Binary.h: fixes to properly enumerate segments and write to the correct physical address
    Before we were enumerating over the sections and incorrectly writing them to the virtual addresses, instead of the physical address associated with the segment that the sections are in.
    [ELF32Binary.h, main.cpp]
2021-12-09 Fix multiple issues that prevented the motion sensor interrupts from working, and prevented proper waking from LPM3.5:
    - Add pull-down resistor to MOTION_SIGNAL via MSP430's PxREN (which is
    apparently required by motion sensor -- see wiring diagram in motion
    sensor datasheet)
    - Fix Startup::ColdStart() always returning true because Startup::_startup()
    is only called on cold starts
    - Fix bug where _SPI::Init() wasn't always being called before using the
    SPI peripheral
    - Also fixed a potentially bad board connection to the motion sensor
    [Startup.h, main.cpp]
2021-12-10 MSPApp:
    - Linker.ld: use a wildcard for .fram_info.* / .ram_backup.* to workaround a gcc error
    ("xxx causes a section type conflict with yyy")
    - Startup::ColdStart(): return true if the current invocation is the first run after
    writing FRAM, or if PMMIFG.PMMLPM5IFG==0. This allows a cold start to be triggered
    whenever a program is re-loaded.
    - Startup::_startup(): switch back to only copying BAKMEM if it's a cold start, since
    that was the correct behavior
    - Move _SD object into .ram_backup section so it persists across LPM3.5
    [GPIO.h, Startup.h, main.cpp]
2021-12-10 MSPApp: finally got strategy working where SD / IMG stay powered and initialized across LPM3.5.
2021-12-10 MSPApp: switch back to strategy where we turn SD/Img on every time MSP wakes
2021-12-10 Flash LED when capturing an image, rather than when waking/sleeping
2021-12-10 STLoader: MSP430.h issue a BOR (instead of a POR) when disconnecting JTAG
    [MSP430.h]
2021-12-10 MSPApp: make Startup::ColdStart() inspect SYSRSTIV for the reset reason, instead of PMMIFG.PMMLPM5IFG, because PMMIFG.PMMLPM5IFG isn't reset when the JTAG programmer issues a BOR.
    [Startup.h]
2021-12-11 MSPApp:
    - Set initial exposure before starting streaming
    - Use skip=0 on the first frame capture, since the first frame has the correct exposure
    [main.cpp]
2021-12-17 Combined changes from scratch/MSPAppThreads:
    - Task.h: implement real threads (instead of protothreads)
    - MSPApp: migrate to use new thread-based Task.h
    - MSPApp: re-create CCS project that uses GCC and compiles with C11/C++17
    - MSPApp: add WDT.h to handle watchdog configuration
    - STLoader: MSP430.h: manually reset SYSRSTIV when loading a program to simulate an initial power-on
    - STLoader: MSP430.h: fix issue where a MSP430 program doesn't run when loaded with MDCUtil 'mspload', if TI CCS previously loaded a program that entered LPM3.5
    - Task.h: Add test project (Code/MSP430/ThreadTest-LaunchpadFR)
    [Clock.h, GPIO.h, ICE.h, ImgSensor.h, MSP430.h, QSPI.h, SDCard.h, SPI.h]
2021-12-17 - STLoader/STApp: fix alignment of data that's sent via USB - MSPApp: cleanup
    [ICE.h, USBBase.h, main.cpp]
2021-12-18 Combined changes from scratch/TaskAsyncRunConcept:
    - Task.h: make Start() accept arbitrary functions (including lambda functions), so Tasks aren't limited to running a single function
    - MSPApp: make SD::Card / Img::Sensor / ICE classes accept templated arguments
    - MSPApp: initialize Img / SD card in parallel to save time
    - MSPApp: implement power-saving version of delayUs/delayMs that uses the timer peripheral, and makes the CPU go to sleep
    - MSPApp: don't wait for SD/IMG to be initialized in _SetSDImgEnabled(); only wait for them when we actually need to use them
    - MSPApp: move SleepMs/SleepUs functions to Scheduler (instead of Sleep.h / main.c)
    - MSPApp: ensure all bina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
2021-12-22 Combined changes from scratch/STLoaderTaskMigration:
    - STLoader: overhaul to use new thread-based Task.h
    - STLoader: #define _Subtasks so that we can reset all of them
    - STLoader/STApp: Align VectorTable to 512 bytes, as required by VTOR register
    - STLoader: adjust stack sizes to prevent stack overflows
    - STLoader/STApp: make QSPI a template
    - STLoader/STApp: make BufQueue contain the buffers themselves
    - Migrate __attribute((section("XXX"))) -> [[gnu::section("XXX")]]
    - MSPApp: make SDCard a non-static class again, since it has an ivar
    - Add:
    STM32F730-MPU.pdf
    MSP430EmbeddedApplicationBinaryInterface.pdf
    MSP430GCCToolchain.pdf
    ARMCortexM7DevicesGenericUserGuide.pdf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
    [Img.h, MSP430.h, QSPI.h, SDCard.h, Scheduler.h, Startup.cpp, Startup.h, System.h]
2021-12-23 stm32cubeide.project.prefs changes
2021-12-23 Combined changes from scratch/STAppTaskMigration
    - STApp: migrate to use real threads
    - STApp: replace uses of HAL_Delay with Scheduler::Sleep
    - STApp: working again, including image streaming / SD card reading
    - STLoader/STApp: factor-out common functionality into System.h
    - STLoader: fix position of VectorTable in memory
    [QSPI.h, Startup.cpp, Startup.h, System.h, USBBase.h, main.cpp]
2021-12-23 STApp/STLoader: Get abort() working even when System init fails
    [System.h]
2021-12-23 MSPApp/STApp/STLoader: modify WaitForInterrupt behavior by causing interrupts to always be enabled upon wake
2021-12-23 STLoader/STApp: fix include paths to use -iquote (instead of -I) so that system headers don't include our version of Assert.h (because macOS case-insentivity allows it to be referred to as assert.h)
    [QSPI.h, System.h]
2022-01-07 ThreadTest-LaunchpadFR: get compiling again
2022-01-07 Supply error handlers to ICE/ImgSensor/SDCard
    [ICE.h, ImgSensor.h, SDCard.h, main.cpp]
2022-01-07 MSPApp: fix Scheduler::Sleep() race condition that causes us to sleep way too long
    [SPI.h, main.cpp]
2022-01-07 Working on implementing proper error handling / recovery
    [RTC.h, Startup.h, main.cpp]
2022-01-10 MSPApp:
    - add ability to read FRAM regions
    - make FRAM data structure resilient to power loss during modifications
2022-01-10 MSPApp: _ImgRingBufInit: fix logic
    [main.cpp]
2022-01-10 - MSPApp/ICEApp: Update image header implementation so that the end of the header has a gap (instead of the previous 'section' implementation that had 2-byte gaps after each section.)
    - MSPApp: Update time tracking so that the current time is always a (start, delta)
    tuple, and use this format in the image header as well as the abort history.
    With this technique, we always retain the relative time of images/aborts, even
    if we don't have the system start time. Additionally, the start time field
    provides an explicit indicator of whether we have a valid start time (and
    therefore a valid absolute time), or merely have a valid relative time.
2022-01-27 STApp/STLoader: get compiling again by adding error functions Rename MDCDevice -> MDCUSBDevice
    [MDCUSBDevice.h, System.h, main.cpp]
2022-01-28 Add Tools/MDCStudio. Grid view working well, and it tracks the MDC devices being connected/disconnected. Next: implement source list UI.
2022-01-30 STMApp/STMLoader: Move ICE/MSP functionality from STMLoader -> STMApp, so that the only thing STMLoader does is bootload STM32
    STMApp is currently too large to fit now though...
    [STM.h, System.h, USB.h, main.cpp]
2022-01-31 STMApp: QSPI: implemented dynamic configuration changing so we can switch between ICEWrite and ICEApp comms
2022-01-31 CRC7Test: fix CRC printing (previously the high/8th bit wasn't getting printed, because left-shifting a 7-bit value doesn't result in an 8-bit value)
    [Top.v]
2022-01-31 SDController.v: fix CRC calculation bug in calculating CRC for SD card responses.
    The first CRC bit of the SD card's response was affecting the SDController's CRC calculation. It's unclear why this didn't break SDController's CRC calculation though; perhaps the math just works out and the CRC always matches.
    [SDCardSim.v, SDController.v]
2022-02-01 MSPApp/STApp/STLoader: switch back to having sleep function return with interrupts in the same state as when called
    MSPApp: rate-limit aborting so we don't keep aborting too quickly
2022-02-01 MSPApp: Working on getting SD card capacity
2022-02-02 MSPApp: implemented getting capacity of SD card, and verifying SD card id matches
2022-02-02 MSPApp: Revert ImgTask stack back to 128 bytes, since we accidentally increased it to 256 bytes
    [main.cpp]
2022-02-03 ThreadTest-LaunchpadFR: updates to test Task::Wait timeout
2022-02-04 SDController: started implementing separate SD commands for SD set clock delay / set clock speed / reset / init, but think we should go back to having a single command
    [ICEApp.v, ICEAppTypes.v]
2022-02-04 Revert "SDController: started implementing separate SD commands for SD set clock delay / set clock speed / reset / init, but think we should go back to having a single command"
    This reverts commit 828335ef85c5cacb79753f7d89cef7fab1a56c18.
    [ICEApp.v, ICEAppTypes.v]
2022-02-05 ICEAppSim: implement TestSDReset to test SDController reset action
    [ICEAppSim.v]
2022-02-05 ICEAppSim.v: reset SDController at the beginning too, to validate that it has no effect
    [ICEAppSim.v]
2022-02-05 STMApp: use -O0 for debugging, and comment-out code so it fits. Need to revert this commit.
    [main.cpp]
2022-02-05 Revert "STMApp: use -O0 for debugging, and comment-out code so it fits. Need to revert this commit."
    This reverts commit 340da5baeece6d284075553001fc935556513c56.
    [main.cpp]
2022-02-05 MSPApp: debugging. Need to revert
    [main.cpp]
2022-02-05 Revert "MSPApp: debugging. Need to revert"
    This reverts commit 459dcef82b8b95ebca89e3db05dd6e62abf99ccd.
    [main.cpp]
2022-02-06 Synth.py: print asterick next to the considered clocks (defined in a project's Clocks.py)
2022-02-07 STMApp: fix _ICE_ST_SPI_CS_ output by manually configuring it if QSPI doesn't control it
    [QSPI.h, main.cpp]
2022-02-08 MSPApp/etc: fix overflow bug causing us to start writing from the beginning of the SD card after only 720 images
    This was caused a uint32_t address overflowing, because (720*(32+2304*1296*2)) = 4,299,840,000 > 0xFFFFFFFF. We fixed this by using SD card 512-byte block indexes everywhere, instead of using 32-bit addresses, since we give the SD card a 512-byte block index anyway, and never actually use the address itself.
    [Img.h, ImgSD.h, MDCDevice.h, MDCUSBDevice.h, MSP.h, SDCard.h, STM.h, main.cpp]
2022-02-09 RecordStore.h: make RecordStore index extensible by returning a ifstream/ofstream from read()/write()
    This allows ImageLibrary.h to read/write additional data, while having it tightly coupled with the RecordStore itself.
    [ImageLibrary.h, RecordStore.h]
2022-02-09 MDCStudio: fix image grid being drawn incorrectly at startup
    [ImageLibrary.h]
2022-02-10 STMApp: fix icewrite not working after first invocation
    [main.cpp]
2022-02-10 MDCStudio: Fix corrupt images appearing on subsequent image loads (due to using ImgPaddedLen instead of ImgBlockCount)
    [MDCDevice.h]
2022-02-11 MDCStudio:
    - Started integrating source list
    - Disable header maps to prevent header name conflicts, and require absolute-ish paths to headers (eg Code/Shared/XXX.h, Tools/Shared/XXX.h)
    [ICE.h, ImageLibrary.h]
2022-02-11 MDCStudio: device connect/disconnect reflected in source list
2022-02-11 MDCStudio: ImageGridView: monitor current run loop mode for the event-tracking run loop mode, so we can call -setResizingUnderway:true on ImageGridLayer. Don't think we should actually use this thoug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
2022-02-13 MDCStudio: preparing to make device names editable
2022-02-13 MDCStudio: changing device name working
2022-02-20 MDCStudio: ImageView: rendering thumbnail. Need to implement drawing with correct aspect ratio.
    [MDCDevice.h, Renderer.h]
2022-02-20 MDCStudio: ImageGridView: switch to delegate pattern instead of using a handler block
2022-02-21 MDCStudio: ImageView: implemented animation when using arrow keys to switch between images, but disabled it because it's distracting
2022-02-22 MDCStudio: MDCUSBDevice.h: debug prints
2022-02-25 MDCStudio: ImageCache.h: fix image-loading race (check for work before sleeping, not after sleeping). Update notes.
    [MetalScrollLayer.h]
2022-02-27 MDCStudio: LayerScrollView: observe document view frame changes so we can update magnify-to-fit
2022-02-28 MDCStudio: LayerScrollView: cancel further scroll wheel handling after a zoom-in/out/etc menu invocation
2022-06-14 Rev5 board progress (combined commit from init/Rev5-combined)
    [MotionDetectorCamera.brd, MotionDetectorCamera.sch]
2022-06-15 Added TPS2116 power mux, battery charger, battery reverse polarity protection, ICE40 flash, 3V3 LDO
    [MotionDetectorCamera.brd, MotionDetectorCamera.sch]
2022-06-15 Power progress
    [MotionDetectorCamera.brd, MotionDetectorCamera.sch]
2022-06-15 Fix part MFG
    [MotionDetectorCamera.brd, MotionDetectorCamera.sch]
2022-06-15 Rename nets
    [MotionDetectorCamera.brd, MotionDetectorCamera.sch]
2022-06-15 For 2.8V rail, replace TPS63805 with TPS62802
    [MotionDetectorCamera.brd, MotionDetectorCamera.sch]
2022-06-15 Update schematic comments
    [MotionDetectorCamera.brd, MotionDetectorCamera.sch]
2022-06-15 Working on SPI flash chip-select signalling
    [MotionDetectorCamera.brd, MotionDetectorCamera.sch]
2022-06-15 Add reverse current blocking diode to LDO
    [MotionDetectorCamera.brd, MotionDetectorCamera.sch]
2022-06-15 Working on adding bypass capacitors
    [MotionDetectorCamera.brd, MotionDetectorCamera.sch]
2022-06-16 Added bypass caps
    [MotionDetectorCamera.brd, MotionDetectorCamera.sch]
2022-06-16 Add ESD protection to VDD_BAT
    [MotionDetectorCamera.brd, MotionDetectorCamera.sch]
2022-06-16 Connect to STM32: BAT_CHRG_STAT, BAT_CHRG_LVL, BAT_CHRG_LVL_EN_
    [MotionDetectorCamera.brd, MotionDetectorCamera.sch]
2022-06-16 Create ICE_ST_SPI_D_READY net between ICE40.L5 <-> STM32.R3
    [MotionDetectorCamera.brd, MotionDetectorCamera.sch]
2022-06-16 Move: ICE_MSP_SPI_CLK -> K2 ICE_MSP_SPI_DATA -> K3
    [MotionDetectorCamera.brd, MotionDetectorCamera.sch]
2022-06-16 Add part number for ESD diode
    [MotionDetectorCamera.brd, MotionDetectorCamera.sch]
2022-06-16 Add JST connector for battery
    [MotionDetectorCamera.brd, MotionDetectorCamera.sch]
2022-06-17 Switch USB jack from USB-mini -> USB-C
    [MotionDetectorCamera.brd, MotionDetectorCamera.sch]
2022-06-17 Add PCB/USBCFootprintTest.brd PCB/USBCFootprintTest.sch
    [USBCFootprintTest.brd, USBCFootprintTest.sch]
2022-06-17 Revert "Add PCB/USBCFootprintTest.brd PCB/USBCFootprintTest.sch"
    This reverts commit cd78f1c1cdfb7c804ff5fe7fcf4c141f538fcc16.
    [USBCFootprintTest.brd, USBCFootprintTest.sch]
2022-06-17 USB C jack: attach 5.1k pull-downs to CC1/CC2
    [MotionDetectorCamera.brd, MotionDetectorCamera.sch]
2022-06-17 Schematic comments
    [MotionDetectorCamera.sch]
2022-06-18 Correct (swap) ICE SPI flash's data in/out pins so that by default, the flash is ready to be read by ICE40, but STM32 can program it by bit-banging ICE_ST_SPI_D0 / ICE_ST_SPI_D1.
    (To program the SPI flash, STM32 has to bitbang instead of using the
    QSPI peripheral because ICE_ST_SPI_D0 is wired between STM32's
    QSPI output <-> SPI flash output, and ICE_ST_SPI_D1 is wired between
    STM32's QSPI input <-> SPI flash input. That is, we have outputs
    connected to outputs, and inputs connected to inputs. So for QSPI to
    program the flash, the wires would need to be swapped, but that would
    break the default case of ICE40 loading its configuration from SPI
    flash. So we have to bitbang so that we can swap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
    [MotionDetectorCamera.brd, MotionDetectorCamera.sch]
2022-06-22 Finished rough placement of components
    Investigating ways to make board smaller
    [MotionDetectorCamera.brd, MotionDetectorCamera.sch]
2022-06-22 Layout progresss
    [MotionDetectorCamera.brd]
2022-06-24 Add Tools/yosys Add Tools/nextpnr Add Tools/Python Update Code/ICE40/Synth.py to invoke yosys/nextpnr/icepack binaries in ../../Tools, instead of the system versions
    [boston_house_prices.csv, breast_cancer.csv, iris.csv, linnerud_exercise.csv, linnerud_physiological.csv, mt19937-testset-1.csv, mt19937-testset-2.csv, pcg64-testset-1.csv]
2022-06-24 STMApp: Make ICE40's SPI_SS_B manually controlled, instead of controlled by QSPI, in preparation for Rev5 board. (We tested configuring ICE40 with a manually-controlled SPI_SS_B and it works fine.)
    We want this because QSPI's chip select pin is physically far away from the other QSPI pins, so Rev5 routing will be easier if we use a different pin and manually control it.
2022-06-30 Bitbanging ICE40 configuration working
    [MotionDetectorCamera.brd]
2022-06-30 Swap ICE_ST_SPI_D3 and ICE_ST_SPI_D2
    [MotionDetectorCamera.brd, MotionDetectorCamera.sch]
2022-07-11 Layout progress. Motion sensor now extends off the board (which is OK because eventually it'll need a spacer + wiring to be at the same level as the lens)
    [MotionDetectorCamera.brd]
2022-07-11 Layout progress. Connect STM32 BOOT0 directly to GND instead of through a resistor.
    [MotionDetectorCamera.brd, MotionDetectorCamera.sch]
2022-07-11 Layout progress. Fixed all DRC errors except airwires (176)
    [MotionDetectorCamera.brd]
2022-07-11 Layout progress; airwires: 170
    [MotionDetectorCamera.brd]
2022-07-11 Layout progress; airwires: 161
    [MotionDetectorCamera.brd, MotionDetectorCamera.sch]
2022-07-11 Layout progress; airwires: 157
    [MotionDetectorCamera.brd]
2022-07-11 Layout progress; airwires: 152
    [MotionDetectorCamera.brd]
2022-07-12 Layout progress; airwires: 139
    [MotionDetectorCamera.brd, MotionDetectorCamera.sch]
2022-07-12 Layout progress; airwires: 125
    [MotionDetectorCamera.brd]
2022-07-12 Layout progress; airwires: 113
    [MotionDetectorCamera.brd]
2022-07-12 Layout progress; adjust USB D+ and D-
    [MotionDetectorCamera.brd]
2022-07-12 Layout progress; airwires: 108
    [MotionDetectorCamera.brd]
2022-07-12 Layout progress; airwires: 105
    [MotionDetectorCamera.brd]
2022-07-12 Layout progress; airwires: 102
    [MotionDetectorCamera.brd]
2022-07-12 Layout progress; airwires: 95
    [MotionDetectorCamera.brd]
2022-07-12 Add jumper to VDD_BAT so we can test reverse polarity without risking breaking anything
    [MotionDetectorCamera.brd, MotionDetectorCamera.sch]
2022-07-12 Layout progress; airwires: 91
    [MotionDetectorCamera.brd]
2022-07-12 Layout progress; airwires: 77
    [MotionDetectorCamera.brd]
2022-07-12 Layout progress; airwires: 69 (done placing STM bypass caps)
    [MotionDetectorCamera.brd]
2022-07-12 Layout progress; length-matched IMG traces
    [MotionDetectorCamera.brd]
2022-07-12 Layout progress; airwires: 69 (again)
    [MotionDetectorCamera.brd]
2022-07-12 Layout progress; length-matched SD traces
    [MotionDetectorCamera.brd]
2022-07-12 Layout progress; airwires: 58
    [MotionDetectorCamera.brd, MotionDetectorCamera.sch]
2022-07-12 Layout progress; airwires: 56
    [MotionDetectorCamera.brd]
2022-07-13 Layout progress; adding vias to all VDD_* nets. Airwires: 79 (higher because we deleted most of the power layer)
    [MotionDetectorCamera.brd]
2022-07-13 Layout progress; airwires: 41
    [MotionDetectorCamera.brd]
2022-07-13 Layout progress; airwires: 40
    [MotionDetectorCamera.brd]
2022-07-13 Layout progress; airwires: 34
    [MotionDetectorCamera.brd]
2022-07-13 Layout progress; airwires: 30
    [MotionDetectorCamera.brd]
2022-07-13 Layout progress; airwires: 29
    [MotionDetectorCamera.brd]
2022-07-13 Layout progress; airwires: 27
    [MotionDetectorCamera.brd]
2022-07-13 Layout progress; airwires: 26
    [MotionDetectorCamera.brd]
2022-07-13 Layout progress; airwires: 25
    [MotionDetectorCamera.brd]
2022-07-13 Layout progress; airwires: 24
    [MotionDetectorCamera.brd]
2022-07-13 Layout progress; airwires: 23
    [MotionDetectorCamera.brd]
2022-07-13 Layout progress; airwires: 21
    [MotionDetectorCamera.brd]
2022-07-13 Layout progress; airwires: 20
    [MotionDetectorCamera.brd]
2022-07-13 Layout progress; airwires: 19
    [MotionDetectorCamera.brd]
2022-07-13 Layout progress; airwires: 17
    [MotionDetectorCamera.brd]
2022-07-13 Layout progress; airwires: 16
    [MotionDetectorCamera.brd]
2022-07-13 Layout progress; airwires: 15
    [MotionDetectorCamera.brd]
2022-07-13 Layout progress; airwires: 14
    [MotionDetectorCamera.brd]
2022-07-13 Layout progress; airwires: 13
    [MotionDetectorCamera.brd]
2022-07-13 Layout progress; airwires: 12
    [MotionDetectorCamera.brd]
2022-07-13 Layout progress; airwires: 11
    [MotionDetectorCamera.brd]
2022-07-13 Layout progress; airwires: 10
    [MotionDetectorCamera.brd]
2022-07-13 Layout progress; airwires: 9
    [MotionDetectorCamera.brd]
2022-07-13 Layout progress; airwires: 8
    [MotionDetectorCamera.brd]
2022-07-13 Layout progress; airwires: 7
    [MotionDetectorCamera.brd, MotionDetectorCamera.sch]
2022-07-14 Layout progress; airwires: 6
    [MotionDetectorCamera.brd]
2022-07-14 Layout progress; airwires: 5
    [MotionDetectorCamera.brd]
2022-07-14 Layout progress; airwires: 4
    [MotionDetectorCamera.brd]
2022-07-14 Layout progress; airwires: 3
    [MotionDetectorCamera.brd]
2022-07-14 Commit before trying to route final 3 airwires
    [MotionDetectorCamera.brd, MotionDetectorCamera.sch]
2022-07-14 Working on 3rd-to-last airwire
    [MotionDetectorCamera.brd]
2022-07-14 Layout progress; airwires: 2
    [MotionDetectorCamera.brd]
2022-07-14 Working on fixing final drc errors
    [MotionDetectorCamera.brd]
2022-07-14 DRC clean!
    [MotionDetectorCamera.brd]
2022-07-15 Length-match SD traces again
    [MotionDetectorCamera.brd]
2022-07-15 Add ground island for MSP430 crystal
    [MotionDetectorCamera.brd]
2022-07-15 MSP430 crystal: give each capacitor its own GND via
    [MotionDetectorCamera.brd]
2022-07-15 Add ground vias
    [MotionDetectorCamera.brd]
2022-07-15 Add more vias
    [MotionDetectorCamera.brd]
2022-07-15 Clean up part labels on top layer, still need to do bottom layer
    [MotionDetectorCamera.brd]
2022-07-15 Fix part labels on bottom
    [MotionDetectorCamera.brd]
2022-07-15 Fix part labels
    [MotionDetectorCamera.brd]
2022-07-15 Update ICE40 Pins.pcf for Rev5 board (the pins moved around a bit).
    Remove ice_st_spi_d_ready_rev4bodge for Rev5 board.
    Re-optimize ICE40 designs:
    * ICEAppMSP
    -----------------------------------------------------------
    Clk Freq
    -----------------------------------------------------------
    ICEApp.SDController.clk_slow 166.78
    ICEApp.readoutfifo_r_clk_$glb_clk 138.89 *
    ICEApp.sd_clk_int 365.23
    ICEApp.spi_clk_$glb_clk 103.03
    ice_img_clk16mhz$SB_IO_IN 116.95
    img_dclk$SB_IO_IN_$glb_clk 133.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
2022-07-15 Move board origin to 0,0
    [MotionDetectorCamera.brd]
2022-07-15 Add 'MDC Rev 5' text
    [MotionDetectorCamera.brd]
2022-07-15 Cleanup part labels
    [MotionDetectorCamera.brd]
2022-07-15 Update cream size for transistor layout
    [MotionDetectorCamera.brd, MotionDetectorCamera.sch]
2022-07-15 Add part numbers for capacitors / resistors that didn't have them
    [MotionDetectorCamera.brd, MotionDetectorCamera.sch]
2022-07-18 Update part numbers for some passives so we can order all of them from Mouser
    [MotionDetectorCamera.brd, MotionDetectorCamera.sch]
2022-07-18 Update EagleLibrary
    [MotionDetectorCamera.brd, MotionDetectorCamera.sch]
2022-08-07 Renderer.h: updates from Soldermask project
2022-08-07 Update PCB/EagleLibrary
2022-08-08 Fix R11 part number (it had the part number for a 3k resistor instead of the correct 86.6k)
    [MotionDetectorCamera.brd, MotionDetectorCamera.sch]
2022-08-15 Update notes for U8 picking wrong voltage
2022-08-15 STMApp: bring up LEDs
2022-08-15 Revert to using QSPI for ICEWrite, when writing to the ICE40 RAM
    In this commit:
    commit bff11843228629d75b07b4b90f5142fcb2295491 (scratch/DebuggingQSPIICE40ConfigEntry)
    Author: Dave <dave@toaster.llc>
    Date: Wed Jun 29 21:57:38 2022 -0700
    Bitbanging ICE40 configuration working
    we switched to bit-banging when writing to the ICE40 RAM, but it turns out
    we need to bit-bang when writing to the ICE40's flash, not when writing to
    its RAM. (We still need to implement writing to the ICE40 flash.)
    [main.cpp]
2022-08-15 Correct _ICE_CRST_ / _ICE_CDONE ports/pins
    [main.cpp]
2022-08-15 Connect ICE40.SO to ICE40Flash.DI
    This fixes a Rev5 bug where ICE40 couldn't send commands to its ICE40Flash because ICE40.SO wasn't connected to ICE40Flash.DI
    [MotionDetectorCamera.brd, MotionDetectorCamera.sch]
2022-08-15 Revert "Connect ICE40.SO to ICE40Flash.DI"
    This reverts commit 8b430a49d7f7fb6e6fb81b3b916ba9443fa0bfad.
    [MotionDetectorCamera.brd, MotionDetectorCamera.sch]
2022-08-16 Progress fixing ICE40 flash connections
    [MotionDetectorCamera.brd, MotionDetectorCamera.sch]
2022-08-16 Finished fixing ICE40 flash connections. Now STM32's QSPI can program ICE40Flash, and STM32 will bitbang to program ICE40RAM.
    [MotionDetectorCamera.brd]
2022-08-16 Add PCB/MotionDetectorCamera-Rev5.sch / PCB/MotionDetectorCamera-Rev5.brd for reference
    [MotionDetectorCamera-Rev5.brd, MotionDetectorCamera-Rev5.sch]
2022-08-17 Update Notes: U8: voltage selection broken again
2022-08-17 MDCStudio: get working with Rev5 board
2022-08-18 Fixes for Rev6:
    √ Bug: MSP430 browns-out when asserting VDD_B_EN
    √ Bug: U16 level shifter that controls MSP_TEST / MSP_RST_ causes MSP_RST_ to be driven low when
    connecting device to USB power.
    √ Add a open-drain signal from STM -> MSP, which MSP observes to prevent itself from running when STM32 asserts
    √ Bug: BAT_CHRG_LVL voltage divider resistance is too high for STM32 ADC input resistance
    √ Bug: BAT_CHRG_LVL_EN_ is subjecting STM32 to the battery voltage when STM32 is off,
    which is > the absolute maximum input voltage on FT pins of VDD+4.0
    [MotionDetectorCamera.brd, MotionDetectorCamera.sch]
2022-08-18 Updates for Rev6. Update Notes.
    [MotionDetectorCamera.brd, MotionDetectorCamera.sch]
2022-08-18 PCB: rename MSP_EN -> MSP_RUN
    [MotionDetectorCamera.brd, MotionDetectorCamera.sch]
2022-08-18 MSPApp/STMApp/MDCStudio: progress implementing time tracking / MSP_RUN behavior (which prevents MSPApp from running, but does allow MSP to track time via RTC and its interrupts)
    [MDCDevice.h, MDCDevicesManager.h, MDCUSBDevice.h, STM.h, main.cpp]
2022-08-19 Debugging MSP430 clock broken
    [main.cpp]
2022-08-19 Revert "Debugging MSP430 clock broken"
    This reverts commit 0e914fa379e759050c21e0e42b213dade603a33c.
    [main.cpp]
2022-08-20 MSPApp: fix Clock.h so that it takes 800us (instead of 200ms) to start
    [Clock.h, RTC.h, main.cpp]
2022-08-30 MSPApp: Implement host mode so that MSP can keep running (to keep track of time) while STM talks to SD / IMG
    This is a combined commit from scratch/Rev5/HostMode-MSPDebug-2
2022-08-31 Change thumbnail size. Perform thumbnail loading synchronously on the main thread.
2022-09-03 ImgController.v: passing simulation tests. Still need to implement pixel filtering for thumbnails.
2022-09-03 ImgController.v: implemented pixel filtering for thumbnails
2022-09-03 ImgController.v: fixing readout bugs
    [ImgController.v]
2022-09-03 ImgController.v: added Delay readout state. Appears to have broken readout. Debugging...
    [ImgController.v]
2022-09-03 ImgController.v: fix Delay state bugs from last commit
    [ImgController.v]
2022-09-04 ImgControllerSim: fix Top.v for PixelValidator changes
    [Top.v]
2022-09-07 SDController.v / ImgController.v: add done signal so that thumbnail readout works properly.
    This is necessary because when reading out a thumbnail, SDController can no longer rely on the AFIFOChain being empty to mean there's no more data coming. Previously SDController could rely on AFIFOChain's empty flag because ImgController would produce data faster than SDController could consume it, but that's no longer true when reading out thumbnails, because ImgController filters entire image rows and doesn't produce data during that time.
    [ICEApp.v, ICEAppTypes.v, ImgController.v, ImgSim.v, SDController.v]
2022-09-07 Revert "ImgController.v: perf: try adding another state to set readout_done instead of using this `ctrl_shiftout_nextReadoutDone` technique"
    This reverts commit cb14c691b8f81b2d9013de246d4bcb20044063dc.
    [ImgController.v, NextpnrArgs.py]
2022-09-07 Debugging another ImgController problem (incorrect checksum)
    [ICEAppTypes.v, ImgController.v]
2022-09-08 ImgController.v: fix checksum issue, but maybe we can find a faster solution
    ICEApp.readoutfifo_r_clk_$glb_clk 137.93 *
    ICEApp.spi_clk_$glb_clk 106.38
    ice_img_clk16mhz$SB_IO_IN 121.01
    img_dclk$SB_IO_IN_$glb_clk 134.83 *
    ram_clk$SB_IO_OUT_$glb_clk 126.42 *
    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
    [ImgController.v, NextpnrArgs.py]
2022-09-08 ImgController.v: think we have the correct logic now. Would like to clean up though...
    [ImgController.v, Top.v]
2022-09-08 ImgController.v: fix readout_ready bug
    [ImgController.v]
2022-09-08 ImgController.v: fix another logic bug
    [ImgController.v]
2022-09-08 ImgController.v: invert if conditionals. Didn't seem to help perf.
    [ImgController.v]
2022-09-08 Revert "ImgController.v: invert if conditionals. Didn't seem to help perf."
    This reverts commit 4959eb8da812e1dc1c9c08b6b7807d7db5dbd008.
    [ImgController.v]
2022-09-08 Revert "ImgController.v: perf: try adding an additional register to RAMController output"
    This reverts commit 98f3f4e3c687251ca0803d1690ffa348c7c3a3a4.
    [ImgController.v]
2022-09-08 Revert "ImgController.v: add ctrl_readout_rowEnding register"
    This reverts commit fcbdfa6519ffc91d0b3423528c0cc176f57124d0.
    [ImgController.v]
2022-09-08 Revert "ImgController.v: perf: experiment with removing the Delay state"
    This reverts commit 2b49ea1e90877eac089045bf2a95d1e1308d5515.
    [ImgController.v, NextpnrArgs.py]
2022-09-09 Synth.py: switch clkMin back to 130MHz
2022-09-09 ImgController.v: fix bug where interrupting ImgController with a new command didn't work properly
    [ImgController.v]
2022-09-09 Debug code, need to revert
    [MDCDevice.h, main.cpp]
2022-09-10 ICEAppSim.v: initialize arg to 0 to prevent driving x's on SPI data lines
    [ICEAppSim.v]
2022-09-11 STMApp: Fix SD readout reading invalid data
    The problem was that our ICE40 changes to support thumbnails changed some timing, and required an adjustment to SDCard's clock delay (T_ClkDelayFast).
    [main.cpp]
2022-09-11 MDCStudio: remove debug code
    Thumbnail reading finally seems to be working, albeit with corrupt thumbnails because ICE40 has a bad connection to the image sensor
2022-09-11 MDCStudio: don't reference BufQueue buffer after calling rpop()
    Print consumer timing for each chunk instead of for all images
2022-09-12 MSPApp: fix bug where we were incrementing the ring buffer twice for every image capture (once for thumbnail, once for full-size image), instead of once
    [main.cpp]
2022-09-12 MSPApp: revert debug code
    [main.cpp]
2022-09-12 Combine rails because they're always on at the same time:
    VDD_B_1V8_IMG & VDD_B_1V8_SD -> VDD_B_1V8_IMG_SD
    VDD_B_2V8_IMG & VDD_B_2V8_SD -> VDD_B_2V8_IMG_SD
    [MotionDetectorCamera.brd, MotionDetectorCamera.sch]
2022-09-13 Have STM control the VDD_B_X_EN rails directly, to clean up MSP's host-mode logic
    [MotionDetectorCamera.brd, MotionDetectorCamera.sch]
2022-09-13 Make STM nets consistently named 'STM', not 'ST'
    Eg: ICE_ST_FLASH_EN -> ICE_STM_FLASH_EN
    [MotionDetectorCamera.brd, MotionDetectorCamera.sch]
2022-09-13 Replace U8 with a reliable 2.8V buck
    [MotionDetectorCamera.brd, MotionDetectorCamera.sch]
2022-09-13 Migrated all VDD bucks to TPS62A01DRLR
    [MotionDetectorCamera.brd, MotionDetectorCamera.sch]
2022-09-14 Switch to smaller lens holder (PT-LH008P)
    [MotionDetectorCamera.brd, MotionDetectorCamera.sch]
2022-09-14 Move USB-C connector to front of board
    [MotionDetectorCamera.brd]
2022-09-14 Replace battery connector with a smaller version, and move it to the front of the board
    [MotionDetectorCamera.brd, MotionDetectorCamera.sch]
2022-09-14 Replace STM32 header with 6-pin TagConnect
    [MotionDetectorCamera.brd, MotionDetectorCamera.sch]
2022-09-14 Remove old STM32 header
    [MotionDetectorCamera.brd, MotionDetectorCamera.sch]
2022-09-15 Move MSP430 to re-orient the MSP SBW pins closer to their STM drivers
    [MotionDetectorCamera.brd]
2022-09-17 120 airwires
    [MotionDetectorCamera.brd]
2022-09-18 110 airwires
    [MotionDetectorCamera.brd, MotionDetectorCamera.sch]
2022-09-18 100 airwires
    [MotionDetectorCamera.brd]
2022-09-18 87 airwires
    [MotionDetectorCamera.brd, MotionDetectorCamera.sch]
2022-09-18 80 airwires
    [MotionDetectorCamera.brd]
2022-09-18 70 airwires
    [MotionDetectorCamera.brd]
2022-09-18 67 airwires
    [MotionDetectorCamera.brd, MotionDetectorCamera.sch]
2022-09-18 64 airwires
    [MotionDetectorCamera.brd]
2022-09-18 60 airwires
    [MotionDetectorCamera.brd]
2022-09-18 40 airwires
    [MotionDetectorCamera.brd]
2022-09-18 39 airwires
    [MotionDetectorCamera.brd]
2022-09-18 38 airwires
    [MotionDetectorCamera.brd]
2022-09-18 36 airwires
    [MotionDetectorCamera.brd]
2022-09-18 32 airwires
    [MotionDetectorCamera.brd]
2022-09-18 30 airwires
    [MotionDetectorCamera.brd]
2022-09-18 Laid out ICE40 leds; 22 airwires to go
    [MotionDetectorCamera.brd, MotionDetectorCamera.sch]
2022-09-18 Laid out leds
    [MotionDetectorCamera.brd, MotionDetectorCamera.sch]
2022-09-18 12 airwires
    [MotionDetectorCamera.brd, MotionDetectorCamera.sch]
2022-09-18 9 airwires
    [MotionDetectorCamera.brd]
2022-09-18 6 airwires
    [MotionDetectorCamera.brd]
2022-09-18 4 airwires
    [MotionDetectorCamera.brd]
2022-09-18 1 airwire
    [MotionDetectorCamera.brd]
2022-09-19 0 airwires
    [MotionDetectorCamera.brd]
2022-09-19 Reposition part labels
    [MotionDetectorCamera.brd]
2022-09-19 Equalizing IMG trace lengths
    [MotionDetectorCamera.brd]
2022-09-19 Equalizing RAM trace lengths
    [MotionDetectorCamera.brd]
2022-09-19 Equalizing SD trace lengths
    [MotionDetectorCamera.brd]
2022-09-19 Make new TagConnect part that doesn't have the holes on the bottom
    [MotionDetectorCamera.brd, MotionDetectorCamera.sch]
2022-09-19 Correct placement of battery connector
    [MotionDetectorCamera.brd]
2022-09-19 Add soldermask markings for VDD / GND battery terminal leads
    [MotionDetectorCamera.brd, MotionDetectorCamera.sch]
2022-09-19 Add 'MDC Rev 6' label
    [MotionDetectorCamera.brd]
2022-09-19 Cleanup part numbers
    [MotionDetectorCamera.brd]
2022-09-19 Clean up soldermask labels
    [MotionDetectorCamera.brd]
2022-09-19 Board cleanup
    [MotionDetectorCamera.brd]
2022-09-19 Fix schematic typo
    [MotionDetectorCamera.sch]
2022-09-21 Adding bolt holes
    [MotionDetectorCamera.brd]
2022-09-21 Fixing DRC errors due to mounting holes
    [MotionDetectorCamera.brd]
2022-09-21 Fixed DRC errors after adding mounting holes
    [MotionDetectorCamera.brd]
2022-09-21 Move board to origin
    [MotionDetectorCamera.brd]
2022-09-25 Replaced USB-C receptacle with one that allows board edges to be more curved
    [MotionDetectorCamera.brd, MotionDetectorCamera.sch]
2022-09-25 0 airwires, still have dimension drc errors
    [MotionDetectorCamera.brd]
2022-09-25 Miter corners to 4.5mm
    [MotionDetectorCamera.brd]
2022-09-25 11 dimension errors
    [MotionDetectorCamera.brd]
2022-09-25 8 dimension errors
    [MotionDetectorCamera.brd]
2022-09-25 6 dimension errors
    [MotionDetectorCamera.brd]
2022-09-25 Working on routing battery cable
    [MotionDetectorCamera.brd]
2022-09-25 Working on routing battery cable
    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
    [MotionDetectorCamera.brd]
2022-09-25 Working on adding slot for battery wire
    [MotionDetectorCamera.brd, MotionDetectorCamera.sch]
2022-09-25 Added edge cutout for battery wire
    [MotionDetectorCamera.brd]
2022-09-25 4 dimension errors
    [MotionDetectorCamera.brd]
2022-09-25 0 drc errors
    [MotionDetectorCamera.brd]
2022-09-25 Moved SD card a bit to make more room for screw head
    [MotionDetectorCamera.brd]
2022-09-25 Length-match SD nets
    [MotionDetectorCamera.brd]
2022-09-25 Move mount point closer to corner
    [MotionDetectorCamera.brd]
2022-09-25 Update miter to be 4.75mm
    [MotionDetectorCamera.brd]
2022-09-25 Add battery wire cutout again
    [MotionDetectorCamera.brd]
2022-09-27 Add Enclosure/Enclosure.f3d
    [Enclosure.f3d]
2022-09-28 Update enclosure
    [Enclosure.f3d]
2022-09-28 Cleanup silkscreen
    [MotionDetectorCamera.brd]
2022-09-28 Update missing schematic part numbers
    [MotionDetectorCamera.brd, MotionDetectorCamera.sch]
2022-09-28 Update schematic part numbers
    [MotionDetectorCamera.brd, MotionDetectorCamera.sch]
2022-09-28 Add notes on schematic about transistor requirements
    [MotionDetectorCamera.sch]
2022-09-28 Add junction to fix schematic warning
    [MotionDetectorCamera.sch]
2022-09-29 Add PCB/ReballStencil.brd
    [ReballStencil.brd]
2022-09-29 Add PCB/ICE40ReballStencil.brd before deleting it
    [ICE40ReballStencil.brd]
2022-10-12 Get compiling again after updates to MetalUtil.h from Soldermask
2022-10-14 STMApp: update LED ports for Rev6 board
2022-10-15 ICE40: update Pins.pcf for Rev6 board
2022-10-15 STMApp: _ICERAMWrite working on Rev6 board (via bitbanging)
2022-10-16 STMApp/MDCUtil/MDCStudio: updates for Rev6 board
2022-10-17 Getting MSPApp working on Rev6 board
2022-10-17 Add Other/MSP430FR2422/MSP430FR2422-UsersGuide-eUSCI-SPI.pdf
2022-10-17 MSPApp: capturing images working (in loop, without motion sensor)
2022-10-17 MSPApp: remove warnings for fixed TODOs
    [main.cpp]
2022-10-17 STMApp: fix power rail handling for SDInit by making _IMGSDPowerStateSet() function
    [main.cpp]
2022-10-18 Add Notes/BatteryReversePolarityCurrent.txt
2022-10-19 STMApp: started implementing battery voltage sampling with ADC
2022-10-19 STMApp: battery voltage sampling progress
2022-10-19 STMApp: battery voltage sensing working. Implemented reading charge status, haven't tested yet.
2022-10-19 STScratch: updates for ADC setup
2022-10-20 STMApp: Battery.h: update for 2/5 voltage divider
2022-10-20 Update EagleLibrary for STM32 schematic changes
    [MotionDetectorCamera.sch]
2022-10-20 Add Notes/LensProtrusion-EnclosureRev1.txt
2022-10-20 Remove PCB and Enclosure dirs, now that we created separate repos for them (MDCBoard and MDCEnclosure)
    [Enclosure.f3d, MotionDetectorCamera-Rev4.brd, MotionDetectorCamera-Rev4.sch, MotionDetectorCamera-Rev5.brd, MotionDetectorCamera-Rev5.sch, MotionDetectorCamera.brd, MotionDetectorCamera.sch]
2022-10-30 Switch to 3V3 SD initialization
    This is a combined commit from scratch/Rev6/PNY-SDCard-Fixes-SDControllerSupport3V3Init (after cleaning up a bit)
    [ICE.h, ICEApp.v, ICEAppSim.v, ICEAppTypes.v, NextpnrArgs.py, Pin.v, SDCard.h, SDCardSim.v]
2022-11-05 Remove lens notes after moving to MDCEnclosure repo
2022-11-05 Remove Notes/BatteryConnectorOptions.txt after moving to MDCEnclosure repo
2022-11-19 MDCStudio: fix image loading math to handle the case where deviceImgIdBegin > libImgIdEnd (ie writing to the SD card has wrapped around since the last image offload, and therefore images were overwri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
    [MDCDevice.h]
2022-11-20 Remove 64-bit MDCStudio::ImageId type, and use 32-bit Img::Id type instead, so that we can easily compare image ids within our library vs images on the device, to know what needs to be added/removed
2022-11-20 MDCStudio: fix Renderer.h memory leak caused by incorrect buffer storage mode comparison. This caused MDCStudio image loading to increasingly slow as more images were loaded, because MTLBuffers were 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
    [MDCDevice.h, Renderer.h]
2022-11-20 Update abort tracking to track kinds of aborts, instead of each specific abort
2022-11-20 Update SPI reset strategy
    [main.cpp]
2022-11-20 Reset ICE comms between attempts to init
    [ICE.h, main.cpp]
2022-12-03 MSPApp: working on I2C peripheral for MSP<->STM comms. Added Code/MSP430/I2CTest test project.
2022-12-03 MSPApp: progress implementing I2C peripheral
2022-12-03 MSPApp: progress implementing I2C peripheral.
    MSP430 I2C peripheral seems to be working with FTDI cable running in I2C mode
2022-12-03 MSPApp: integrate I2C peripheral, and add _I2CTask
2022-12-05 MSPApp: clean up I2C peripheral
2022-12-05 MSPApp: fix compiler error
    [I2C.h]
2022-12-06 I2CTest: experiment to test whether UCCLTOIFG interrupt fires generally, or only during an I2C transaction (answer: only during an I2C transaction)
2022-12-06 Revert "I2CTest: experiment to test whether UCCLTOIFG interrupt fires generally, or only during an I2C transaction (answer: only during an I2C transaction)"
    This reverts commit 360d100c620e3ed271fcd5f8904eae7c4652a107.
    [I2C.h, main.cpp]
2022-12-13 MetalScrollLayer -> FixedMetalDocumentLayer, etc. ScrollViewTest still works, amazingly.
    [FixedMetalDocumentLayer.h, FixedScrollView.h]
2022-12-16 FixedScrollView.h: working on anchoring to center when initially appearing
    [FixedScrollView.h]
2022-12-20 STMApp: Battery.h: remove ADC stuff since STM no longer senses battery voltage (only MSP does)
    [main.cpp]
2022-12-20 ICE40: Pins.pcf for Rev7 board
2022-12-20 STMApp: ICERAMWrite: switch back to using QSPI to configure ICE40, instead of bitbanging. We want this because MDCStudio will call ICERAMWrite often, and will call ICEFlashWrite seldomly.
    Revert "STMApp: convert _ICERAMWrite to bitbang instead of using QSPI. Untested."
    This reverts commit 0229f7068ce34ffb066e4f329d9808e41f6cd890.
    [QSPI.h, main.cpp]
2022-12-20 STMApp: ICEFlashRead/ICEFlashWrite: swap uses of _ICE_ST_SPI_D4 / _ICE_ST_SPI_D5 to match Rev7 board
    [main.cpp]
2022-12-20 MDCUtil: ICEFlashWrite: if written data doesn't match the read-back data, write the read-back data to a file
    [main.cpp]
2022-12-20 STMApp: Update MSP TEST/RST_ pins for Rev7 board
2022-12-20 STMApp: Remove _VDD_B_1V8_IMG_SD_EN / _VDD_B_2V8_IMG_SD_EN pins since STM doesn't directly control the rails anymore (it has to talk to MSP)
    [main.cpp]
2022-12-20 MSPApp: update pins for Rev7 board
2022-12-21 STMApp: MSP430JTAG.h: remove CRC functionality because it doesn't work with odd-sized regions (which apparently GCC produces), and because we already read the data that we write back, which is a bett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
    [MSP430JTAG.h, main.cpp]
2022-12-21 MSPApp: SPI.h: switch back UCB0 -> UCA0
2022-12-21 MSPApp: make SPI clock run at 250 kHz while we have our TXB0102 debugging resistor/capacitors installed on the board
2022-12-21 MSPApp: Bringup: disable actual code for now, just blink ICE40 leds
2022-12-21 MSPApp: Fix GPIO init
    [main.cpp]
2022-12-21 MSPApp: Temporarily switch SPI block back to 16 MHz to gather scope data
2022-12-22 MSPApp: SPI.h: switch to 1 MHz clock
2022-12-22 ICE40: add support for SD_PULLUP_1V8_EN_ control signal, new on Rev7 board
2022-12-22 MSPApp: fix abort logging. Update SDCard.h sleep times now that we're using a 400kHz clock.
    [SDCard.h, main.cpp]
2022-12-22 MSPApp: I2C updates to monitor VDD_B_3V3_STM transitions, so that we can interrupt our I2C transactions. This is necessary, for example, to detect STM32 being unpowered when unplugging from USB.
2022-12-22 MSPApp: started implementing I2C protocol
2022-12-22 STMApp: started implementing I2C peripheral
2022-12-22 MSP.h: I2C protocol updates
2022-12-22 STScratch: add I2C peripheral, remove ADC peripheral
2022-12-22 STMApp: started adding I2C implementation
2022-12-23 STMApp: remove ADC files
2022-12-23 STScratch: enable I2C interrupts
2022-12-23 STMApp: enable I2C interrupts
2022-12-23 STMApp: I2C peripheral progress
2022-12-23 STMApp: I2C progress
2022-12-23 MSPApp/STMApp: I2C progress
2022-12-23 Update I2C source files from STScratch project
2022-12-23 STMApp: I2C interrupts seem to be firing. I2C comms with MSP not working yet.
    [I2C.h, QSPI.h]
2022-12-23 MSP<->STM I2C comms working!
2022-12-23 STMApp: don't blink red MSP led so there's no ambiguity with the red led illuminating when MSP resets / aborts. In other words, if the red MSP led turns on, it's because MSP reset or aborted.
    [System.h]
2022-12-23 MSPApp: Exit host mode when I2C is disabled
2022-12-23 MSPApp: implement OutputPriority class, so that values written to LEDs can have priorities, that can be reset when we exit host mode
    [main.cpp]
2022-12-23 MSPApp: started implementing Battery.h
2022-12-23 MSPApp: reference _Battery::Pin for GPIO::Init() call
2022-12-23 FixedScrollView: redesign how content sizing works so that it's compatible with MDCStudio's image grid view (which has a dynamic height depending on the window width)
    [FixedScrollView.h]
2022-12-23 MSPApp: implement StateRead and StateWrite I2C commands
2022-12-23 MSPApp/STMApp/MDCStudio: progress implementing MSP state read/write via I2C
2022-12-24 MSPApp: add TimeSet I2C command
2022-12-24 STMApp/MSPApp: compiling again, time to see if we can offload images on Rev7 board yet
2022-12-24 STMApp: I2C: protect against multiple threads performing I2C transactions concurrently
2022-12-24 Debugging occastional I2C failures
    [System.h, main.cpp]
2022-12-25 MSPApp: I2C.h: change interrupt strategy so we can wait for multiple events simultaneously, so that we can cleanly handle the case where we receive the STOP/RX interrupts out of order (because the ST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
2022-12-25 MSPApp/STMApp: debugging I2C comms
2022-12-25 MSPApp/STMApp: think I2C comms are working reliably
2022-12-25 MSPApp: I2C.h: Send() don't send FF after end of data
2022-12-25 Add Other/STM32F730/STM32F730-ReferenceManual-DMA.pdf
2022-12-25 STMApp: fix alignment of various things that need to be read/written via DMA
    [QSPI.h, SD.h, System.h, main.cpp]
2022-12-25 MDCStudio: getting grid view flipped-ness working
    [FixedScrollView.h]
2022-12-25 Trying to get ImageGridView sizing correctly in edge case where we're scrolled to the bottom
2022-12-25 MDCStudio: cleanup FixedScrollView method names
    [FixedScrollView.h]
2022-12-26 ImgSensor.h: fix Img::Sensor::Init() failure because we apparently need to sleep longer after toggling the reset line
    [ImgSensor.h]
2022-12-26 CFAViewer: tell device to enter host mode
2022-12-26 MSPApp: I2C.h: cleanup
2023-01-04 STMLoader: Fix I2C / USB enumeration (we didn't implement the interrupt functions for I2C peripherals, so it called the default interrupt handler, which broke everything)
    [main.cpp]
2023-01-04 STMApp: move I2C peripheral into System class
2023-01-04 STMApp: Switch to sending I2C messages via TaskMSPComms task instead of directly using I2C peripheral
2023-01-04 STMApp: EndpointsFlush -> Reset
    [QSPI.h, STM.h, System.h, main.cpp]
2023-01-04 STMApp: updating QSPI to follow I2C model
2023-01-04 STMApp: update BatteryStatusGet command
2023-01-04 STMApp: delete unused Shared/Battery.h
2023-01-04 STMApp: implement BatteryStatusGet
2023-01-04 STMApp: update battery status (instead of just charge status) every 10 seconds, and send the same STM::BatteryStatus struct to host via USB, instead of updating the struct during the USB request.
2023-01-05 STMLoader/STMApp: wait for current command to complete before accepting another command
2023-01-06 STMLoader/STMApp: correct _TaskMSPComms logic
    [System.h]
2023-01-06 STMApp/STMLoader: improve _TaskMSPComms logic so it can be reset
    [System.h, main.cpp]
2023-01-07 Debugging why BAT_CHRG_STAT has voltages 1.8 (drive 0) / 2.6 (undriven) / 3.3 (drive 1)
2023-01-07 STMApp: have _ChargeStatusGet() detect oscillations
    [System.h]
2023-01-07 STMLoader/STMApp: detect BAT_CHRG_STAT oscillating, which we take to mean that MCP73831T is in the shutdown state (ChargeStatus::Shutdown).
    For some reason BAT_CHRG_STAT oscillates on our Rev7 board, instead of remaining high-z, probably because VDD_BAT leakage current is too high for MCP73831T to remain in its shutdown state. But at least if it's oscillating, we can detect it and treat it the same way as if it were high-z.
    [GPIO.h, System.h, main.cpp]
2023-01-08 MSPApp: add missing break to switch
    [main.cpp]
2023-01-08 MSPApp: I2C: fix Active -> Inactive detection when unplugging USB cable
    [I2C.h, main.cpp]
2023-01-08 STMLoader: fix BAT_CHRG_STAT sensing
    We forgot to call __HAL_RCC_GPIOE_CLK_ENABLE() so reading the GPIO wasn't working.
    [GPIO.h, System.h]
2023-01-08 STMApp: implementing MSP comms mutex so SBW and I2C can have mutual exclusion
2023-01-08 Revert "STMApp: MSP mutex progress"
    This reverts commit 57ae412bd1e4ddda94e487bc489428d1853e1d36.
    [BoolLock.h, System.h, main.cpp]
2023-01-08 STMApp: fix MSP locking
    [BoolLock.h, System.h, main.cpp]
2023-01-09 STMApp/STMLoader: fix USB logic
    [System.h, USB.h]
2023-01-09 MDCUSBDevice.h: reset(): reset default control endpoint
    [MDCUSBDevice.h]
2023-01-09 STMApp: still working on reliable resetting of USB comms
    [MDCUSBDevice.h, System.h, USB.h]
2023-01-09 STMApp: think we have a good solution for reliable resetting of USB comms
    [MDCUSBDevice.h, System.h, USB.h]
2023-01-09 MDCUSBDevice.h: stop trying to reset default control endpoint, since regular vendor control requests seem to work to reset the control endpoint now.
    [MDCUSBDevice.h]
2023-01-10 MSPApp: switch to making host mode preemptive instead of cooperative
2023-01-10 Add Other/STM32F730/STM32F730-ReferenceManual-I2C.pdf
2023-01-10 STMApp: progress implementing I2C comms failure recovery
    [I2C.h, main.cpp]
2023-01-10 MSPApp: move cold-start handling to _MainTask so that I2C comms work during the delay period
2023-01-10 STMApp: get I2C comms failure-recovery working (by resetting MSP)
    [I2C.h, System.h]
2023-01-11 STMApp: for debugging, abort if we try to reset MSP, so we can tell that it happened
    [System.h]
2023-01-12 MSPApp: BatterySampler.h: progress
2023-01-12 MSPApp: BatterySampler progress
2023-01-12 STMApp/STMLoader: BoolLock.h: fix locking bug
    [BoolLock.h]
2023-01-12 MSPApp: BatterySampler might be working
2023-01-12 MSPApp: invert polarity of BatChrgLvlEn_ because we accidentally made U5 an inverter instead of a buffer. This comes at the cost of constant current draw through the R10 (100k) resistor. We should pr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
    [BatterySampler.h, main.cpp]
2023-01-12 STMApp/STMLoader: make I2C timeout a template parameter
2023-01-12 MSPApp: keep BatChrgLvlEn_ asserted for now because it causes BAT_CHRG_STAT to oscillate when in shutdown, so we can reliably detect the shutdown state
    [BatterySampler.h]
2023-01-12 STMApp: always sample battery for debugging
2023-01-12 MSPApp: battery sampling working decently
2023-01-14 MSPApp/STMApp: looks like battery charge level stuff is working. Conversion to a percentage seems to work.
2023-01-15 MSPApp: add button handling (for sensing presses and holds) with a new Button class, and ButtonTask
2023-02-03 Revert "MSPApp/Scheduler.h: Experiment allowing an argument to be passed to runnable function"
    This reverts commit e03654f06c2fdd16282ede0f506b9a57375d1e3e.
    [Button.h, I2C.h]
2023-02-06 Debugging battery status not oscillating
    [System.h]
2023-02-06 STM: revert changes while debugging why battery status oscillation interrupt wasn't working
    [System.h]
2023-02-07 MSPApp: fix stack layout (it was previously at the beginning of the stack region, so we were overwriting globals when main() executed)
    [main.cpp]
2023-02-07 STM: GPIO.h: set ODR before MODER, so that we don't intermittently drive the wrong value when switching a GPIO from input->output
    [GPIO.h]
2023-02-07 Revert "Debugging"
    This reverts commit 3c42d1e809ff744346a31e97bc48dd1d9613dce0.
    [System.h, main.cpp]
2023-02-08 MSPApp: ICE.h: fix ImgI2C() to only return when the I2C done bit is set, and not when the error bit set.
    The error bit remains set from the previous transaction until just
    before the done bit is set, so if we bail when we see the error
    bit, we may be bailing due to the error bit from the previous
    transaction.
    [ICE.h]
2023-02-08 MSPApp: ImgSensor.h: bump init delay from 11->15ms because we're seeing I2C NAKs with 11ms.
2023-02-08 MSPApp: implement off behavior of button
2023-02-09 MSPApp: working on getting power button working properly
2023-02-13 STMApp: fix _ICERAMWrite() by moving _QSPIConfigSet invocation after we release ICE_CRST_
    [main.cpp]
2023-02-16 STMApp: update SDCard T_ClkDelayFast because MDCStudio was causing SD Card CRC errors
    [main.cpp]
2023-02-23 MSPApp: RTC.h: Confirm that FreqHz is a power of two for cheap division in _TimeRead()
2023-02-23 Progress making time facilities rigorous wrt leap seconds, and preparing to define timestamp with millisecond resolution (instead of second resolution).
2023-02-24 MSPApp: RTC.h: track microseconds instead of seconds
2023-02-27 Add MSPTimeGet facility so we can determine the device's offset from the actual time, before updating the device's time
2023-02-27 MDCStudio: ImageLibrary: have events hold strong references to the images that they contain, so we can easily trampoline events between threads
2023-02-28 MDCStudio: inspector: move clear button to left margin
2023-02-28 Revert "MDCStudio: inspector: move clear button to left margin"
    This reverts commit 7b495f8480cb05e814a093d1be5cb2d09fc78c6b.
2023-03-02 STMApp: _TaskReadout: release chip select when we're done reading data, so that ICE properly exits readout mode
    This was trigging a bug where setting the coarse integration time was always failing, because it was occurring after image readout. Since readout was keeping chip-select asserted, the next ICE message sent after readout was always suppressed.
    [main.cpp]
2023-03-18 Implemented thumbnail compression to keep image libraries small (We now load images dynamically from the device if we need to re-render a thumbnail.)
    This is a combined commit from scratch/Rev7/BC7ImageCompression-Combined
2023-04-05 Implemented start of DeviceSettings UI
    This is a combined commit from scratch/Rev7/DeviceSettings-1.2-Combined
2023-04-17 Implemented MSPApp side of device settings
    This is a combined commit from scratch/Rev7/DeviceSettingsMSPImpl-Combined
2023-04-18 MSPApp: formalize full SD card init logic
    This is to make sure the stored SD card id matches the _State.sd SD card ID, and therefore our _State.sd struct is valid for the current SD card
    This is a combined commit from scratch/Rev7/MSPAppResetSDEveryStart-Combined
2023-04-18 MSPApp: fix I2C MSPStateRead/Write commands
    [main.cpp]
2023-04-18 MSPApp: maintain user-facing power state across aborts
    This is a combined commit from scratch/Rev7/MSPApp-RestorePowerStateAfterAbort-Combined
2023-05-02 MSPApp: - implemented Timer.h to handle tracking time over long periods - track time in terms of ticks, instead of us/ms, to make math simpler and save code space - bring back traditional watchdog ti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
    This is a combined commit from scratch/Rev7/WakeAlarm-SwitchToTicks-Test-ResetHistory-SchedulerDeadlineUpd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
    [AssertionCounter.h, BatterySampler.h, Button.h, Clock.h, DeviceSettings.h, GPIO.h, I2C.h, ICE.h]
2023-05-03 Implemented workaround for errata CS13.
    Also implemented mitigation for voltage/temperature changes that might occur during long sleep periods that could otherwise cause the DCO to wake up and overshoot the maximum MCLK frequency.
    This is a combined commit from scratch/MSP430-CS13-Repro-Combined.
    [Clock.h, InterruptVector.cpp, main.cpp]
2023-05-05 MSPApp: implemented debug printing facilities
    This is a combined commit from scratch/PrintDebugImpl-Combined.
2023-05-05 MSPApp: Improve printing facility
2023-05-05 STMApp: debugging why I2C freezes
2023-05-08 Implemented MSP time calibration to correct for crystal frequency inaccuracy
    This is a combined commit from scratch/MSPTimeCalibration-Combined.
    [MDCUSBDevice.h, MSP.h, RTC.h, STM.h, Timer.h, main.cpp]
2023-05-08 MSPApp: remove errata CS13 workaround since, in our testing, it only applies when VDD < 2.1V
    [Clock.h]
2023-05-08 MSPApp.h: fix bug where we weren't properly waiting for an FLL lock
    [Clock.h]
2023-05-09 MSPApp: fix I2C bug
    This is a combined commit from scratch/I2CFailureDebug.
    [Debug.h, I2C.h, MDCUSBDevice.h, STM.h, System.h, main.cpp]
2023-05-09 STMApp: I2C.h: issue START+STOP condition upon reset, to reset MSP430 state machine
    [I2C.h]
2023-05-10 Turn on device when it's plugged in
    Clean up _TaskMotion. Make it similar to _TaskSD and _TaskImg, where we kill the task when it's not needed.
    Clean up and formalize assertion logic.
    This is a combined commit from scratch/TurnOnWhenPluggedIn
2023-05-22 Implement battery level sampling
    This is a combined commit from scratch/BatterySamplerUpdates
2023-05-22 MSPApp: BatterySampler.h: fix millivolts calculation
    [BatterySampler.h]
2023-07-12 FixedMetalDocumentLayer / FixedScrollView updates for Soldermask
    [FixedMetalDocumentLayer.h]
2023-07-12 FixedScrollView: adding -fixedInteractionUnderway: facility
    [FixedScrollView.h]
2023-08-04 FixedMetalDocumentLayer: add -fixedTranslation and -fixedMagnification methods
    [FixedMetalDocumentLayer.h]
2023-08-24 Updates for rev10 board:
    - MSPApp:
    BatChrgLvlEn_ -> BatChrgLvlEn
    - STMApp:
    Update BAT_CHRG_EN_ / BAT_CHRG_STAT pin numbers
    Update LED pins
2023-08-24 Update LED width (4 -> 2); optimize:
    ICEApp.SDController.clk_slow 199.60
    ICEApp.spi_clk_$glb_clk 90.30
    ice_img_clk16mhz$SB_IO_IN 117.04
    img_dclk$SB_IO_IN_$glb_clk 138.16 *
    ram_clk$SB_IO_OUT_$glb_clk 129.28 *
    * ICEAppSDReadoutSTM
    -----------------------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
2023-08-30 LED progress
2023-09-11 Get MDCStudio compiling again after updating MSP.h led flash struct member
2023-09-11 MDCUtil: get compiling again after updating MSP.h led flash struct member
2023-09-11 Implement LED flashing
2023-09-12 Motion.h: implement nasty hack to fix brownout caused by turning on motion sensor
    [Motion.h]
2023-09-12 Motion sensor working again. Would like to get interrupt-disabling-logic working again though, that occurs when ISR triggers
2023-09-13 Preparing to implement LED flickering again
2023-09-13 MSPApp: Think LED flickering works again
2023-09-13 MSPApp: think we fixed LED glitch that sometimes occurs when fading led on/off
    [LED.h, main.cpp]
2023-09-13 Remove _TaskLED::PriorityCapture since it's no longer used
    [main.cpp]
2023-09-14 MSPApp: LED.h: check _State instead of 'x' argument
2023-09-14 Add debounce for motion sensor disabling, so we can avoid paying the 30s penality for momentary motion-sensor-state glitches (ie 1->0->1)
    [Debug.h, main.cpp]
2023-09-15 MSPApp: restructuring motion powering/enabling
2023-09-16 Working on accounting for motion sensor power on time
2023-09-16 Revert "Working on accounting for motion sensor power on time"
    This reverts commit 813b9376b984165741abe47974ea557a0f9e4ce8.
    [DeviceSettings.h]
2023-09-16 Revert "Working on accounting for motion sensor power on time"
    This reverts commit 12b5b34964784c10e09a13c52a1de49e08988442.
    [DeviceSettings.h]
2023-09-16 Revert "Working on accounting for motion sensor power on time"
    This reverts commit a1a49b332604df0123630d2eaacdb386b625b7f6.
    [DeviceSettings.h, MSP.h, Motion.h, Triggers.h, main.cpp]
2023-09-17 Working on accounting for motion sensor power-on time
2023-09-17 MSPApp: think we're finished accounting for motion sensor power-on time
2023-09-17 MDCStudio: enable LED flashing by default
2023-09-17 MSPApp: trying to get motion sensor to turn off when temporarily suppressing motion signal, or when the max trigger count is reached, to save battery life
2023-09-18 MSPApp: hopefully finished implementing solution to have motion sensor actually powered off when it's not needed
2023-09-18 MSPApp: progress implementing motion sensor power off when it's not needed
2023-09-19 Move battery millivolts -> linearized value conversion out of MSPApp. MSPApp outputs millivolts now.
2023-09-23 MSPApp: add ChargeStatusGet/ChargeStatusSet commands
2023-09-23 MSPApp: ChargeStatusGet -> BatteryStatusGet
2023-09-23 STMApp/MSPApp: battery status updates
2023-09-23 STMApp/MDCStudio: Battery status updates
2023-09-23 MDCStudio: fix printed battery level message
    [MDCDevice.h, main.cpp]
2023-09-23 STMApp: wait 10s (instead of 5s) before updating charge status
2023-09-23 MDCStudio: SourceListView: prevent battery charge indicator from moving when changing icon
2023-09-23 MDCStudio: update battery icons
2023-09-23 STMApp: MSPHostModeSet -> HostModeSet; stop updating LED while in host mode
2023-09-25 Charge status logic changes so MDCStudio representation and device LED are sync'd
2023-09-25 MSPApp: add host mode LED flicker mode. MSPApp is now too large to fit, need to trim somehow...
    [LED.h, main.cpp]
2023-09-25 MDCStudio: revamp device locking / host mode. Add 'SD mode'
2023-10-03 STMApp: disable battery charging when battery charging is underway and we need to sample the battery
2023-10-03 MDCStudio: MDCDevice.h: fix device lock / host mode / sd mode locking logic
    [MDCDevice.h, main.cpp]
2023-10-03 MDCStudio: show battery level in inspector
2023-10-03 MSPApp: fix writing battery level into header of images
    [main.cpp]
2023-10-04 MSPApp: Debug.h: fix Empty() to ensure the final packet is read
    [Debug.h]
2023-10-04 MSPApp: fix crashes when enabling/disabling host mode, due to race conditions
    There were 2 problems:
    1. The image sensor I2C bus appears to (occasionally) start up in the wrong state, so we issue a dummy I2C transaction so that a START/STOP condition is issued, so that the image sensor I2C state machine returns to its idle state.
    2. The _VDDIMGSDEnabledChanged() function can be called from multiple threads, so we added synchronization to ensure that multiple invocations execute serially. Otherwise the invocations would clobber each other.
    [ICE.h, ImgSensor.h, main.cpp]
2023-10-04 MSPApp: re-enable BatterySampler.h
2023-10-04 SDCard.h: add timeouts so that failures don't brick the device indefinitely
    [SDCard.h]
2023-10-04 MSPApp: revamp VDDIMGSD / VDDB logic so that it works correctly with enabling/disabling host mode
    [main.cpp]
2023-10-04 MSPApp: remove debug printing
2023-10-05 STMApp: remove battery status pausing now that host mode causes the LED to flash
2023-10-05 MDCStudio: prepping to implement battery life status in device configuration view
2023-10-05 MDCStudio: Add SourceList-Battery-Charging-0.pdf
2023-10-06 MDCStudio: DeviceSettings.h: cleanup
2023-10-06 MDCStudio: working on battery life estimation
2023-10-06 MDCStudio: initial battery life estimation working
2023-10-06 MDCStudio: Add battery life button. Reorganize image assets.
2023-10-06 MDCStudio: battery life button updates
2023-10-07 MDCStudio: battery life estimation progress
2023-10-09 MDCStudio: battery life plot drawing progress
2023-10-10 MDCStudio: revert old debugging changes
    [MDCDevice.h]
2023-10-11 MDCStudio: implement min/max battery life clamping in BatteryLifeSimulator
2023-10-11 MDCStudio: Implement device subtitle text ('7 days of images')
2023-10-11 MDCStudio: working on full-size image view back button
2023-10-11 MDCStudio: back button working. Need to make a little more attractive?
2023-10-11 MDCStudio: fix battery life plot glitch where labels could overlap
2023-10-11 MDCStudio: battery life plot fixes
    [BatteryLifeSimulator.h]
2023-10-14 MDCDevice.h: only join threads that are joinable
2023-10-14 MDCStudio: working on 'no devices' view
2023-10-16 MDCStudio: working on getting devices to exit host mode when exiting MDCStudio
2023-10-16 MDCStudio: Exit device host mode when MDCStudio quits
2023-10-17 MDCStudio: FixedScrollView: add support for content insets so that headers don't obscure content
    [FixedScrollView.h]
2023-10-21 MDCStudio: factory reset implementation progress
    [ImageLibrary.h, MDCDevice.h, RecordStore.h]
2023-10-22 MDCStudio: fix memory leaks so that MDCDevice gets destroyed when unplugging device
    [MDCDevice.h]
2023-10-22 MDCStudio: fix crash when unplugging device
    [MDCDevice.h]
2023-10-22 MDCStudio: MDCDevice: fix stutter due to performing device IO while holding status lock
    [MDCDevice.h]
2023-10-23 MDCStudio:
    - RecordStore: add mechanism to tell whether a RecordRef is part of an alive chunk.
    - MDCDevice: have sync thread skip records that are no longer alive. This will cause syncing to bail quickly after a factory reset.
    [MDCDevice.h, RecordStore.h]
2023-10-24 MDCStudio: MDCDevice.h: working on teardown fixes
    [Cache.h, MDCDevice.h]
2023-10-25 MDCStudio: working on not allowing selecting placeholders by filtering images in ImageSource::selection() setter
2023-10-25 MDCStudio: Object.h: switch back to only having ObjectProperty macro. Reference-based properties can write their own accessors.
2023-10-25 MDCStudio: ImageLibrary: track imageIdEnd independently from the last image added, since the last image can be deleted.
2023-10-26 MDCStudio: ImageLibraryStatus: handle case where timestamp isn't absolute (ie if the device lost battery power)
2023-10-29 MDCStudio: move device init into MDCDevice
2023-10-29 MSPApp: add StackOverflow reset type so we can figure out which task needs a larger stack
    [MSP.h, System.h, main.cpp]
2023-10-29 MDCStudio: clamp image capture count to u16 range
2023-10-30 MDCStudio: MDCDevice.h: remove stale images as a part of the status thread, so that we can't view stale full-size images
2023-12-07 STMApp/STMLoader: update vid/pid/manufacturer to 0 / 0 / Toaster LLC
2023-12-07 Add STM32F730-ReferenceManual-Flash.pdf
2023-12-07 Add STMFlashWrite command so we can flash STMLoader binary onto STM32 without using debug probe
2023-12-07 MDCUtil: add STMRAMWriteLegacy command that works with STMLoader binaries that are flashed on existing devices
2023-12-09 Add: Code/ICE40/ICEAppSDReadoutSTM/Synth/Top.bin Code/STM32/STApp/Release/STApp.elf
2023-12-09 MDCStudio: sorta working on ARM Mac, lots of bugs though
2023-12-16 Fix USB comms with Apple silicon (ARM) hosts
2023-12-16 Move Code/STM32/{STLoader/STApp}/ST into Code/STM32/Shared/ST
2023-12-17 MDCStudio: ARM fix: fix progress bar height
2023-12-18 MDCUtil: SDRead: print throughput
2023-12-18 USB_HS_PHYC_TUNE_VALUE = 0x0030E049
    Using this value with an ARM Mac as the host, we observed no USB comms errors for 510m, as observed by protocol analyzer. Bad values fail between 0m-20m, so this one is significantly better.
2023-12-22 USB_HS_PHYC_TUNE_VALUE = 0x0000E043
    Host = ARM Mac
    Left port: ST-USB-Issue-Repro: no failures for 11.5 hours
    Right port: ST-USB-Issue-Repro: no failures for 18 hours
2023-12-24 DebayerLMMSE.h: synchronization fixes to address issues apparent on ARM
2023-12-24 MDCStudio: cleanup / fix (on ARM) thumbnail compression
    [MDCDevice.h]
2023-12-25 STMLoader/STMApp: attempt to fix USB sleep/resume bug
    [USB.h]
2023-12-28 MDCStudio: fix: when left sidebar is closed, 'XXX photos selected' text is too close to window titlebar buttons
2023-12-28 MDCStudio: Bug: entering too-large value into battery life estimator causes crash
2023-12-28 MDCStudio: DeviceSettings: adjust spacing
2023-12-29 MDCStudio: SourceListView: set content insets to prevent window buttons from obscuring scroll view
    [MDCDevice.h]
2023-12-29 MDCStudio: Default name of MDC devices should be 'Photon'
2023-12-29 Implement printing support
2023-12-29 Update print menu item default key combo
2023-12-29 MDCStudio: add print menu item to contextual menu
2023-12-30 MDCStudio: StringForTimeInstant: fix formatting
    [TimeString.h]
2023-12-30 MDCStudio: update battery charging icons to have a 100%-charged-but-still-charging icon
2023-12-31 MDCStudio: fix: crash when drawing relative timestamps
    [Calendar.h]
2023-12-31 MDCStudio: update size of white balance color button
2024-01-02 STMLoader/STMApp: acquire MSPLock when resetting, to prevent resetting during an I2C transaction
    [System.h, main.cpp]
2024-01-23 MDCStudio: fix key equivalent for Print menu item
2024-01-23 MDCStudio: fix teardown bug
    [Cache.h, ImageSource.h]
2024-01-29 Fix entitlements to allow printing/image export
2024-02-10 Calendar.h: _DateFormatterStateCreate(): for 'timestampFormatter', replace Unicode whitespace with regular ASCII spaces
    [Calendar.h]
2024-02-13 CFAViewer: handle STMApp loading so that CFAViewer works immediately when plugging in a device
2024-02-14 MDCDeviceReal.h: _hostModeSet(): fix locking order
    [MDCDeviceReal.h]
2024-02-22 MDCStudio: Renderer.h: fix warning
    [Renderer.h]
2024-02-23 MDCStudio: bug fix: fix hang that occasionally happens when spawning/killing MDCStudio in a loop
    [MDCDeviceReal.h]
2024-03-09 MDCUtil: print dstEvents
2024-03-09 Switch back to:
    USB_HS_PHYC_TUNE_VALUE = 0x0000E043
2024-03-10 MDCStudio:
    - Handle device's excessive time drift by resetting its time
    - TimeAdjustment.h: cleanup
    [Clock.h, MDCUSBDevice.h, MSP.h, TimeAdjustment.h, TimeConstants.h, TimeString.h]
2024-03-15 MSPApp: fix DST bug
    The problem was that we scheduled _EventTimer for EventN+1 immediately after
    popping EventN. But EventN can change the time that EventN+1 should be handled
    (which is the case for DSTEvents), so we need to schedule _EventTimer for
    EventN+1 only after handling EventN.
    [Timer.h, main.cpp]
2024-03-15 Update Code/STM32/STApp/Release/STApp.elf / Code/STM32/STLoader/Release/STLoader.elf
2024-03-24 MDCStudio: Document.mm: re-enable -_setActiveImageSource: short-circuiting for efficiency
2024-03-26 ImageGridLayer.metal: use txt.sample() instead of txt.read()
2024-05-16 Stop printing EstimateIlluminant duration
2024-06-14 MDCStudio: fix buffer overflow caused by using incorrect length (Img::Full::ImageLen -> Img::Full::PixelLen)
    Thanks to Mike E. for reporting this issue!
    [ImageSource.h]
2024-06-27 STM32 Linux compilation with clean makefile
2024-06-27 STM.h: add padding + packed attribure to silence warning, and maintain compatibility with shipped devices
2024-06-27 STM32/Makefile.mk: remove --specs=nosys.specs
2024-06-27 STM32: silence linker warning
2024-06-27 Update Tools/gcc-stm32
2024-06-27 {STLoader,STApp} -> {STMLoader,STMApp}
    [STApp.cfg]
2024-06-27 STMLoader/STMApp: get Xcode projects working with makefile
    [STMApp.cfg]
2024-08-09 - Improve auto-exposure algorithm to avoid highly over-exposed images - Increase CoarseIntTimeMax to improve low-light photos: 16383 -> 65535 - ICE.h: ImgCapture(): increase timeout, since integratio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
    [ICE.h, Img.h, ImgAutoExposure.h]
2024-08-09 ImgAutoExposure.h: prevent integer overflow that caused exposure bouncing in low-light
    [ICE.h, ImgAutoExposure.h]
2024-08-09 MDCStudio: include battery level (exif tag 'BatteryLevel' / 33423) in DNG-exported photos
2024-08-09 MSP.h: BatteryLevelFloat(): fix return value to be in the range [0,1] (instead of [0,100]
    [MSP.h]
2024-08-09 MDCStudio: fix battery level stuff
2024-08-09 MDCStudio: implementing mouse-over battery percentage
2024-08-09 MDCStudio: MDCDeviceDemo.h: switch back to battery level = 75%
2024-09-10 MSPApp: revert CoarseIntTimeMax 65535 -> 16383, since it significantly affects battery life
    [Img.h]
2024-11-08 Fix crash on x86_64 iMac16,2 (macOS 12.7.6) due to FFCC-Metal, because it doesn't like a target-less fragment shader (?)
    Also delete defringe components since they're no longer used.
    [ImagePipelineUtil.h, ImageSource.h]
2024-11-10 MDCStudio: RecordStore.h: add null check to ChunkRef::operator<
    This potentially fixes a null-dereference crash, but we haven't root-caused why we have a ChunkRef with .chunk == null
    [RecordStore.h]
2024-11-13 Fix undefined behavior throughout project due to unaligned accesses
    This is a combined commit from scratch/Fix-Undefined-Behavior
    [BatteryLifeSimulator.h, MSPTriggers.h, Timer.h, main.cpp]
2024-11-17 MDCStudio: BatteryLifeSimulator: enforce minimum time between simulated image captures to prevent vertical asymptotes in the battery life plots (when capturing lots of images as a result of a trigger)
    [BatteryLifeSimulator.h, Clock.h]
2025-01-20 MDCStudio: when switching from auto white-balance to manual white-balance, default to the estimated illuminant color by default
2025-01-21 MDCStudio: CaptureTriggersView: show errors when adding/removing/modifying triggers, instead of crashing TokenField: allow content to be copied/pasted TokenField: allow tokenization of multiple dates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
    [Calendar.h]
2025-01-23 MDCDownload: print time remaining
2025-02-02 MDCStudio: fix crashes caused by Photon disappearing while in the process of exporting / printing / loading photos
    [ImageSource.h]
2025-02-02 MDCStudio: fix crash when printing tons of images, caused by lack of autorelease pool
2025-02-03 MDCStudio: fix warning: Implicit capture of 'this' with a capture default of '=' is deprecated
    [ImageSource.h, MDCDeviceHard.h]
2025-02-03 MDCStudio: MDCDeviceHard: fix _status_thread uncaught bad_weak_ptr exception during teardown
    [MDCDeviceHard.h, MDCDevicesManager.h]
2025-03-01 Add Tools/STM32_Programmer_CLI
2025-03-03 STMApp: make USB speed and PHY tune value dynamically configurable STMLoader: enumerate in USB full-speed mode
    The STMApp changes are so MDCStudio can decide the PHY tune value at runtime, depending on how Photon is connected to the Mac:
    Connection, direct to ARM Mac -> .phyTune = 0xE043
    Connection, direct to Intel Mac -> .phyTune = 0xF17
    Connection, via hub -> .phyTune = 0xF17
    The STMLoader changes are so the device always enumerates in a reliable configuration (USB full-speed, .phyTune = 0xF17). At least, so far we've never observed any failures with this configuration.
    This is a combined commit from scratch/Dynamic-USB-Config
    [ELF32Binary.h, MDCDeviceHard.h, MDCUSBDevice.h, STM.h, USB.h, USBConfig.h, main.cpp]
2025-03-04 MSPDebug.h: add _SDCardProductName so we can properly print the SD product name, even if the cardId.productName is uninitialized and has zeroes
2025-05-07 Handle kIOReturnExclusiveAccess by waiting a bit and trying again
    This is necessary for some apps (eg Google Chrome) that open USB devices for exclusive access before releasing them after they decide they don't care about the device.
2025-05-07 Move USB claim retry into USBDevice::claim() (instead of MDCDeviceHard), since during the init process, the device will enumerate twice -- before and after STMRAMWrite. In both cases, we need to wait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
    Update MSPApp.elf / STMLoader.elf / STMApp.elf
2025-05-07 MDCStudio: MDCDeviceHard.h: diagnosticData(): deviceLock(true) to pause an in-progress read, if needed
2026-02-20 MDCUtil: get crash dwarfdump symbolication working again
    [main.cpp]
2026-02-21 Code/MSP430: for debugging, add a new 'Debug' reset variant, so we can log a small piece of info when something of interest occurs
    [MSP.h, MSPDebug.h, main.cpp]
2026-02-28 Code/MSP430/MSPApp/LED.h: add comments
2026-03-20 WIP: MSPApp: bug fix: SD CMD0 timeout
    [main.cpp]
2026-10-08 STM32: enable battery charging regardless of whether a battery is detected
